Fjmoya-uba/Taller-de-Circuitos-Grupo-4/Checkpoint 3/Informe/Checkpoint3_Grupo5.pdf

Universidad de Buenos Aires

Facultad de Ingeniería
Año 2026 – 1.er Cuatrimestre

## Taller de Diseño de

## Circuitos Electrónicos

## Proyecto Integrador – Checkpoint 3

### Grupo 5

Lautaro García Vitale | 110028 lagarciav@fi.uba.ar
Santiago Manuel Cabrera | 110445 smcabrera@fi.uba.ar
Francisco Javier Moya | 109899 fjmoya@fi.uba.ar

Tutor: Federico Gabriel D’Angiolo.

Docentes: Julio Guillermo Zola, Marcelo Adrián Bruno, Sergio Quinteros y Juan Guido Salaya.

Resumen

El presente informe documenta el tercer checkpoint del proyecto integrador, correspondiente a la implementación física y validación experimental de una fuente lineal LDO de 5 V desarrollada para aplicaciones industriales y automotrices. En esta etapa se aborda la transición desde el diseño teórico y la simulación hacia un prototipo funcional montado sobre PCB.
En primer lugar, se describe el proceso de fabricación, armado y soldado de la placa, detallando la incorporación progresiva de los bloques de regulación de tensión y de corriente, así como las principales contingencias surgidas durante el montaje. Se analizan además diversas limitaciones asociadas al layout, al retrabajo manual y a la selección de componentes, las cuales condicionaron la puesta a punto inicial del circuito.
Posteriormente, se presentan las mediciones realizadas para caracterizar el comportamiento del regulador en condiciones reales de operación. Se estudian la regulación de línea, la regulación de carga en régimen estático y dinámico, la eficiencia, la corriente límite, la protección foldback y la respuesta temporal y espectral del lazo de tensión. Los resultados obtenidos muestran que el prototipo mantiene adecuadamente la tensión de salida, responde de manera estable frente a perturbaciones y reproduce en forma consistente los mecanismos de protección previstos en el diseño. Finalmente, se comparan los resultados experimentales con las predicciones obtenidas en etapas previas, identificando diferencias atribuibles a no idealidades de los componentes, efectos parásitos del montaje y restricciones dinámicas de la implementación física. En conjunto, el trabajo permite validar el desempeño global del regulador y extraer conclusiones útiles para futuras iteraciones de diseño y fabricación.

Proyecto Integrador – Checkpoint 3 | Grupo 5

## Índice

1. Introducción | 3
2. Armado del PCB | 3
3. Rediseño del lazo de corriente | 6
4. Mediciones | 7
5. Resumen de resultados | 15
6. Conclusiones | 15
7. Referencias | 16

## 1. Introducción

El desarrollo de una fuente de alimentación lineal para aplicaciones industriales y automotrices no finaliza con el diseño esquemático ni con la simulación del circuito. Una etapa fundamental del proceso consiste en implementar físicamente el sistema, verificar su correcto armado y caracterizar experimentalmente su comportamiento bajo distintas condiciones de operación.

En los checkpoints anteriores se definió la topología del regulador LDO, compuesta por un lazo de regulación de tensión, una etapa de potencia y un mecanismo de limitación de corriente con protección tipo foldback. Además, se analizaron aspectos asociados a la estabilidad del sistema, la compensación en frecuencia, la disipación térmica y el diseño del circuito impreso. Sobre esa base, en esta etapa se avanzó con el armado y soldado de la placa, obteniendo un prototipo físico apto para su ensayo en laboratorio.

El objetivo principal de este tercer checkpoint es validar experimentalmente el funcionamiento del regulador. Para ello, se realizaron mediciones de regulación de carga, tanto en régimen estático como dinámico, regulación de línea, limitación de corriente y eficiencia, entre otras. Estas pruebas permiten evaluar si la tensión de salida se mantiene dentro de los márgenes esperados frente a variaciones de carga y alimentación, y si el circuito de protección actúa correctamente ante condiciones de sobrecorriente.

La regulación de carga estática permite analizar la variación de la tensión de salida una vez alcanzado el régimen permanente para distintos valores de corriente demandada por la carga. En cambio, la regulación de carga dinámica estudia la respuesta transitoria de la fuente ante cambios bruscos de corriente, lo que resulta especialmente relevante en sistemas reales donde la carga puede variar rápidamente. Esta medición permite observar caídas instantáneas, sobrepicos, tiempos de recuperación y posibles oscilaciones.

A partir de los resultados obtenidos, se busca contrastar el comportamiento real del prototipo con el previsto durante el diseño. Las diferencias observadas pueden atribuirse a tolerancias de componentes, resistencias de pistas y contactos, efectos térmicos, capacidad de los elementos de salida y limitaciones del lazo de control. Por lo tanto, esta etapa no solo cumple una función de verificación, sino también de aprendizaje sobre la relación entre el diseño teórico y su implementación física.

## 2. Armado del PCB

Tras la validación del diseño en el checkpoint anterior, se procedió a la fabricación del PCB y al montaje de los componentes. El proceso se realizó de forma incremental para garantizar la trazabilidad de posibles fallas, aunque fueron surgiendo diversos problemas en el proceso de armado de la placa.

El montaje se estructuró en las siguientes etapas:

Soldado del par diferencial, del TL431 como referencia de tensión y del lazo de control de tensión.

Soldado del lazo de control de corriente.

### 2.1. Lazo de Tensión

Se soldaron inicialmente los componentes asociados al par diferencial, la referencia TL431 y la etapa de potencia. Se soldaron inicialmente los componentes asociados al par diferencial, la referencia TL431 y la etapa de potencia (ver Figura 1). Tras la energización del circuito, se comprobó el correcto funcionamiento del lazo de regulación de tensión, verificándose una regulación estable de la salida alrededor de 5 V. Esto permitió corroborar experimentalmente las predicciones obtenidas durante el diseño y las simulaciones, validando el comportamiento del lazo de control y de la etapa de potencia en la implementación física.


Figura 1: Soldado correspondiente al lazo de tensión durante el proceso de montaje del PCB.

### 2.2. Lazo de Corriente

Una vez verificado el correcto funcionamiento del lazo de regulación de tensión, se integró el amplificador operacional LM358 junto con la red de sensado correspondiente a la protección foldback. Durante esta etapa se realizaron verificaciones funcionales sobre el lazo de corriente y el comportamiento general del sistema ante distintas condiciones de carga. En la Figura 2 se observa el resultado de la placa con todos los componentes soldados.


Figura 2: Soldado correspondiente al lazo de corriente durante el proceso de montaje del PCB.

### 2.3. Contingencias de montaje

Durante la implementación física, se identificaron inconvenientes de montaje y de layout que condicionaron el proceso de armado y la depuración inicial del prototipo:

Subdimensionamiento de pistas: El ancho de varias pistas de señal resultó demasiado pequeño para un prototipo sometido a múltiples instancias de soldado y retrabajo manual. Esto redujo la superficie efectiva de cobre disponible, dificultó las tareas de montaje y aumentó la fragilidad mecánica de distintos nodos del circuito.

Desprendimiento de pads y deterioro del cobre: La manipulación reiterada de la placa durante el proceso de depuración provocó el levantamiento de varias pistas y pads, particularmente en zonas sometidas a retrabajo térmico frecuente. En algunos casos, ciertos terminales quedaron prácticamente sin superficie de cobre utilizable, dificultando significativamente la restauración de conexiones confiables. Para recuperar la continuidad eléctrica, fue necesario implementar puentes mediante conductores externos soldados directamente a los terminales de los componentes.

Falsos contactos durante la depuración: La presencia de pistas debilitadas y conexiones mecánicamente inestables generó comportamientos erráticos durante las primeras pruebas del sistema. Si bien se realizaron verificaciones sistemáticas de continuidad, la reducida dimensión de algunas pistas dificultó la detección inmediata de falsos contactos y conexiones intermitentes.

Estas dificultades evidenciaron que, para futuras iteraciones del PCB, resulta conveniente adoptar criterios de diseño más conservadores, incrementando el ancho de pista y el tamaño de los pads para mejorar la robustez mecánica del montaje y facilitar las tareas de validación experimental y depuración.

## 3. Rediseño del lazo de corriente

Las primeras mediciones experimentales mostraron que el lazo de corriente interfería con el funcionamiento normal del regulador incluso en condiciones donde la protección foldback debía permanecer inactiva. En particular, se observó que la tensión de salida no lograba regular en el valor esperado, aun cuando el lazo de tensión operaba correctamente de manera aislada.

A partir de estas observaciones, se decidió analizar el problema en una sección específica, ya que el comportamiento detectado no se debía únicamente a inconvenientes de montaje, sino también a limitaciones asociadas al diseño implementado para el lazo de corriente y a su interacción con la etapa de potencia.

### 3.1. Problema detectado experimentalmente

Durante los primeros ensayos se observó que el lazo de corriente interfería con el funcionamiento normal del regulador, aun en condiciones donde la protección foldback debía permanecer inactiva. En particular, la tensión de salida quedaba limitada a aproximadamente 2.4 V. Luego de varios experimentos, se detectó que la salida del amplificador operacional que activa el lazo de corriente era de 650 mV a pesar de que no hubiera carga, con lo cual el transistor de drenaje retiraba corriente de la base del quasidarlington.

Repasando la hoja de datos del integrado se econtró la siguiente tabla.

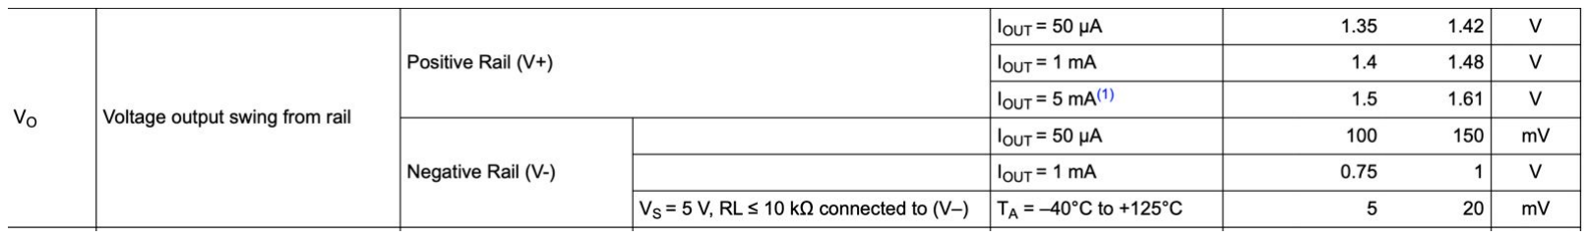
[picture p55: figure]

Figura 3: Especificaciones de la salida del operacional

En la misma, puede leerse que para una corriente de salida de 1 mA la mínima tensión de salida posible es entre 0.75 V y 1 V mayor a la tensión del riel negativo. En este circuito, el riel negativo es 0 V, por lo que este dato explica por qué el operacional polarizaba al transistor de drenaje de forma incorrecta. De esta forma, el error en el diseño original fue no incluir resistores entre la salida del amplificador y la base del TBJ que limitaran la corriente de salida del primero.

Por último, se simuló la etapa del operacional aislada del resto del circuito, y se encontró que la salida del mismo rondaba los 4 V. De esta forma, es el TBJ el que fuerza a que la salida sea de 0.65 V, lo que supone una demanda demasiado grande para el operacional.

### 3.2. Modificación implementada

Con el objetivo de estabilizar el estado de corte del transistor y reducir la carga impuesta sobre la salida del LM358, se incorporó una resistencia de 1 kΩ entre la base del transistor de foldback y masa. Este resistor actúa como un resistor de pull-down, disminuyendo la tensión del nodo y dándole a la corriente un camino adicional para llegar a masa.

Cabe mencionar que en el futuro se incluirá también un resistor de 3.9 kΩ para formar un divisor resistivo con el resistor ya mencionado y permitir así que la tensión de salida del operacional no sea forzada a 0.65 V. Sin embargo, en las mediciones hechas en este informe no se la pudo incluir por falta de tiempo.

### 3.3. Validación posterior al cambio

Una vez incorporada la modificación, se repitieron las mediciones relevantes para verificar el comportamiento del lazo de corriente bajo distintas condiciones de carga. A diferencia de las primeras pruebas, el circuito pasó a exhibir una respuesta consistente con la prevista durante el diseño, observándose un funcionamiento estable tanto del lazo de tensión como de la protección foldback.

La incorporación de la resistencia de pull-down permitió evitar activaciones espurias del transistor asociado al lazo de corriente y redujo la carga impuesta sobre la salida del LM358. De esta manera, la validación experimental posterior confirmó que el comportamiento anómalo observado inicialmente estaba asociado principalmente al criterio de conexión adoptado en el diseño original y no únicamente a problemas de montaje.

## 4. Mediciones

En esta sección se detallan las mediciones efectuadas. En las Figuras 4 y 5 se muestran los bancos de trabajo utilizados para realizar los ensayos experimentales.

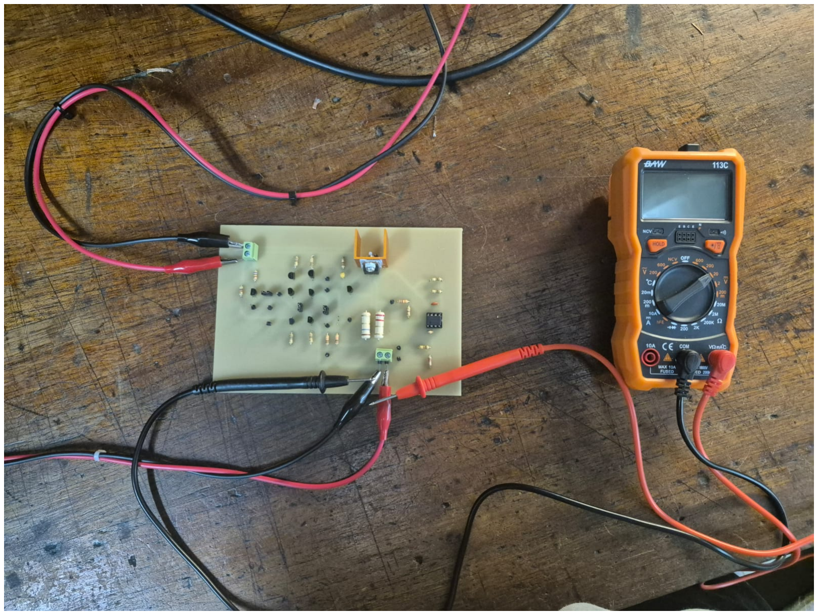
[picture p56: figure]

Figura 4: Primer banco de medición utilizado durante la validación experimental del regulador.


Figura 5: Segundo banco de medición utilizado durante la validación experimental del regulador con carga electrónica.

### 4.1. Eficiencia

Para una tensión de entrada de 9,5 V, una corriente de entrada de 182 mA, una tensión de salida de 5,01 V y una corriente de salida de 167 mA, dada por una carga estática de 30 Ω, se registró una eficiencia del 48,39 %. Este cálculo se hizo teniendo en cuenta las potencias de entrada y salida, como se muestra a continuación.

η =

Po
Pi

=

VoIo
ViIi

= 48, 39 %

De este modo, se puede observar que la eficiencia conseguida depende de la corriente de salida (a tensión de salida constante) y de la tensión de entrada. En las Figuras 6 y 7 se muestra la eficiencia en función de la tensión de entrada a una corriente de salida constante de 1 A y en función de la corriente de salida a una tensión de entrada constante de 9,5 V, respectivamente.


Figura 6: Eficiencia del circuito en función de la tensión de entrada para una corriente de salida de 1 A.


Figura 7: Eficiencia del circuito en función de la corriente de salida para una tensión de entrada de 9,5 V.

### 4.2. Regulación de línea

La regulación de línea se obtuvo midiendo con una carga estática de 50 Ω que fija una corriente de salida de 100 mA y variando la tensión regulada que ingresa al LDO. El resultado fue 11,86 mV/V: un 41,02 % mayor que el valor teórico —probablemente atribuido a la escasez de mediciones—. La curva resultante de la medición se muestra en la Figura 8.


Figura 8: Regulación de línea medida y simulada.

Nótese que V

min
REG
Vo=5 V

= 6 V, por lo que se obtiene una tensión de dropout de

Vdrop = V

min
REG
Vo=5 V

− Vo = 1 V,

valor que coincide exactamente con el teórico.

### 4.3. Regulación de carga

En esta sección se detallan las mediciones correspondientes a la regulación de carga.

### 4.3.1. Estática

En la Figura 9 se muestra la tensión de salida en función de la resistencia de carga. Allí se observa que el rango de operación del lazo de tensión efectivamente es para cargas mayores a 3,33 Ω.

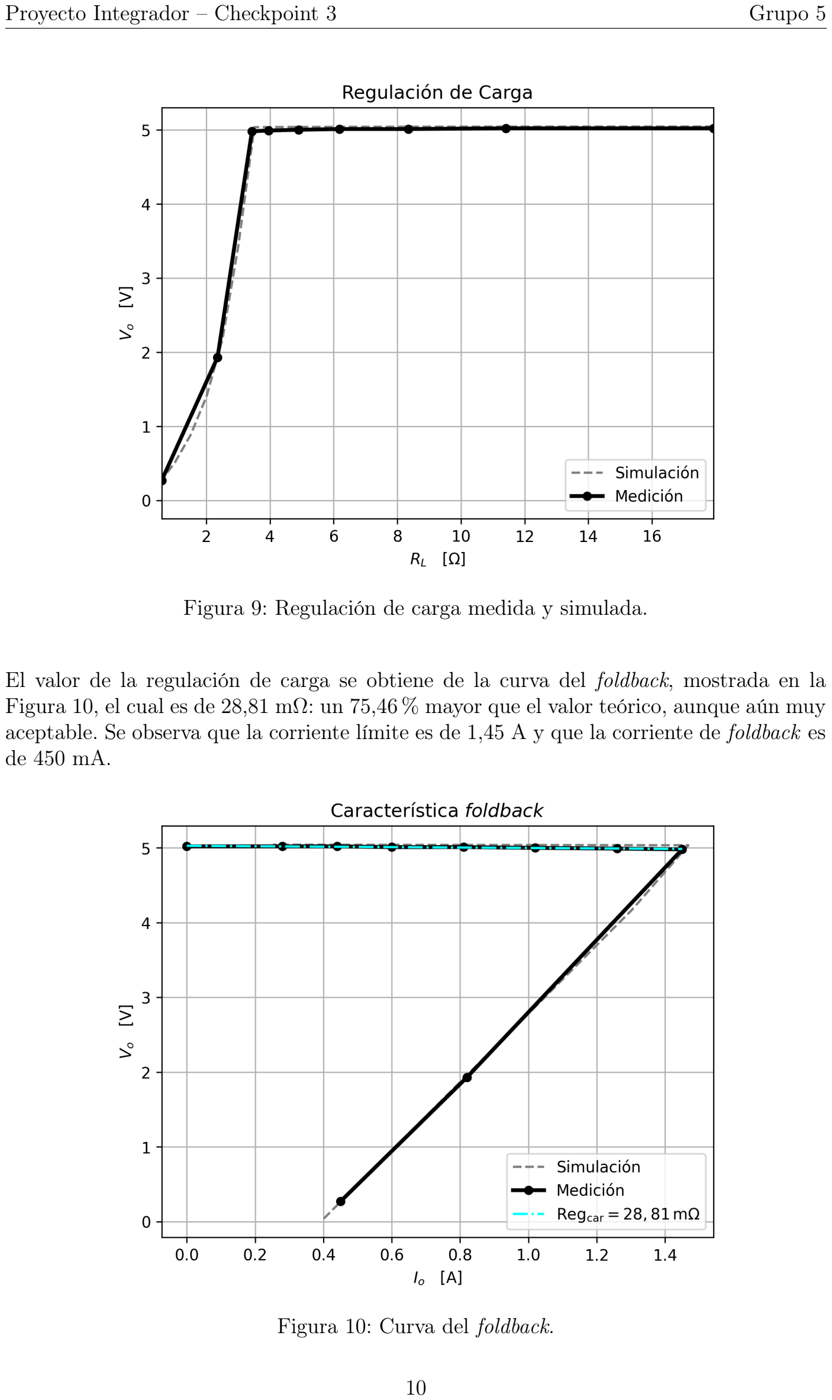
[picture p57: page 10]

Figura 9: Regulación de carga medida y simulada.

El valor de la regulación de carga se obtiene de la curva del foldback, mostrada en la Figura 10, el cual es de 28,81 mΩ: un 75,46 % mayor que el valor teórico, aunque aún muy aceptable. Se observa que la corriente límite es de 1,45 A y que la corriente de foldback es de 450 mA.

Figura 10: Curva del foldback.

### 4.3.2. Dinámica

La regulación de carga dinámica evalúa la capacidad del regulador para mantener estable la tensión de salida frente a variaciones rápidas de corriente demandada por la carga. Esta medición permite analizar la respuesta transitoria del sistema y verificar experimentalmente el comportamiento dinámico del lazo de control.

Para realizar el ensayo, se implementó una carga dinámica con un transistor MOSFET, modelo IRFZ46N. Sobre su compuerta se aplicó una señal cuadrada proveniente de un generador de funciones. Además, se conectó una resistencia de 33 Ω al terminal source, mientras que el terminal drain se vinculó a la salida del regulador. De esta manera, la señal aplicada al MOSFET permitía conectar y desconectar periódicamente la carga, generando escalones de corriente sobre la salida del regulador. La respuesta temporal de la tensión de salida se observó mediante osciloscopio, analizando el comportamiento transitorio del sistema frente a dichas perturbaciones dinámicas. Con el banco de medición de la Figura 11 se obtuvo la respuesta mostrada en la Figura 12.


Figura 11: Banco de medición para la regulación de carga dinámica


Figura 12: Regulación de carga dinámica

### 4.4. Respuestas a señales cuadradas

### 4.4.1. Lazo de tensión

Con el objetivo de validar experimentalmente la compensación implementada durante la etapa de diseño, se evaluó la respuesta temporal del lazo de tensión frente a una perturbación aplicada sobre la referencia del regulador.

Para ello, se superpuso una señal de aproximadamente 50 mVpp sobre la tensión de referencia, observándose la evolución temporal de la tensión de salida mediante osciloscopio. Con el objetivo de visualizar únicamente la respuesta dinámica del regulador frente a la perturbación introducida, las mediciones se realizaron utilizando acoplamiento AC en el osciloscopio, desacoplando así la componente continua de la salida.

Esta medición permitió analizar la capacidad del lazo para regular frente a pequeñas perturbaciones y verificar experimentalmente la estabilidad prevista durante las simulaciones.

Como se puede observar en la Figura 13, las mediciones obtenidas mostraron una respuesta estable, sin evidencia de oscilaciones sostenidas ni comportamientos inestables, validando así la estrategia de compensación adoptada para el lazo de tensión.


Figura 13: Respuesta del lazo de tensión a un escalón de 50 mVpp con la continua desacoplada.

### 4.4.2. Validación experimental de la respuesta en frecuencia

A partir de la compensación realizada durante el checkpoint 2, se obtuvo para el lazo de tensión una frecuencia de corte aproximada de 100 Hz. Con el objetivo de validar experimentalmente este comportamiento dinámico, se realizaron ensayos temporales y espectrales sobre la respuesta del regulador.

Para ello, se inyectó mediante un generador de funciones una señal cuadrada sobre la entrada no inversora correspondiente a la referencia del regulador. La señal aplicada tuvo una amplitud comprendida entre 0 y 2.5 V y una frecuencia de 10 Hz.

La elección de esta frecuencia se realizó considerando que una señal cuadrada puede representarse como una suma de armónicos impares. Dado que el ancho de banda estimado del lazo era cercano a 100 Hz, se esperaba que los primeros armónicos de la señal aplicada atravesaran el sistema con escasa atenuación, reproduciendo adecuadamente la forma temporal de la onda a la salida.

Las Figuras 14 y 15 muestran respectivamente la señal aplicada y la respuesta observada a la salida del regulador. Experimentalmente se verificó que la forma de onda de salida reproduce correctamente la excitación aplicada.

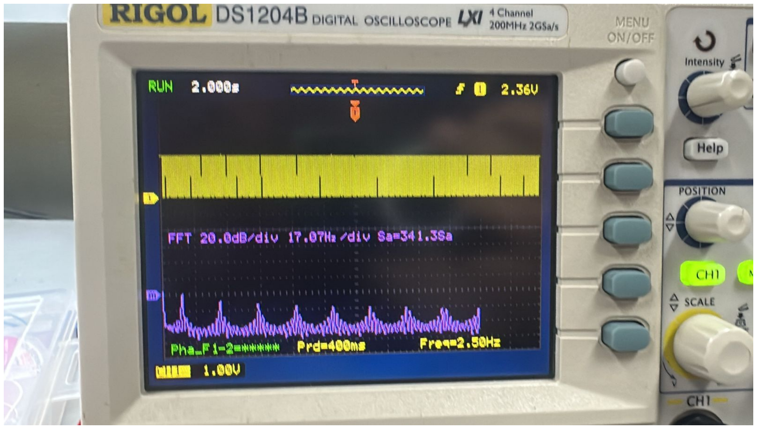
[picture p58: figure]

Figura 14: Respuesta en tiempo y en frecuencia de una señal de entrada cuadrada de 10 Hz en lugar de Vref.


Figura 15: Respuesta en tiempo y en frecuencia de la señal de salida con una cuadrada de 10 Hz aplicada en la entrada en lugar de Vref.

Mediante la herramienta FFT del osciloscopio se observó que tanto en la entrada como en la salida se conservaban aproximadamente los primeros nueve armónicos de la señal, en concordancia con el comportamiento esperado para un sistema cuyo ancho de banda supera ampliamente la frecuencia fundamental utilizada en el ensayo.

Posteriormente, se repitió el ensayo utilizando una señal cuadrada de 100 Hz, frecuencia cercana al ancho de banda simulado para el lazo de tensión compensado durante el diseño.

A diferencia del caso anterior, la señal observada a la salida presentó una deformación apreciable respecto de la excitación original (esto se observa en las figuras 16 y 17). El análisis espectral mediante FFT mostró además la aparición de armónicos pares, inexistentes en la señal cuadrada ideal aplicada a la entrada.

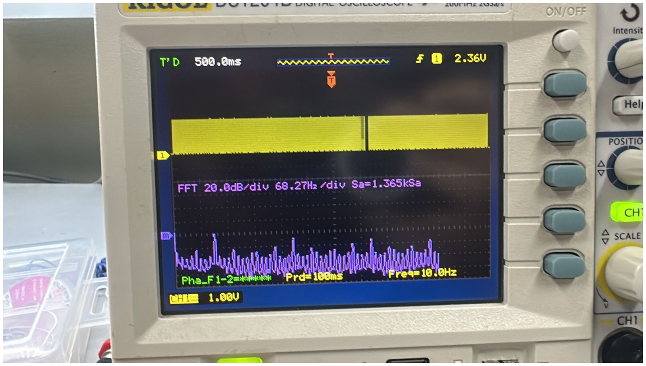
[picture p59: figure]

Figura 16: Respuesta temporal y espectral de la señal cuadrada aplicada sobre la referencia del regulador para una frecuencia de 100 Hz.


Figura 17: Respuesta temporal y espectral de la salida del regulador ante una excitación cuadrada de 100 Hz aplicada sobre la referencia.

La presencia de estos componentes indica que el sistema comenzó a apartarse del comportamiento lineal ideal previsto para pequeñas señales. Este efecto puede atribuirse a limitaciones dinámicas del circuito al operar cerca de su frecuencia de corte, donde fenómenos asociados al ancho de banda finito del lazo, capacitancias internas, velocidad de respuesta del amplificador y no idealidades de la etapa de potencia comienzan a tener una influencia significativa sobre la forma de onda.

Como consecuencia, la reproducción de los armónicos deja de ser ideal y la señal de salida adquiere una forma más redondeada y distorsionada respecto de la cuadrada original.

## 5. Resumen de resultados

En la Tabla 1 se muestra un resumen de las mediciones efectuadas con sus resultados.

Característica | Símbolo | Condiciones de prueba | Mín. | Típ. | Máx. Unidad
Tensión de salida | Vo | 0, 1 A ≤ Io ≤ 1, 5 A; VREG = 9, 5 V | 4,99 | 5,00 | 5,01 | V
Eficiencia | η | Io = 167 mA; VREG = 9, 5 V | - | 48,39 | - | %
Regulación de línea | Reglín | 0, 25 V ≤ VREG ≤ 9, 7 V; Io = 0, 1 A | - | 11,86 | - | mV/V
Regulación de carga | Regcar | 0 A ≤ Io ≤ 1, 45 A | - | 28,81 | - | mΩ
Corriente límite | ILÍM | - | - | 1,45 | - | A
Corriente de foldback | IFBK | Vo = 0 V | - | 450 | - | mA

Tabla 1: Resumen de resultados.

## 6. Conclusiones

A partir de las mediciones realizadas se concluye que el regulador implementado cumple satisfactoriamente con los objetivos principales de diseño, ya que mantiene una tensión de salida cercana al valor nominal, presenta una regulación de línea y de carga consistente con lo esperado y activa correctamente los mecanismos de limitación de corriente y protección foldback. Al mismo tiempo, los ensayos dinámicos y de respuesta en frecuencia permitieron verificar que el lazo de tensión posee un comportamiento estable, aunque también pusieron en evidencia las limitaciones reales del prototipo al operar cerca del ancho de banda previsto. En conjunto, estos resultados validan la arquitectura adoptada y muestran que las diferencias observadas respecto de la simulación responden a no idealidades propias de los componentes y de la implementación física.

En cuanto a la impresión y el armado del PCB se concluye que es conveniente hacer pistas y pads más anchos. Esto no solo simplifica la soldadura, sino que también hace más robusto al circuito y evita problemas como los cortocircuitos y los falsos contactos.

Como resultado importante de este checkpoint se concluye que para futuros diseños deben tenerse en cuenta las específicaciones de los componentes usados, especialmente en lo relativo a sus tensiones y corrientes de salida. También se tendrá en cuenta que los modelos Spice de los mismos muchas veces son simplificados o incompletos.

## 7. Referencias

[1] P. R. Gray, P. J. Hurst, S. H. Lewis y R. G. Meyer, Analysis and Design of Analog Integrated Circuits. Hoboken, NJ: Wiley, 5ta ed., 2009.
[2] STMicroelectronics, “TIP32C: Power transistor.”, 2006.
[3] Texas Instruments, “TL431, TL432: Precision Programmable Reference.”, 2025.
[4] ON Semiconductor, “BC556B, BC557A, B, C, BC558B: Amplifier transistors (PNP Silicon).”, 2007.
[5] Fairchild Semiconductor, “BC547, BC547A, BC547B, BC547C: NPN General Purpose Amplifier.”, 1997.
[6] Semiconductores y Componentes, “Disipadores.”, s.f.
[7] Texas Instruments, “How to Properly Configure Unused Operational Amplifiers.”, SBOA204A, rev. Sept. 2018.
[8] Texas Instruments, “LM158, LM258, LM2904, LM358: Industry-Standard Dual Operational Amplifiers.”, SLOS068AB, rev. Oct. 2024.
