Fjmoya-uba/Taller-de-Circuitos-Grupo-4/Teóricas/Fuentes de alimentación lineales -1ra parte 2025_Version 1_compressed.pdf

# Fuentes de alimentación lineales Primera Parte

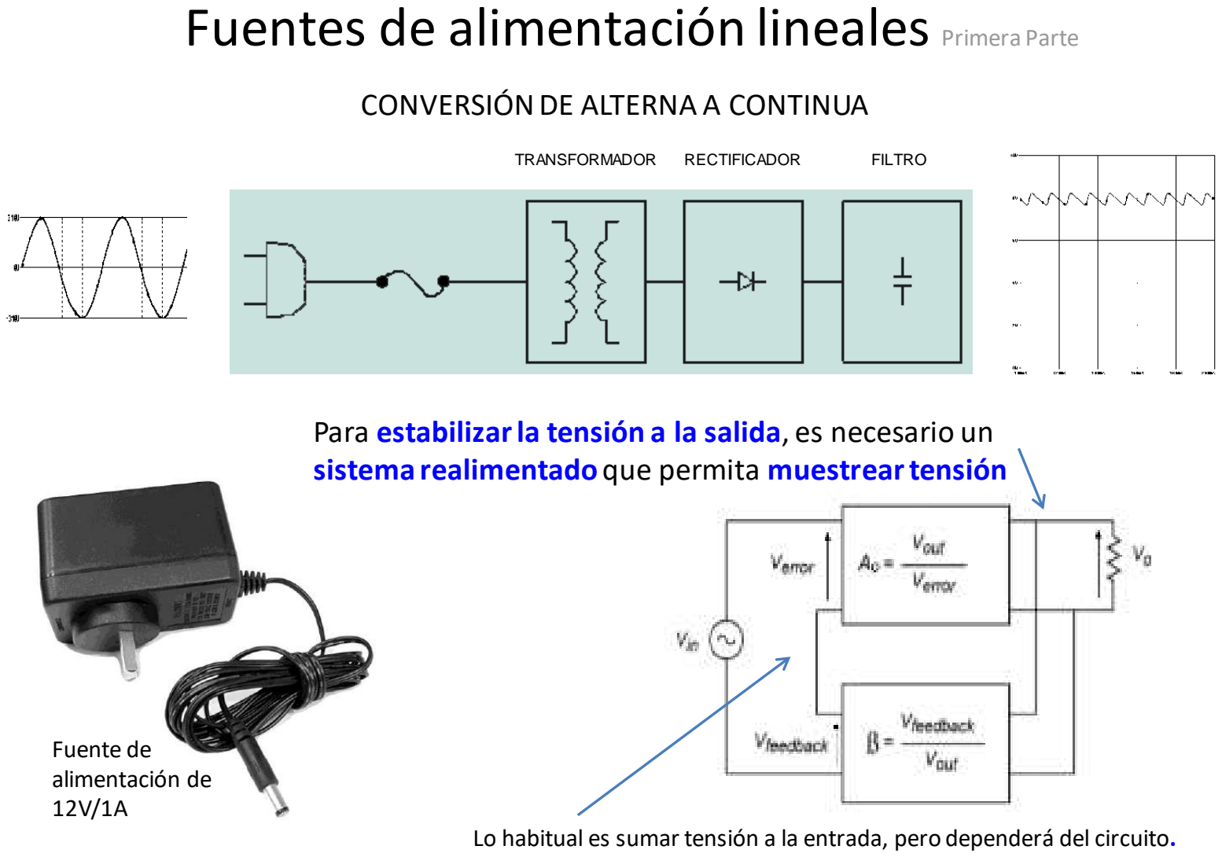
[picture p85: page 1]

TRANSFORMADOR | RECTIFICADOR | FILTRO

CONVERSIÓN DE ALTERNA A CONTINUA

Fuente de
alimentación de
12V/1A

Para estabilizar la tensión a la salida, es necesario un sistema realimentado que permita muestrear tensión

Lo habitual es sumar tensión a la entrada, pero dependerá del circuito.

REGULADOR

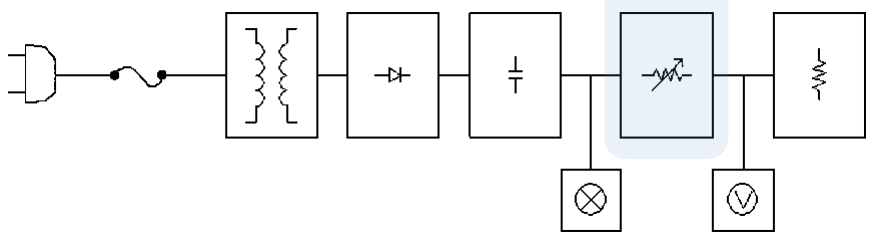
[picture p86: figure]

INDICADOR
DE NIVEL DE
TENSION DE
SALIDA

INDICADOR
DE
ENCENDIDO

## ESTABILIZACIÓN DE LA TENSIÓN

## Regulador de tensión básico

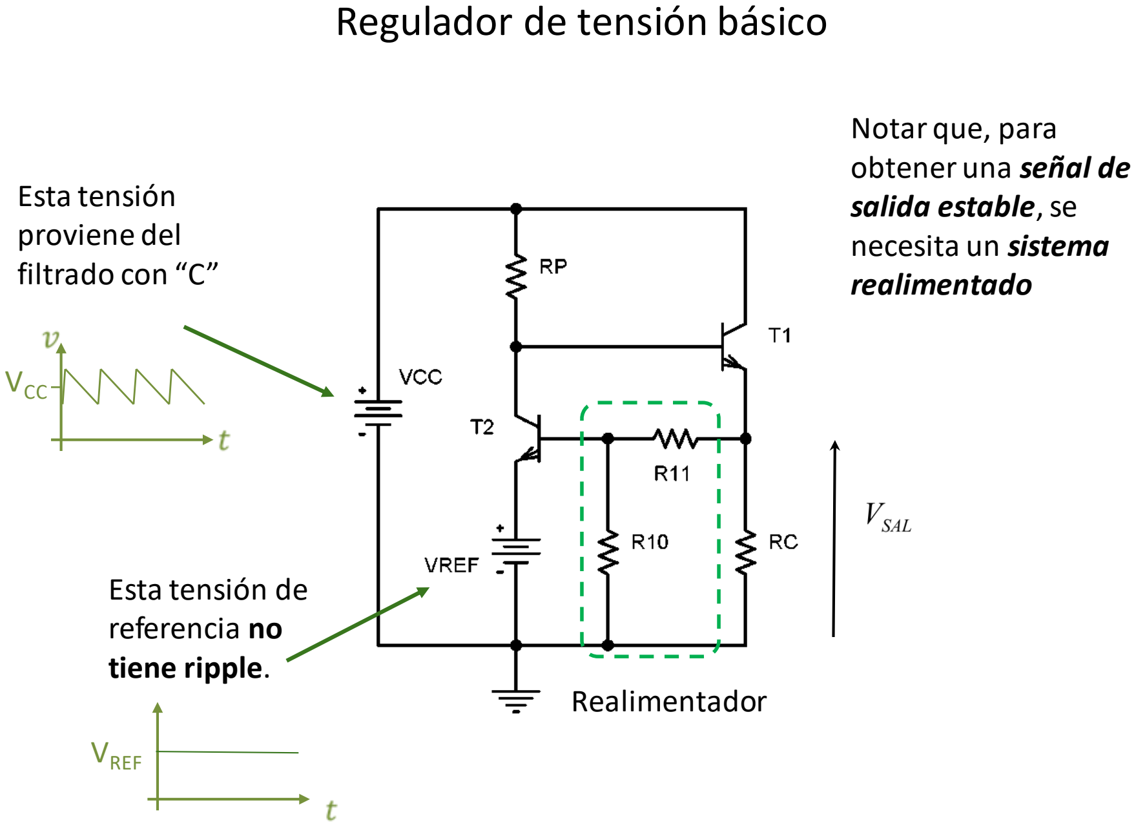
[picture p87: page 3]

Esta tensión
proviene del
filtrado con “C”

VCC

Esta tensión de
referencia no
tiene ripple.
Realimentador

Notar que, para
obtener una señal de
salida estable, se
necesita un sistema
realimentado

VREF

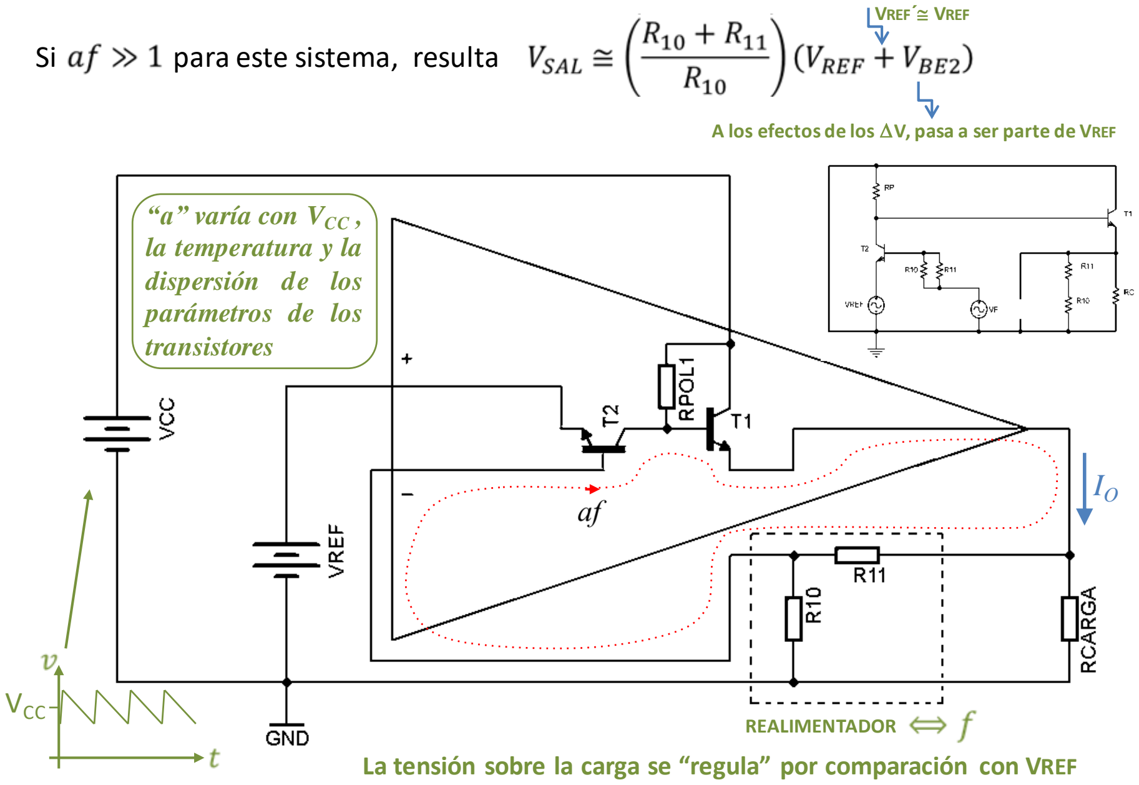
[picture p88: page 4]

La tensión sobre la carga se “regula” por comparación con VREF

Si | para este sistema, resulta

VCC
REALIMENTADOR

IO

A los efectos de los ΔV, pasa a ser parte de VREF

VREF´≅ VREF

“a” varía con VCC ,
la temperatura y la
dispersión de los
parámetros de los
transistores

Para evaluar el grado de estabilización de la tensión de salida debemos evaluar la Ganancia de Lazo “ T = af ”

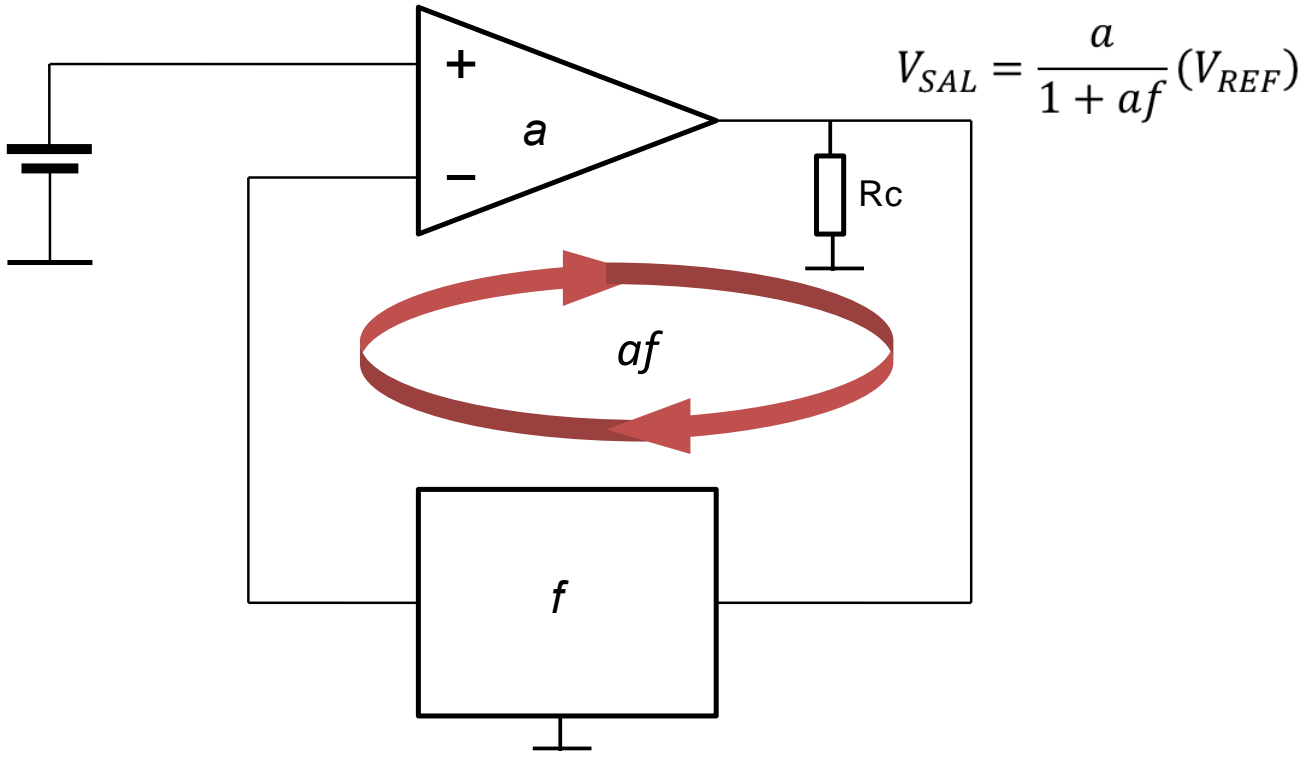
[picture p89: figure]

Se puede calcular o medir con el siguiente esquema:

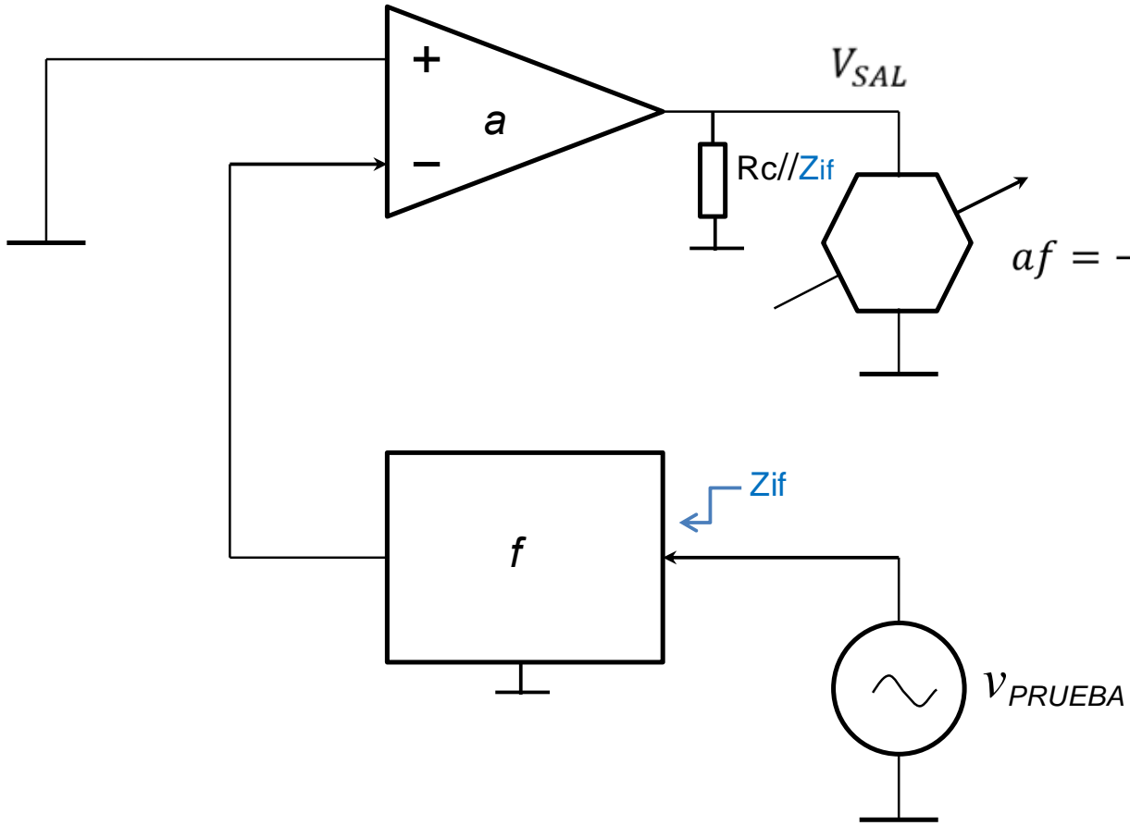
[picture p90: figure]
vPRUEBA; Rc//Zif; Zif

Considerando valores numéricos:

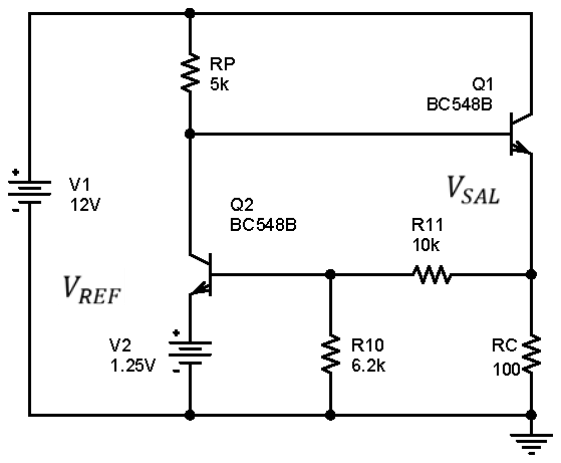
[picture p91: figure]

de hoja de datos,
para ICQ2 = 1mA

Hasta aquí se estudió cómo estabilizar la tensión de salida mediante un regulador de tensión utilizando la teoría de Realimentación.

En base a esto, a continuación se verá cómo realizar mediciones sobre los reguladores para obtenersus características.

Los parámetros a tener en cuenta:

1) Regulación de línea.
1) Regulación de carga.

## Parámetros de los reguladores

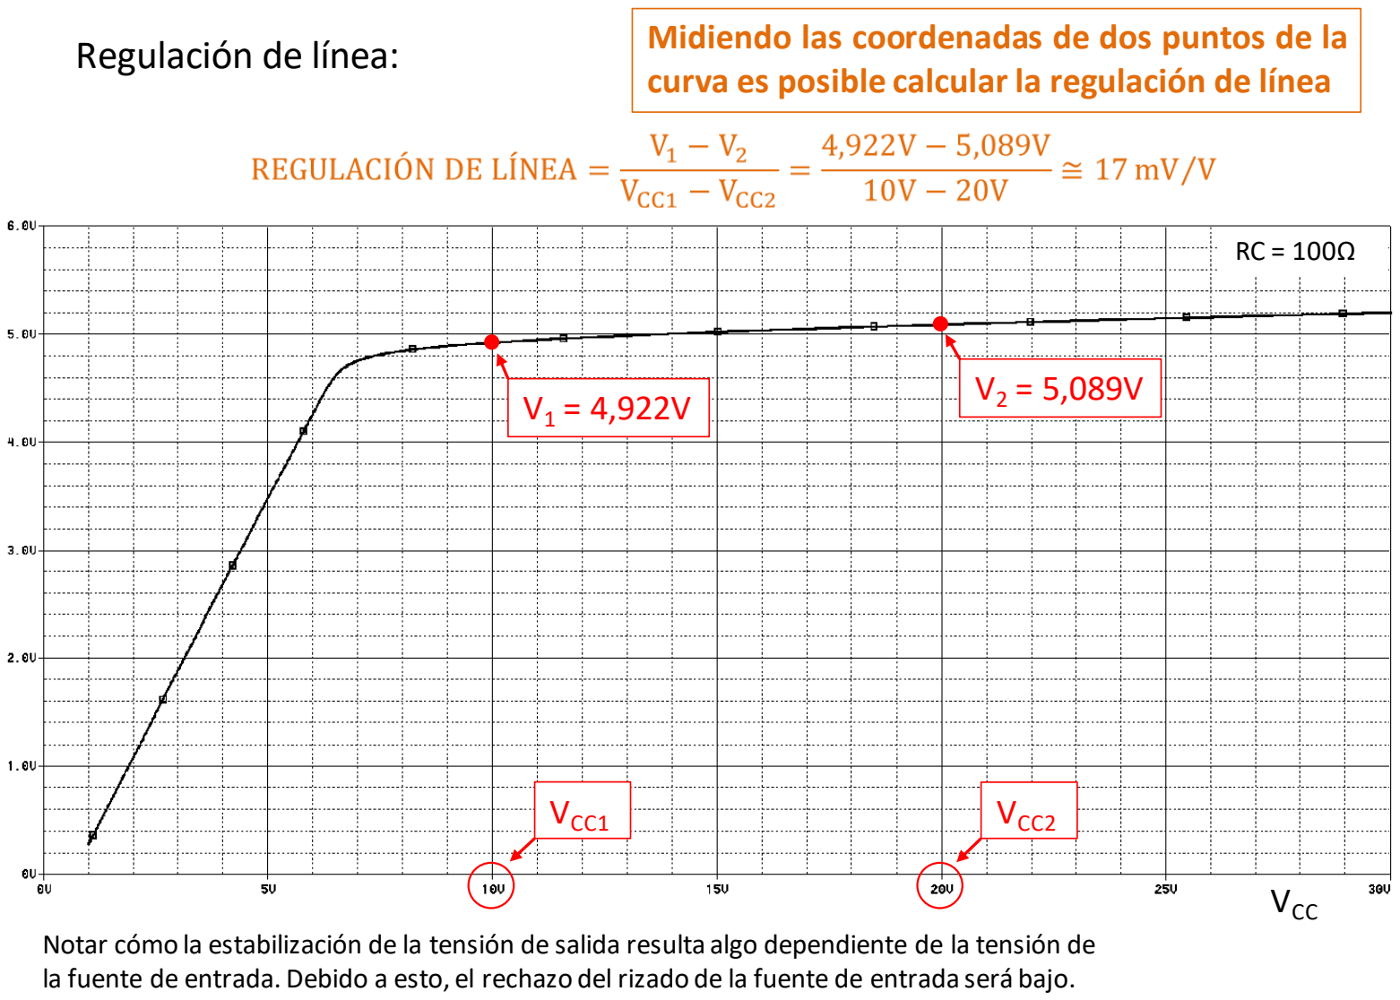
[picture p92: page 9]

Regulación de línea:

RC = 100Ω

Midiendo las coordenadas de dos puntos de la curva es posible calcular la regulación de línea

V1 = 4,922V

VCC1

V2 = 5,089V

VCC2

VCC
Notar cómo la estabilización de la tensión de salida resulta algo dependiente de la tensión de la fuente de entrada. Debido a esto, el rechazo del rizado de la fuente de entrada será bajo.

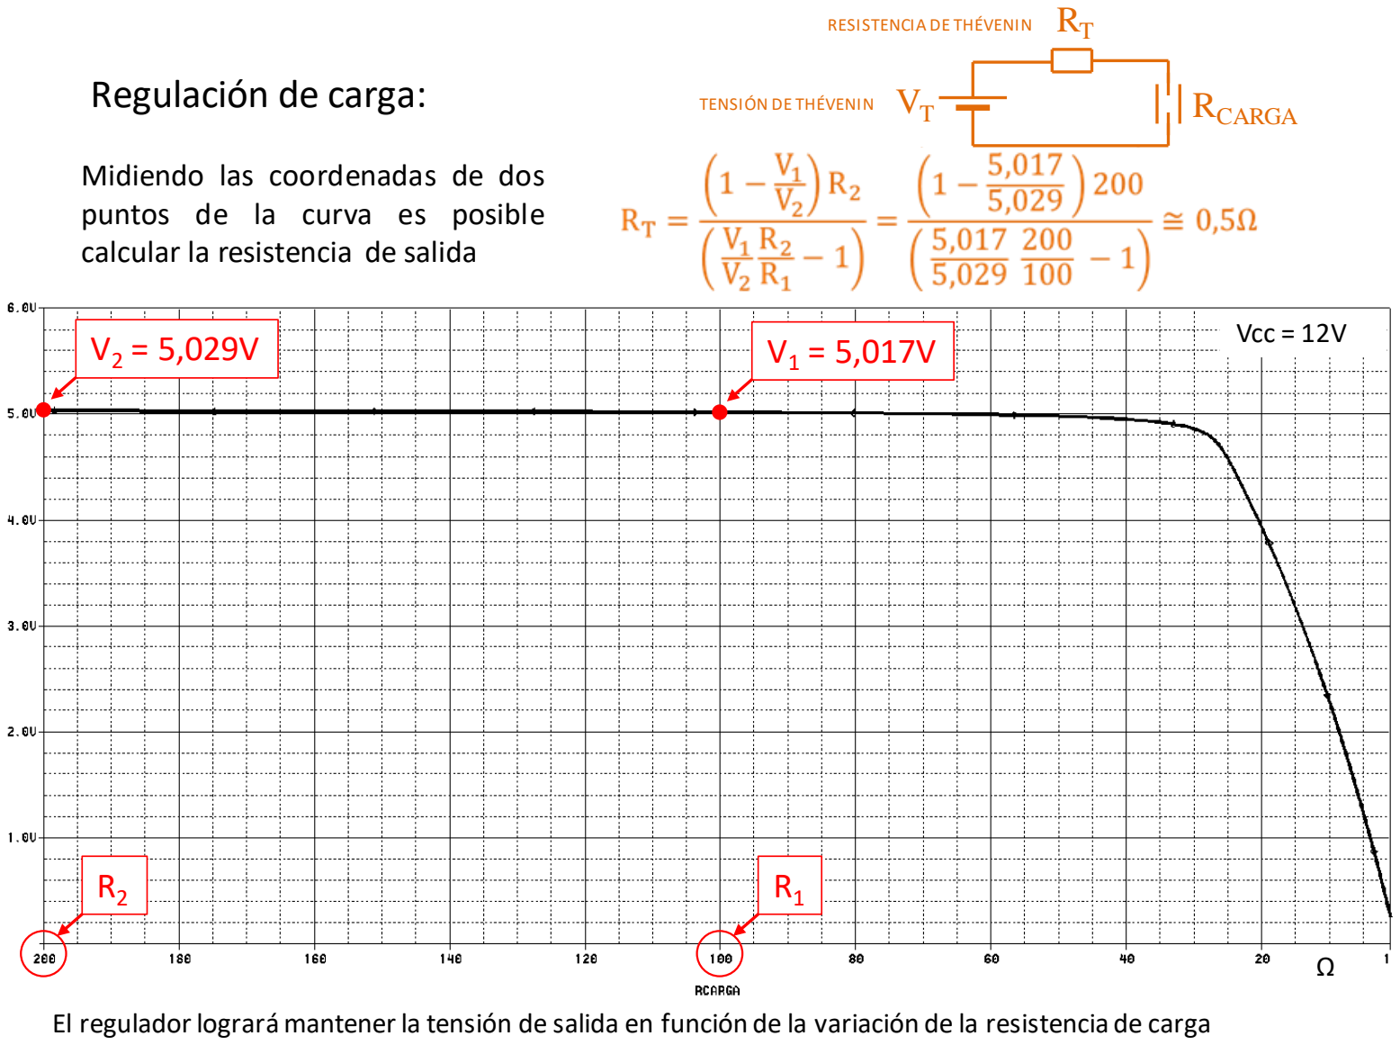
[picture p93: page 10]

Regulación de carga:

Midiendo las coordenadas de dos puntos de la curva es posible
calcular la resistencia de salida

Vcc = 12V
V2 = 5,029V | V1 = 5,017V
R2 | R1

RT

VT
TENSIÓN DE THÉVENIN

RESISTENCIA DE THÉVENIN

RCARGA

Ω

El regulador logrará mantener la tensión de salida en función de la variación de la resistencia de carga

Regulación de carga (cálculo dinámico)

El regulador logrará mantener la tensión de salida con una variación acotada en función de la variación de la corriente en la carga.

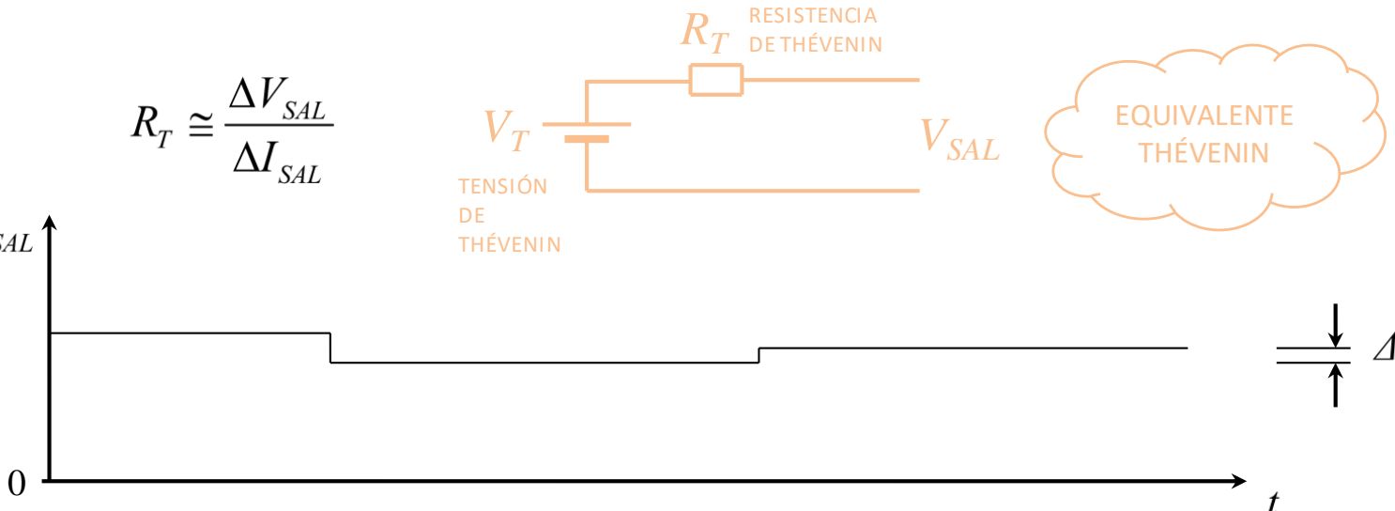
[picture p94: figure]
EQUIVALENTE VSAL; THÉVENIN; TENSIÓN DE THÉVENIN; RESISTENCIA DE THÉVENIN

0

## Regulador de tensión básico modificado

Modificando el circuito de entrada y de salida se obtiene mejor rechazo de modo común del amplificador y mayor ganancia de lazo del sistema

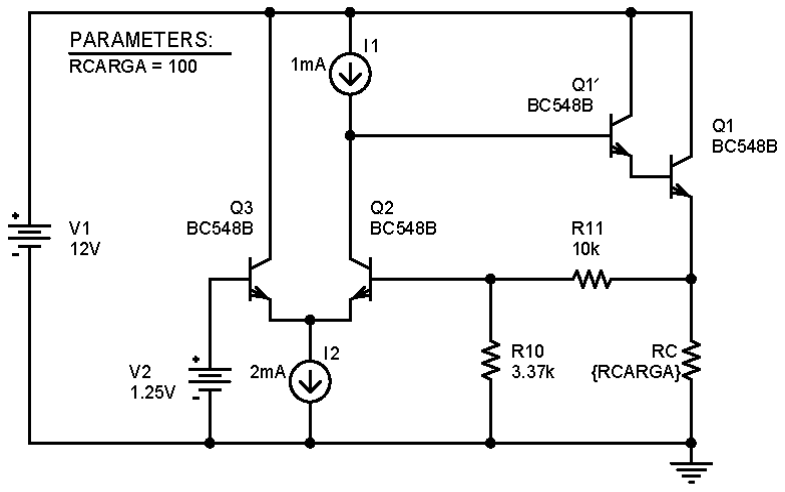
[picture p95: figure]

## Regulador de tensión básico modificado

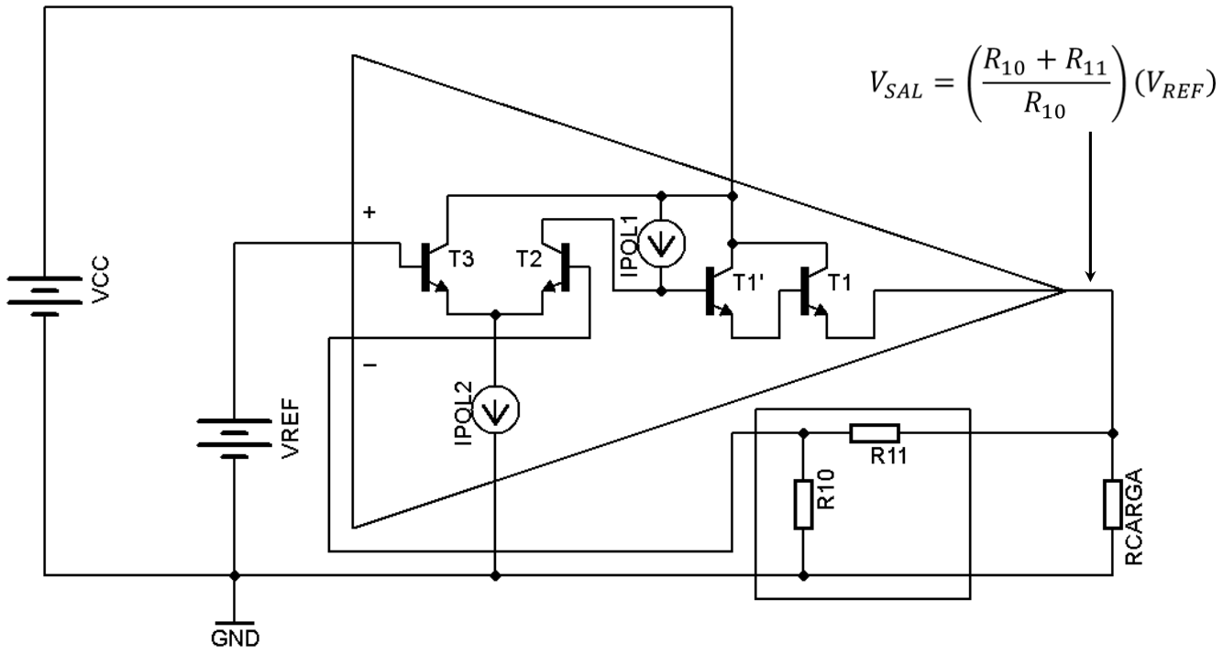
[picture p96: figure]
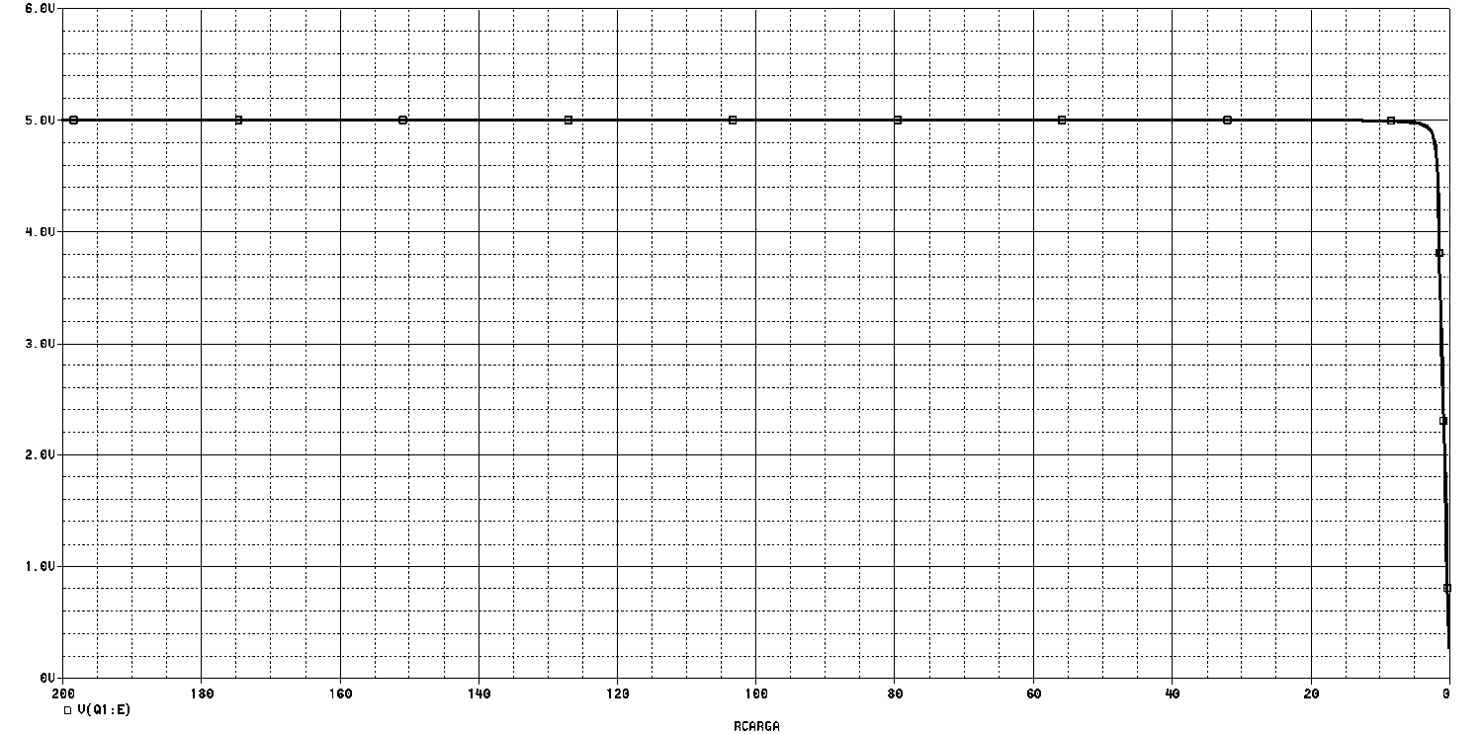
[picture p97: page 14]

Regulación de carga:

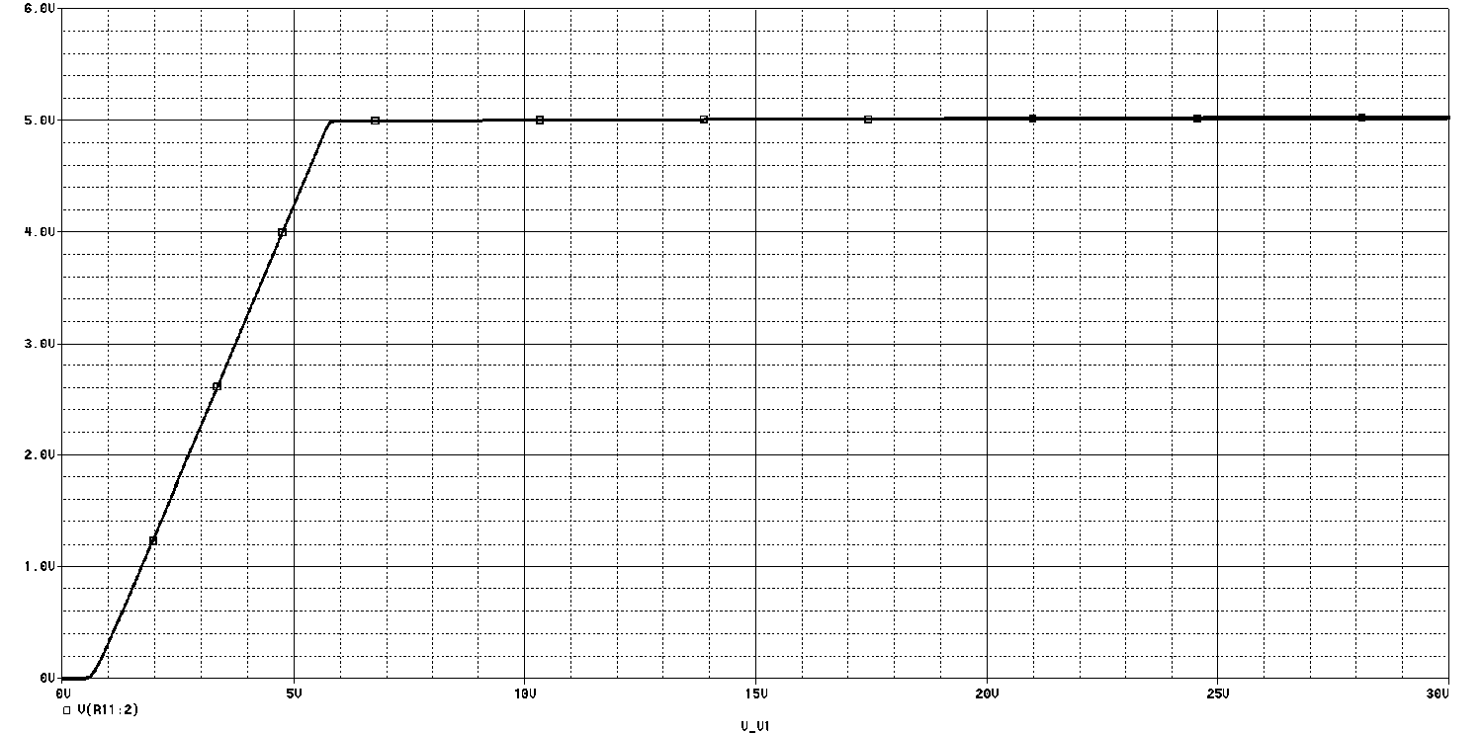
[picture p98: page 15]

Regulación de línea:

Tensión de referencia variable

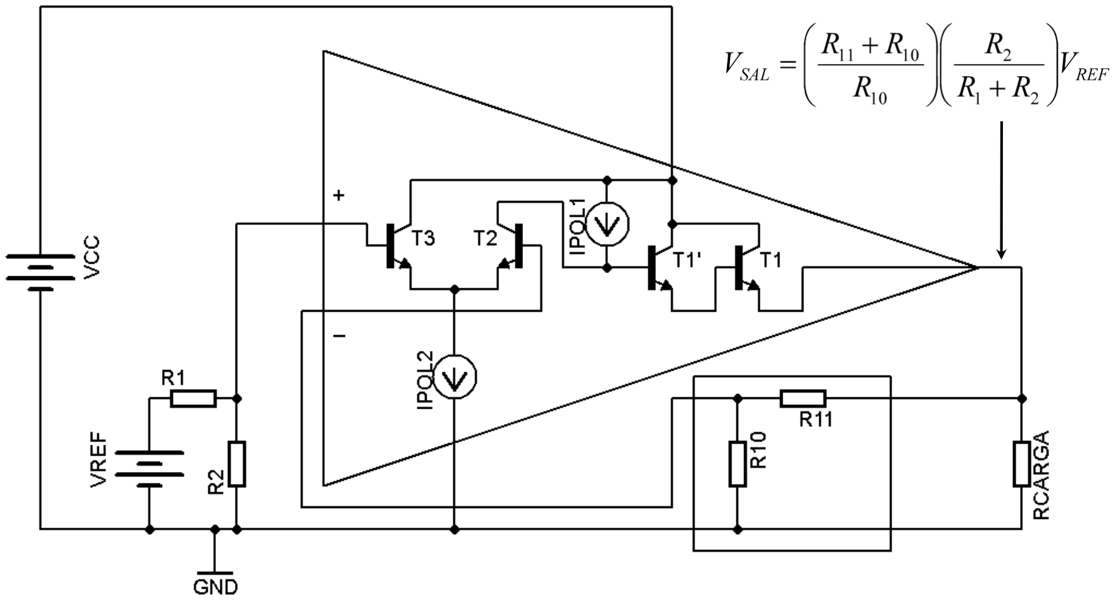
[picture p99: figure]

Circuitos limitadores

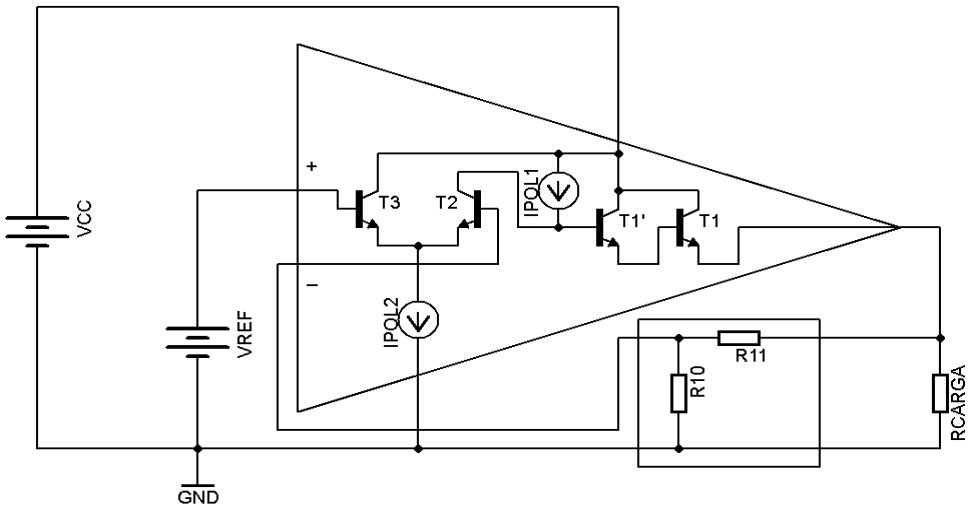
[picture p100: figure]

En el circuito anterior, se puede estabilizar la tensión de salida teniendo en cuenta la tensión de referencia y la realimentación.

Sin embargo, ¿qué sucede con la corriente si disminuye el valor de la resistencia de carga?

Limitación de corriente

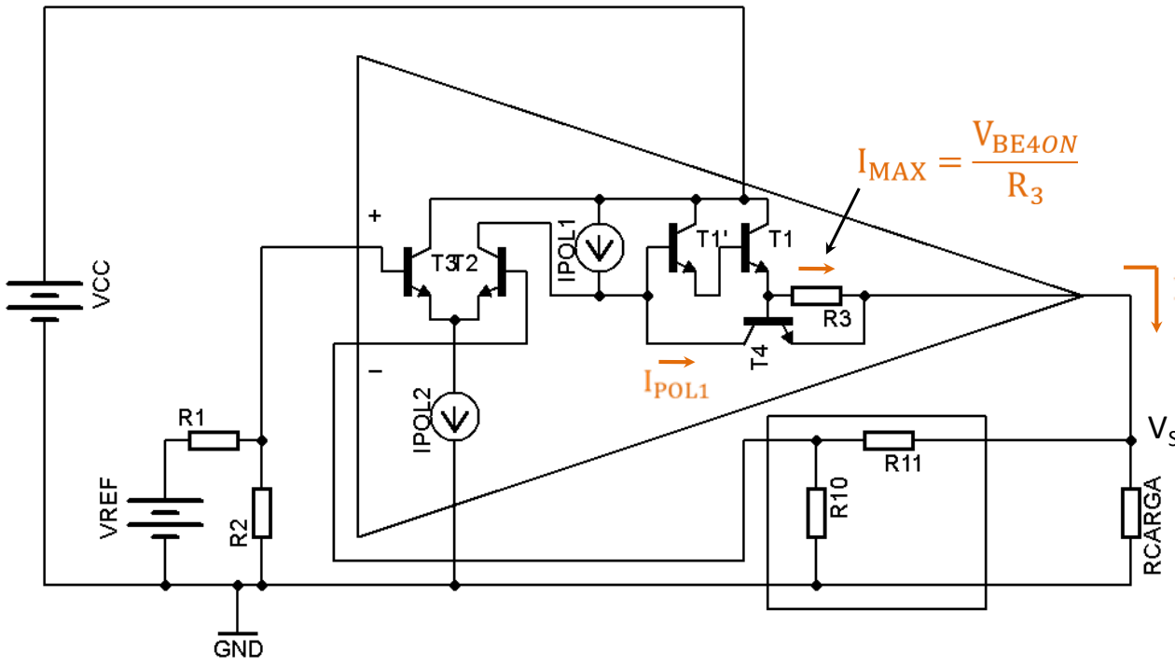
[picture p101: figure]

VSAL

Se agregan R3 y T4

¿Qué función cumple T4?

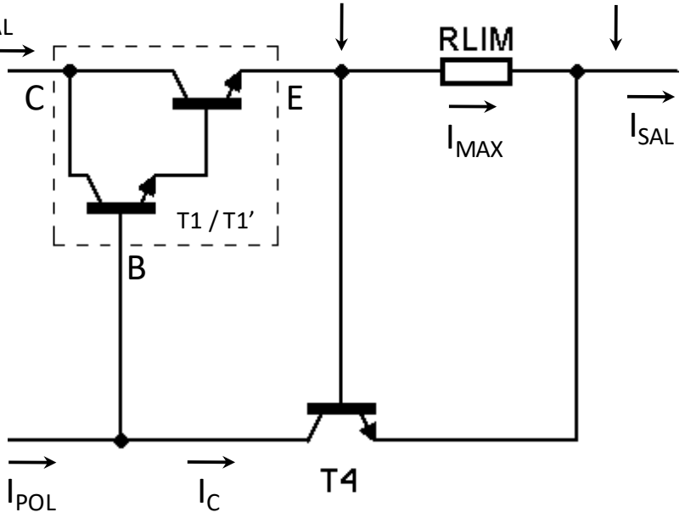
[picture p102: figure]
IPOL; IMAX; ISAL

VSAL

ISAL

IMAX

VSAL+ RLIM ISAL

VSAL

VSAL MAX

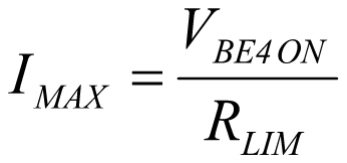
[picture p103: figure]

(En esta condición T2 queda al corte)

ISAL

Limitación de corriente

EJEMPLO NUMÉRICO

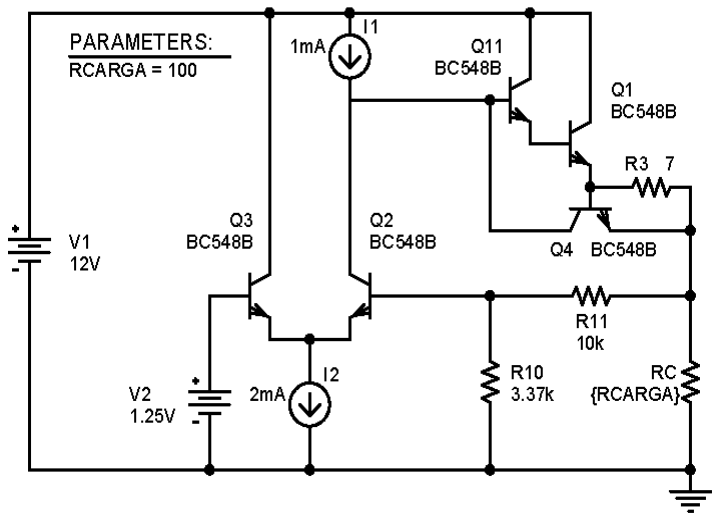
[picture p104: figure]
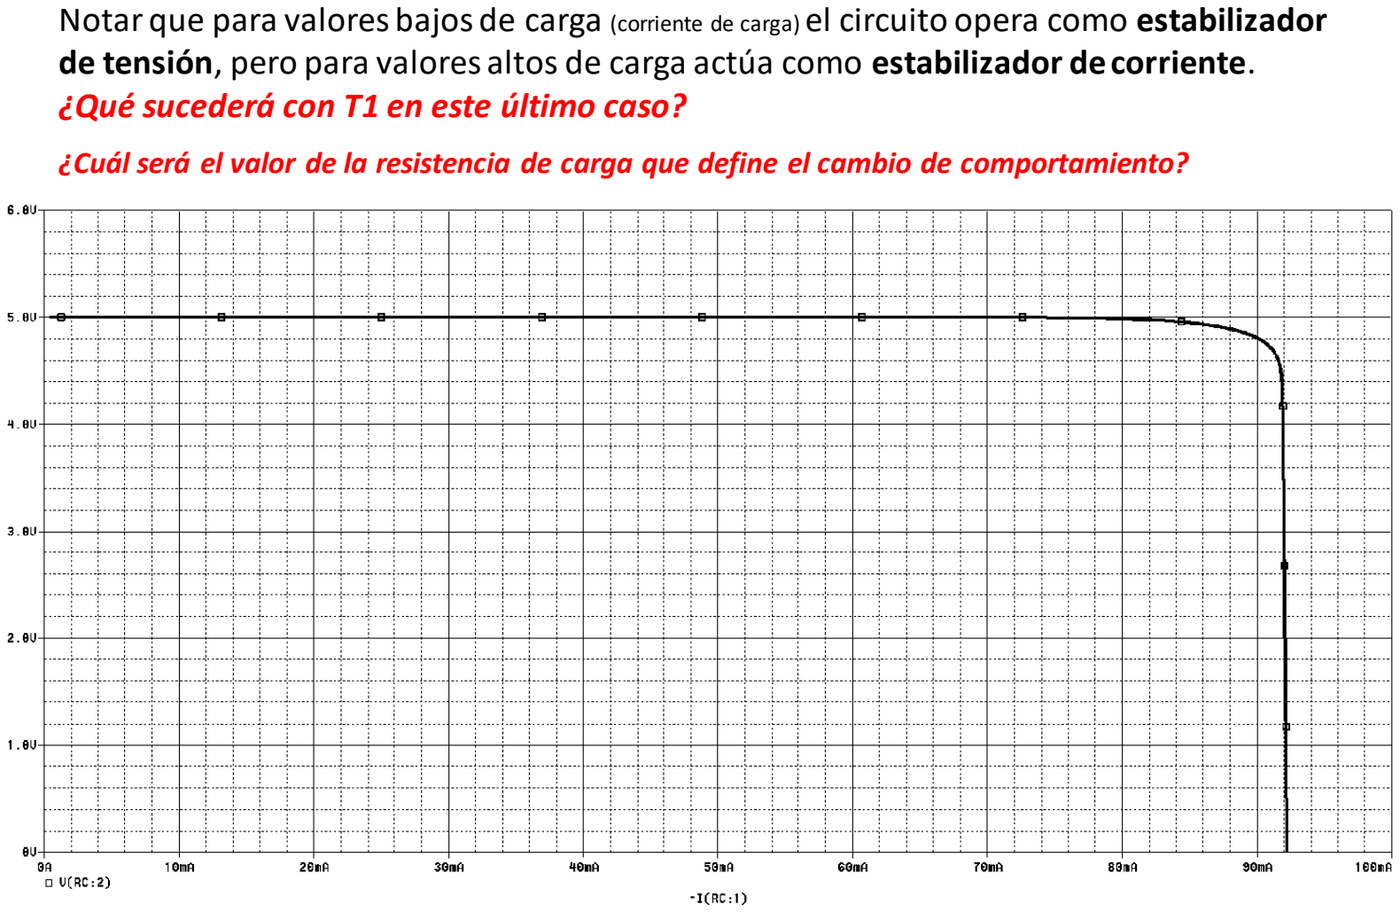
[picture p105: page 21]

Notar que para valores bajos de carga (corriente de carga) el circuito opera como estabilizador de tensión, pero para valores altos de carga actúa como estabilizador de corriente. ¿Qué sucederá con T1 en este último caso?

¿Cuál será el valor de la resistencia de carga que define el cambio de comportamiento?

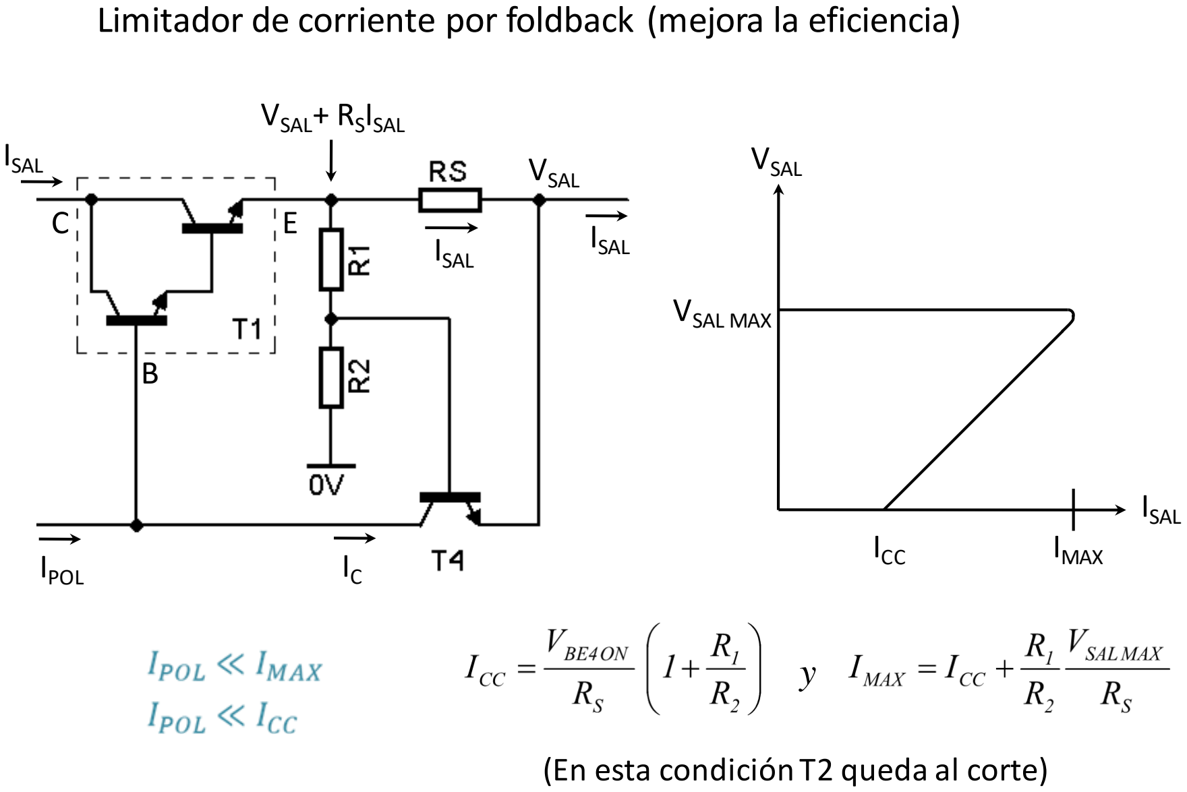
[picture p106: page 22]

Limitador de corriente por foldback (mejora la eficiencia)

VSAL

ISAL

IMAX ICC

VSAL+ RS

ISAL

ISAL | VSAL

(En esta condición T2 queda al corte)

IPOL

C

B

E

VSAL MAX

ISAL

y

ISAL

IC

EJEMPLO NUMÉRICO

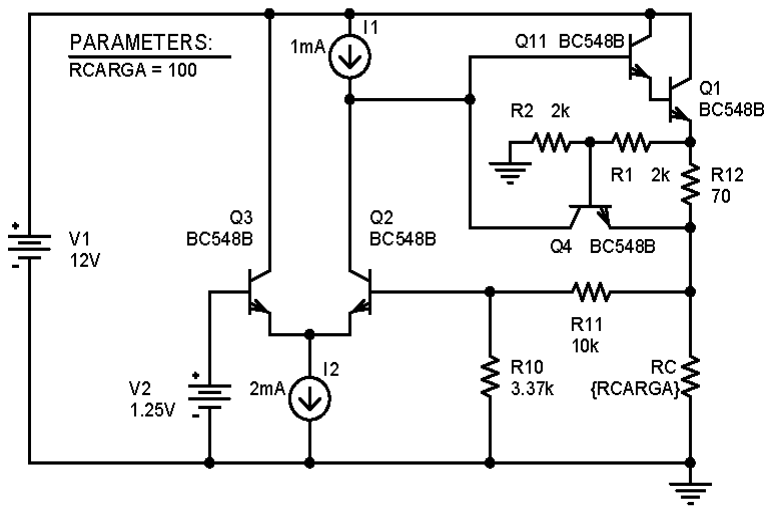
[picture p107: figure]
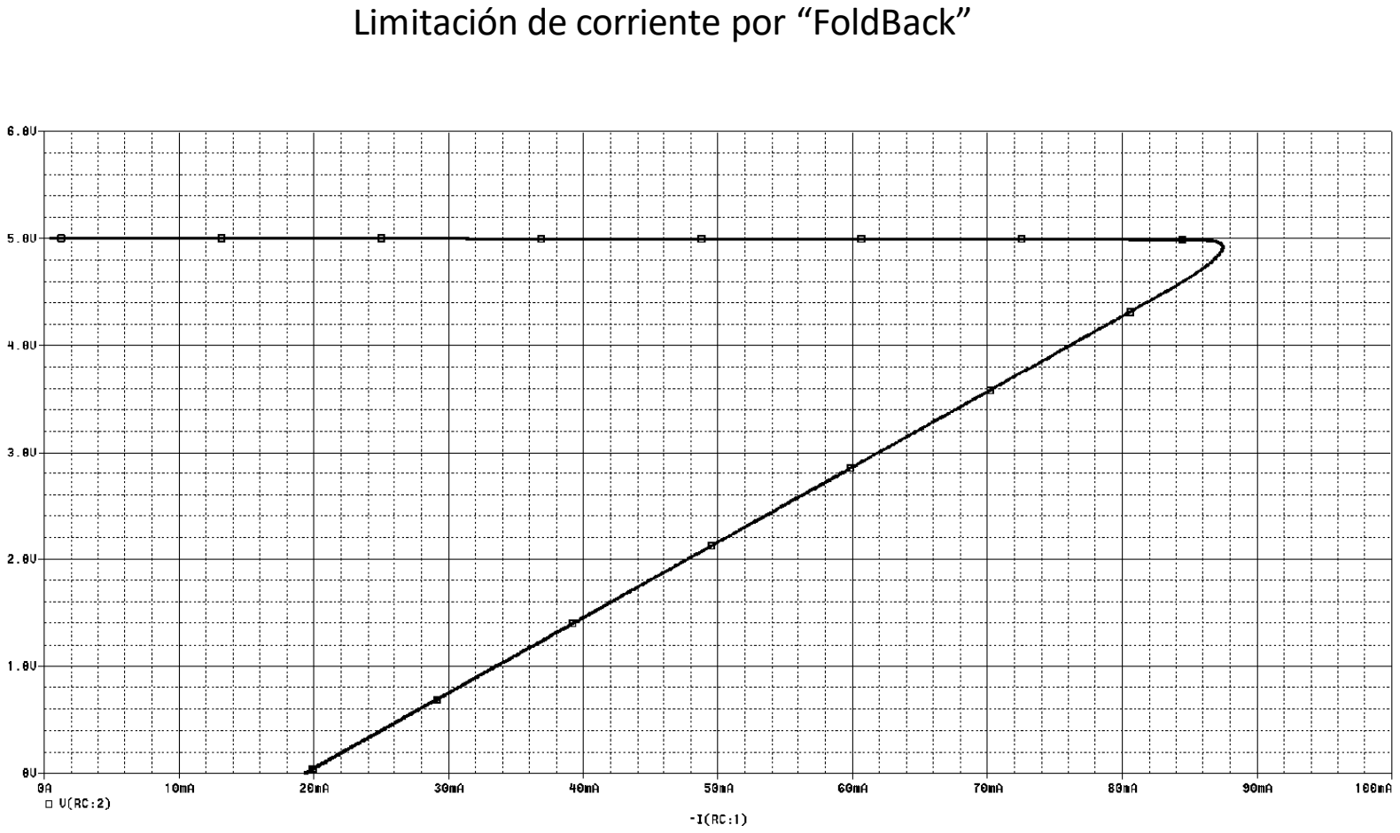
[picture p108: page 24]

Limitación de corriente por “FoldBack”

- Deducción de corrientes de limitación para Foldback.

## Anexo

(notar que VR1 varía con VSAL)

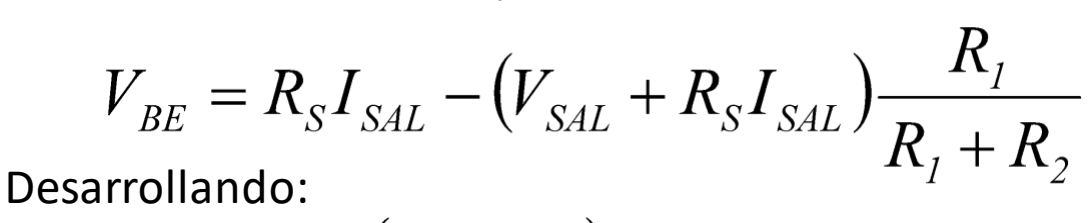
[picture p109: figure]
Desarrollando:

Resolviendo la malla de polarización de T4 se tiene:

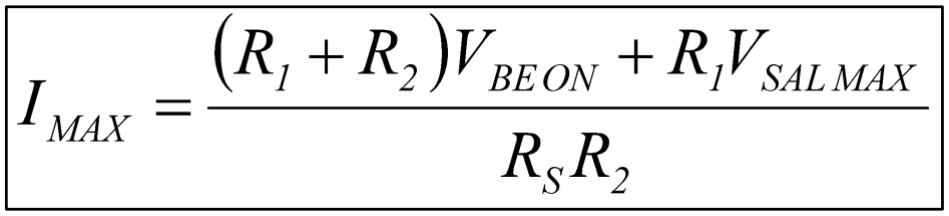
[picture p110: figure]

En caso de cortocircuito VSAL = 0 ; ISAL = ICC y VBE = VBE ON :

(al liberar el cortocircuito se normaliza)

## Corriente de limitación para Foldback:

Cuando se llega a VBE = VBE ON con VSAL = VSAL MAX resulta ISAL = IMAX :

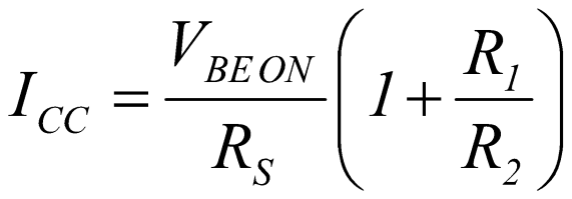
[picture p111: figure]

NOTA: VBE ON = 0,7V típico o tomar de gráfica IC ─ VBE para IC=IPOL

Bibliografía recomendada:

- “Análisis y diseño de Circuitos Integrados, autores Gray-Meyer-Hurst-Lewis: Capítulos:
3. Amplificadores con un solo transistor y con múltiples transistores
4. Espejos de corriente, cargas activas y referencias
8. Realimentación
- Circuitos Microelectrónicos, autores Sedra y Smith
Capítulo 8 “Retroalimentación”
- Circuitos Microelectrónicos - Análisis y Diseño, autor Rashid Capítulo 10 “Amplificadores Retroalimentados”
