Fjmoya-uba/Taller-de-Circuitos-Grupo-4/Teóricas/Fuentes de alimentación lineales -2da parte 2025-1_Version 2_compressed.pdf

Hasta el momento se conoce cómo funciona un regulador de tensión con sus limitaciones de corriente.

Para concluir el análisis de estos circuitos, a continuación se trata:

1) Ejemplo de diseño.
2) Regulador de tensión integrado.
3) Reguladores Dropout.
4) Regulador Paralelo.
5) Regulador serie de tensión con limitación de corriente ajustable.

## Aplicaciones

# Fuentes de alimentación lineales Segunda Parte

Las etapas de un regulador serie son similares a las de un amplificador:

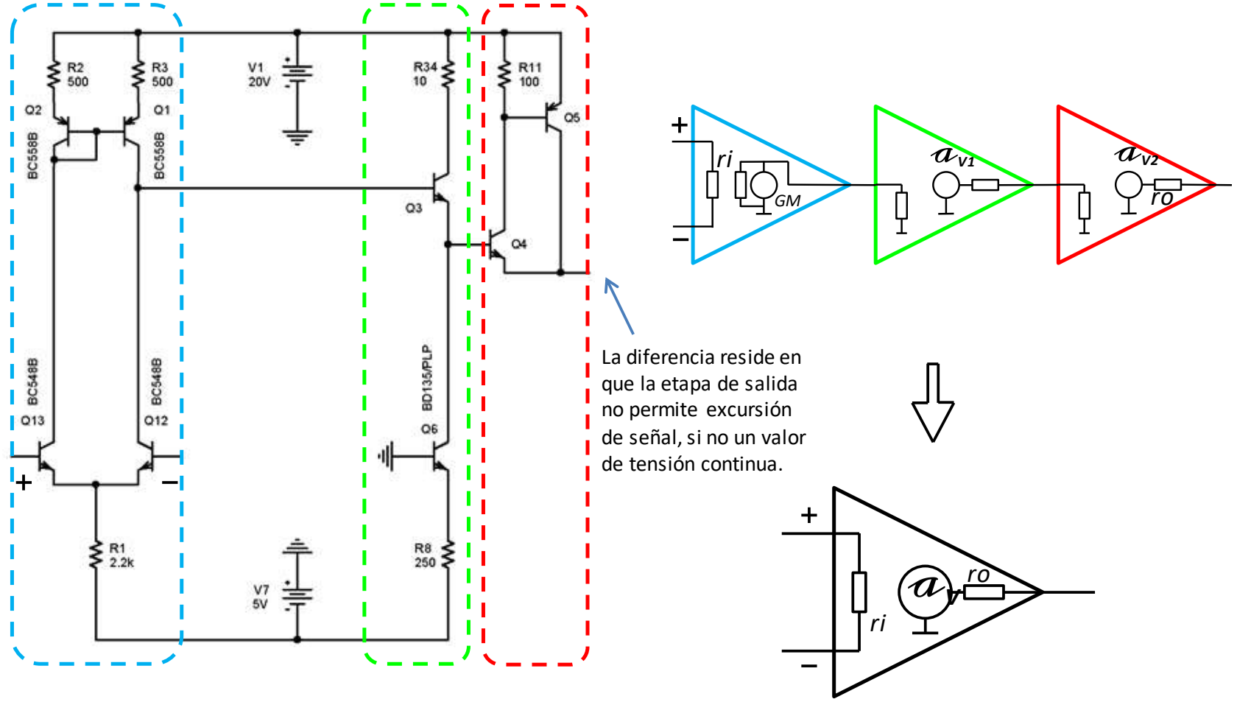
[picture p112: figure]
La diferencia reside en que la etapa de salida no permite excursión de señal, si no un valor de tensión continua.

Ejemplo: Diseñar un circuito que entregue 1A constante sobre una carga de 10 Ohm.

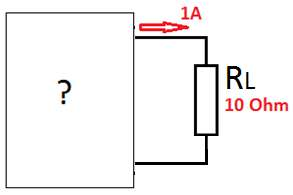
[picture p113: figure]

1) Muestreo de la corriente (Ao >> 1).

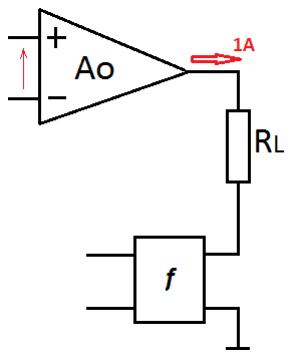
[picture p114: figure]

2) Se elige sumar tensión.

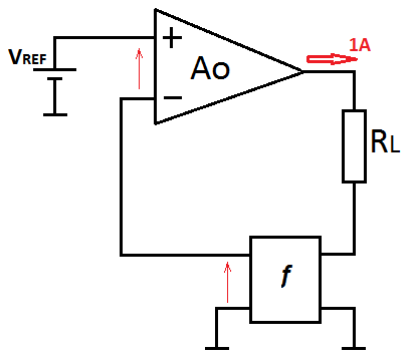
[picture p115: figure]

3) Muestreo sobre una RF: 1A / VREF = 1/RF

(observar que si RF = 1 Ohm, se pierde un 10% de la tensión en f)

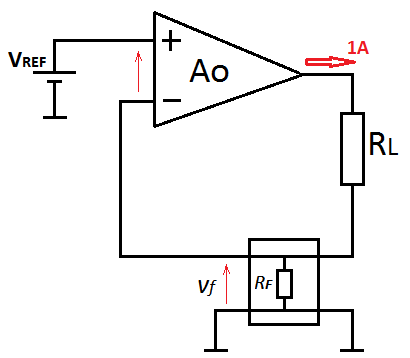
[picture p116: figure]

4) Pero la carga en general estará conectada a común.

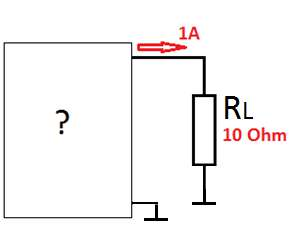
[picture p117: figure]

5) Se modifica la ubicación del realimentador.

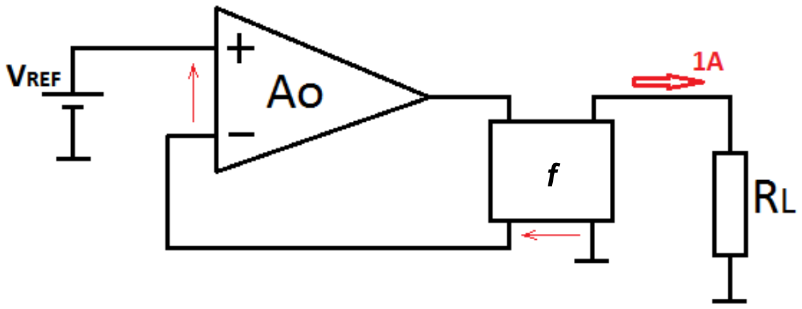
[picture p118: figure]

6) ¿Cómo se lleva la información a la entrada?

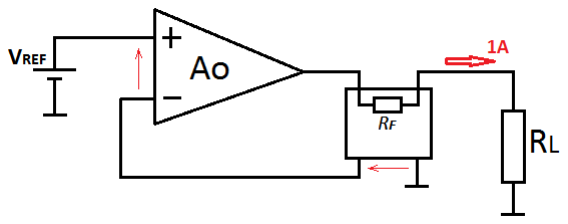
[picture p119: figure]

7) af amplifica la señal diferencial sobre RF.

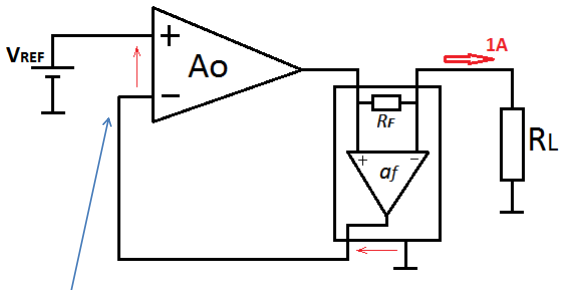
[picture p120: figure]

VREF = IL. RF. af

8) Utilizando componentes reales: ¿Cómo se implementa af ?

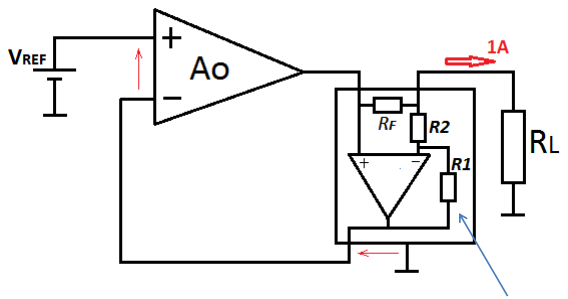
[picture p121: figure]

¿Qué problema tiene esta implementación?

9) La solución es armar un AD.

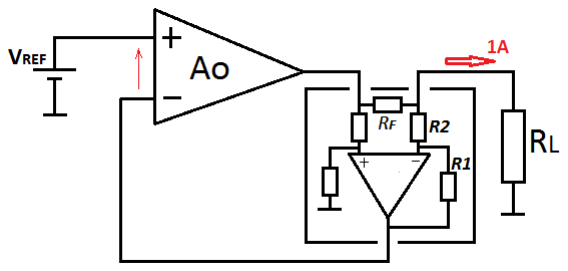
[picture p122: figure]

10) Por ahora, para polarizar los amplificadores, se tiene Vcc.

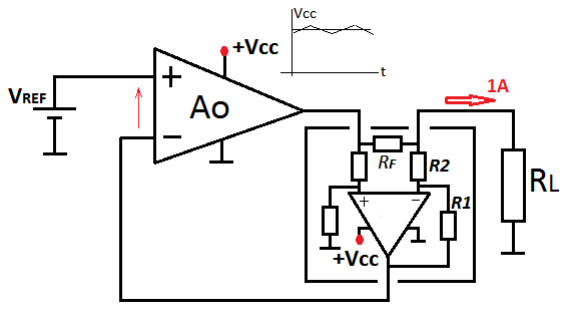
[picture p123: figure]

11) Un Ao real no puede entregar 1A. ¿Cómo se soluciona?

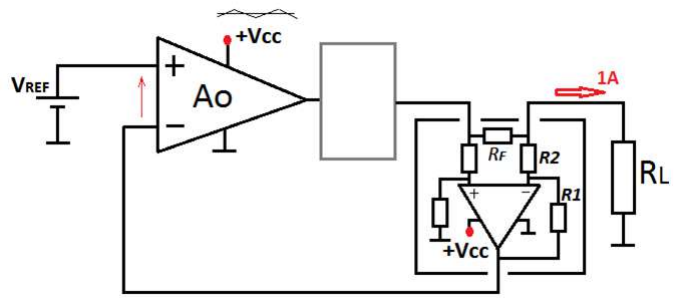
[picture p124: figure]

12) Existen varias formas de implementar un buffer (un darlington también es otra posibilidad)

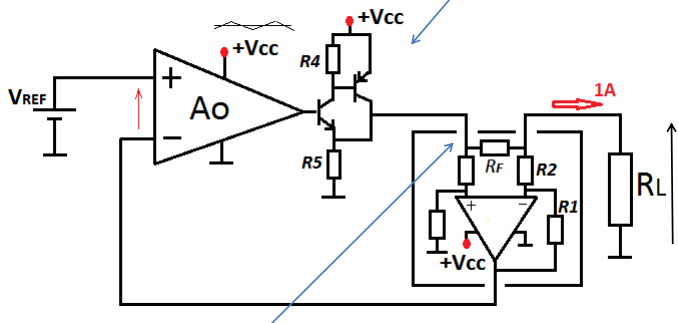
[picture p125: figure]

Si bien RRMC es elevado Vic ≅ Vo. ¿Cómo se soluciona?

Vo

13) Se utiliza un divisor en cada entrada del OPAMP.

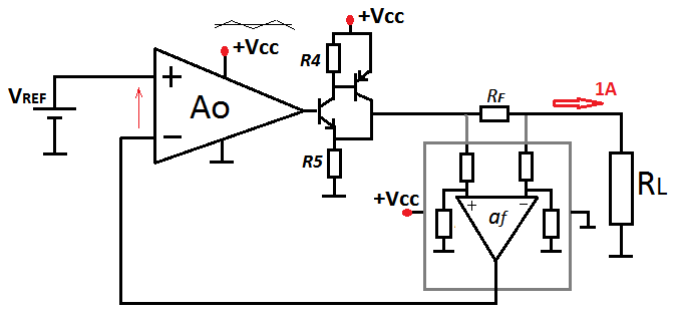
[picture p126: figure]

14) Se reacomoda el circuito teniendo en cuenta los equivalentes Thévenin del AD.

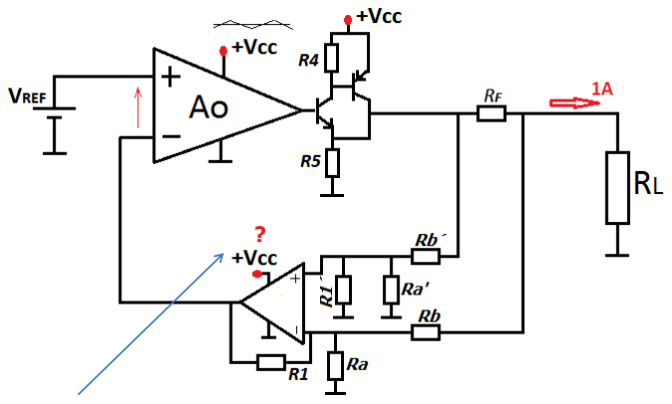
[picture p127: figure]

No resulta conveniente una fuente no regulada en el lazo. ¿De donde conviene alimentar?

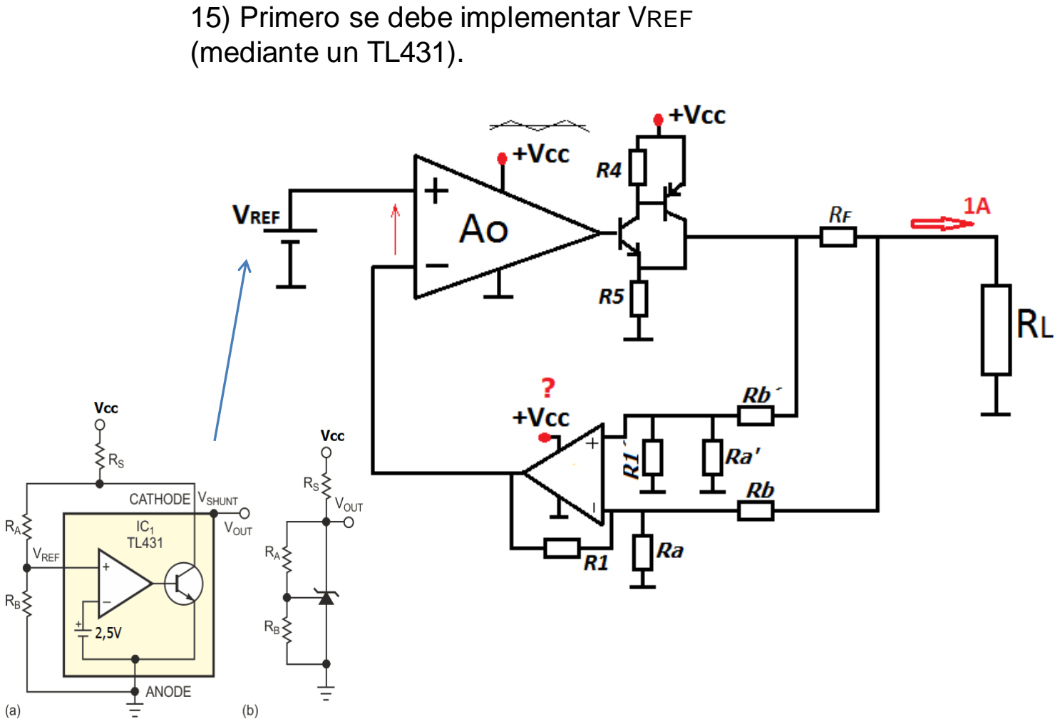
[picture p128: page 18]

15) Primero se debe implementar VREF (mediante un TL431).

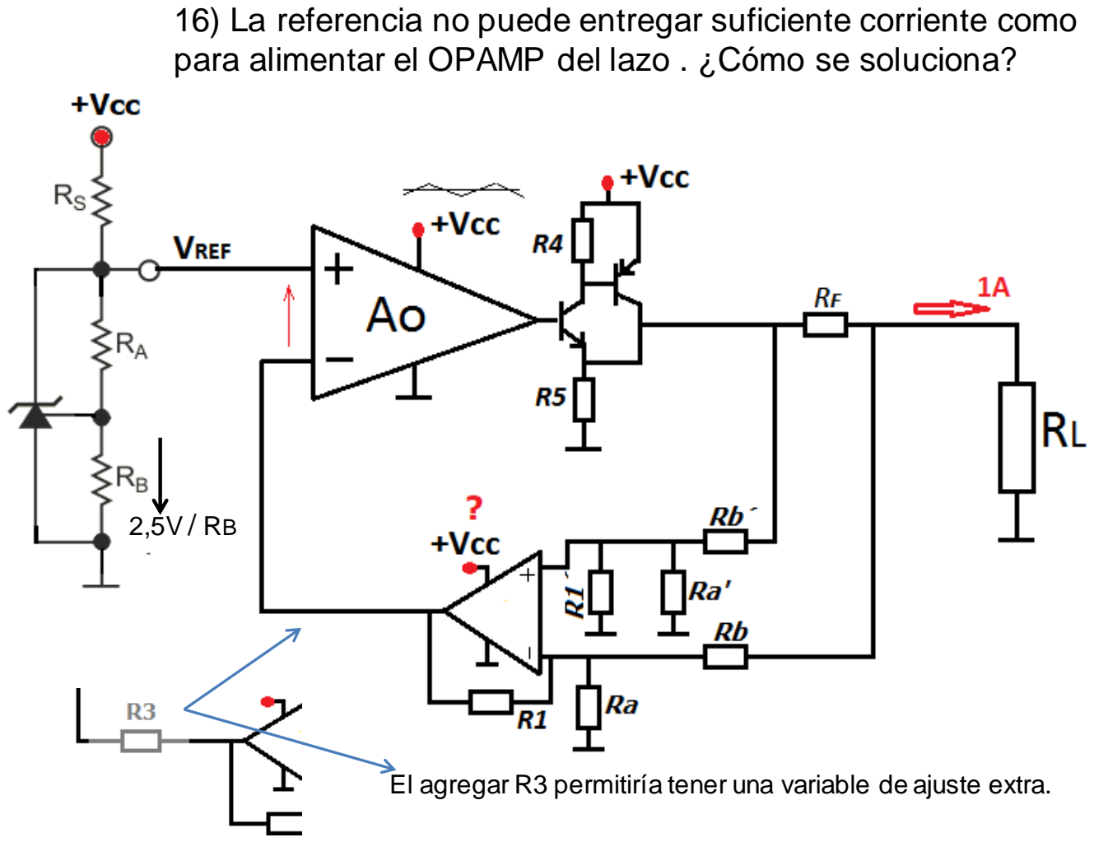
[picture p129: page 19]

16) La referencia no puede entregar suficiente corriente como para alimentar el OPAMP del lazo . ¿Cómo se soluciona?

2,5V / RB

El agregar R3 permitiría tener una variable de ajuste extra.

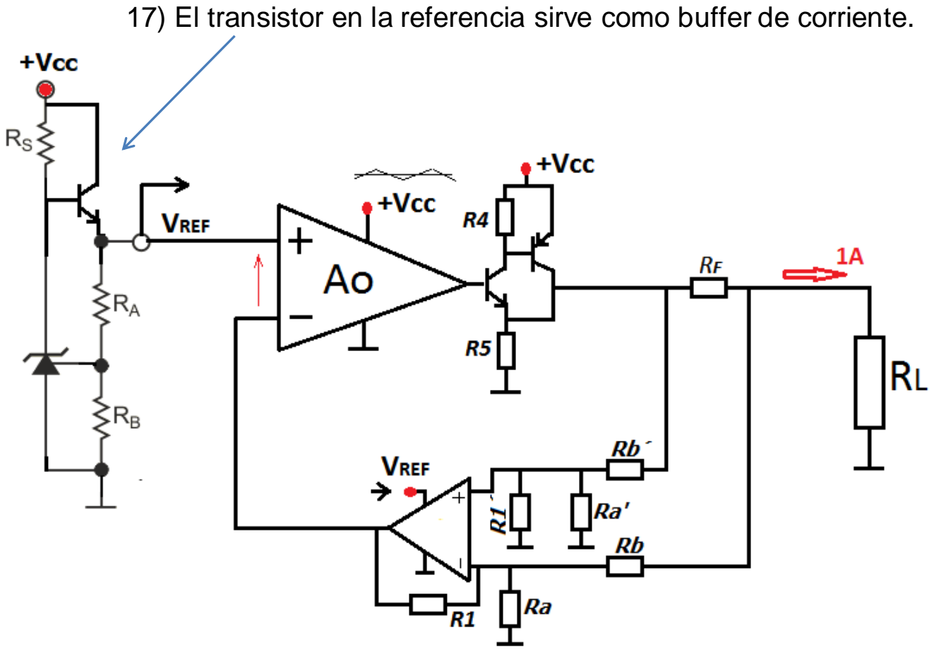
[picture p130: page 20]

17) El transistor en la referencia sirve como buffer de corriente.

18) ¿Y si se requiere un ajuste de corriente de salida?

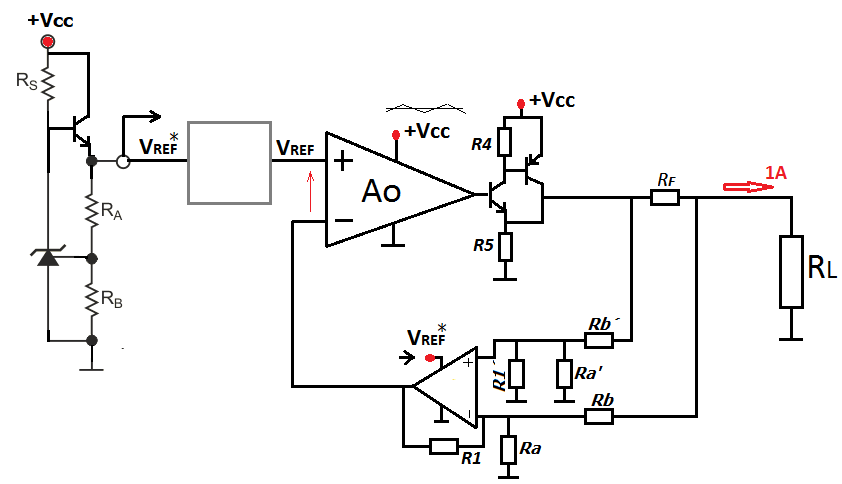
[picture p131: figure]
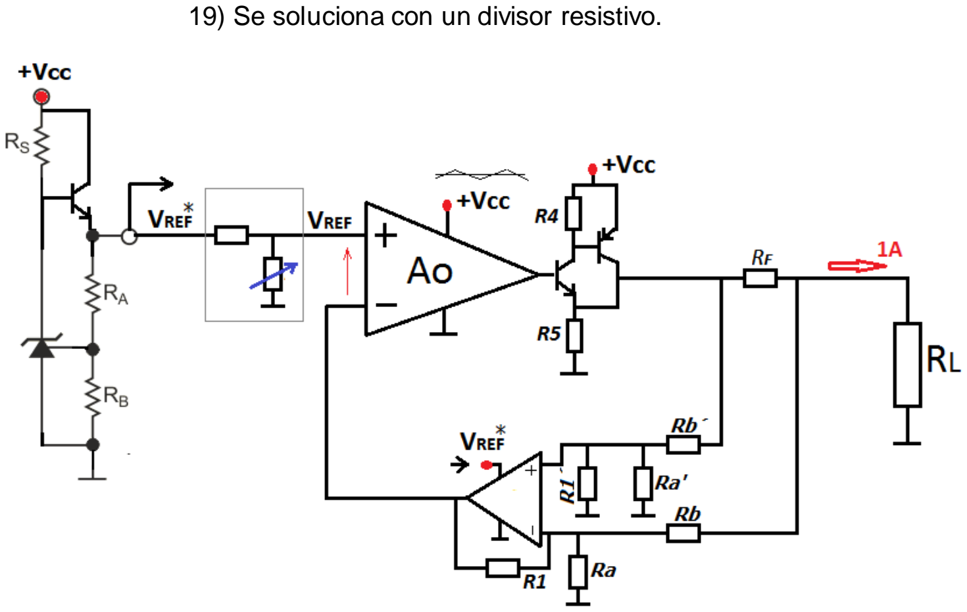
[picture p132: page 22]

19) Se soluciona con un divisor resistivo.

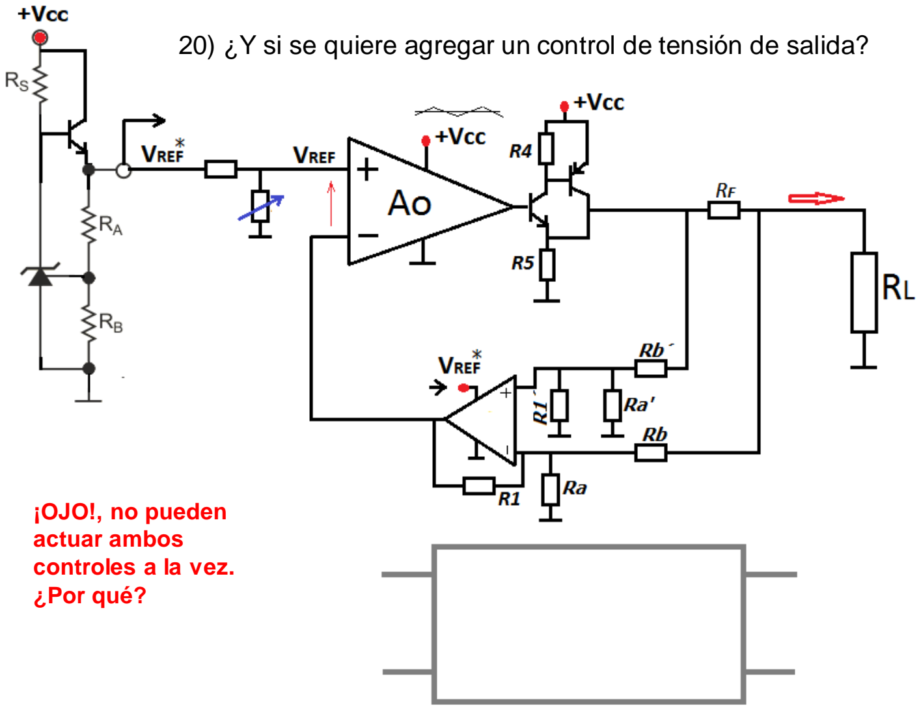
[picture p133: page 23]

20) ¿Y si se quiere agregar un control de tensión de salida?

¡OJO!, no pueden
actuar ambos
controles a la vez.
¿Por qué?

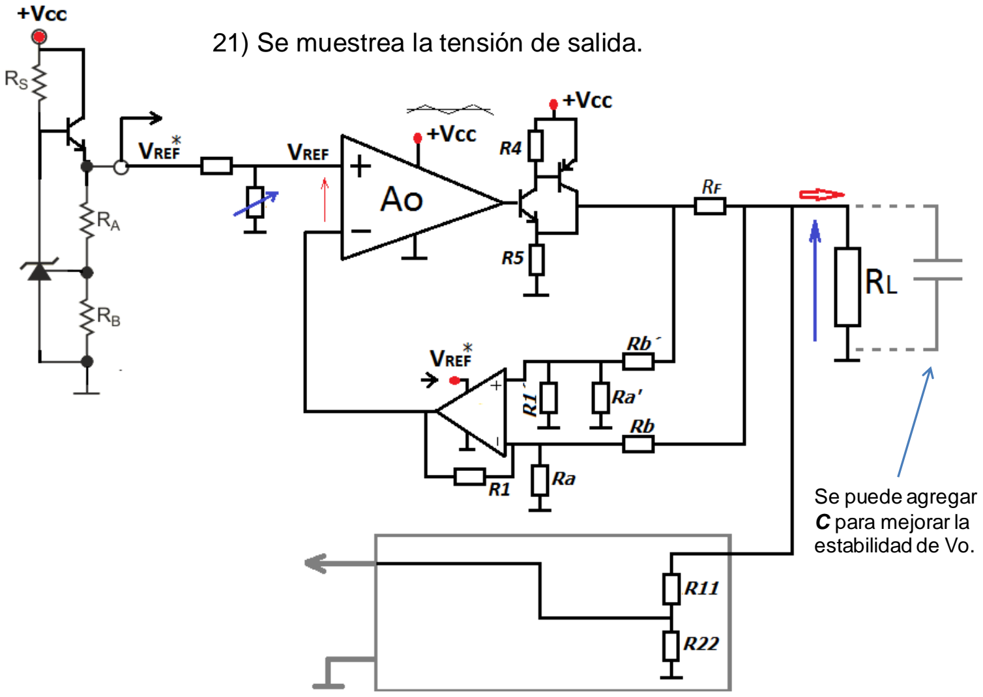
[picture p134: page 24]

21) Se muestrea la tensión de salida.

Se puede agregar
C para mejorar la
estabilidad de Vo.

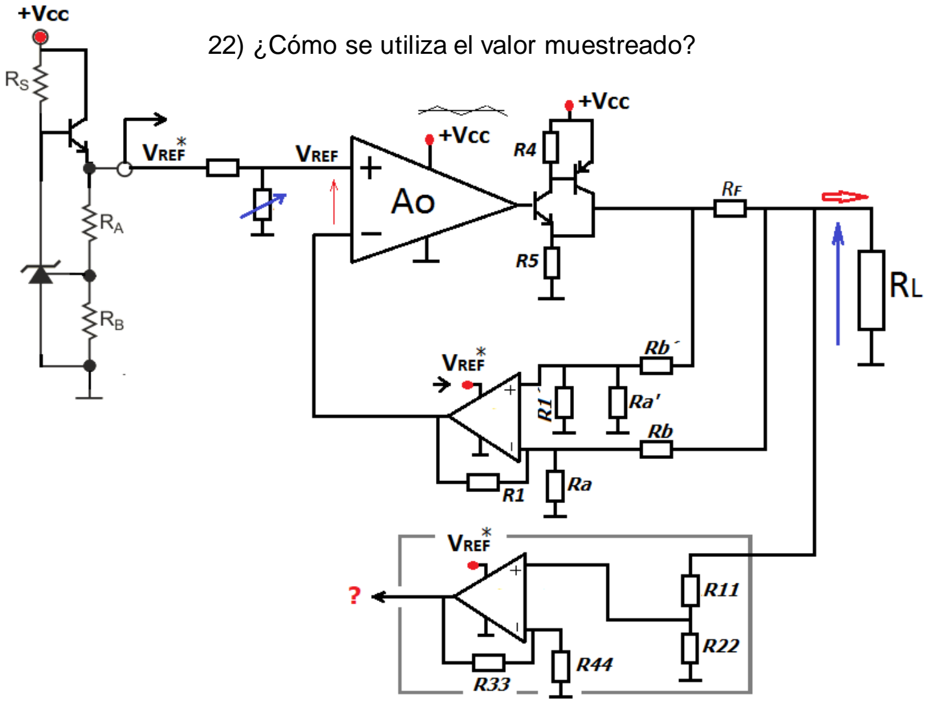
[picture p135: page 25]

22) ¿Cómo se utiliza el valor muestreado?

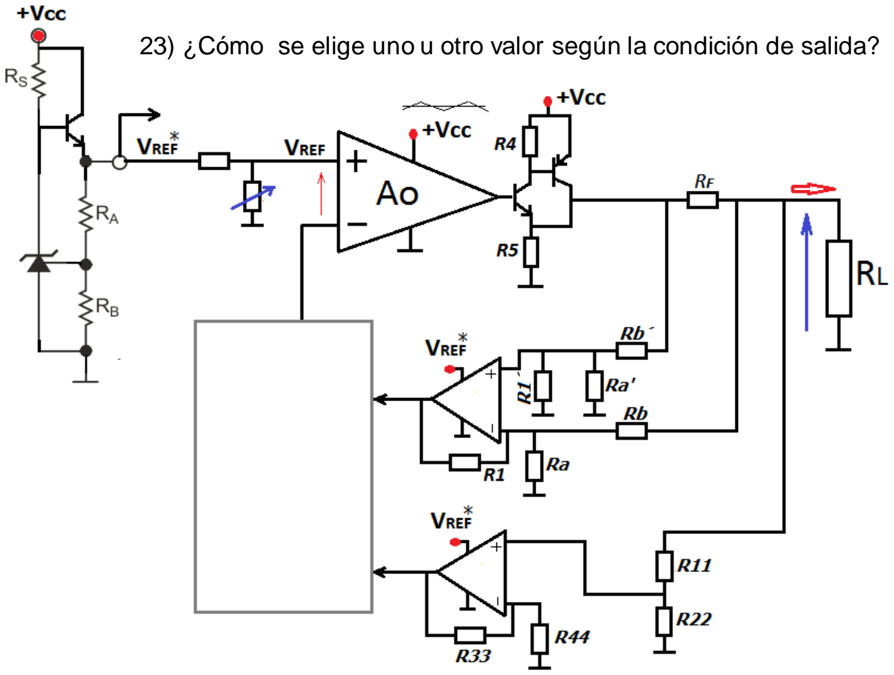
[picture p136: page 26]

23) ¿Cómo se elige uno u otro valor según la condición de salida?

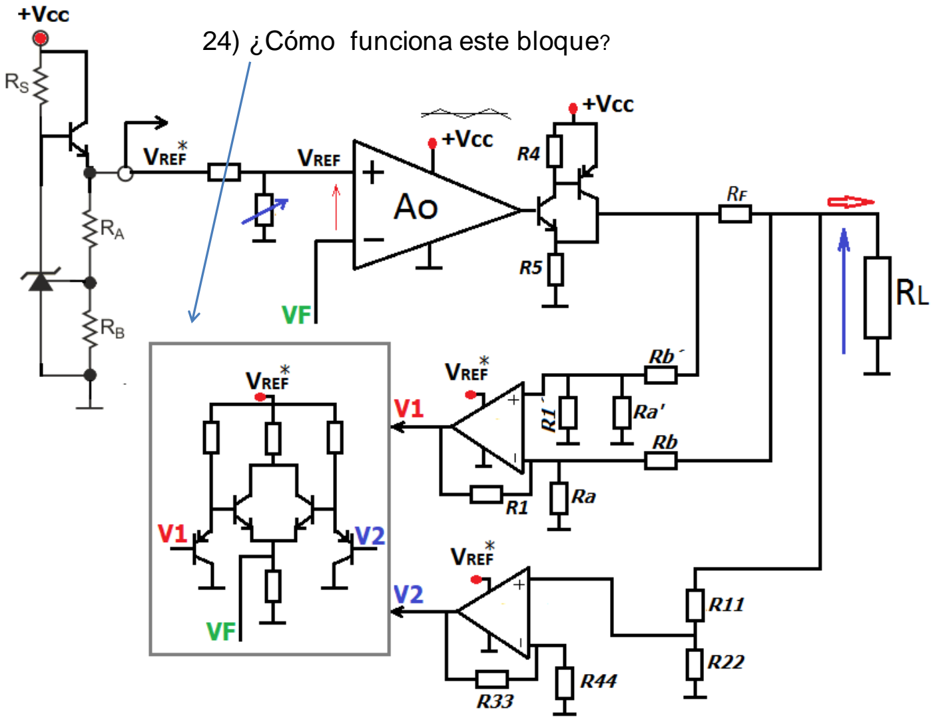
[picture p137: page 27]

24) ¿Cómo funciona este bloque?

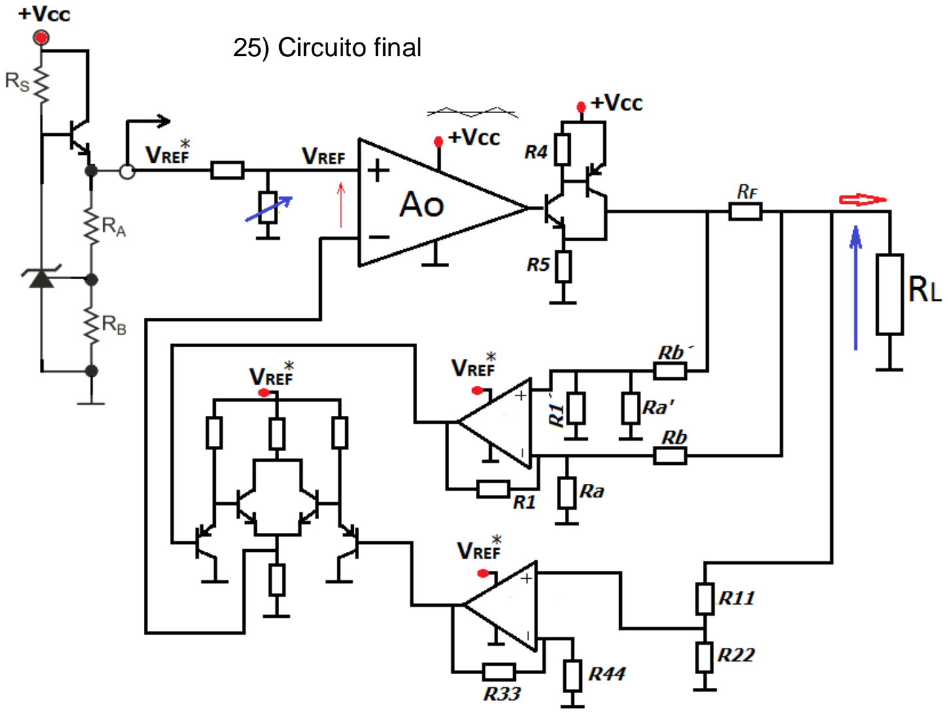
[picture p138: page 28]

25) Circuito final

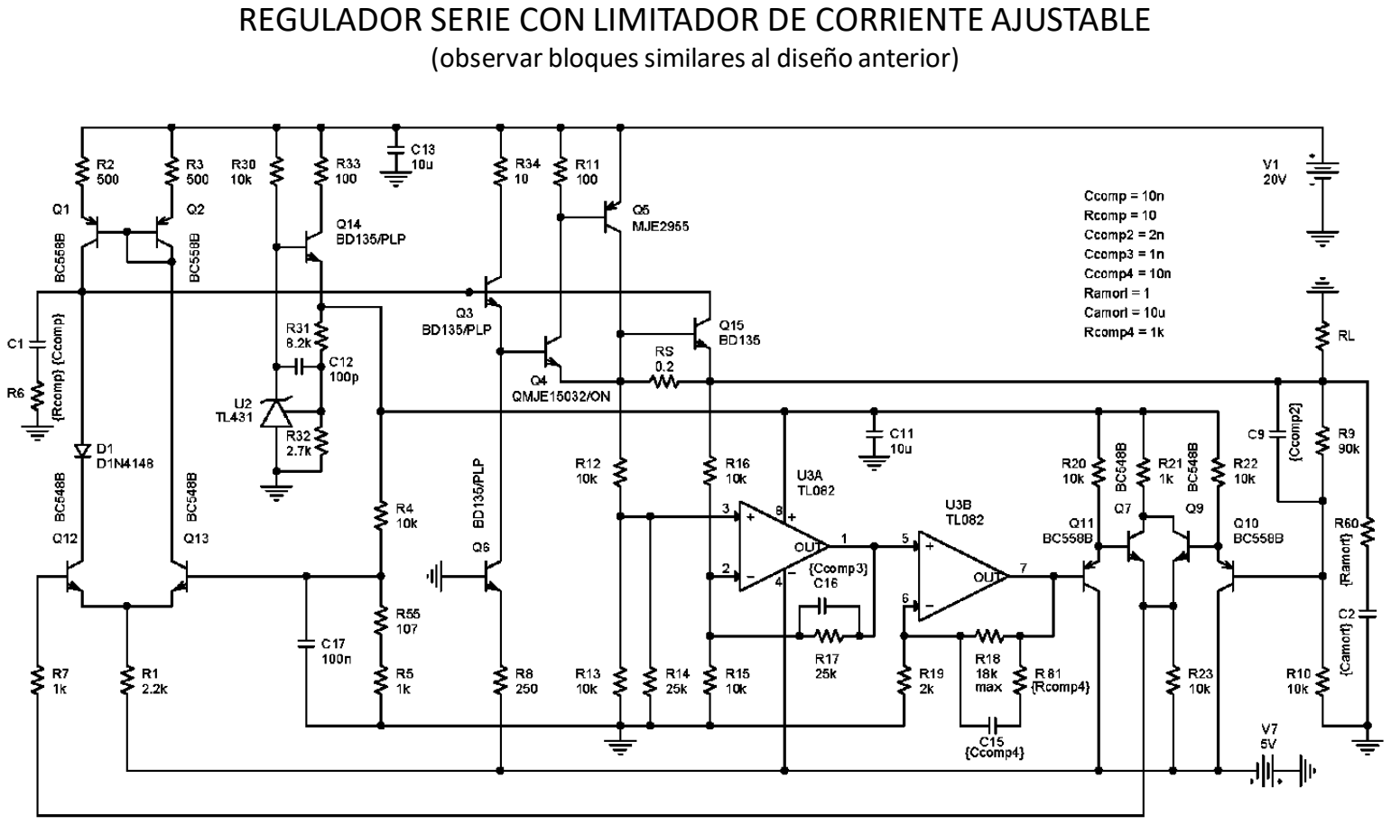
[picture p139: page 29]

REGULADOR SERIE CON LIMITADOR DE CORRIENTE AJUSTABLE
(observar bloques similares al diseño anterior)

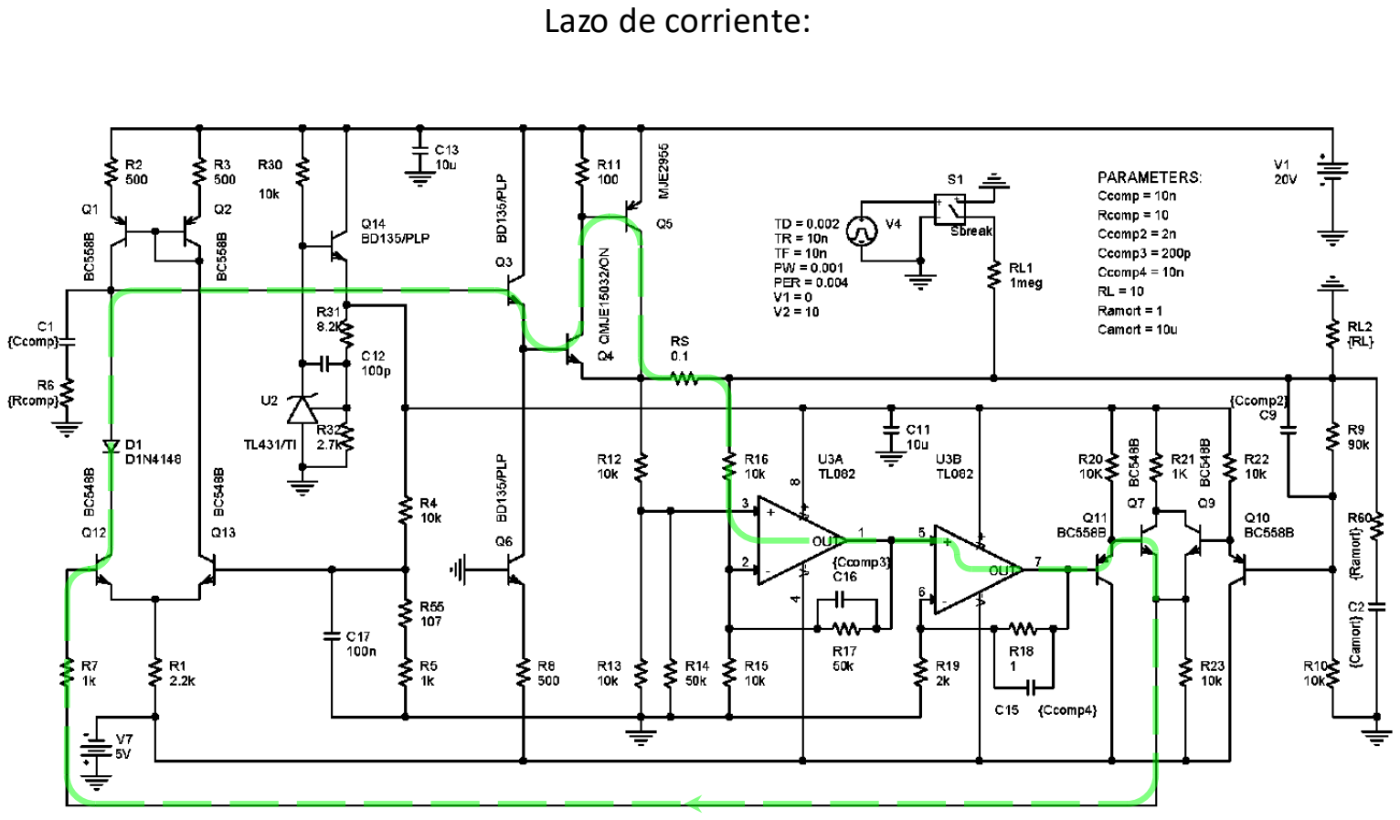
[picture p140: page 30]

Lazo de corriente:

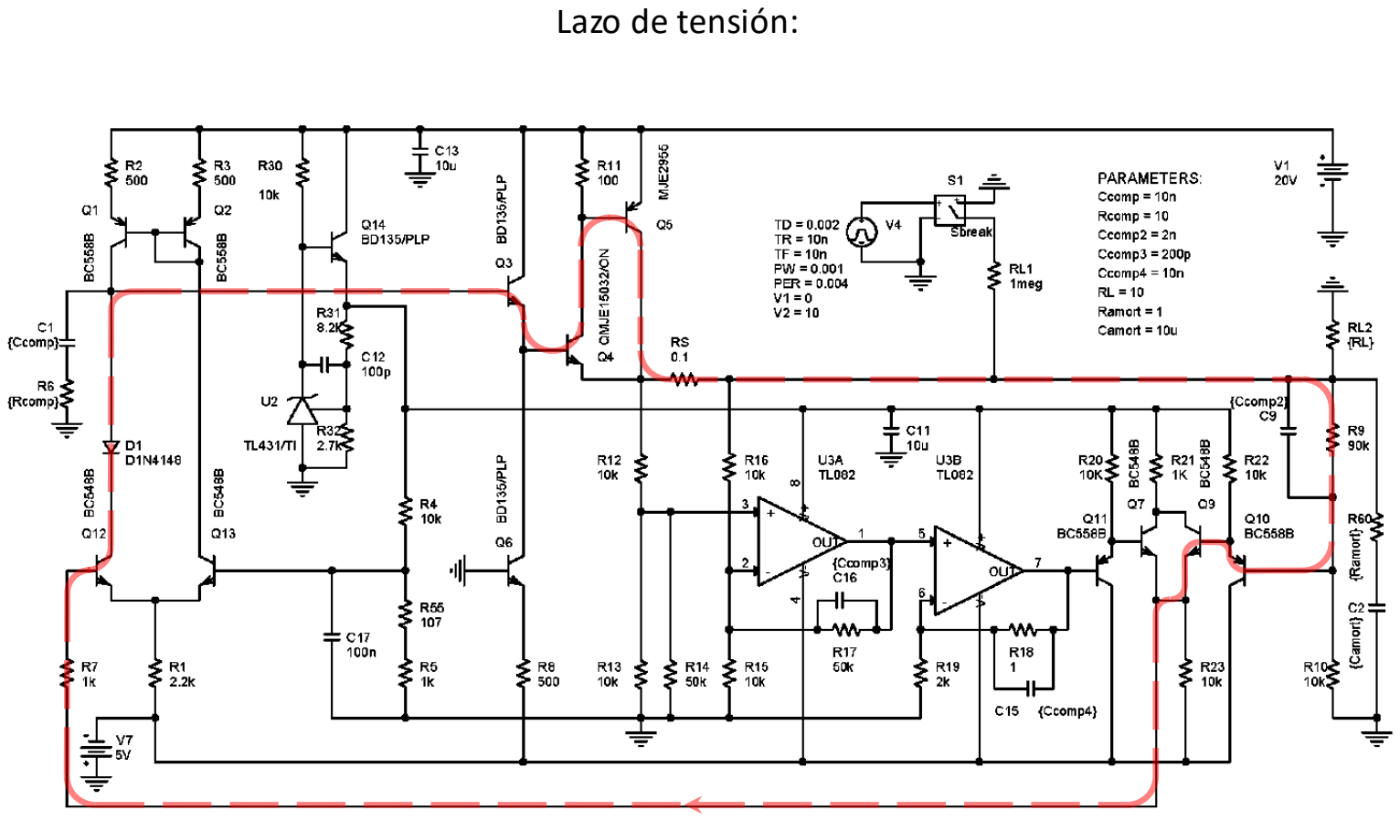
[picture p141: page 31]

Lazo de tensión:

### Diseño de un regulador

Diseñar un regulador de tensión que cumpla con las siguientes especificaciones:

Tensión de entrada: 12V (Vi)
Tensión de salida: 5V (Vo)
Limitación de corriente: 1A.

Tener en cuenta los componentes a utilizar como así también las topologías utilizadas.

## Cálculo del disipador:

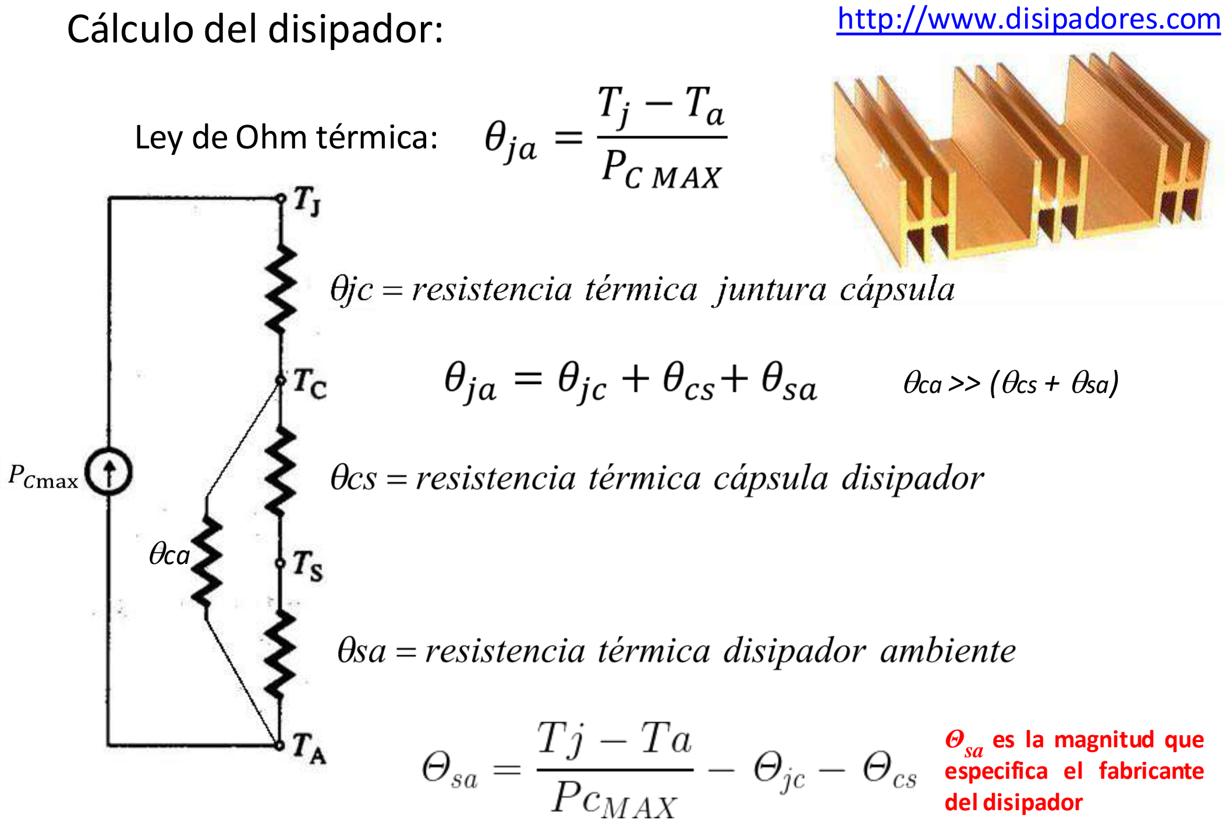
[picture p142: page 33]

### Ley de Ohm térmica:

http://www.disipadores.com

Θsa es la magnitud que
especifica el fabricante
del disipador

θca

θca >> (θcs + θsa)

## Elección del transistor:

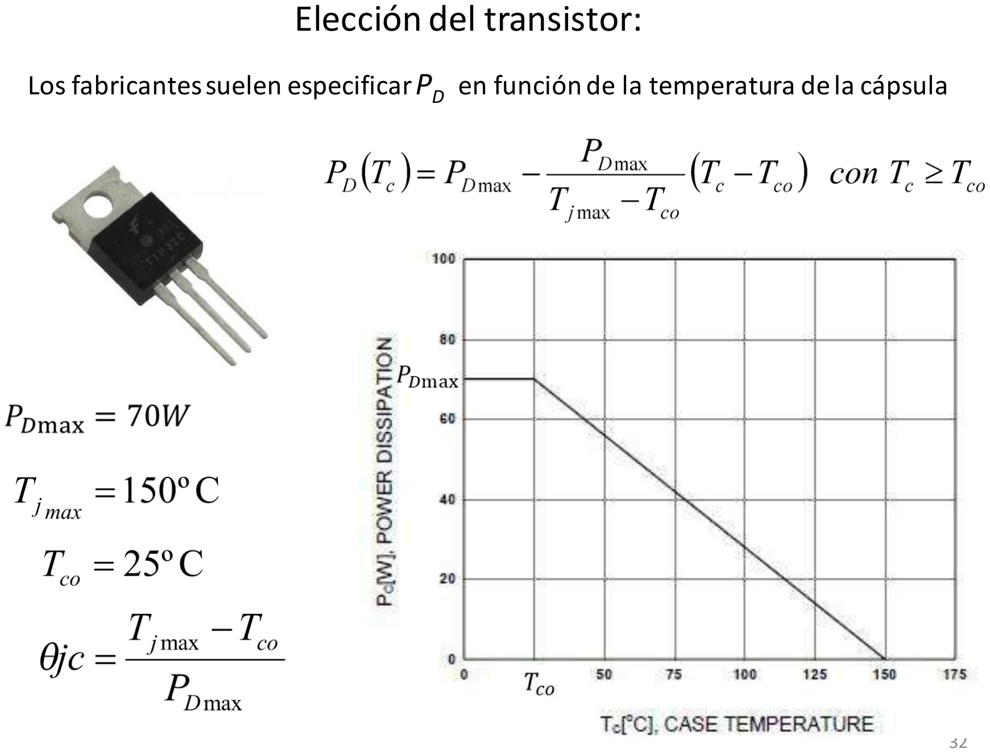
[picture p143: page 34]

32

Los fabricantessuelen especificarPD en función de la temperatura de la cápsula

## Ejemplo de cálculo de disipador

Se necesita calcular el disipador para un transistor de potencia de un regulador serie, cuyos datosson los siguientes:

Tj = 150 ºC, Ta = 50 ºC, Pc = 5W, Rjc = 1,67 ºC/W

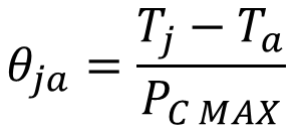
[picture p144: figure]

Luego se obtiene la resistencia térmica del disipador:

## Regulador integrado 78xx

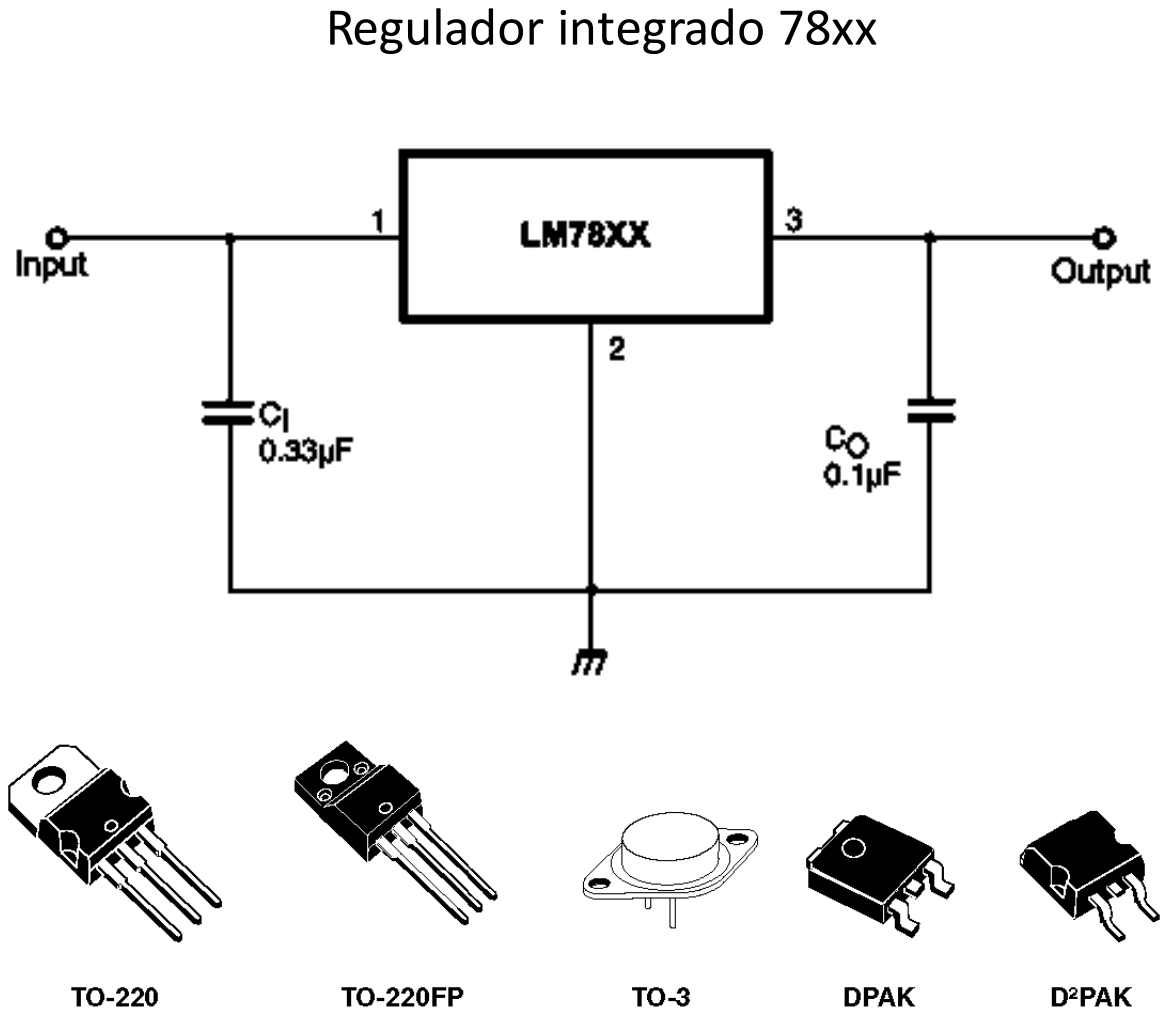
[picture p145: page 36]
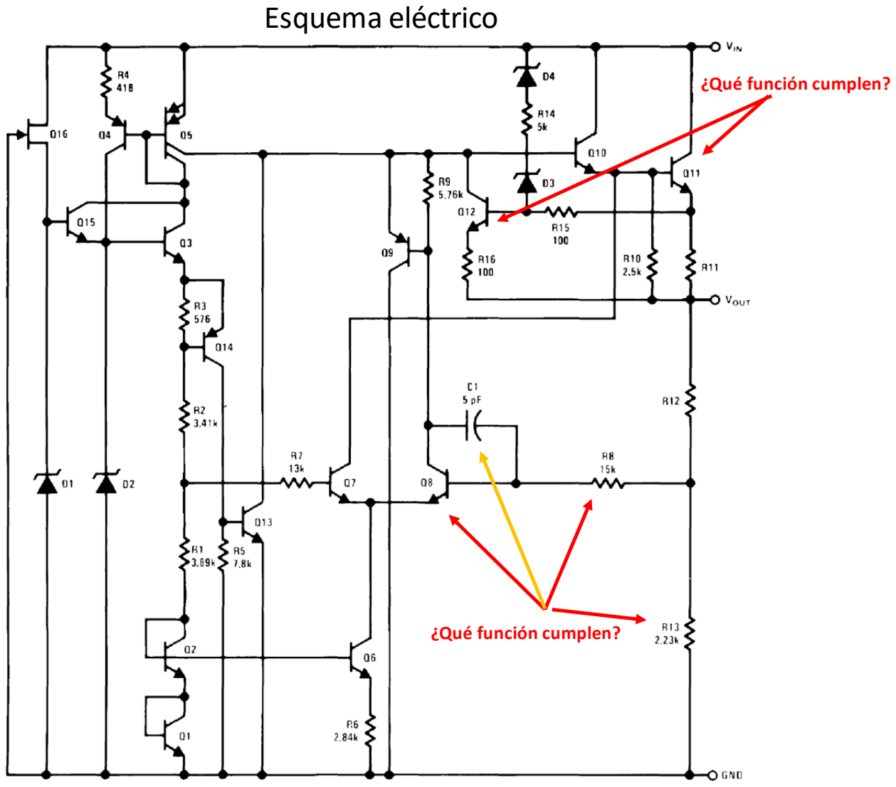
[picture p146: page 37]

### Esquema eléctrico

¿Qué función cumplen?

¿Qué función cumplen?

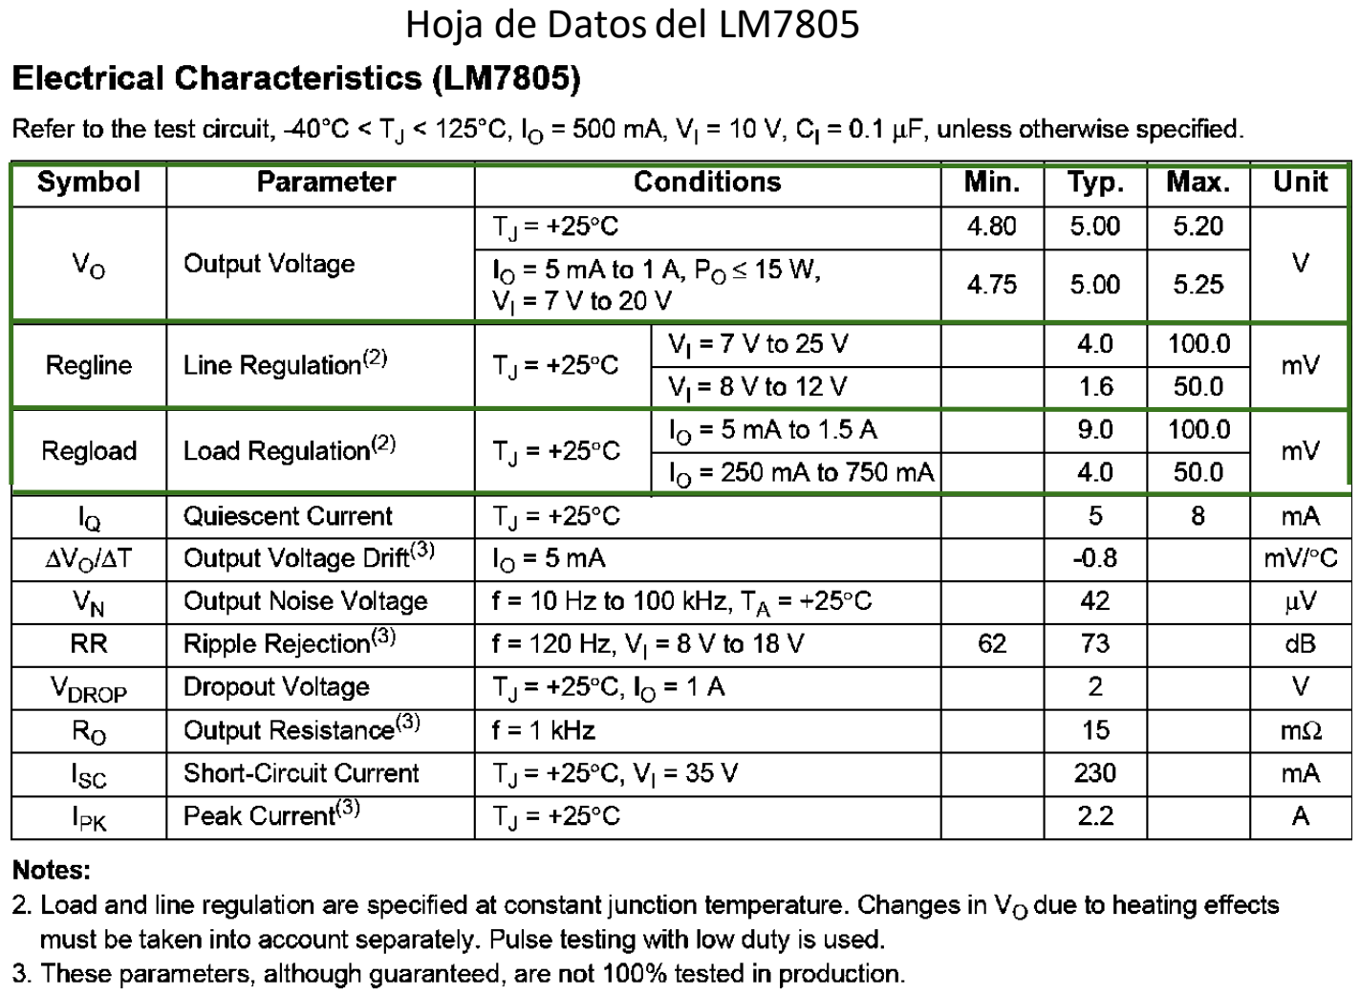
[picture p147: page 38]

### Hoja de Datos del LM7805

### Medición de características del 78xx:

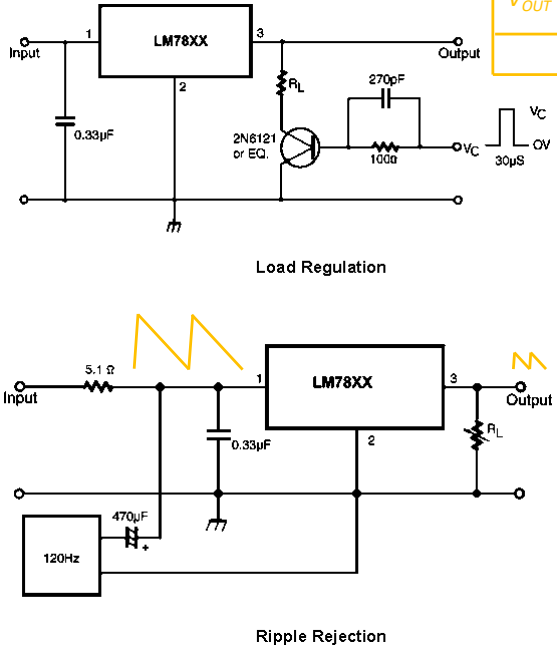
[picture p148: figure]

t

VOUT

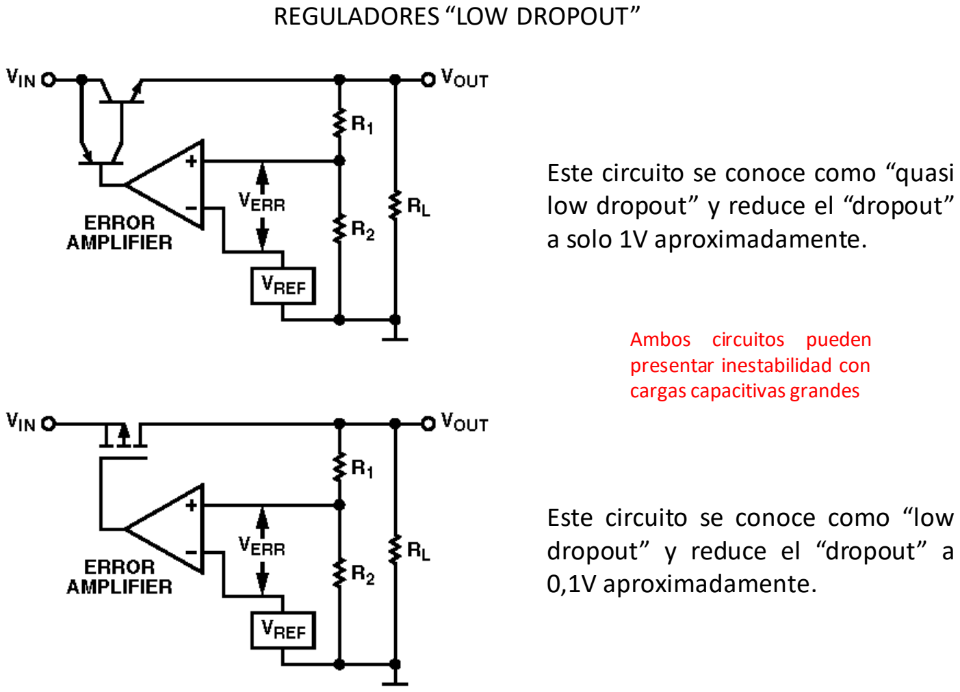
[picture p149: page 40]

REGULADORES “LOW DROPOUT”

Este circuito se conoce como “quasi low dropout” y reduce el “dropout” a solo 1V aproximadamente.

Este circuito se conoce como “low dropout” y reduce el “dropout” a 0,1V aproximadamente.

Ambos circuitos pueden
presentar inestabilidad con cargas capacitivas grandes

## Regulador paralelo

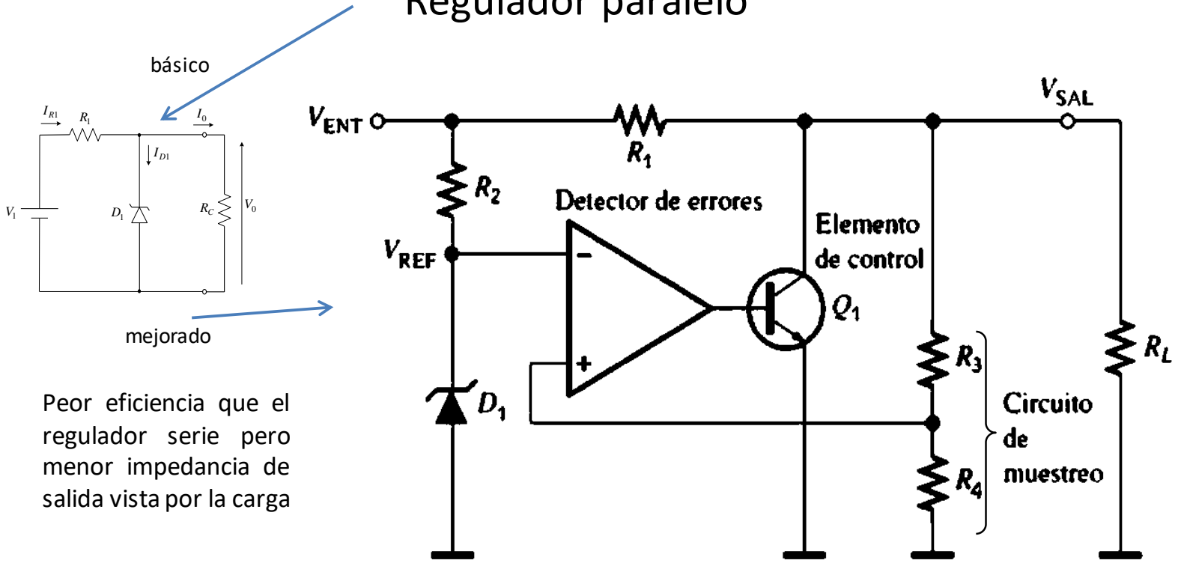
[picture p150: figure]
Peor eficiencia que el regulador serie pero menor impedancia de salida vista por la carga; básico; mejorado

a) ¿Cuál es la variable que se muestrea y cuál es la que se suma a la entrada?. Identificar la carga y la tensión de entrada.
b) Obtener la tensión de salida (VSAL) en función de VREF. ¿Qué efecto tiene R1?
