Fjmoya-uba/Taller-de-Circuitos-Grupo-4/Checkpoint 1/imagenes.pptx

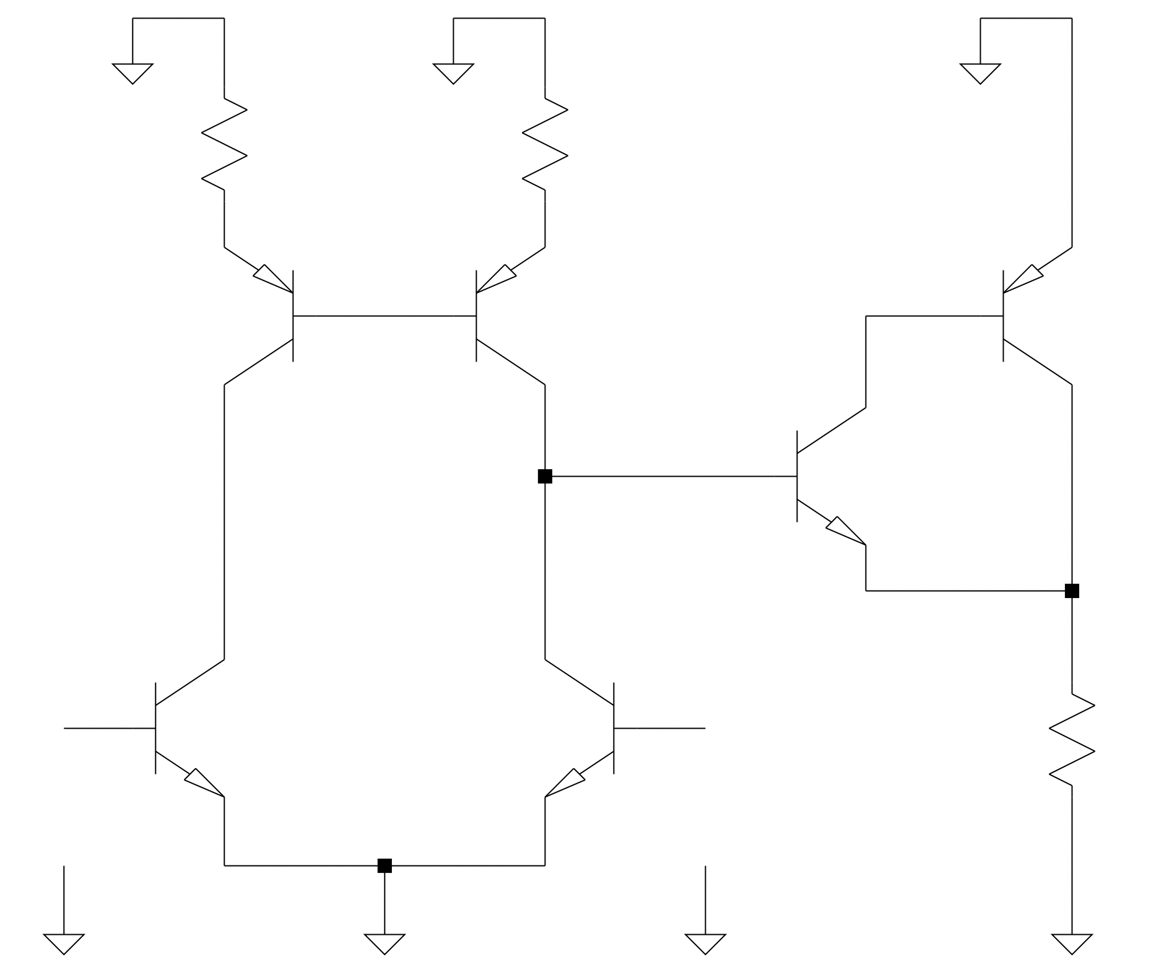
[picture p151: figure]

R_(E_3)

R_(E_4)

T_3

T_4

T_6

i_(c_4)

i_(c_5)

T_5

i_(c_6)

i_(c_1)

i_(c_2)

i_(b_5)

i_(e_5)

i_o

(v_(id))/2

T_1

T_2

−(v_(id))/2

R_L

v_o

v_(be_1)

v_(be_2)

## Slide 2

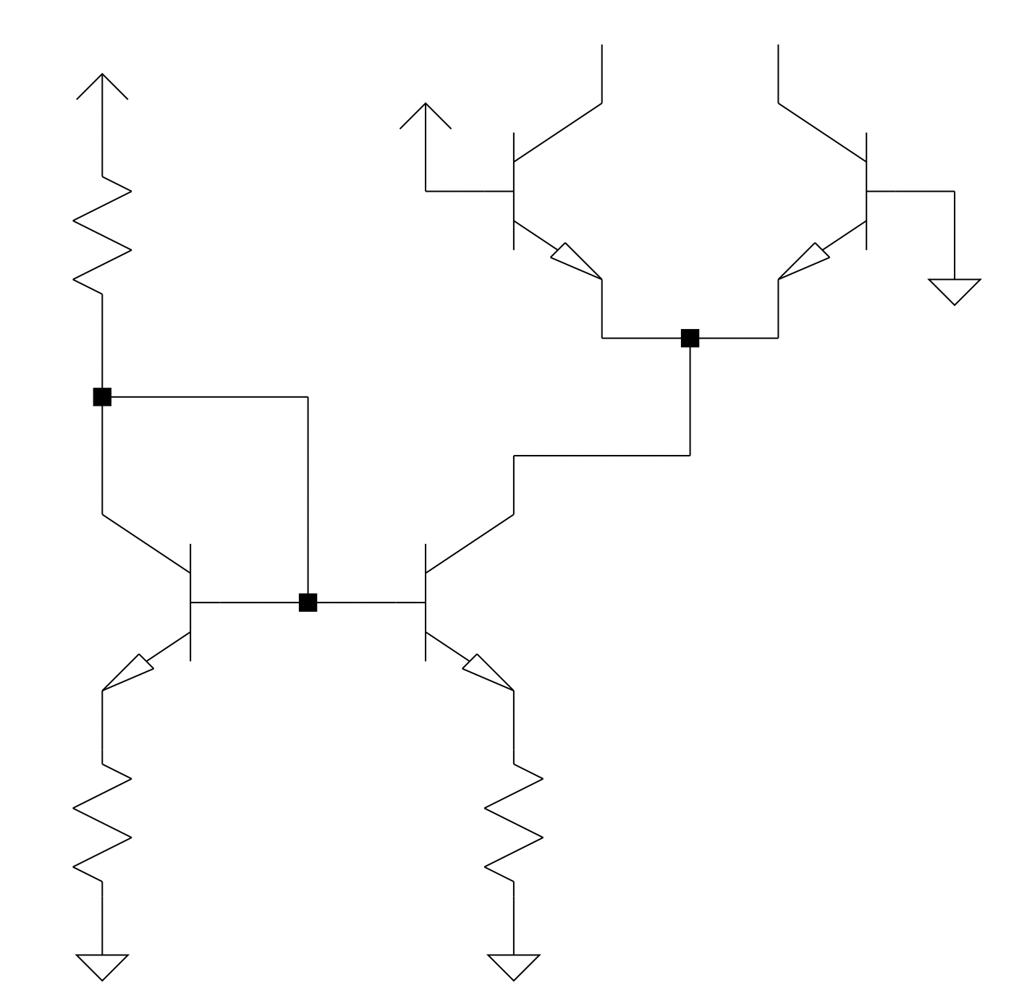
[picture p152: figure]

V_(REG)

V_(ref)

…

…

I_(C_1)

V_R

R

I_R

T_1

T_2

T_7

T_8

V_(BE_8)

I_(C_8)

R_(E_7)

V_(R_(E_8))

R_(E_8)

## Slide 3

R

R_L

−R_(E_8)

## Slide 4

V_(REG)

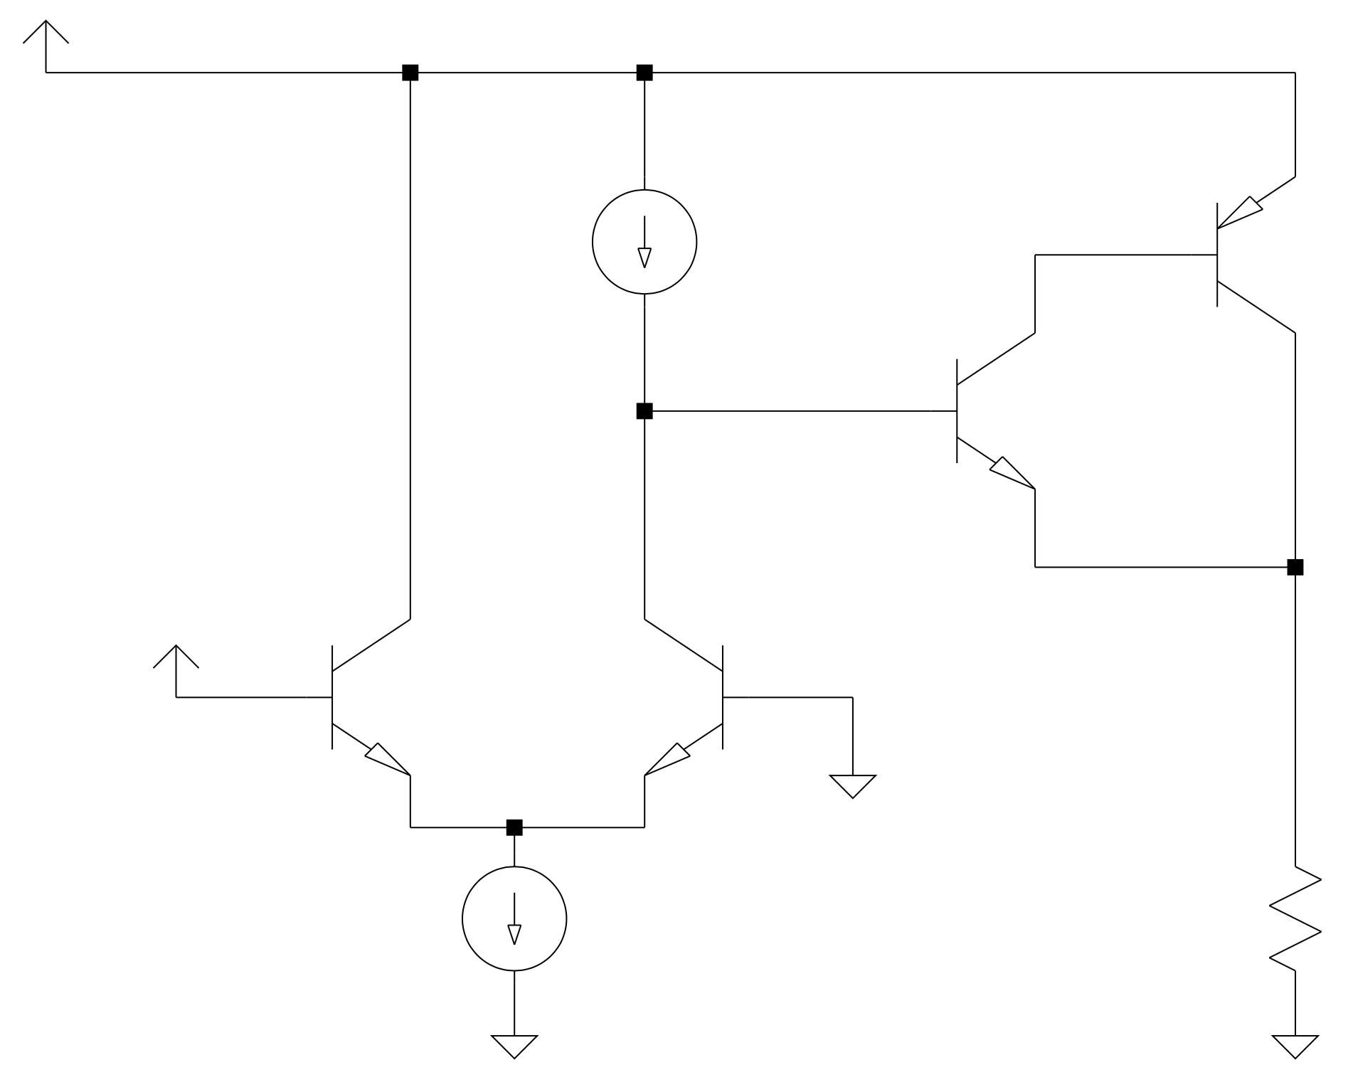
[picture p153: figure]

I_1

T_6

T_5

V_(ref)

T_1

T_2

I_2

R_L

V_O

## Slide 5

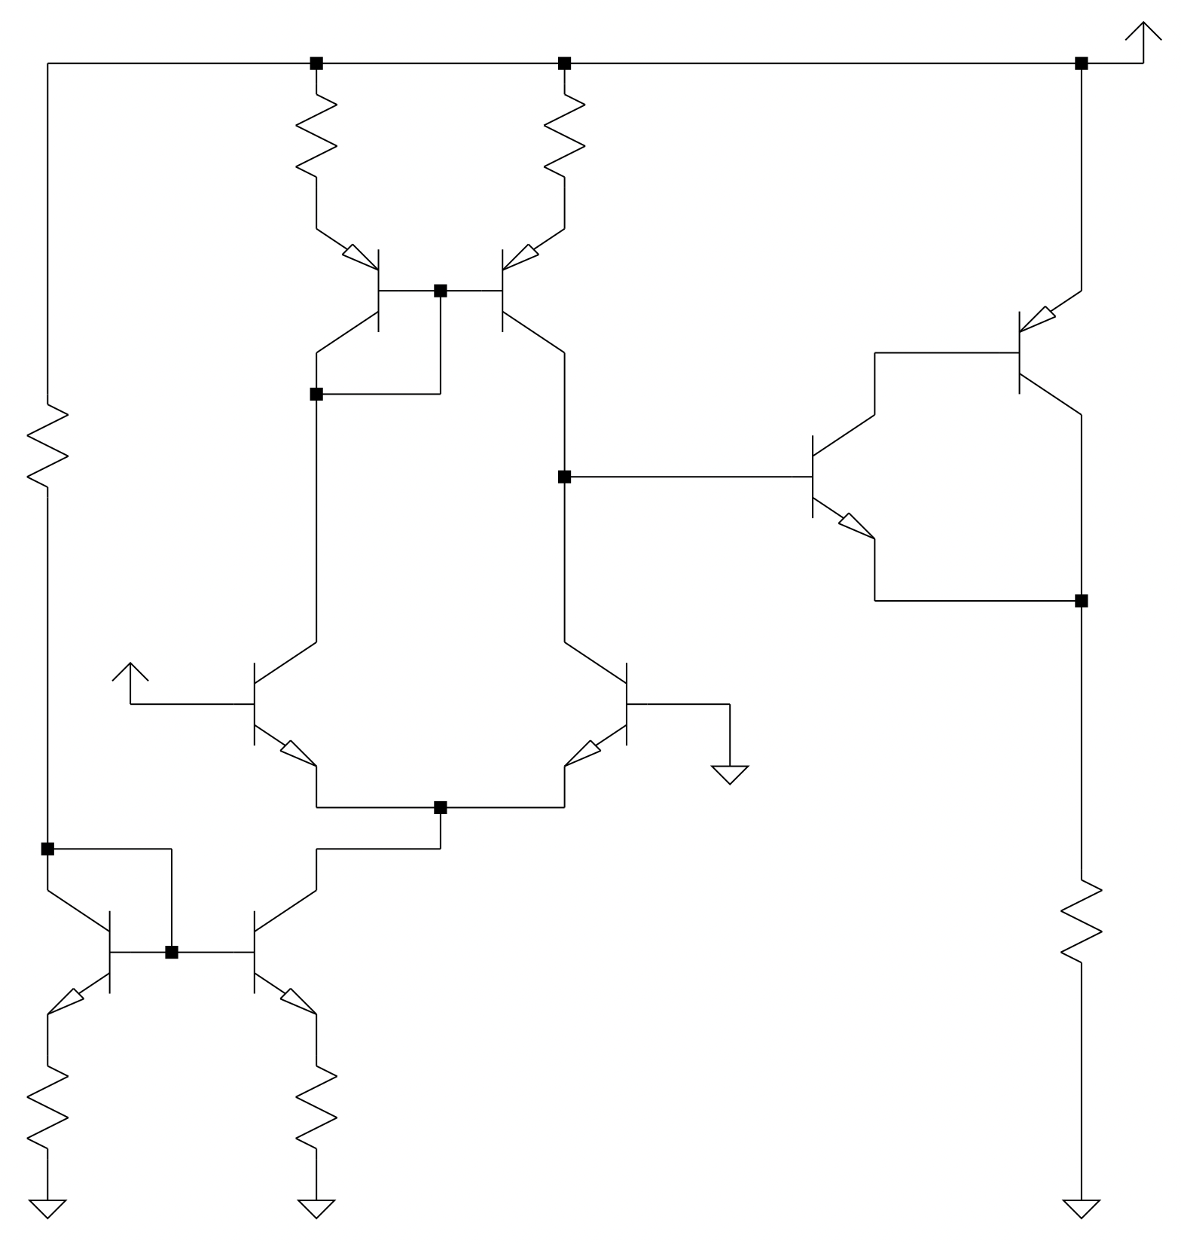
[picture p154: figure]

R_(E_3)

R_(E_4)

V_(REG)

T_3

T_4

T_6

R

T_5

V_(ref)

T_1

T_2

T_7

T_8

R_L

V_O

R_(E_7)

R_(E_8)

## Slide 6

V_(REG)

a

V_(ref)

R_L

V_O

f

## Slide 7

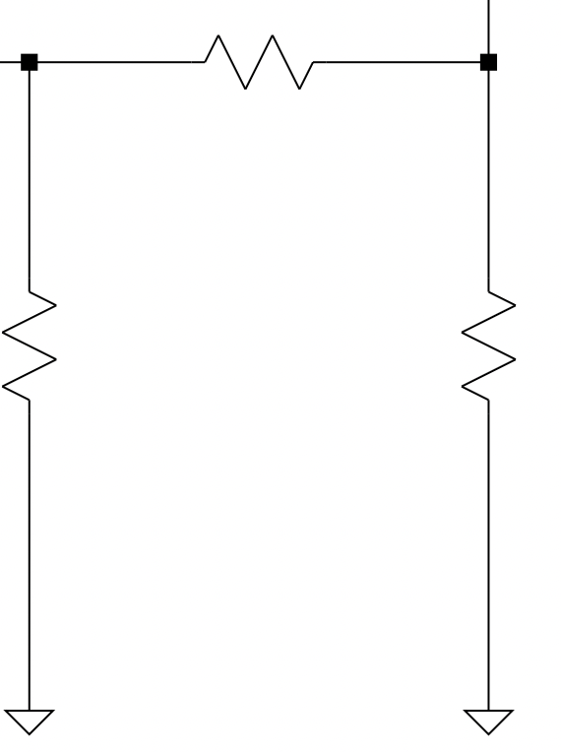
[picture p155: figure]

R_1

R_2

R_L

## Slide 8

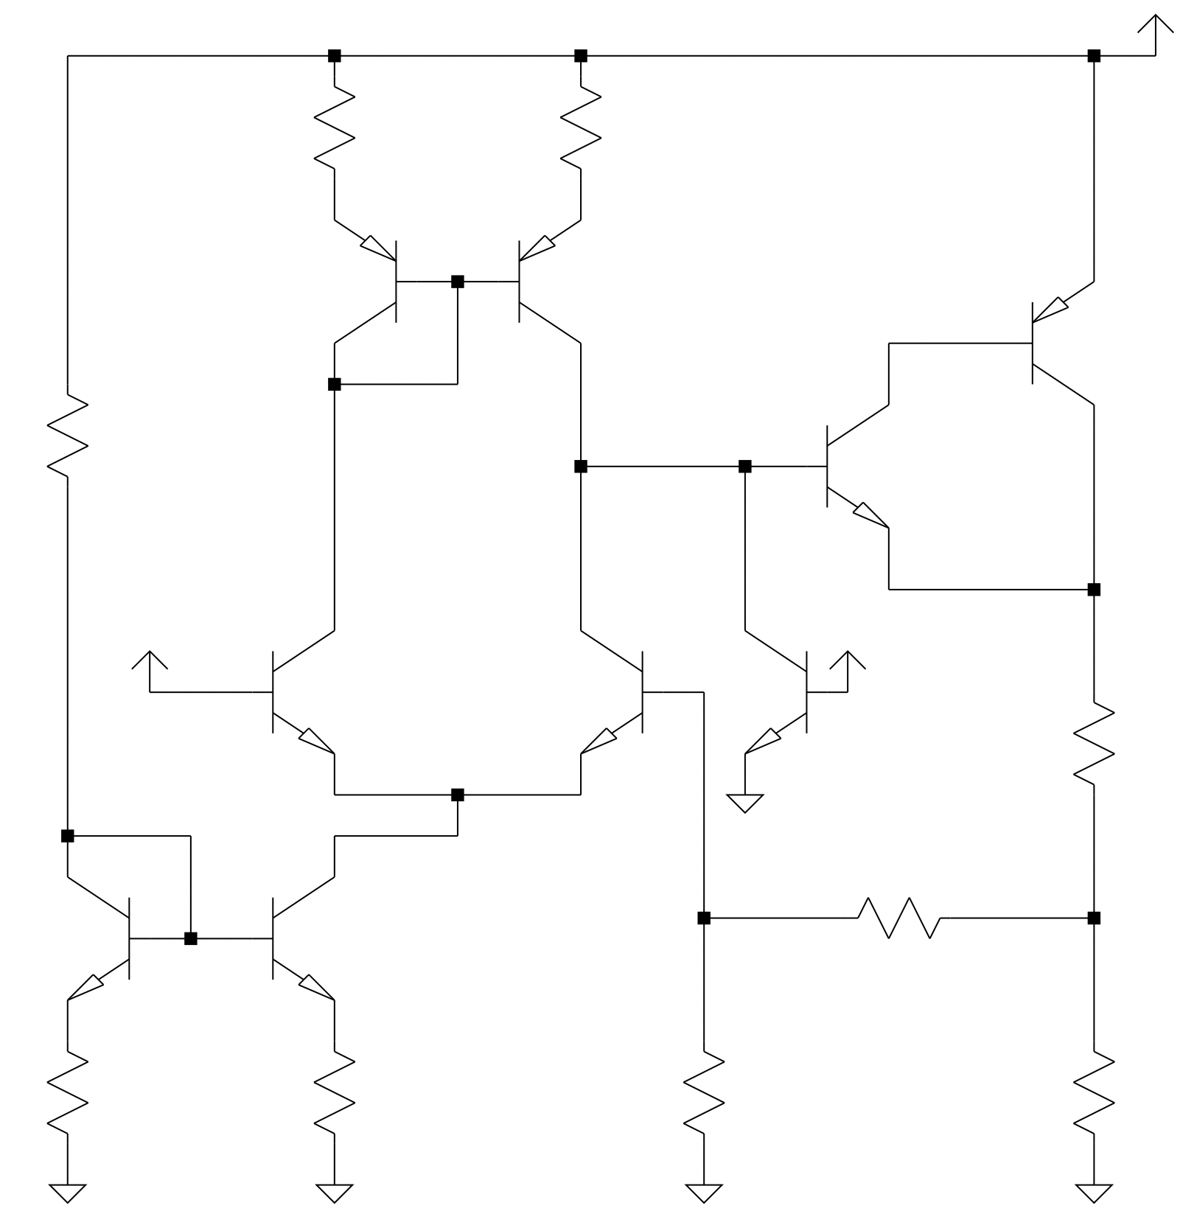
[picture p156: figure]

R_(E_3)

R_(E_4)

V_(REG)

T_3

T_4

T_6

R

T_5

V_(ref)

V_f

T_1

T_2

T_(LC)

R_S

T_7

T_8

V_x

R_1

R_(E_7)

R_(E_8)

R_2

R_L

V_O

## Slide 9

V_(ref)

R_(ref)

R_f

V_(REG)

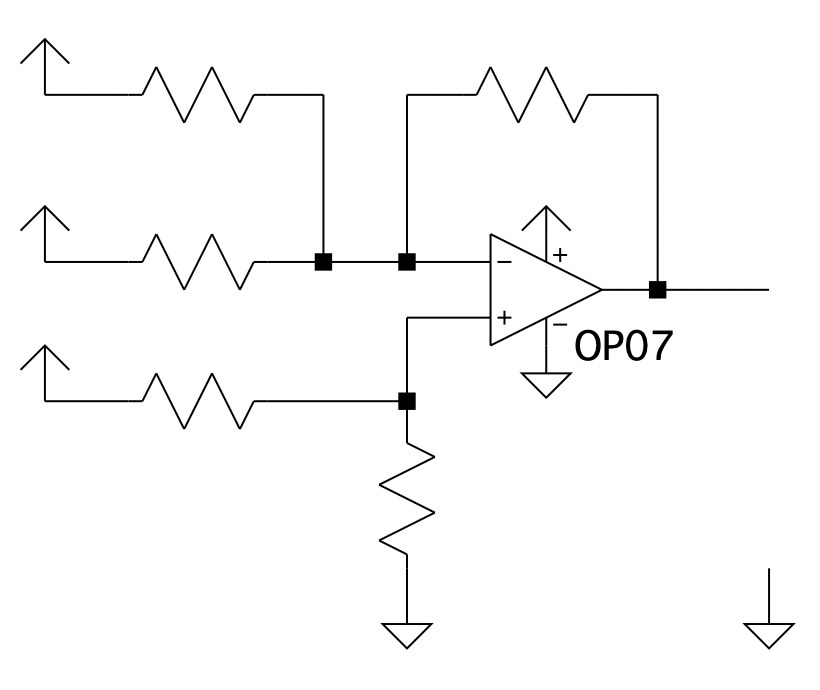
[picture p157: figure]

V_O

R_O

V_x

kR_x

V_f

R_x
