Fjmoya-uba/Taller-de-Circuitos-Grupo-4/Teóricas/-Realimentacion no ideal 2025 - versión 2_compressed.pdf

s
g

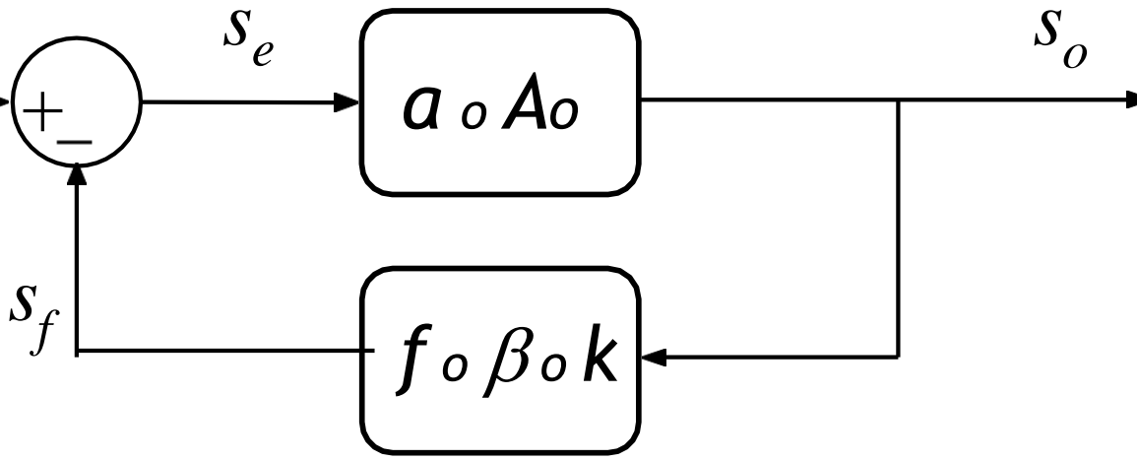
[picture p158: figure]

### Ganancia delsistema

# Si af >>1

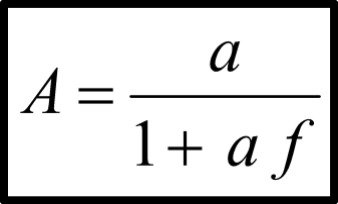
[picture p159: figure]

# ¿Cómo afecta la realimentación negativa?

## En reposo: contribuye a la estabilidad de Q

## En señal: tiende a un amplificador ideal según la transferencia sobre la que actúe

Av | Ai | Gm (Ym) | Rm (Zm)

## Siempre la respuesta del circuito es menos alineal

### T(ganancia de lazo)

# Realimentación negativa no ideal

La nomenclatura
depende la la
bibliografía

# Las cuatro formas de conexión:

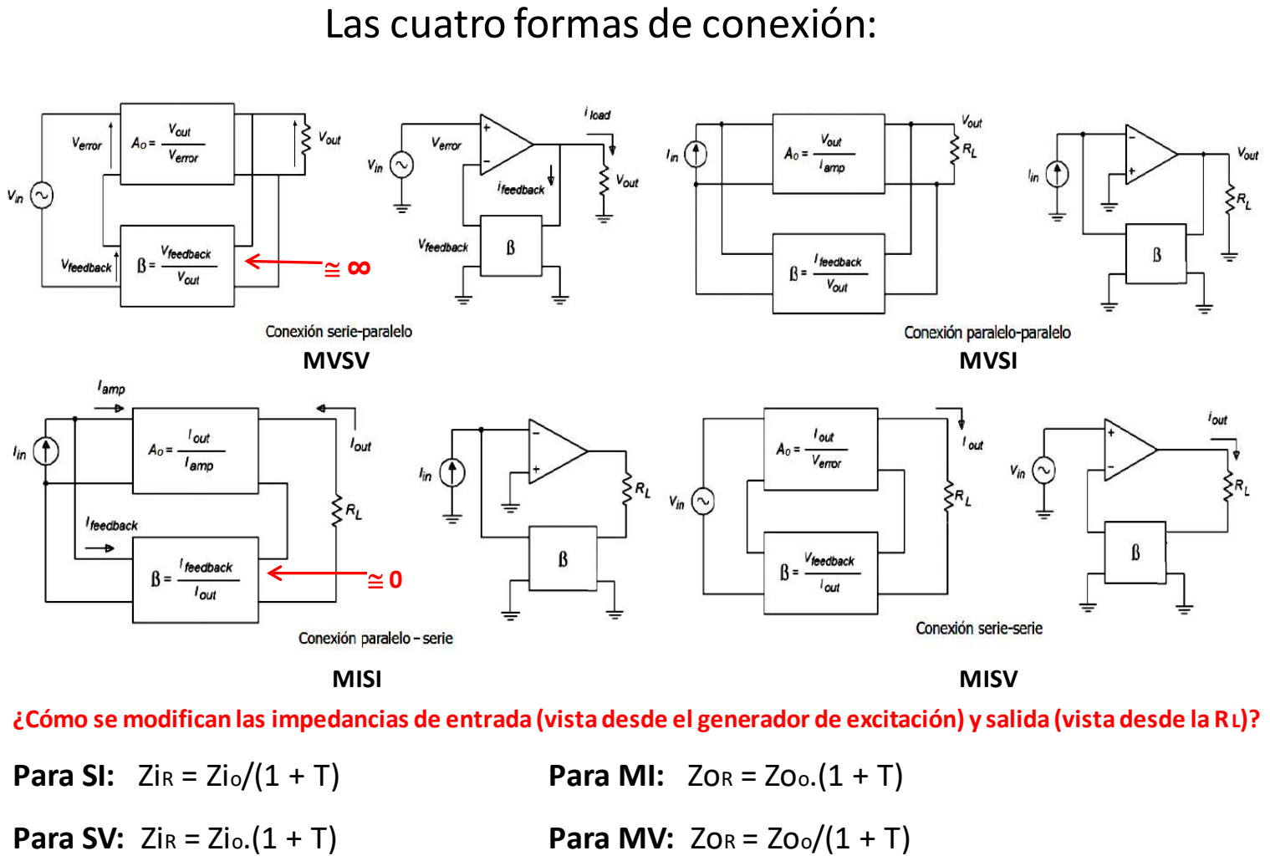
[picture p160: page 2]

MVSV | MVSI

≅ 0

MISI | MISV
¿Cómo se modifican las impedancias de entrada (vista desde el generador de excitación) y salida (vista desde la RL)?
Para SI: ZiR = Zio/(1 + T) | Para MI: ZoR = Zoo.(1 + T)
Para SV: ZiR = Zio.(1 + T) | Para MV: ZoR = Zoo/(1 + T)

≅ ∞

# Procedimiento conceptual para analizar una realimentación real:

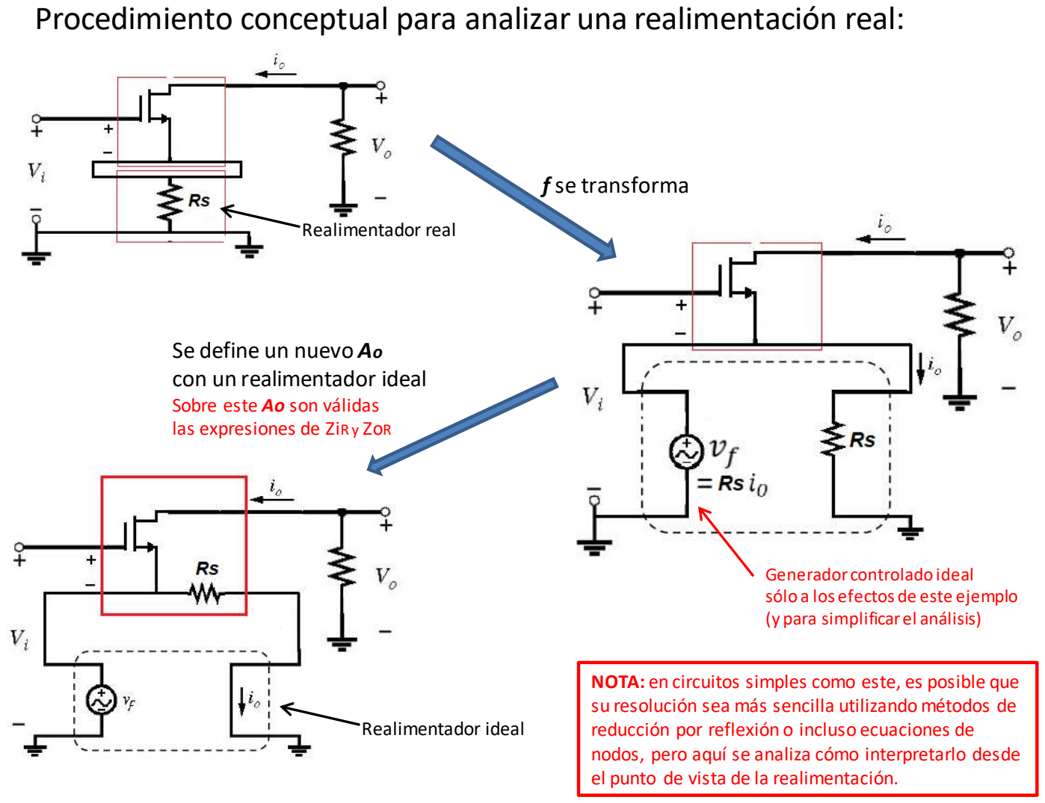
[picture p161: page 3]

Realimentador real

### f se transforma

### Se define un nuevo Ao con un realimentador ideal

Sobre este Ao son válidas
las expresiones de ZiR y ZoR

Realimentador ideal

Generador controlado ideal sólo a los efectos de este ejemplo (y para simplificar el análisis)

NOTA: en circuitos simples como este, es posible que su resolución sea más sencilla utilizando métodos de reducción por reflexión o incluso ecuaciones de nodos, pero aquí se analiza cómo interpretarlo desde el punto de vista de la realimentación.

# Otro ejemplo:

4

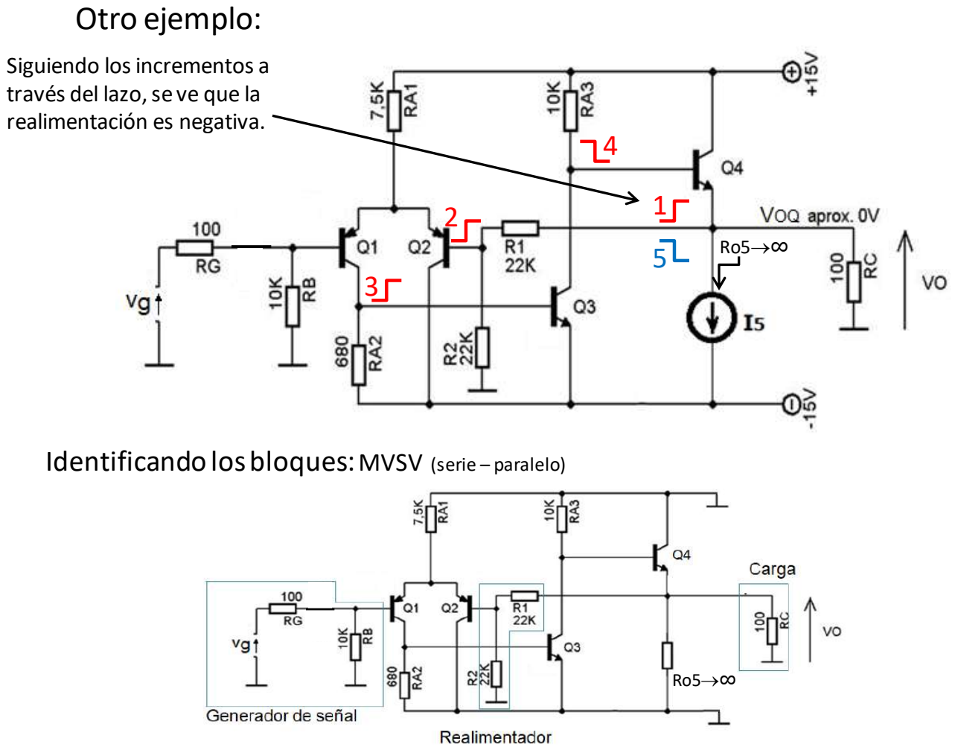
[picture p162: page 4]

Ro5→∞

1

5

2

3

### Siguiendo los incrementos a través del lazo, se ve que la

realimentación es negativa.

## Identificando los bloques: MVSV (serie – paralelo)

Ro5→∞

## Amplificador

# Y reemplazando el amplificador por su circuito simplificado:

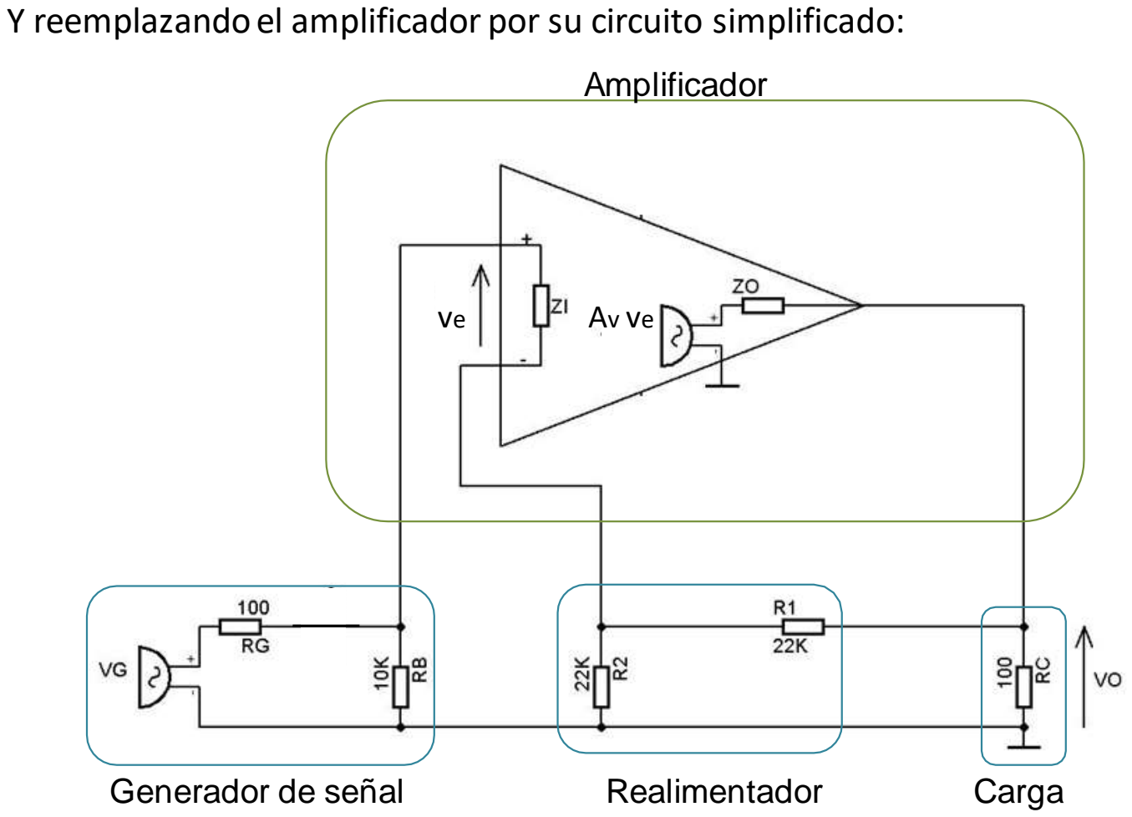
[picture p163: page 5]

Generador de señal | Realimentador | Carga
ve | Av ve

# Másreemplazos:

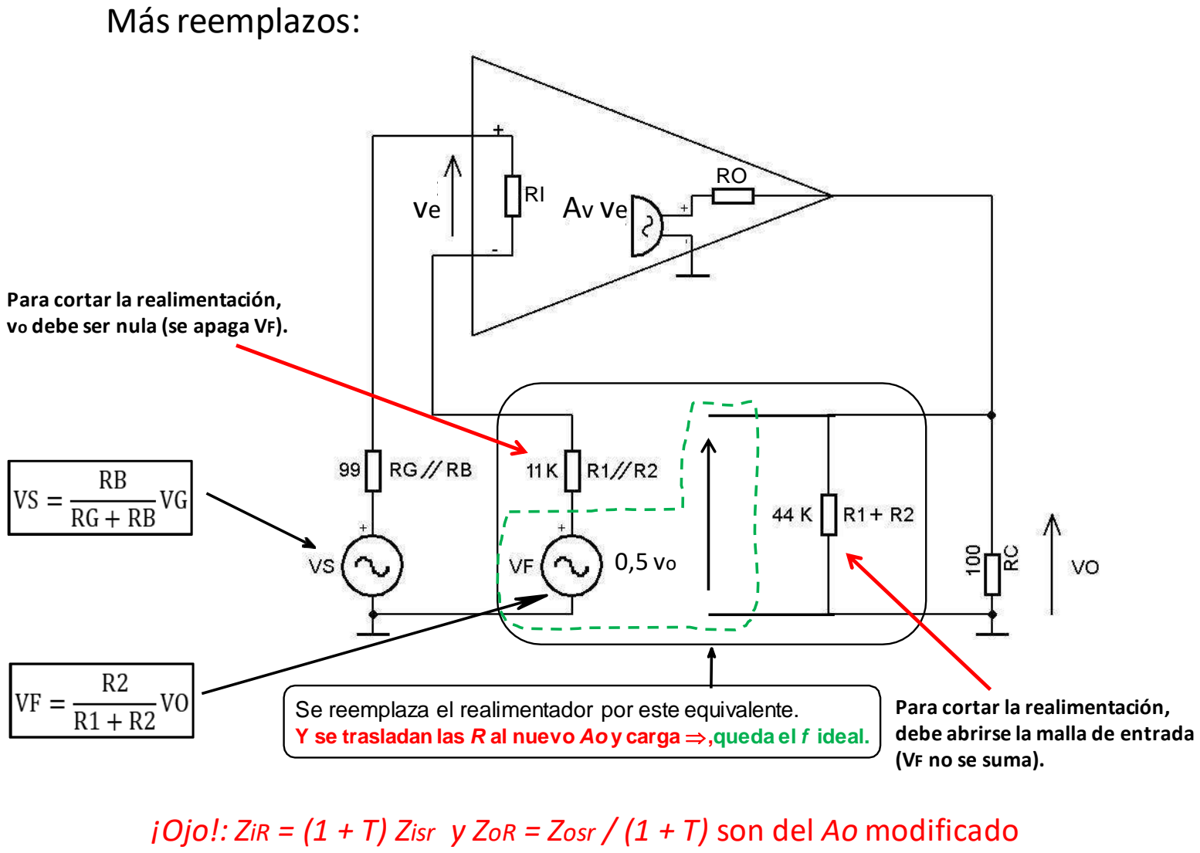
[picture p164: page 6]

Se reemplaza el realimentador por este equivalente.
Y se trasladan las R al nuevo Ao y carga Þ,queda el f ideal.

RO
RI
ve | Av ve

0,5 vo

Para cortar la realimentación, vo debe ser nula (se apaga VF).

Para cortar la realimentación, debe abrirse la malla de entrada (VF no se suma).

## ¡Ojo!: ZiR = (1 + T) Zisr y ZoR = Zosr / (1 + T) son del Ao modificado

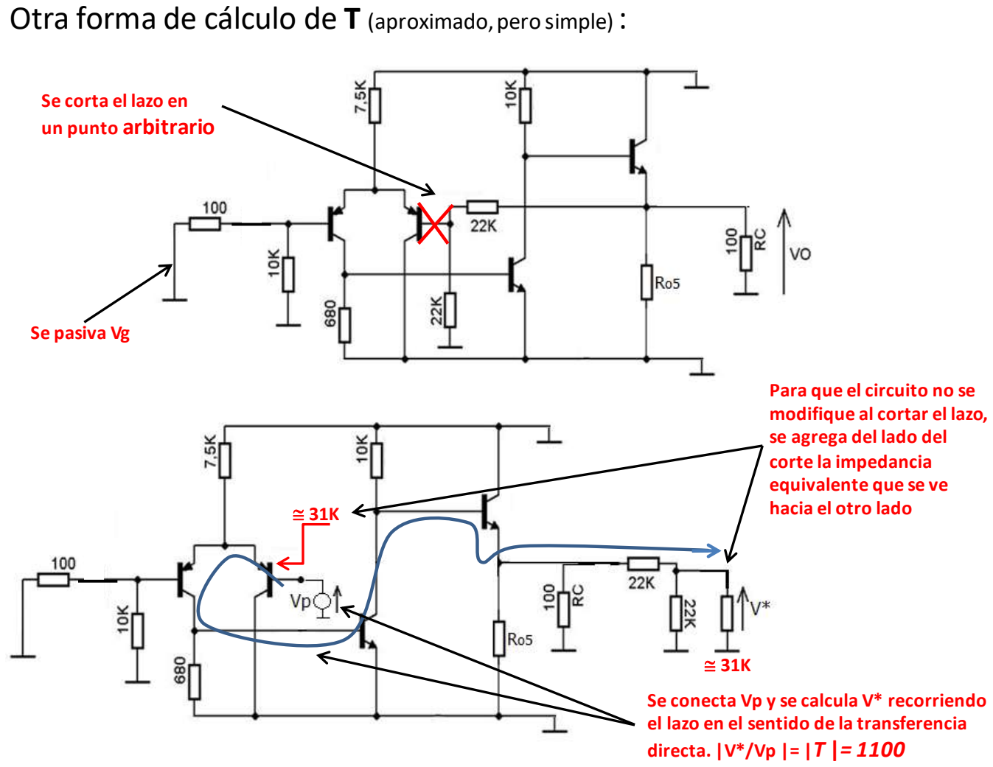
[picture p165: page 7]

Otra forma de cálculo de T (aproximado, pero simple) :

Se corta el lazo en

### un punto arbitrario

≅ 31K

≅ 31K

Para que el circuito no se modifique al cortar el lazo, se agrega del lado del
corte la impedancia
equivalente que se ve
hacia el otro lado

Se conecta Vp y se calcula V* recorriendo el lazo en el sentido de la transferencia directa. |V*/Vp |= |T |= 1100

Se pasiva Vg

# Otro ejemplo:

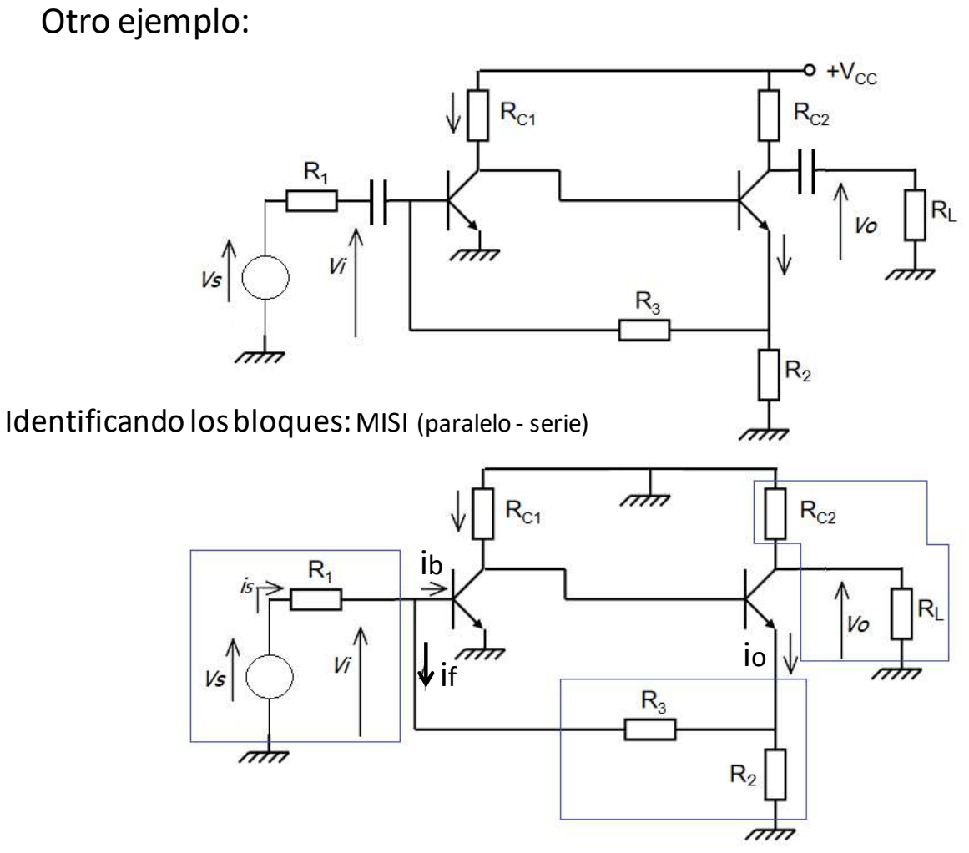
[picture p166: page 8]

## Identificando los bloques: MISI (paralelo - serie)

io

ib

if

## Reordenando las impedancias del circuito a partir del equivalente del realimentador:

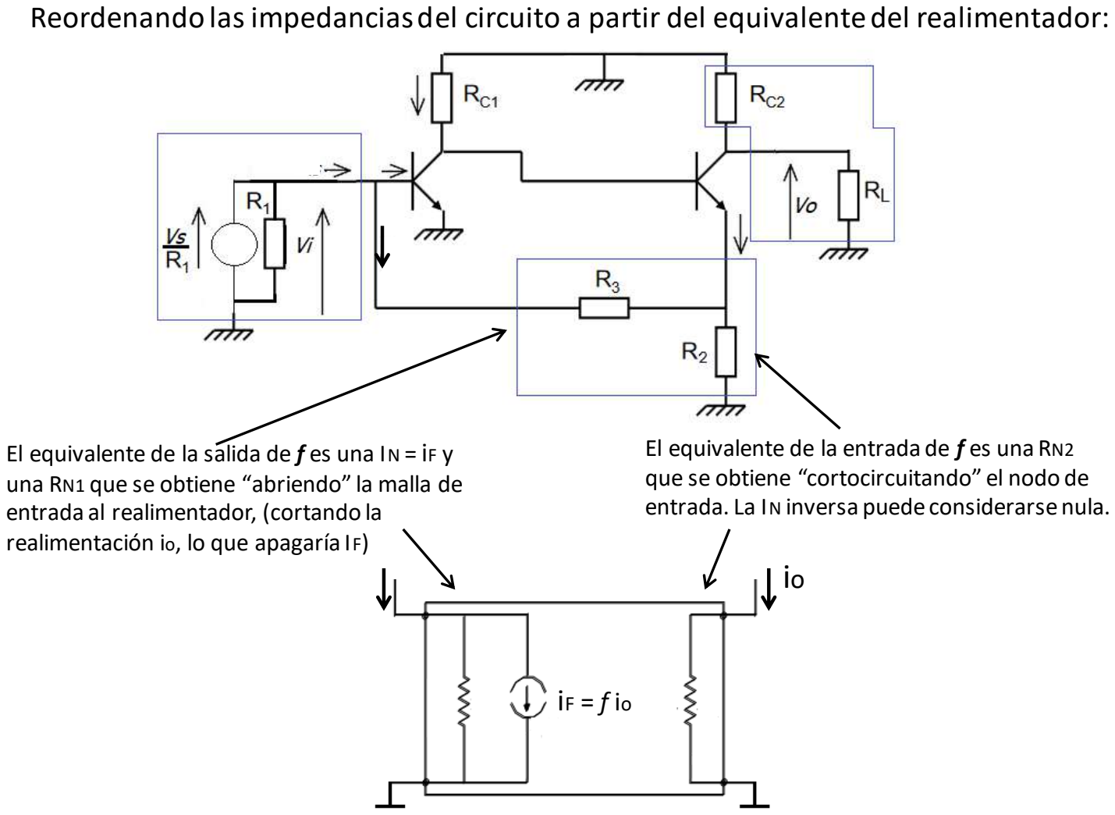
[picture p167: page 9]

### El equivalente de la salida de f es una IN = iF y una RN1 que se obtiene “abriendo” la malla de

entrada al realimentador, (cortando la realimentación io, lo que apagaría IF)

### El equivalente de la entrada de f es una RN2 que se obtiene “cortocircuitando” el nodo de

entrada. La IN inversa puede considerarse nula.

## iF = f io

io

# ¿Cómo se puede estimar el valor de T por simulación?

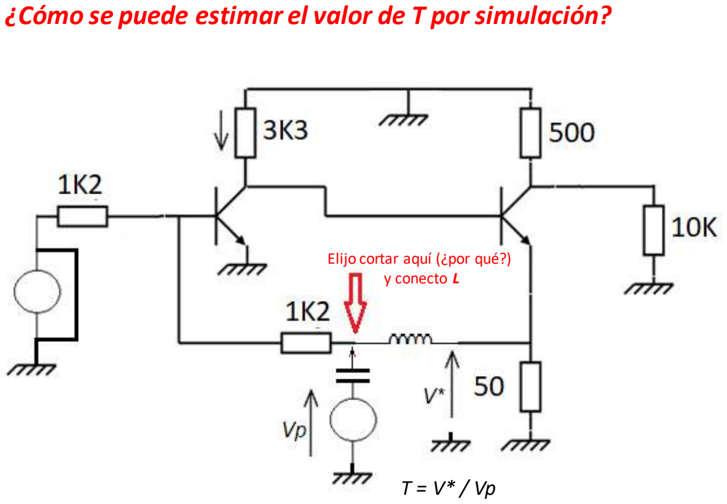
[picture p168: page 10]

Elijo cortar aquí (¿por qué?) y conecto L

## T = V* / Vp

# Otro ejemplo:

### Datos:

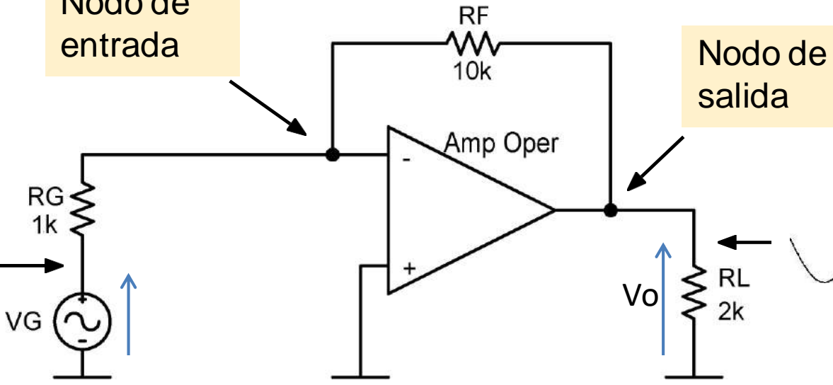
[picture p169: figure]
entrada; Nodo de; salida

### Ganancia del opamp. = 100000

Impedancia de entrada del opamp.= 1MΩ Impedancia de salida del opamp.= 100Ω

## Muestreo ¿? Suma ¿? (definir los bloques)

¿T?

## ¿circuito “a”?

¿f?
¿vo

/vG

?

## ¿impedancias de entrada y de salida?

## Nodo de

# Otro ejemplo:

+

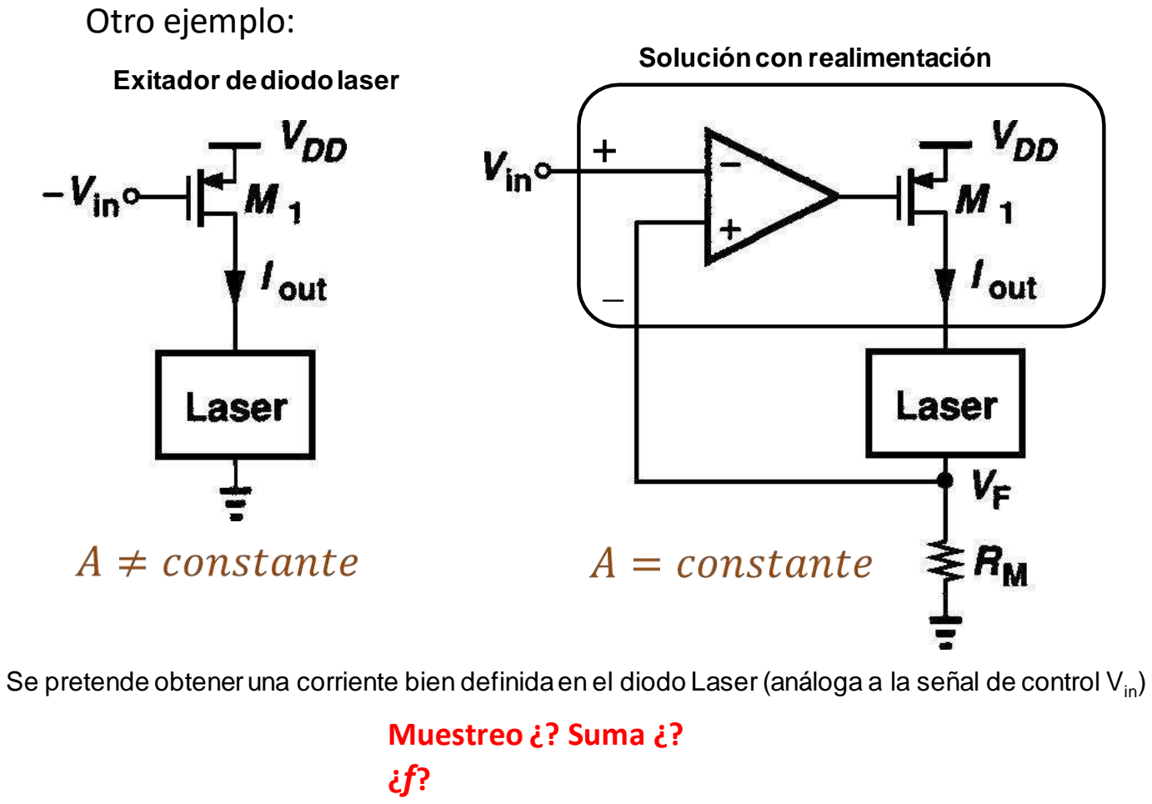
[picture p170: page 12]

_

Exitador dediodolaser

Se pretende obtener una corriente bien definida en el diodo Laser (análoga a la señal de control Vin)

Solucióncon realimentación

## Muestreo ¿? Suma ¿?

¿f?

# Otro ejemplo (difícil de ver):

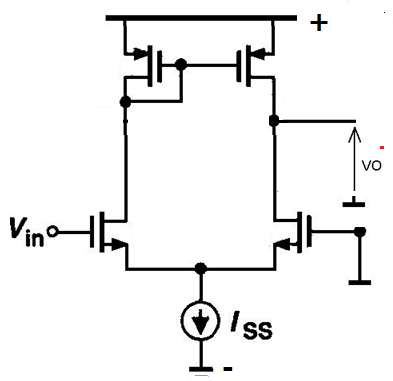
[picture p171: figure]

## A los efectos de balancear ambas ramas del par diferencial:

## Muestreo ¿? Suma ¿?

## ¿bloque f?

# Y un ejemplo más:

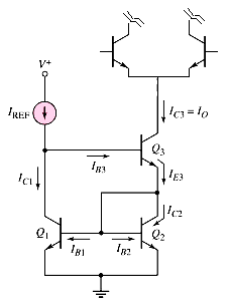
[picture p172: figure]

## A los efectos de mantener estable la corriente Io de la fuente Wilson:

## Muestreo ¿? Suma ¿?

## ¿bloque f? ¿bloque Ao? ¿carga?

## Bibliografía recomendada:

- Capítulo 8 “Realimentación” del libro Análisis y diseño de Circuitos Integrados,

### autores Gray-Meyer-Hurst-Lewis:

### - Capítulo 8 “Retroalimentación” del libro Circuitos Microelectrónicos, autores Sedra y Smith

### - Capítulo 10 “Amplificadores Retroalimentados” del libro Circuitos Microelectrónicos / Análisis y Diseño, autor Rashid
