Fjmoya-uba/Taller-de-Circuitos-Grupo-4/Checkpoint 3/KiCad/Imagen_cabrita.png

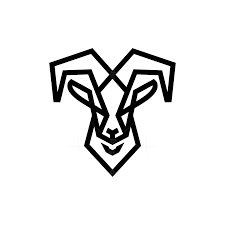
Checkpoint 3/KiCad/Imagen_cabrita.png
