Fjmoya-uba/Taller-de-Circuitos-Grupo-4/Datasheets/Checkpoint3/LM358_3.png

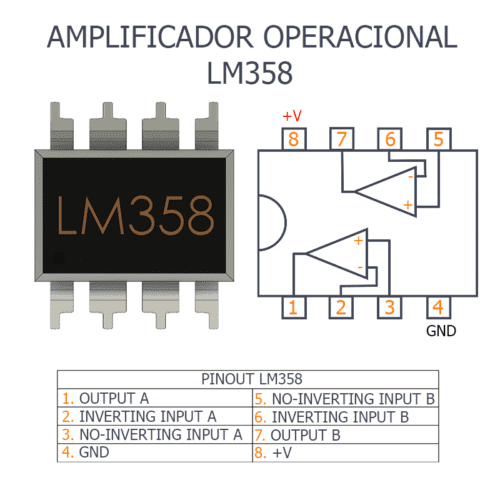
Datasheets/Checkpoint3/LM358_3.png
