Fjmoya-uba/Taller-de-Circuitos-Grupo-4/Checkpoint 3/KiCad/Diseño_v4/SHOPPING_LIST.md

# 📋 Lista de Compra - Taller de Circuitos Grupo 5

## Capacitores / Condensadores
| Valor | Cantidad | Notas |
|---|---|---|
| 330nF | 1 | Disco D5.0mm |
| 100nF (0.1µF) | 1 | Disco D5.0mm |

**Total Capacitores: 2 unidades**

---

## Resistencias / Resistores
| Valor | Cantidad | Empaque | Notas |
|---|---|---|---|
| 22 Ω | 1 | Axial DIN0207 | |
| 100 Ω | 4 | Axial DIN0207 | RE1, RE2, RE3, RE4 |
| 150 Ω | 1 | Axial DIN0207 | Ro1 |
| 680 Ω | 1 | Axial DIN0207 | R1 |
| 1.2 kΩ | 1 | Axial DIN0207 | Rref1 |
| 1.8 Ω | 1 | Axial DIN0414 | RS1 (resistencia de potencia) |
| 2.2 Ω | 1 | Axial DIN0414 | RS2 (resistencia de potencia) |
| 3.9 kΩ | 1 | Axial DIN0207 | Rx2 |
| 4.7 kΩ | 1 | Axial DIN0207 | R2 |
| 10 kΩ | 3 | Axial DIN0207 | R3, R4, Rx1 |
| 10 kΩ | 1 | Axial DIN0207 | Rf1 (vertical) |
| 1 MΩ | 2 | Axial DIN0207 | R5, R6 |

**Total Resistencias: 17 unidades**

---

## Transistores / Semiconductores Discretos
| Componente | Tipo | Cantidad | Empaque |
|---|---|---|---|
| BC547 | BJT NPN | 6 | TO-92 |
| BC557 | BJT PNP | 2 | TO-92 |
| TIP32A | BJT PNP Potencia | 1 | TO-220 |
| TL431LP | Regulador Shunt | 1 | TO-92 |

**Total Transistores: 10 unidades**

---

## Circuitos Integrados
| Componente | Tipo | Cantidad | Empaque |
|---|---|---|---|
| LM358 | Amplificador Operacional | 1 | DIP-8 |

**Total ICs: 1 unidad**

---

## Conectores y Headers
| Descripción | Cantidad | Tipo | Aplicación |
|---|---|---|---|
| Header 1x1 vertical | 13 | PinHeader 2.54mm | Puntos de prueba/entrada (Gen_In, TP_GND, etc.) |
| Terminal Block 2P | 2 | MaiXu MX126-5.0 | Conectores J1, J2 (entrada) |
| Test Point 2 pads | 3 | Pitch 2.54mm | J_FC1, J_LT1, J_Vref1 |

**Total Conectores: 18 unidades**

---

## 📊 Resumen General

| Categoría | Cantidad |
|---|---|
| **Capacitores** | 2 |
| **Resistencias** | 17 |
| **Transistores** | 10 |
| **Circuitos Integrados** | 1 |
| **Conectores/Headers** | 18 |
| **TOTAL COMPONENTES** | **48** |

---

## ✅ Notas de Compra

- Las **resistencias de potencia** (1.8Ω y 2.2Ω) son de mayor tamaño (DIN0414) y potencia
- El **TIP32A** es un transistor de potencia en empaque TO-220 (requiere disipador potencial)
- Hay **13 headers de 1 pin** para puntos de prueba (considera comprar por cantidad o en cinta)
- El **LM358** es un op-amp dual muy común y económico
- Los transistores están divididos: 6x BC547 (NPN), 2x BC557 (PNP), 1x TIP32A (PNP potencia)
