Fjmoya-uba/Taller-de-Circuitos-Grupo-4/Checkpoint 4/cuentas.pdf

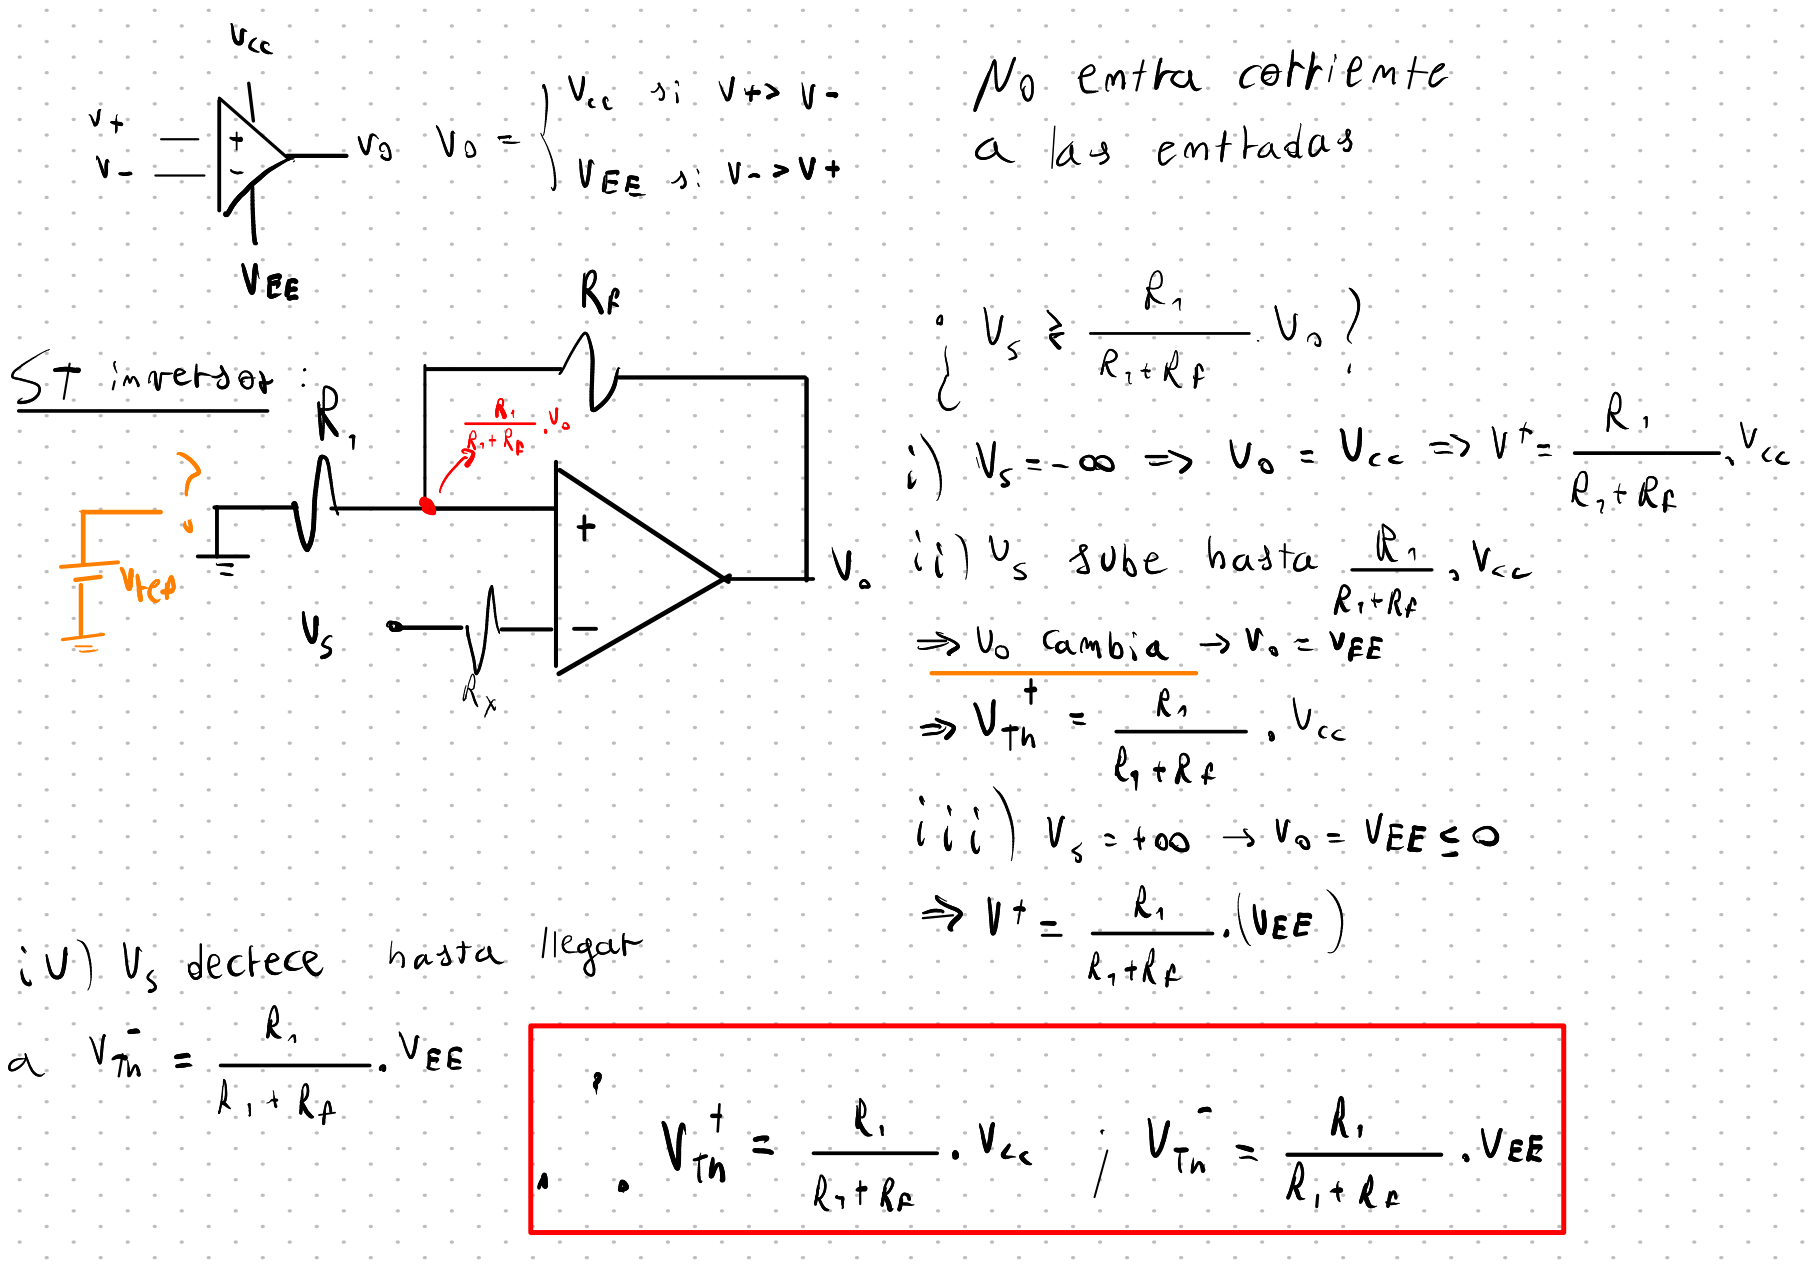
[picture p175: page 1]

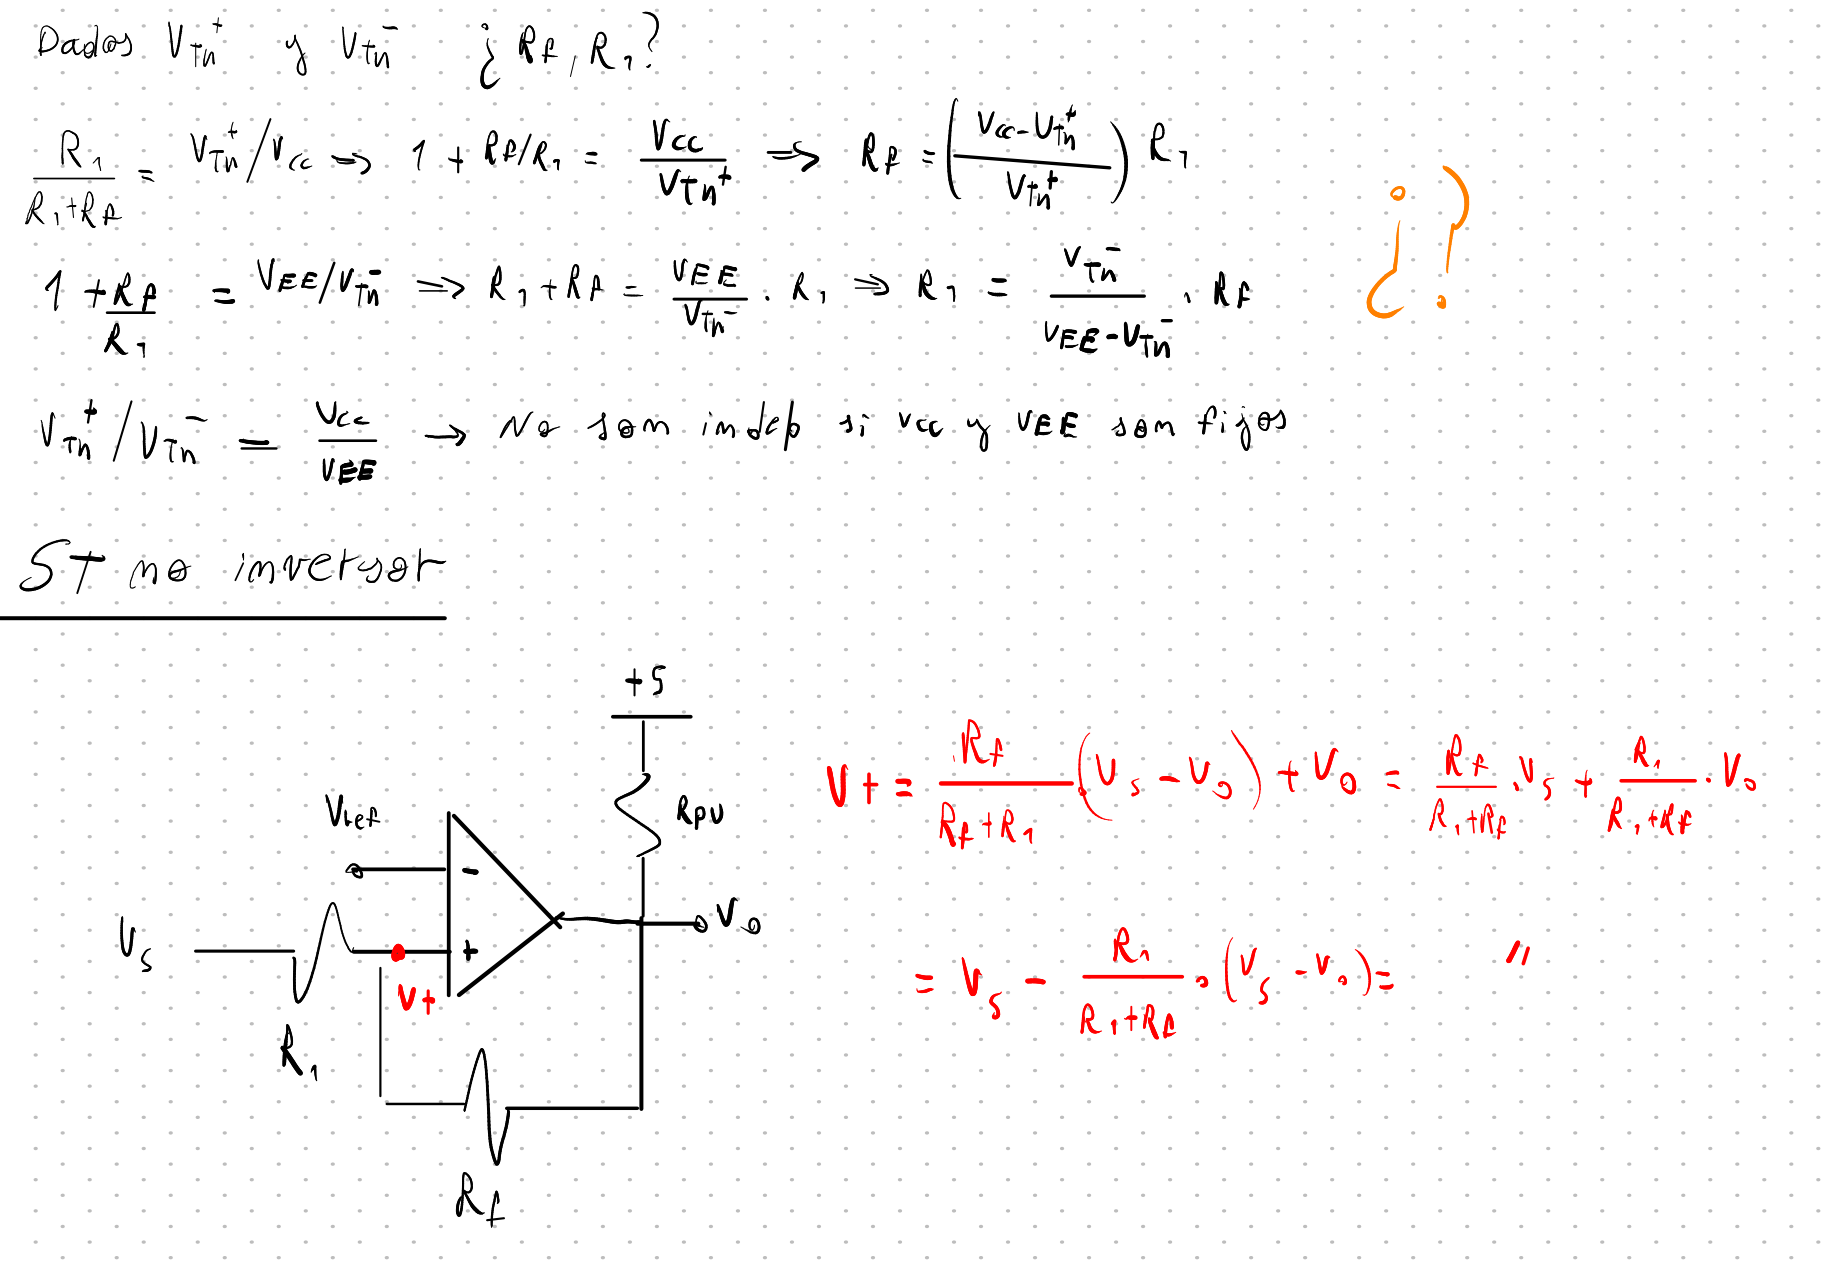
[picture p176: page 2]

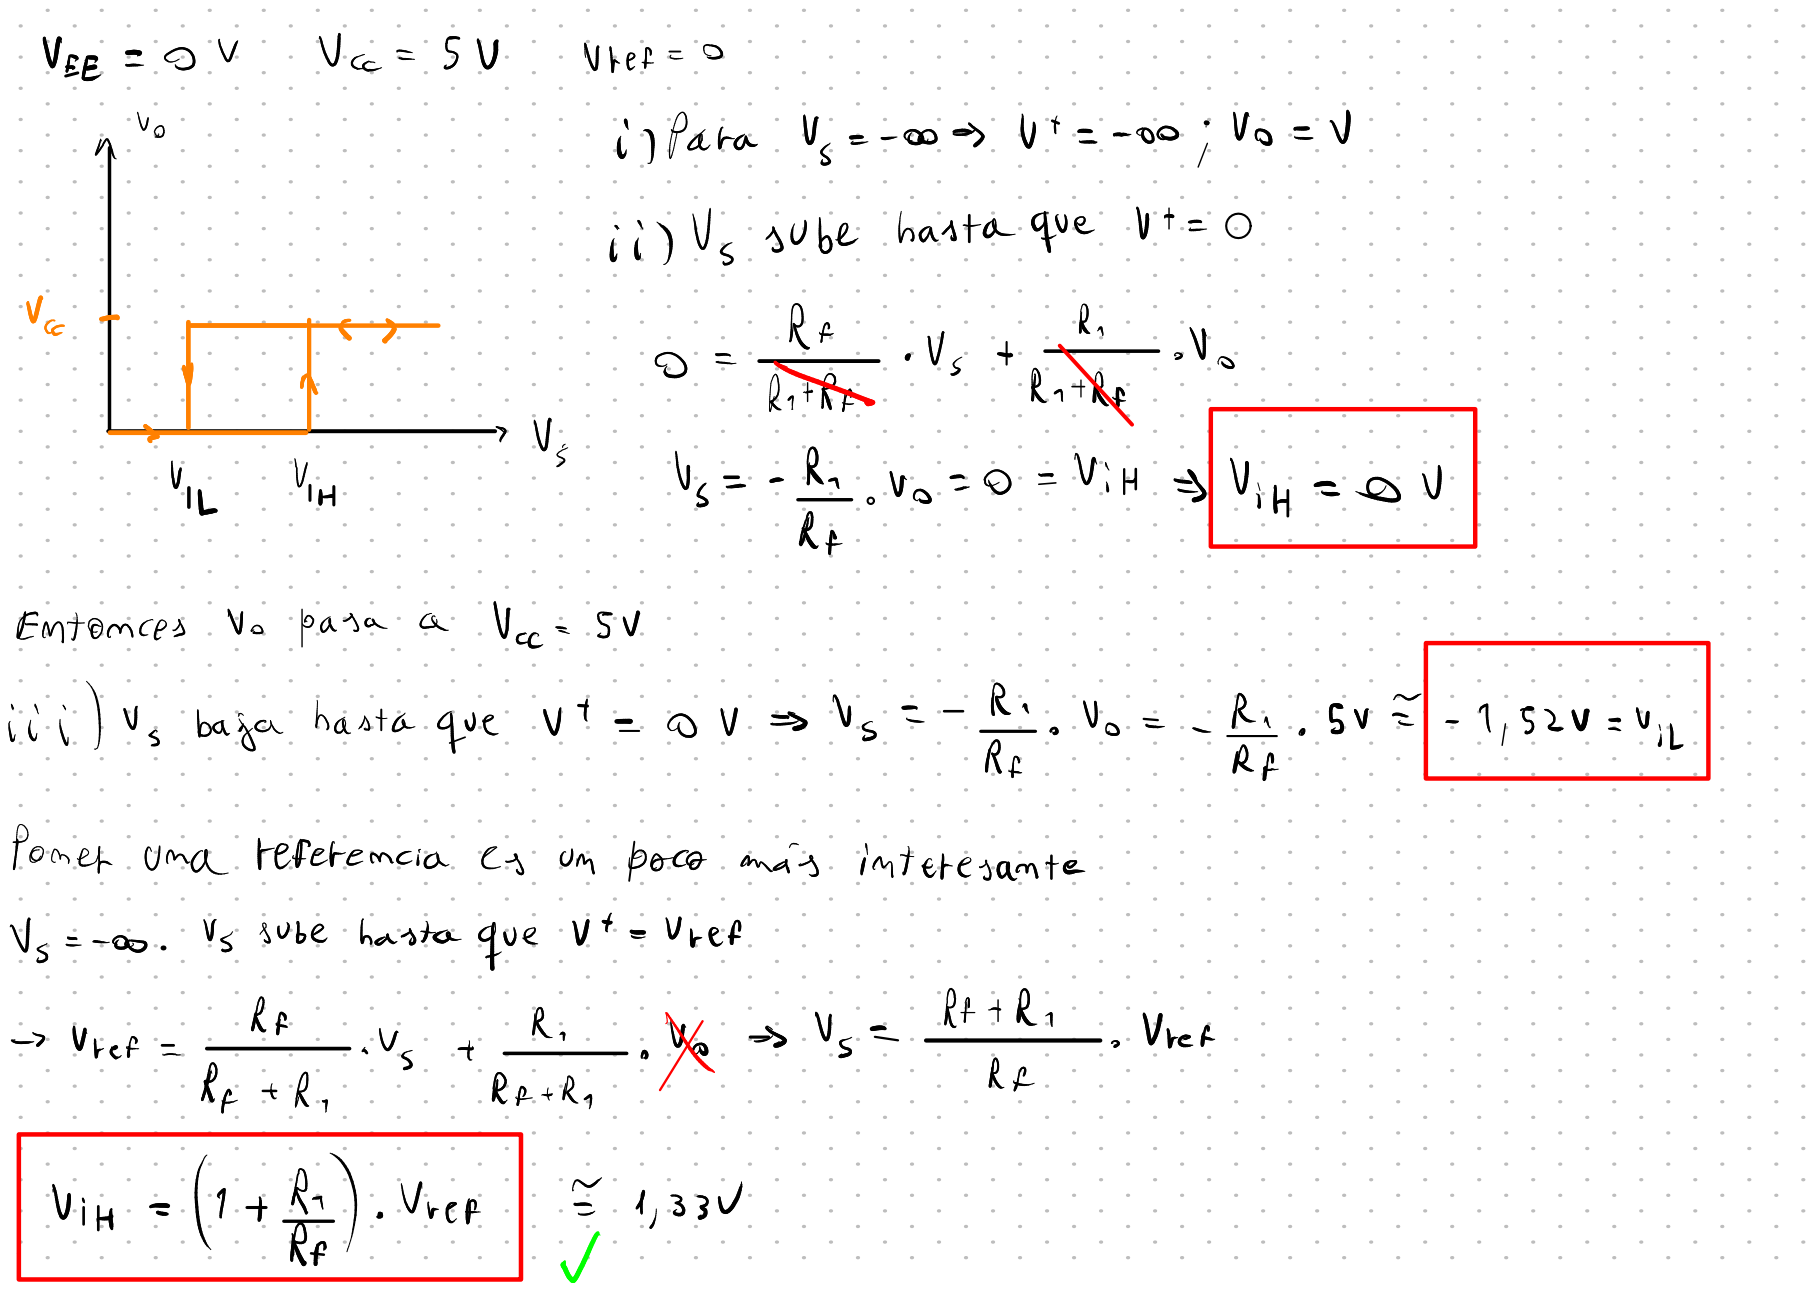
[picture p177: page 3]

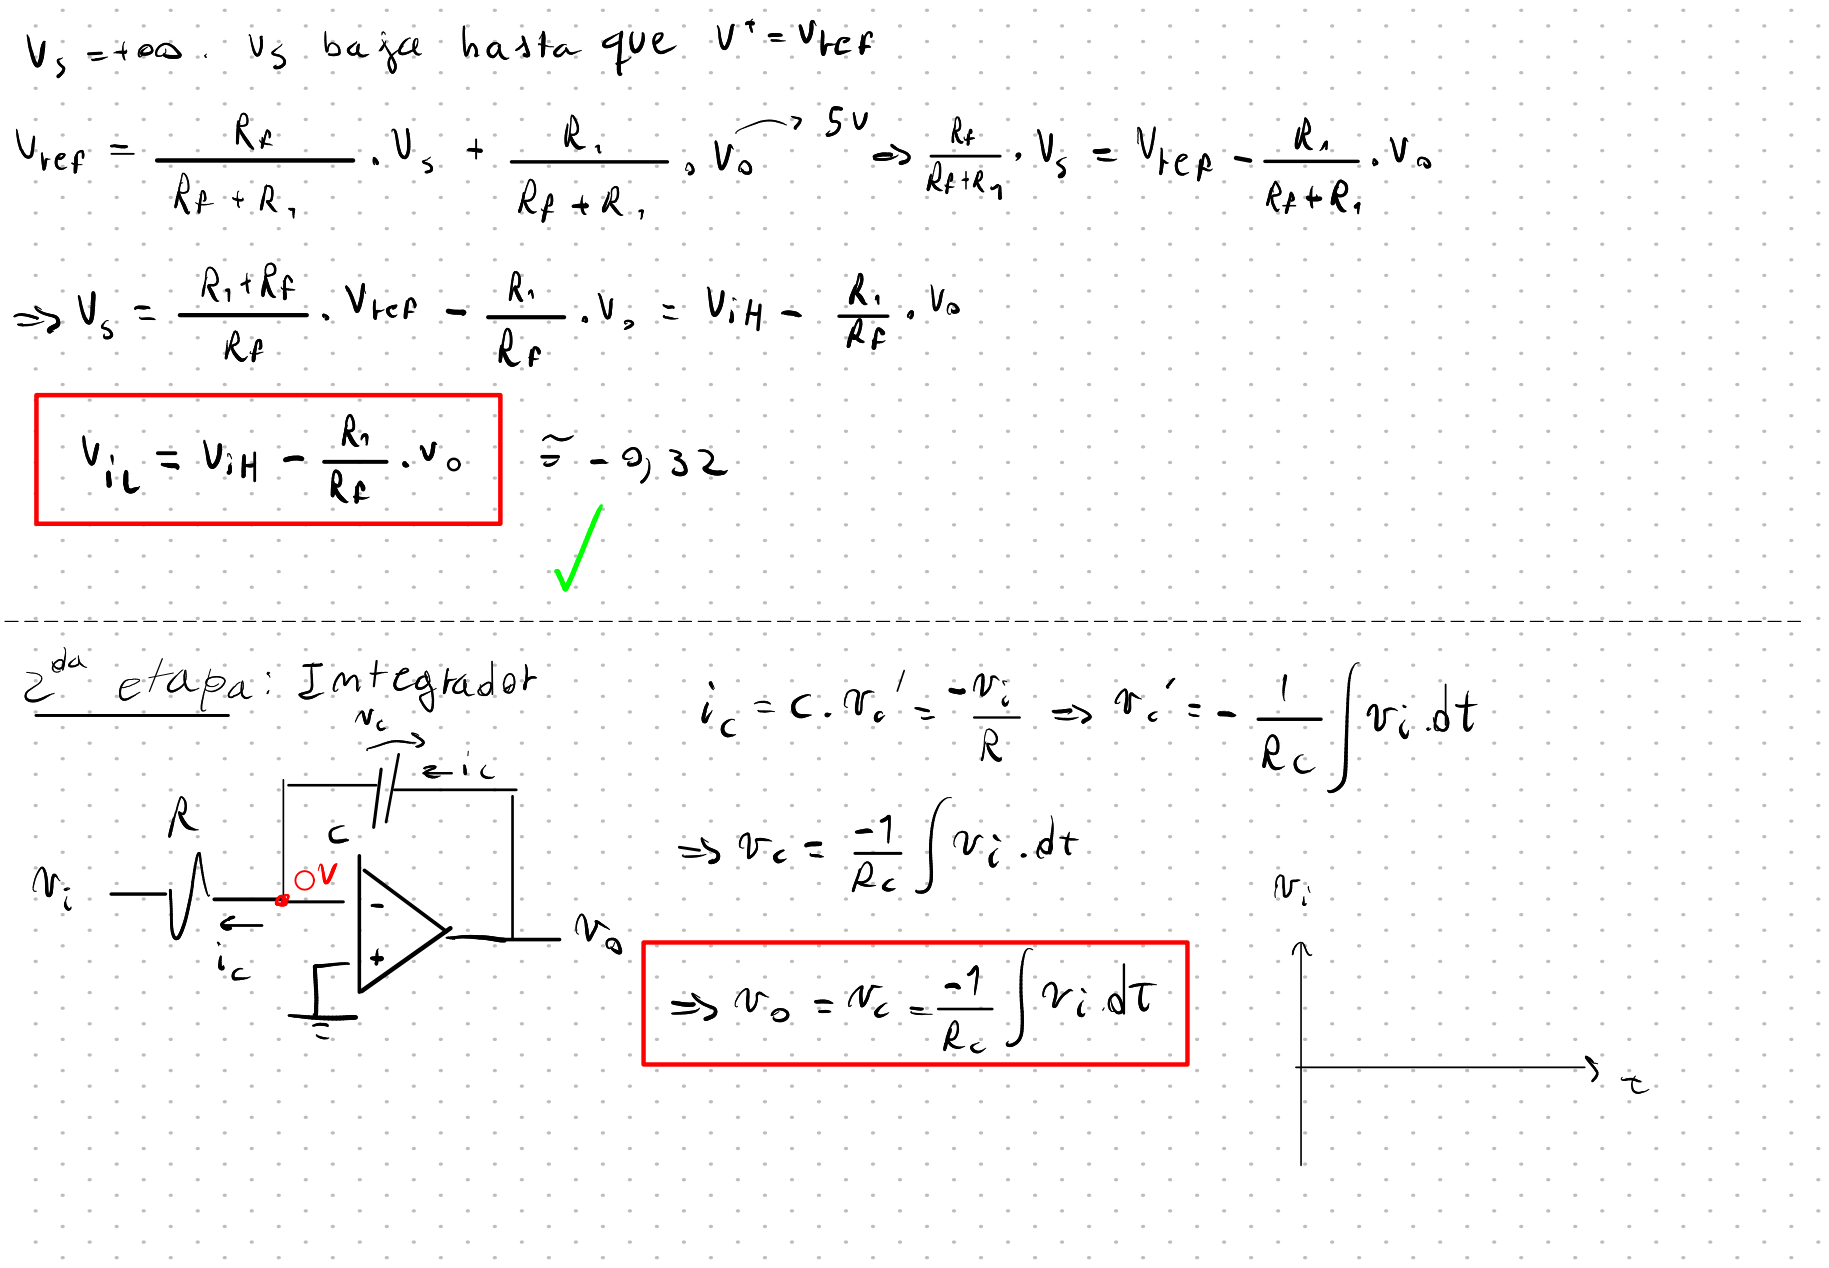
[picture p178: page 4]

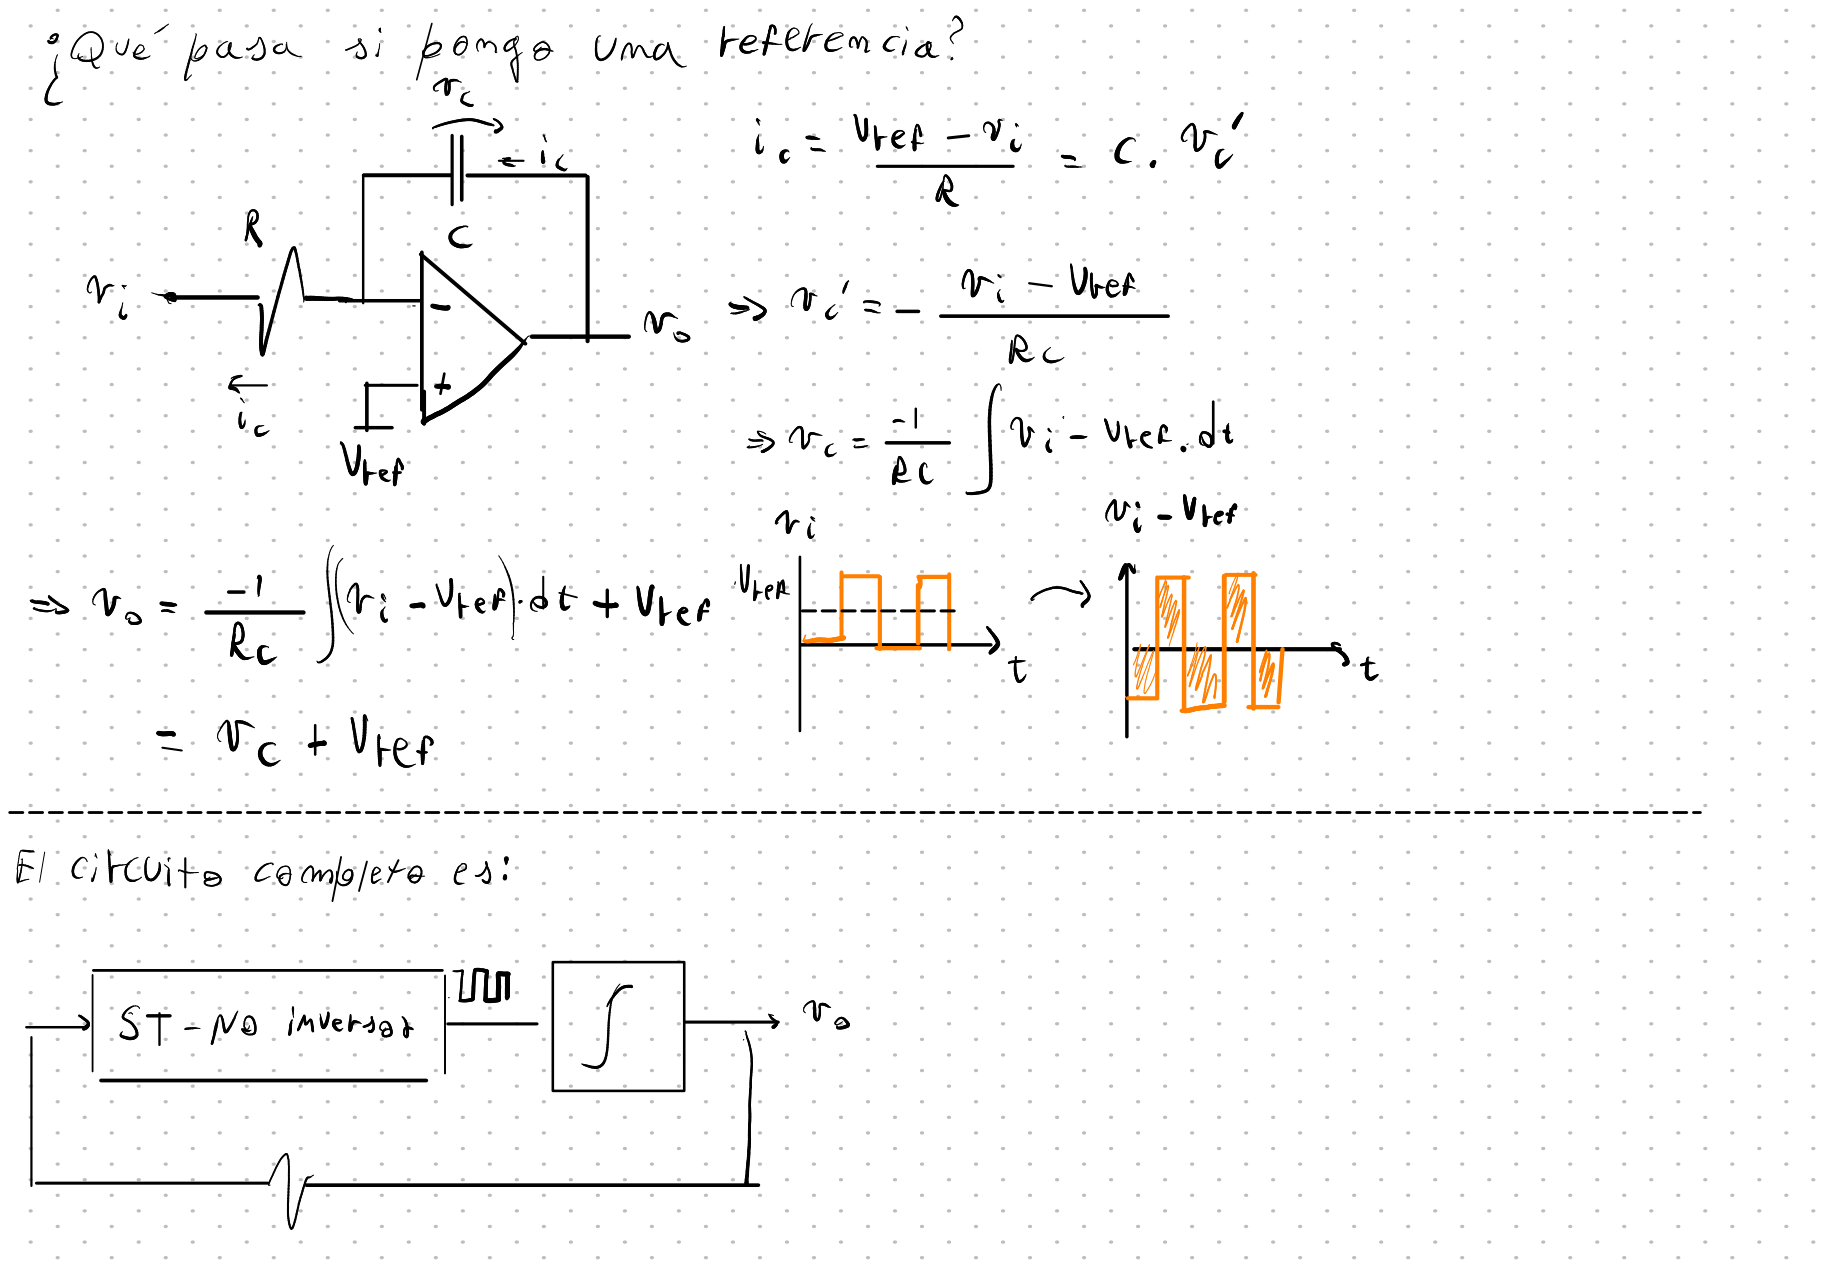
[picture p179: page 5]

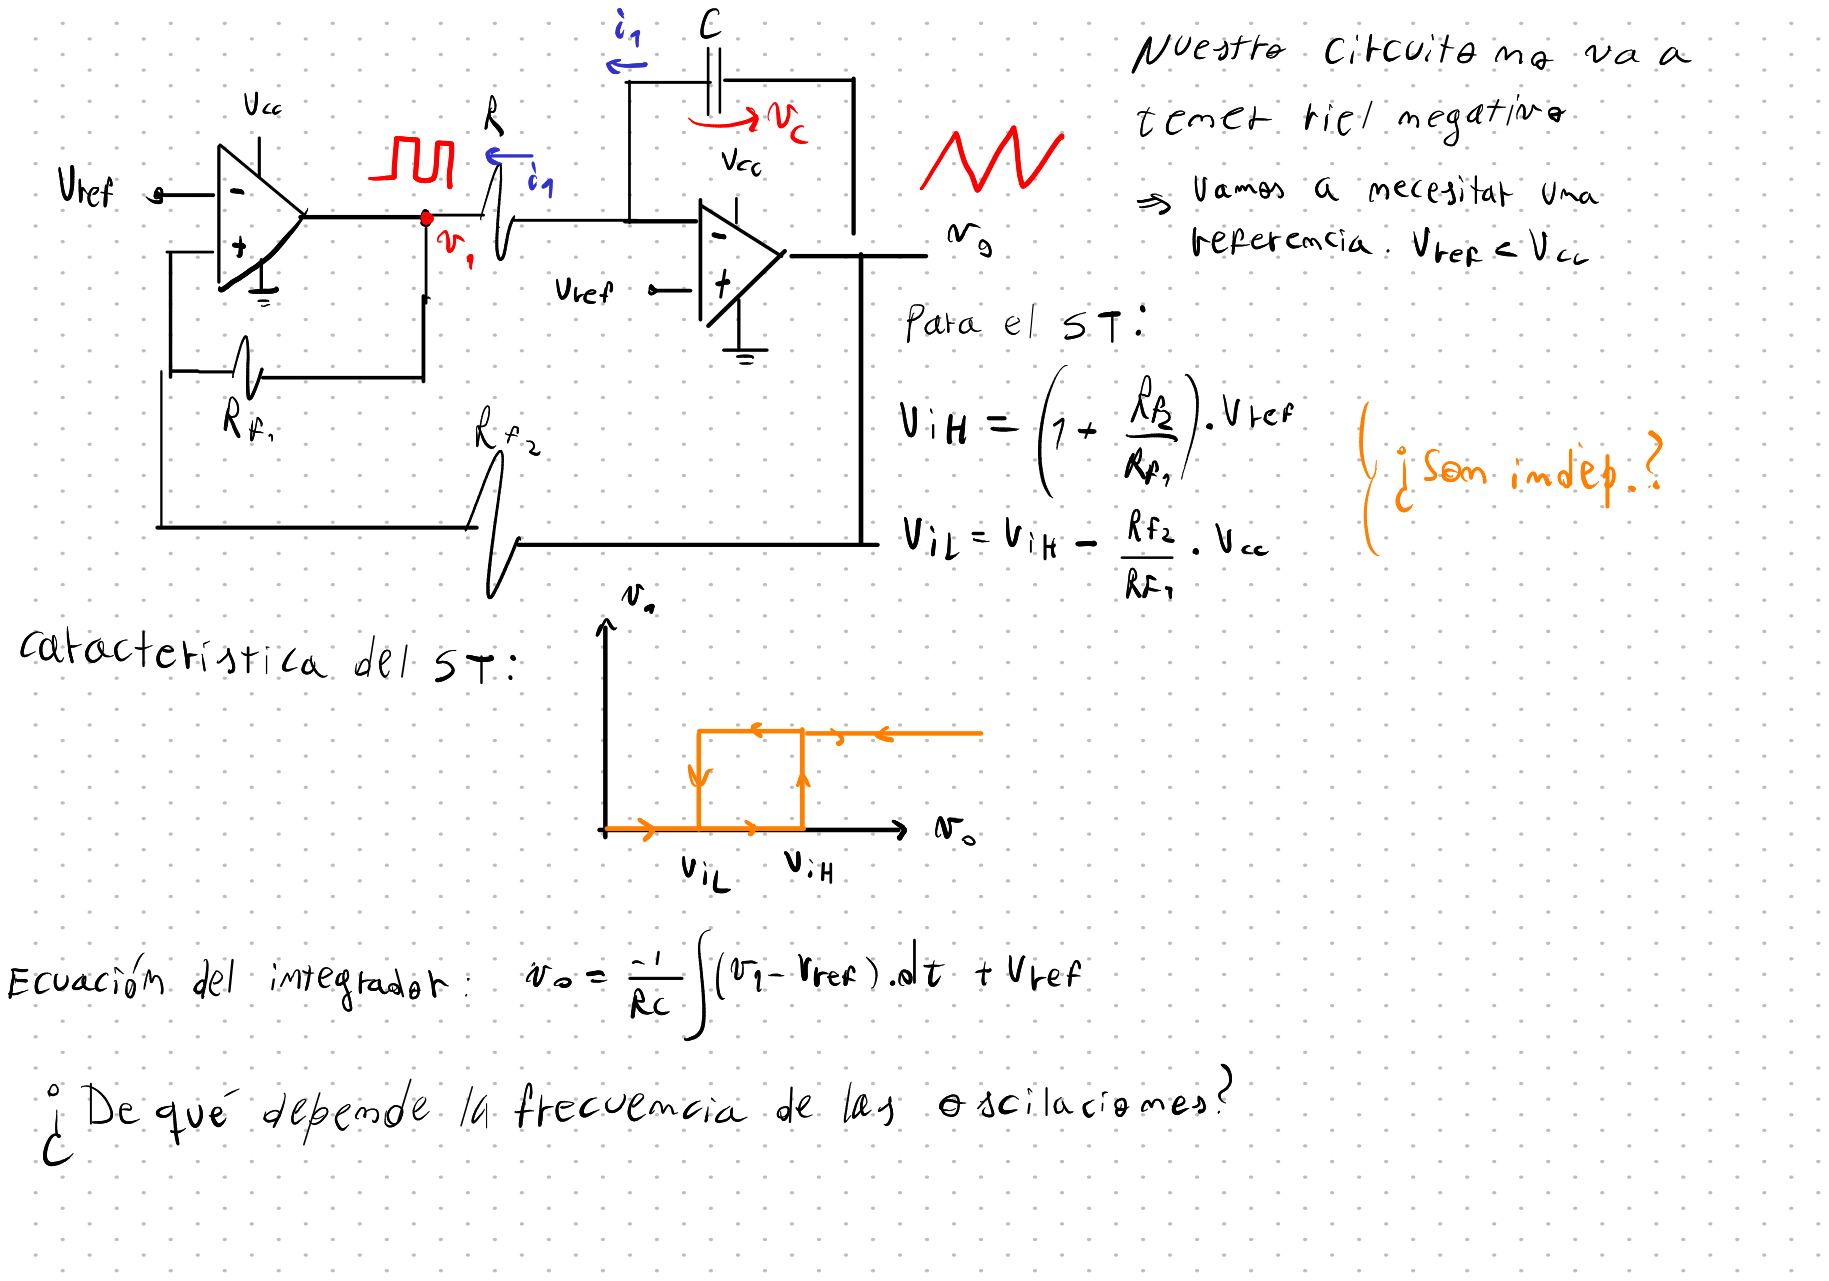
[picture p180: page 6]

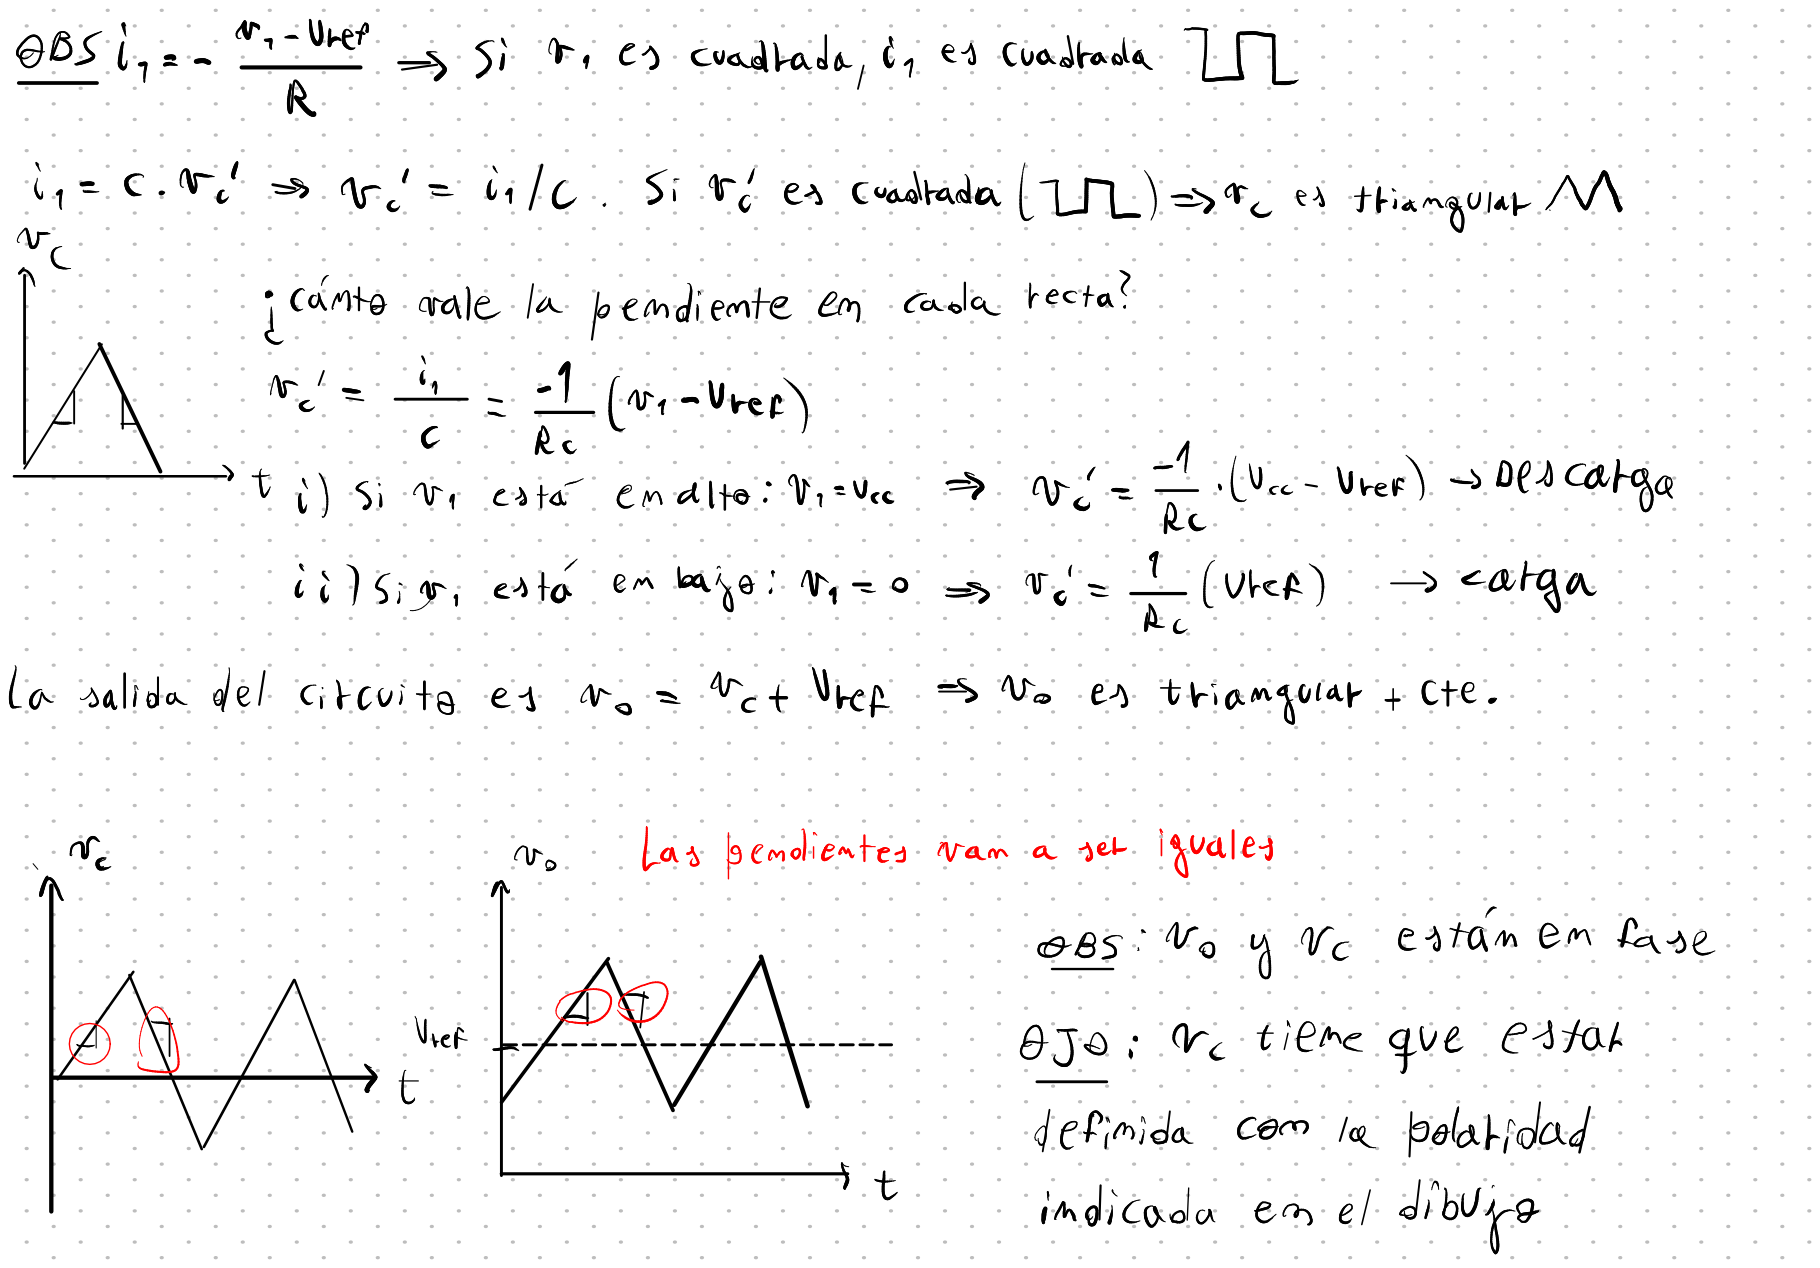
[picture p181: page 7]

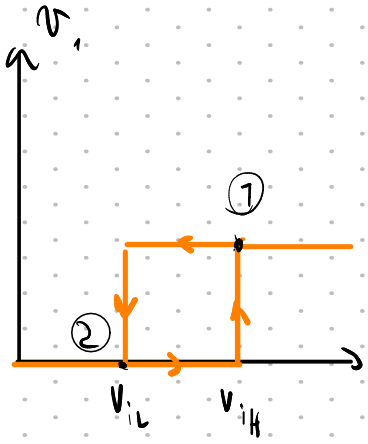
[picture p182: figure]

Arrancamos en 1). La salida del ST está en alto. El capacitor se está descargando. vo está cayendo

2)vo cae hasta VIL, momento en el cual la salida del ST pasa a bajo

3) La salida del ST está en bajo, el capacitor se está cargando, vo está subiendo
4) vo sube hasta llegar a VIH, momento en el cual la salida del ST pasa a alto.

Se repite el ciclo

¿Cuánto tarda este ciclo?

vo tiene que bajar de VIH a VIL y luego subir de VIL a VIH.

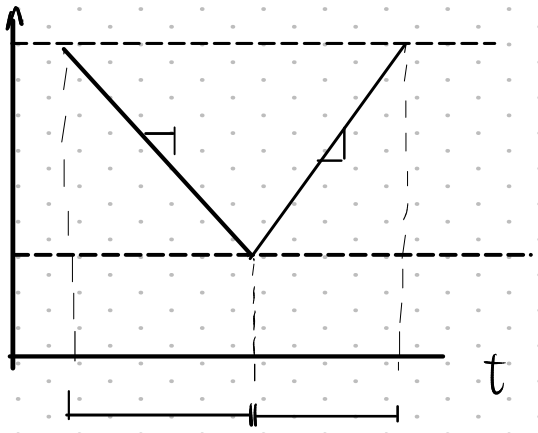
[picture p183: figure]
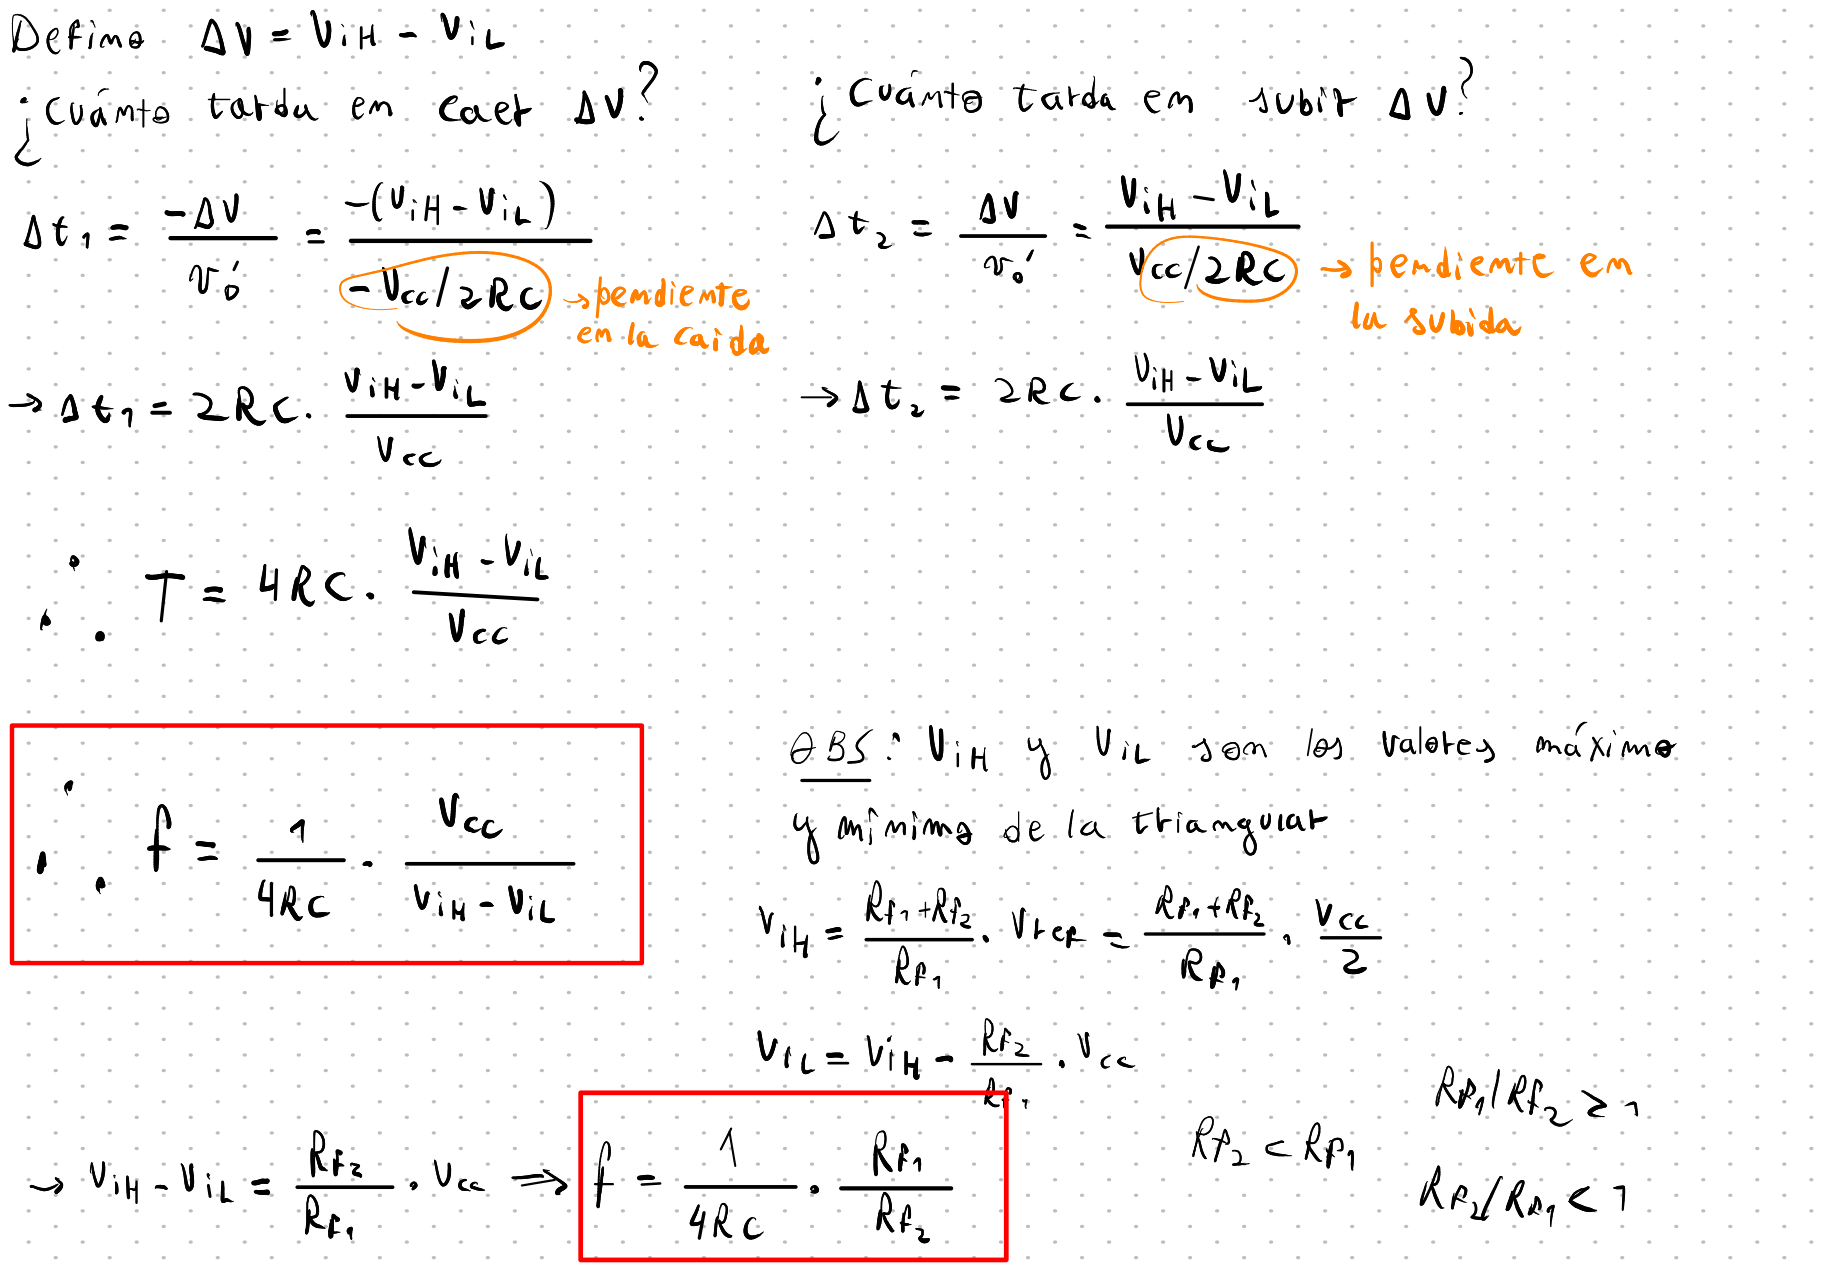
[picture p184: page 9]

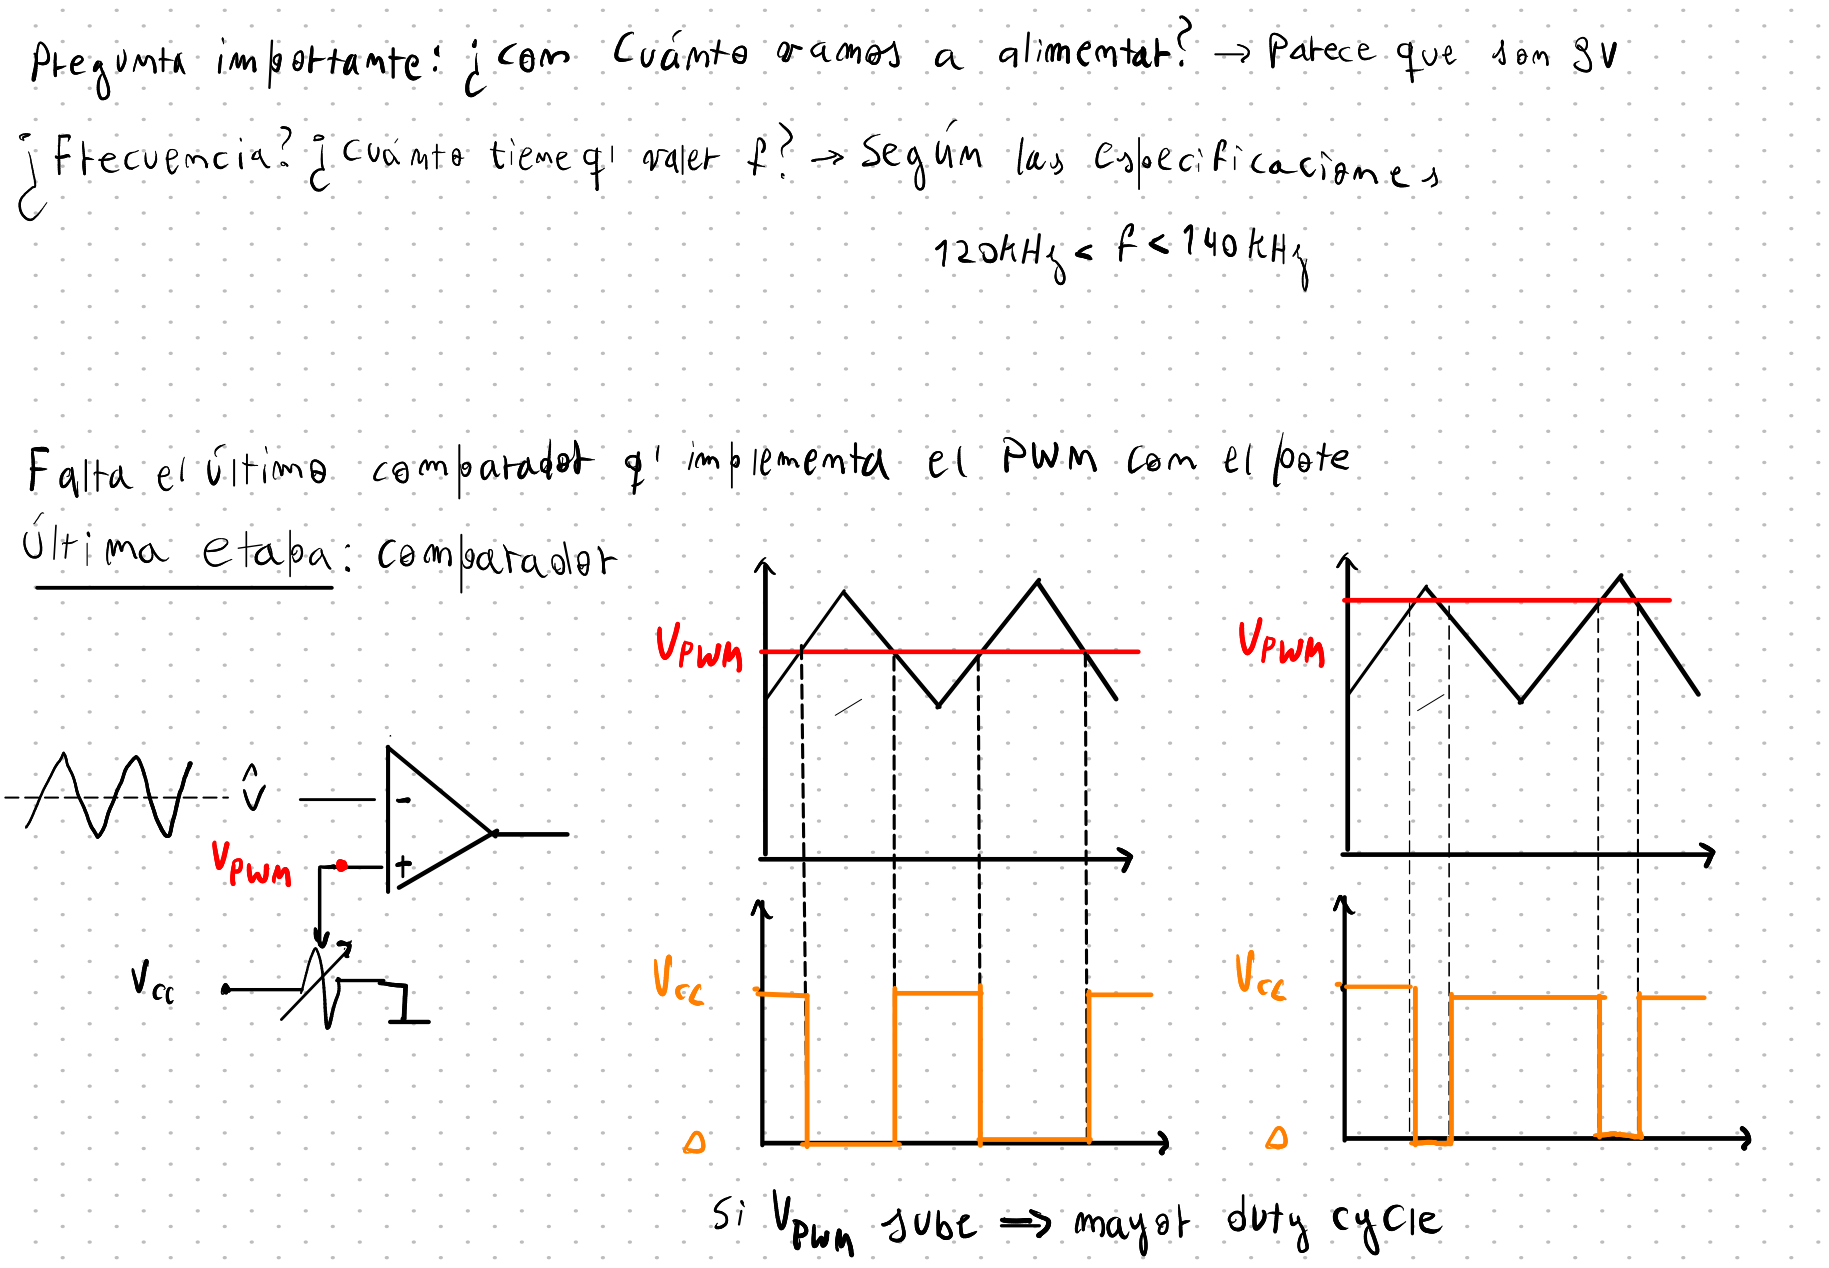
[picture p185: page 10]

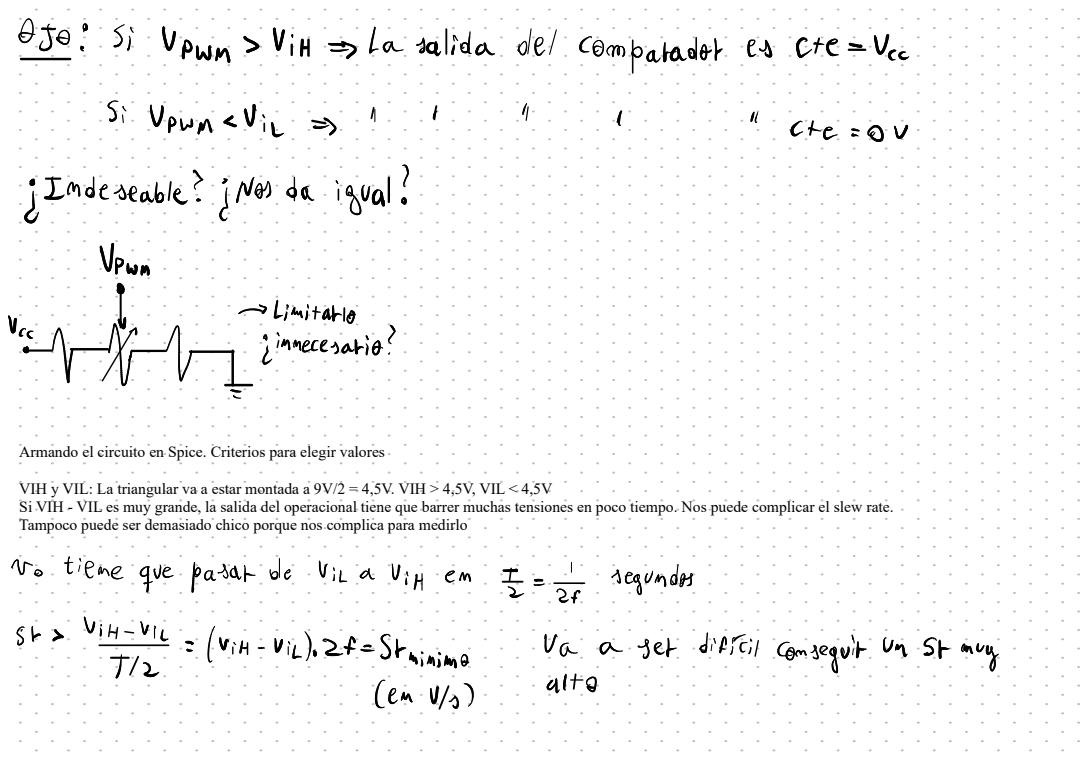
[picture p186: page 11]

Armando el circuito en Spice. Criterios para elegir valores

VIH y VIL: La triangular va a estar montada a 9V/2 = 4,5V. VIH > 4,5V, VIL < 4,5V
Si VIH - VIL es muy grande, la salida del operacional tiene que barrer muchas tensiones en poco tiempo. Nos puede complicar el slew rate.
Tampoco puede ser demasiado chico porque nos complica para medirlo

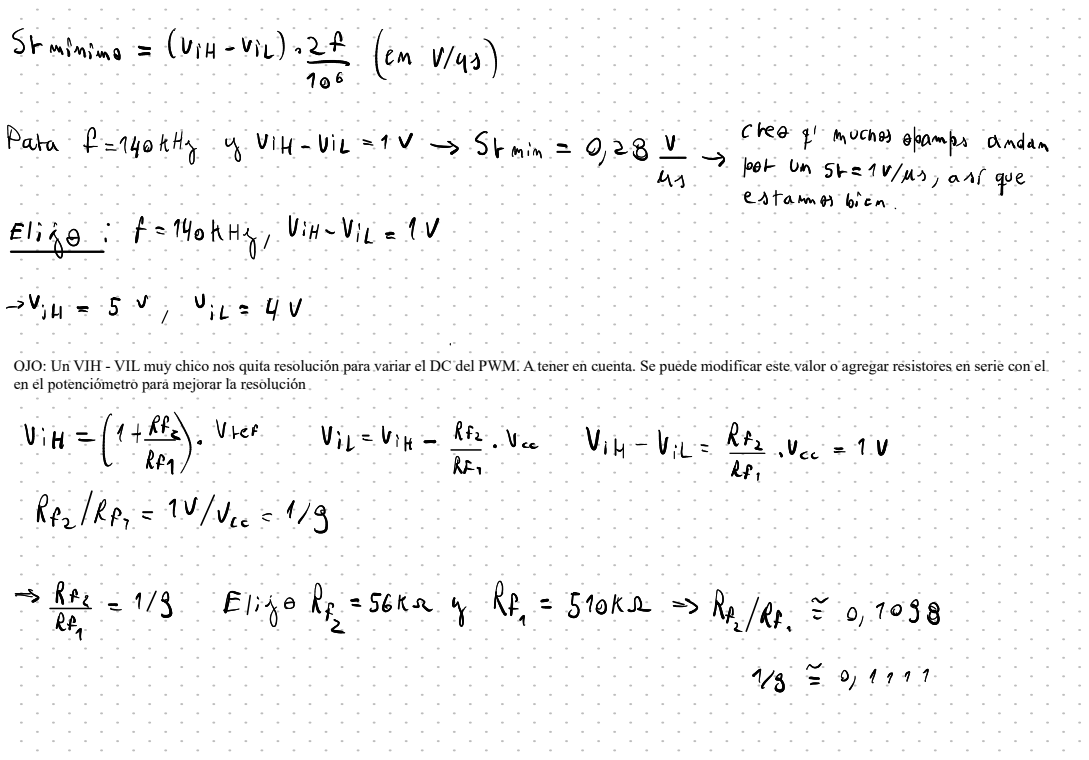
[picture p187: page 12]

OJO: Un VIH - VIL muy chico nos quita resolución para variar el DC del PWM. A tener en cuenta. Se puede modificar este valor o agregar resistores en serie con el
en el potenciómetro para mejorar la resolución

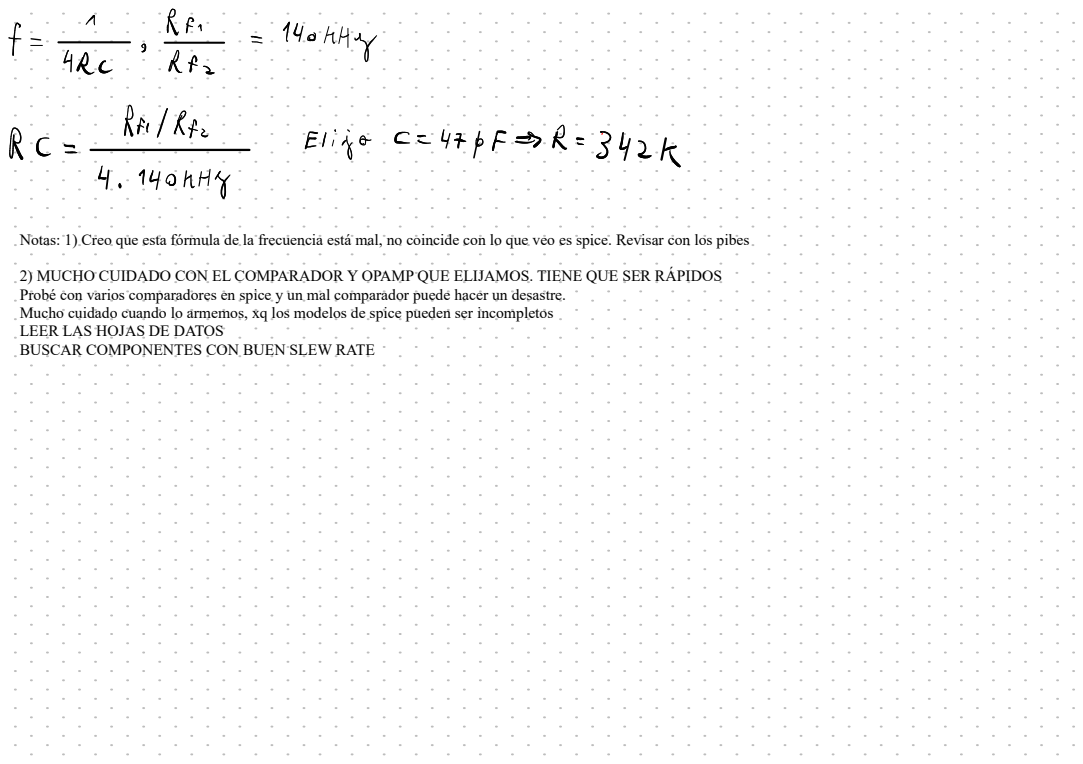
[picture p188: page 13]

Notas: 1) Creo que esta fórmula de la frecuencia está mal, no coincide con lo que veo es spice. Revisar con los pibes

2) MUCHO CUIDADO CON EL COMPARADOR Y OPAMP QUE ELIJAMOS. TIENE QUE SER RÁPIDOS
Probé con varios comparadores en spice y un mal comparador puede hacer un desastre.
Mucho cuidado cuando lo armemos, xq los modelos de spice pueden ser incompletos
LEER LAS HOJAS DE DATOS
BUSCAR COMPONENTES CON BUEN SLEW RATE
