Fjmoya-uba/Taller-de-Circuitos-Grupo-4/Checkpoint 1/Foldback.pdf

# Regulador lineal

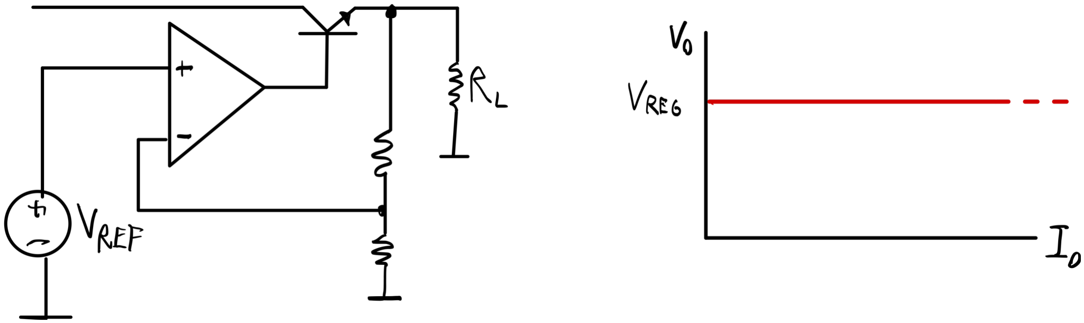
[picture p189: figure]

# Limitador de corriente

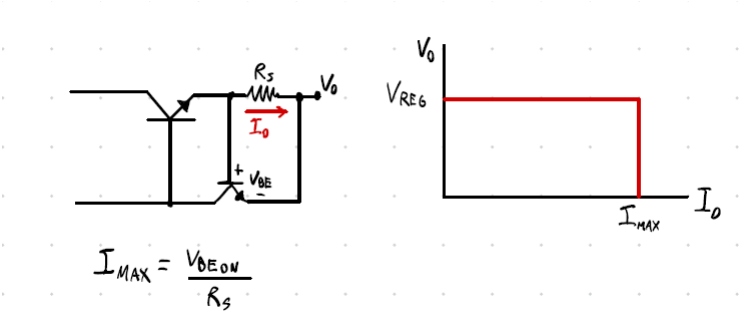
[picture p190: figure]

# Foldback

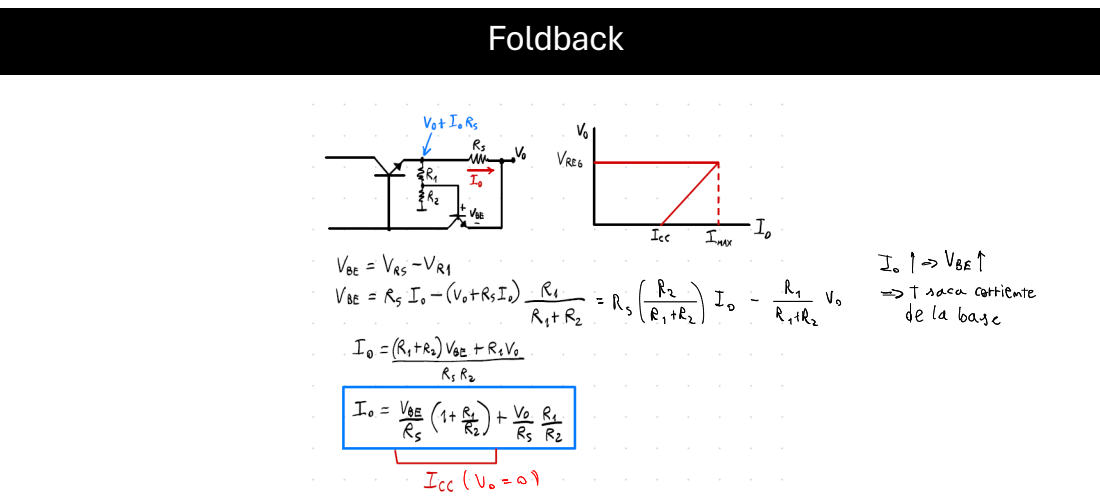
[picture p191: page 3]

# Calculos

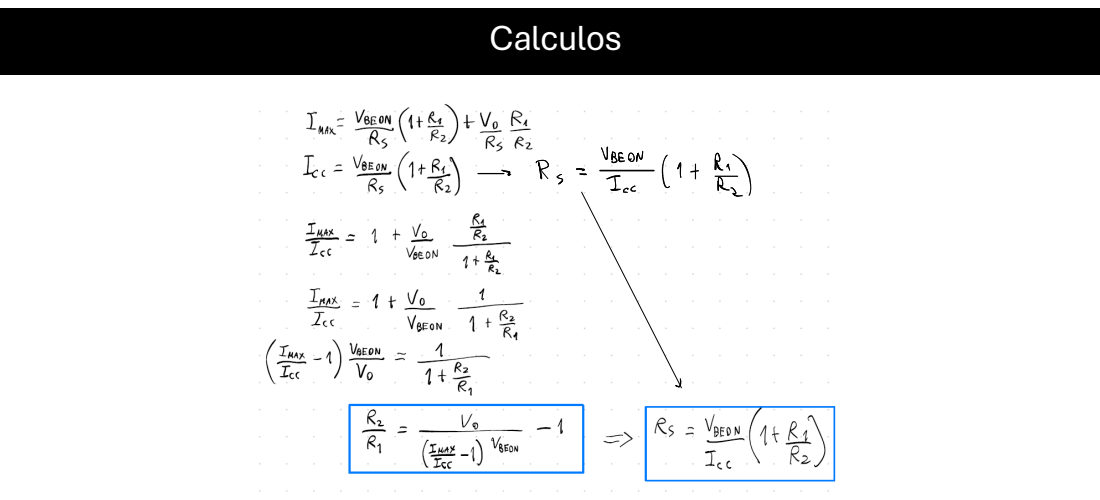
[picture p192: page 4]

# Sensor de corriente

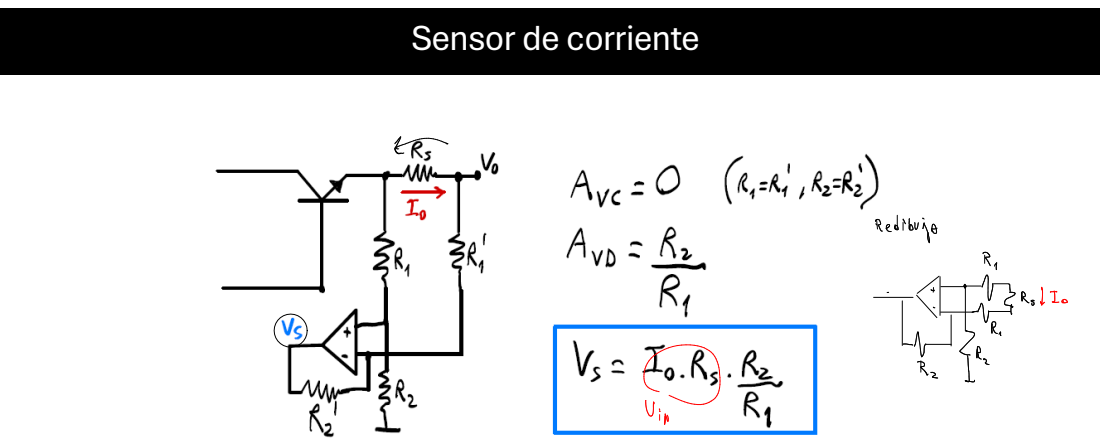
[picture p193: page 5]

# Limitador de corriente

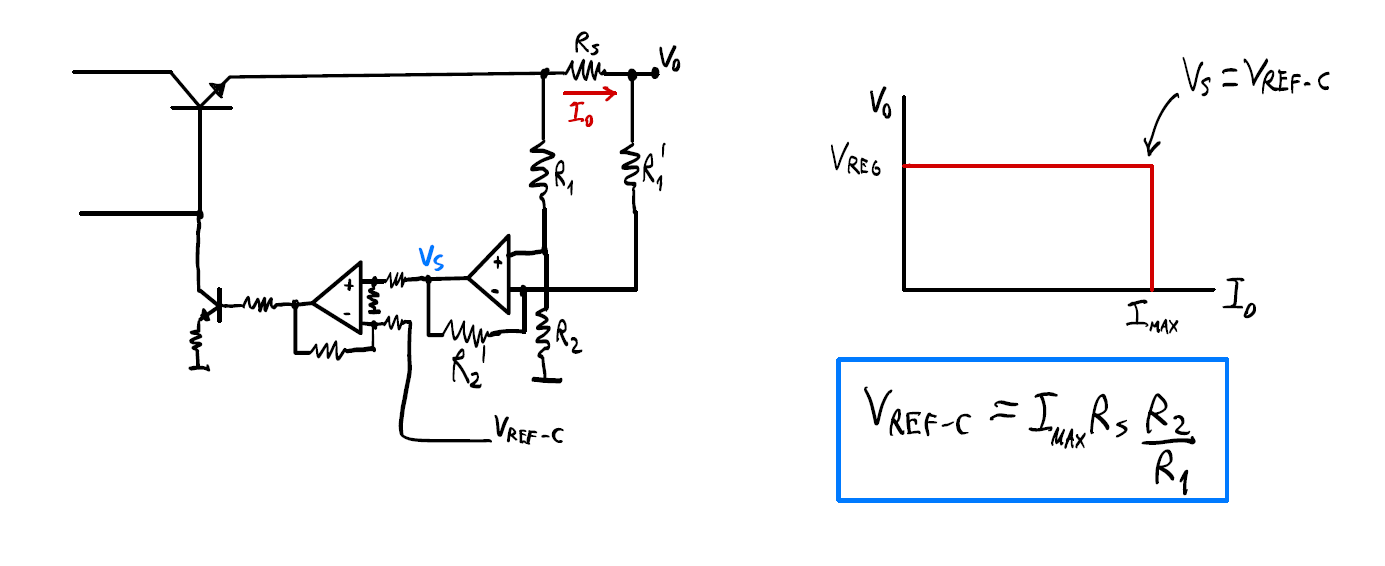
[picture p194: figure]

# Foldback

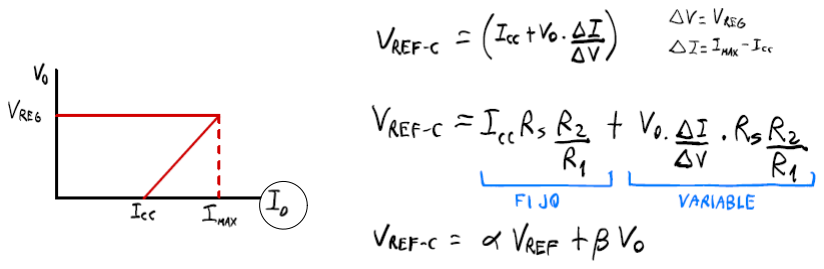
[picture p195: figure]

# Ejemplo

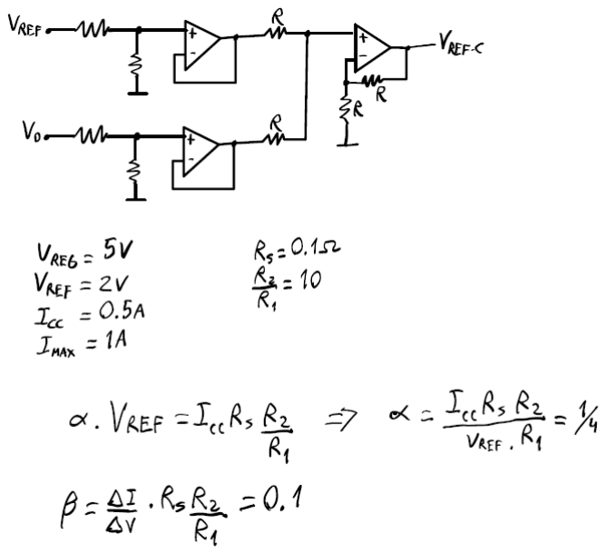
[picture p196: figure]

# Implementacion

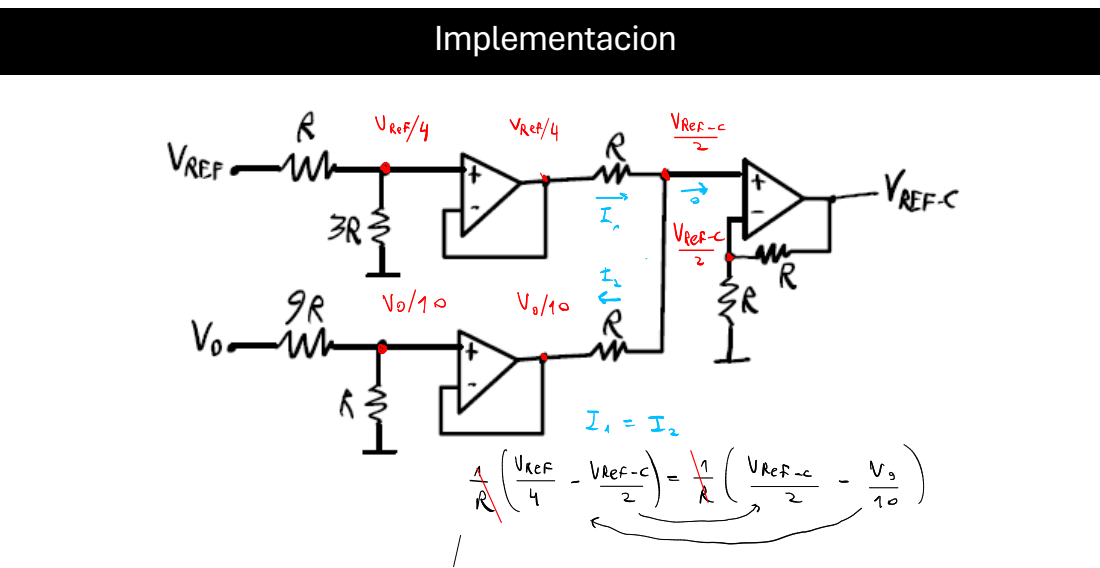
[picture p197: page 9]

# Consideraciones

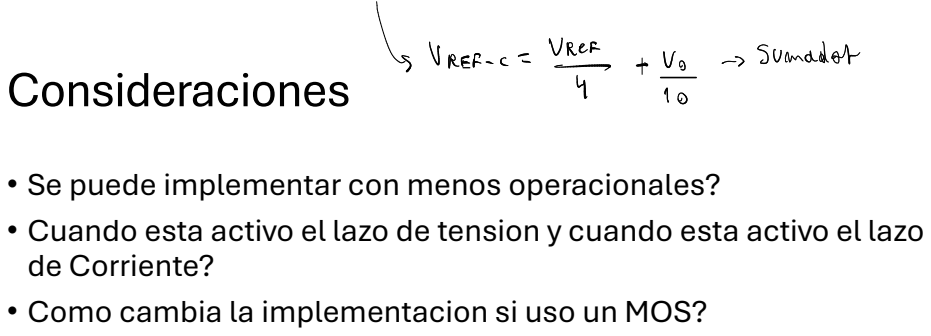
[picture p198: page 10]

• Se puede implementar con menos operacionales?
• Cuando esta activo el lazo de tension y cuando esta activo el lazo
de Corriente?
• Como cambia la implementacion si uso un MOS?

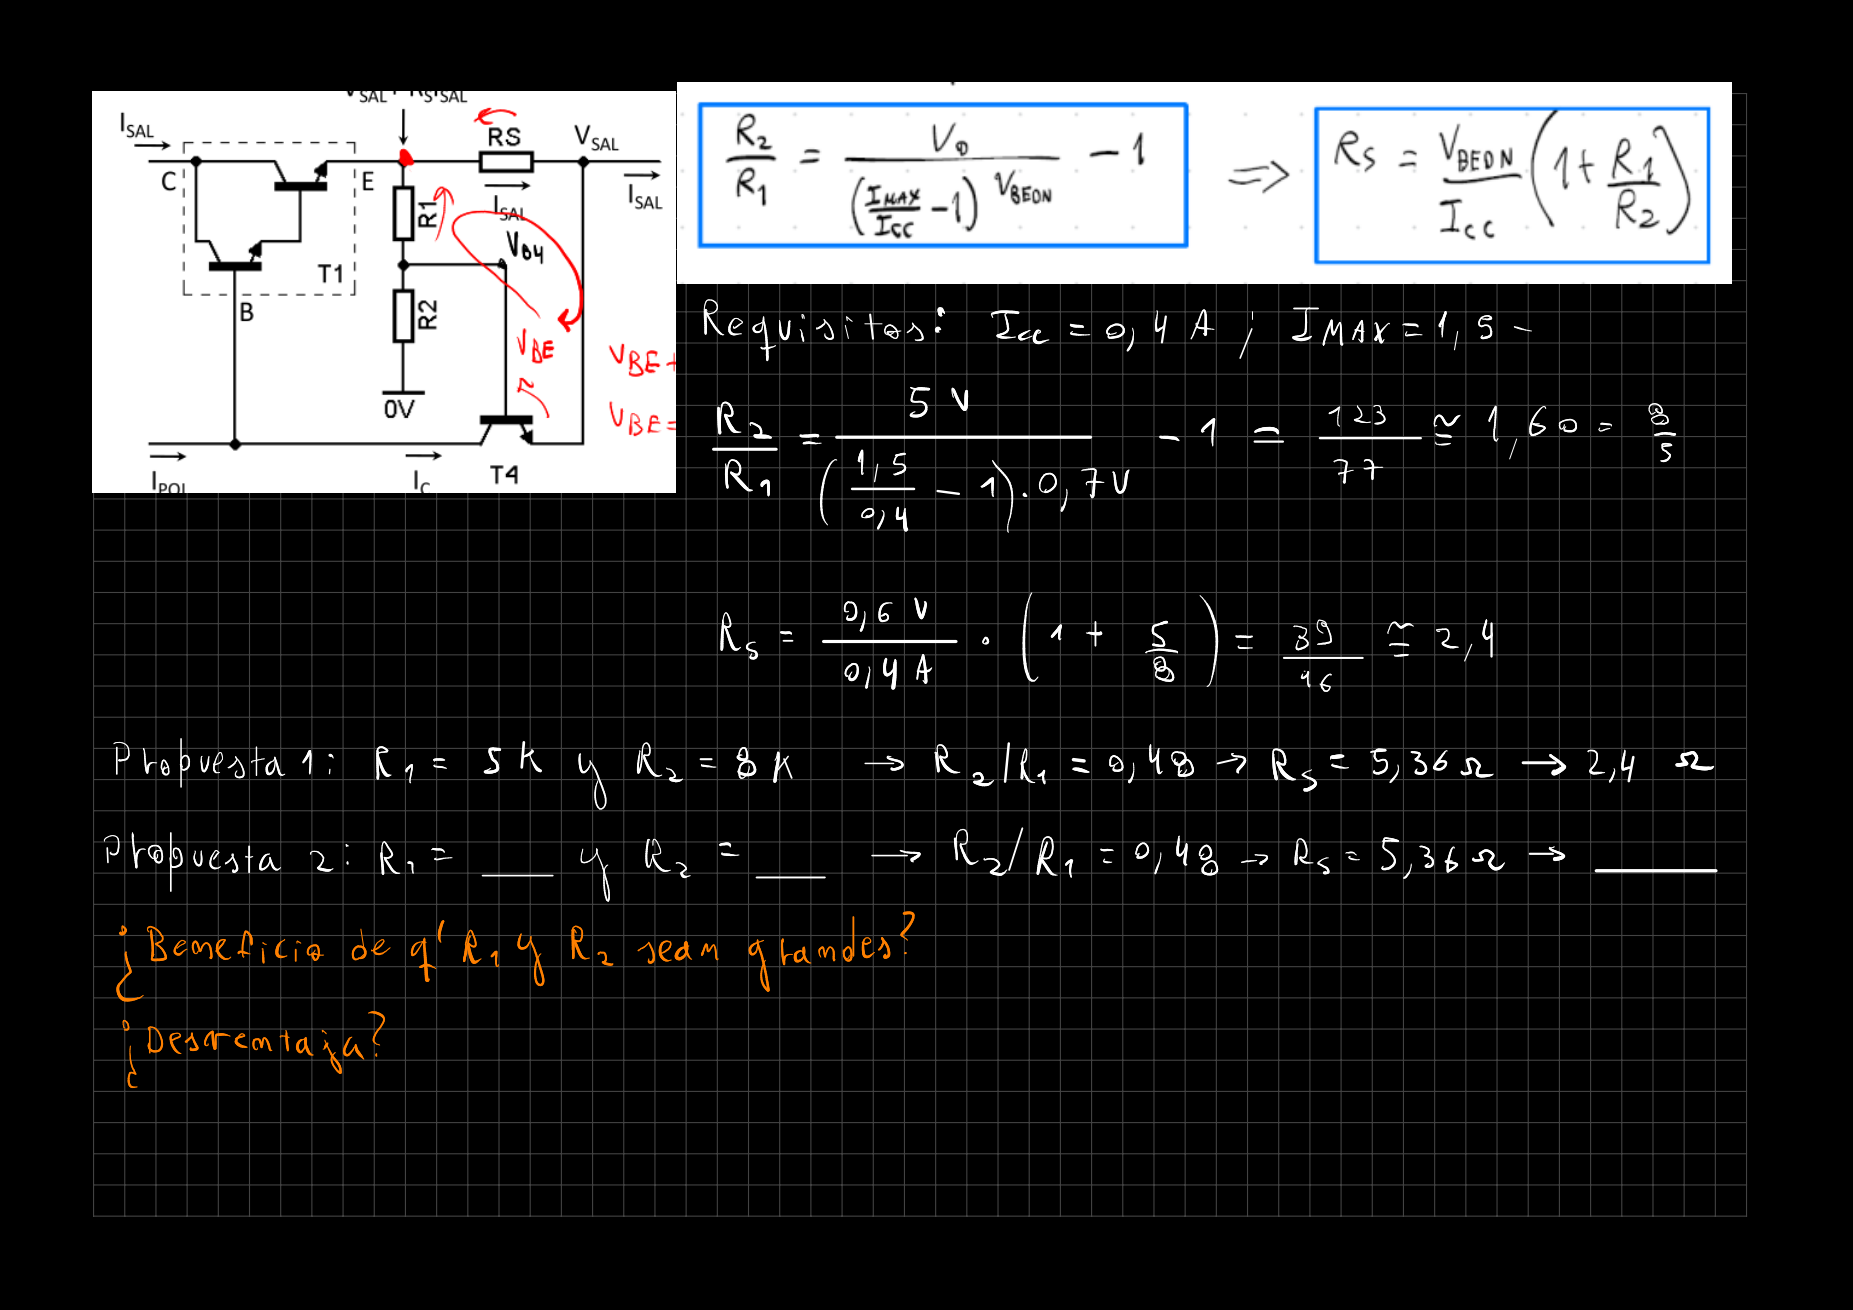
[picture p199: page 11]

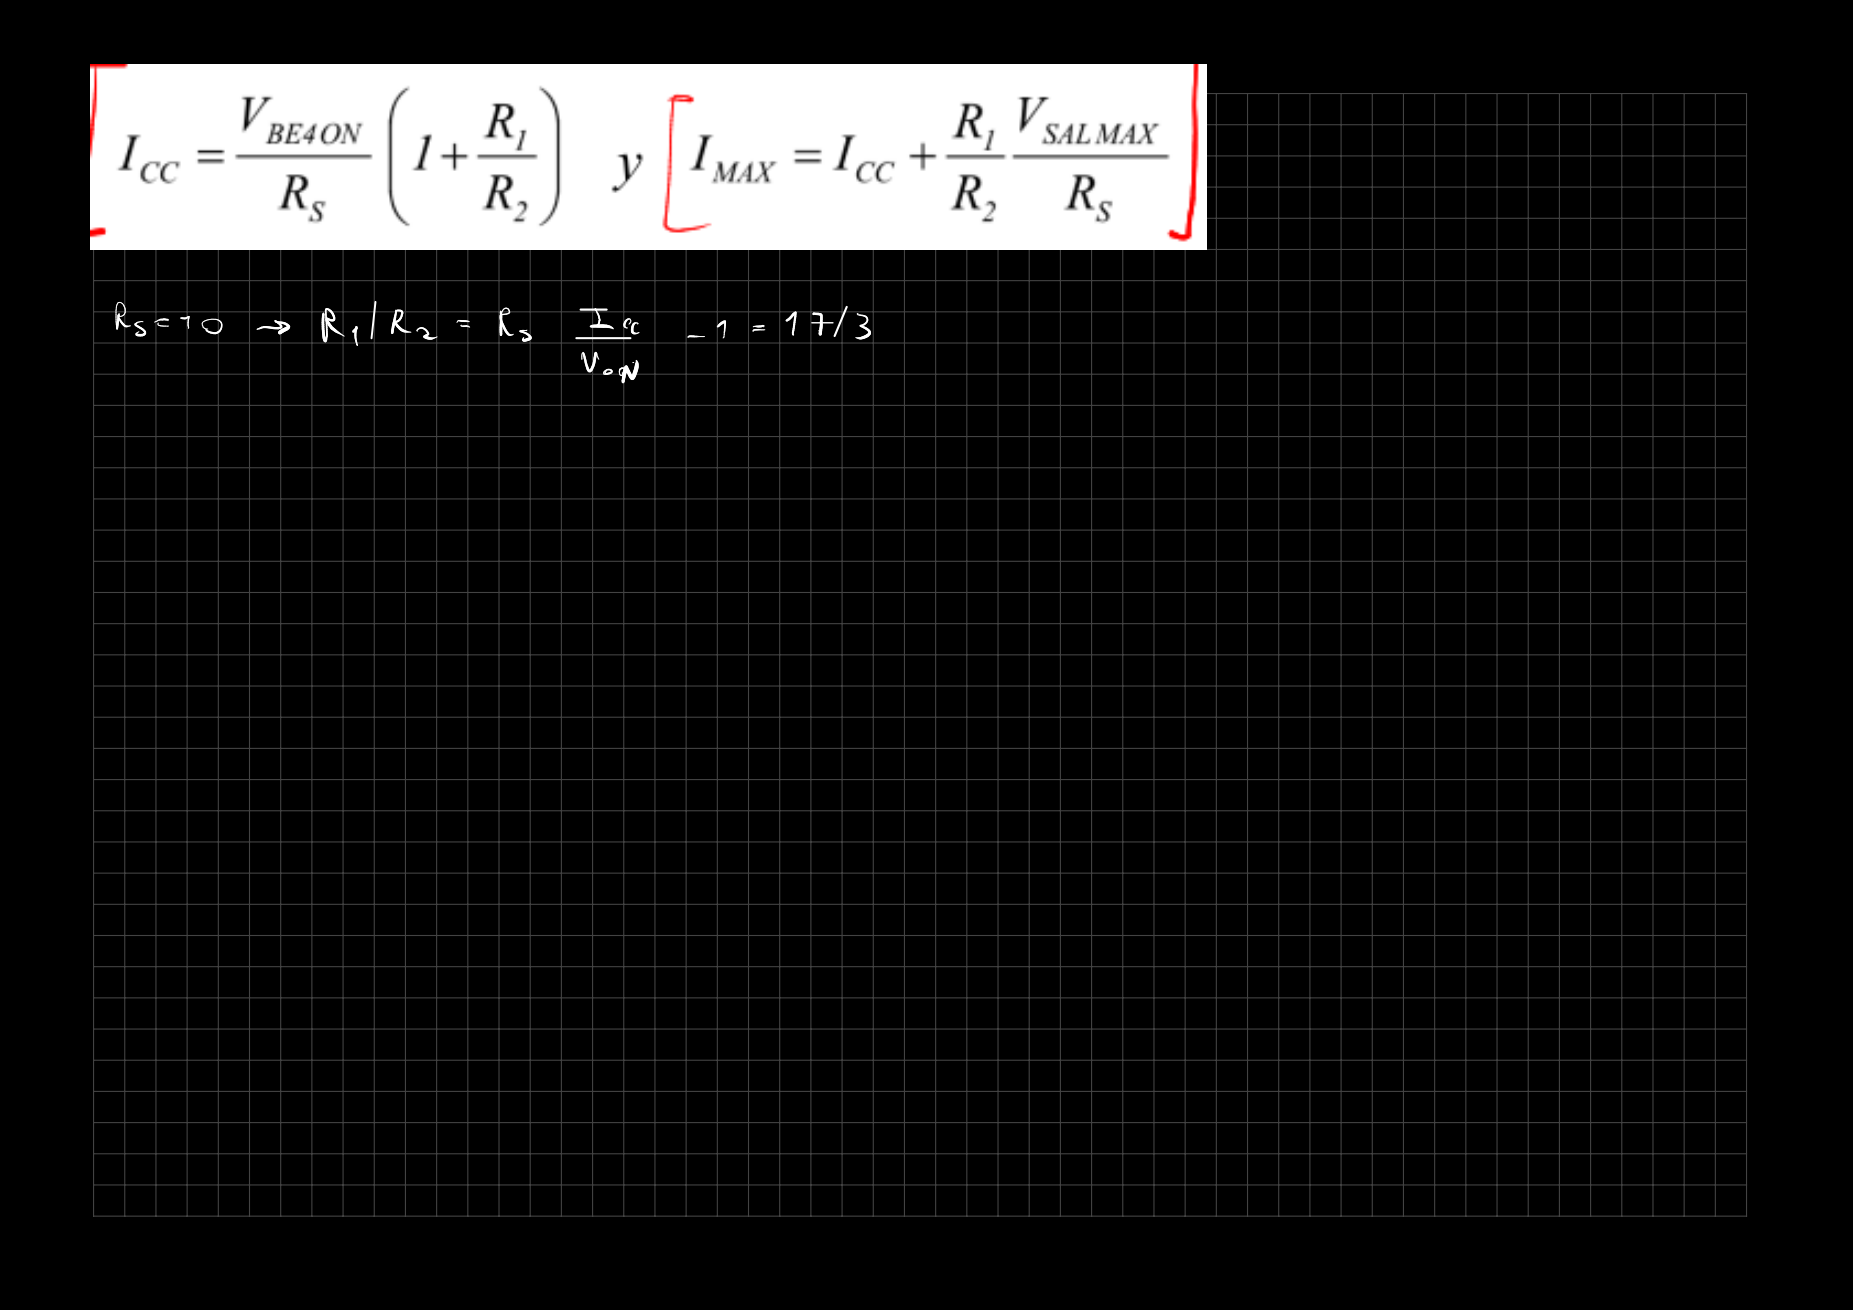
[picture p200: page 12]

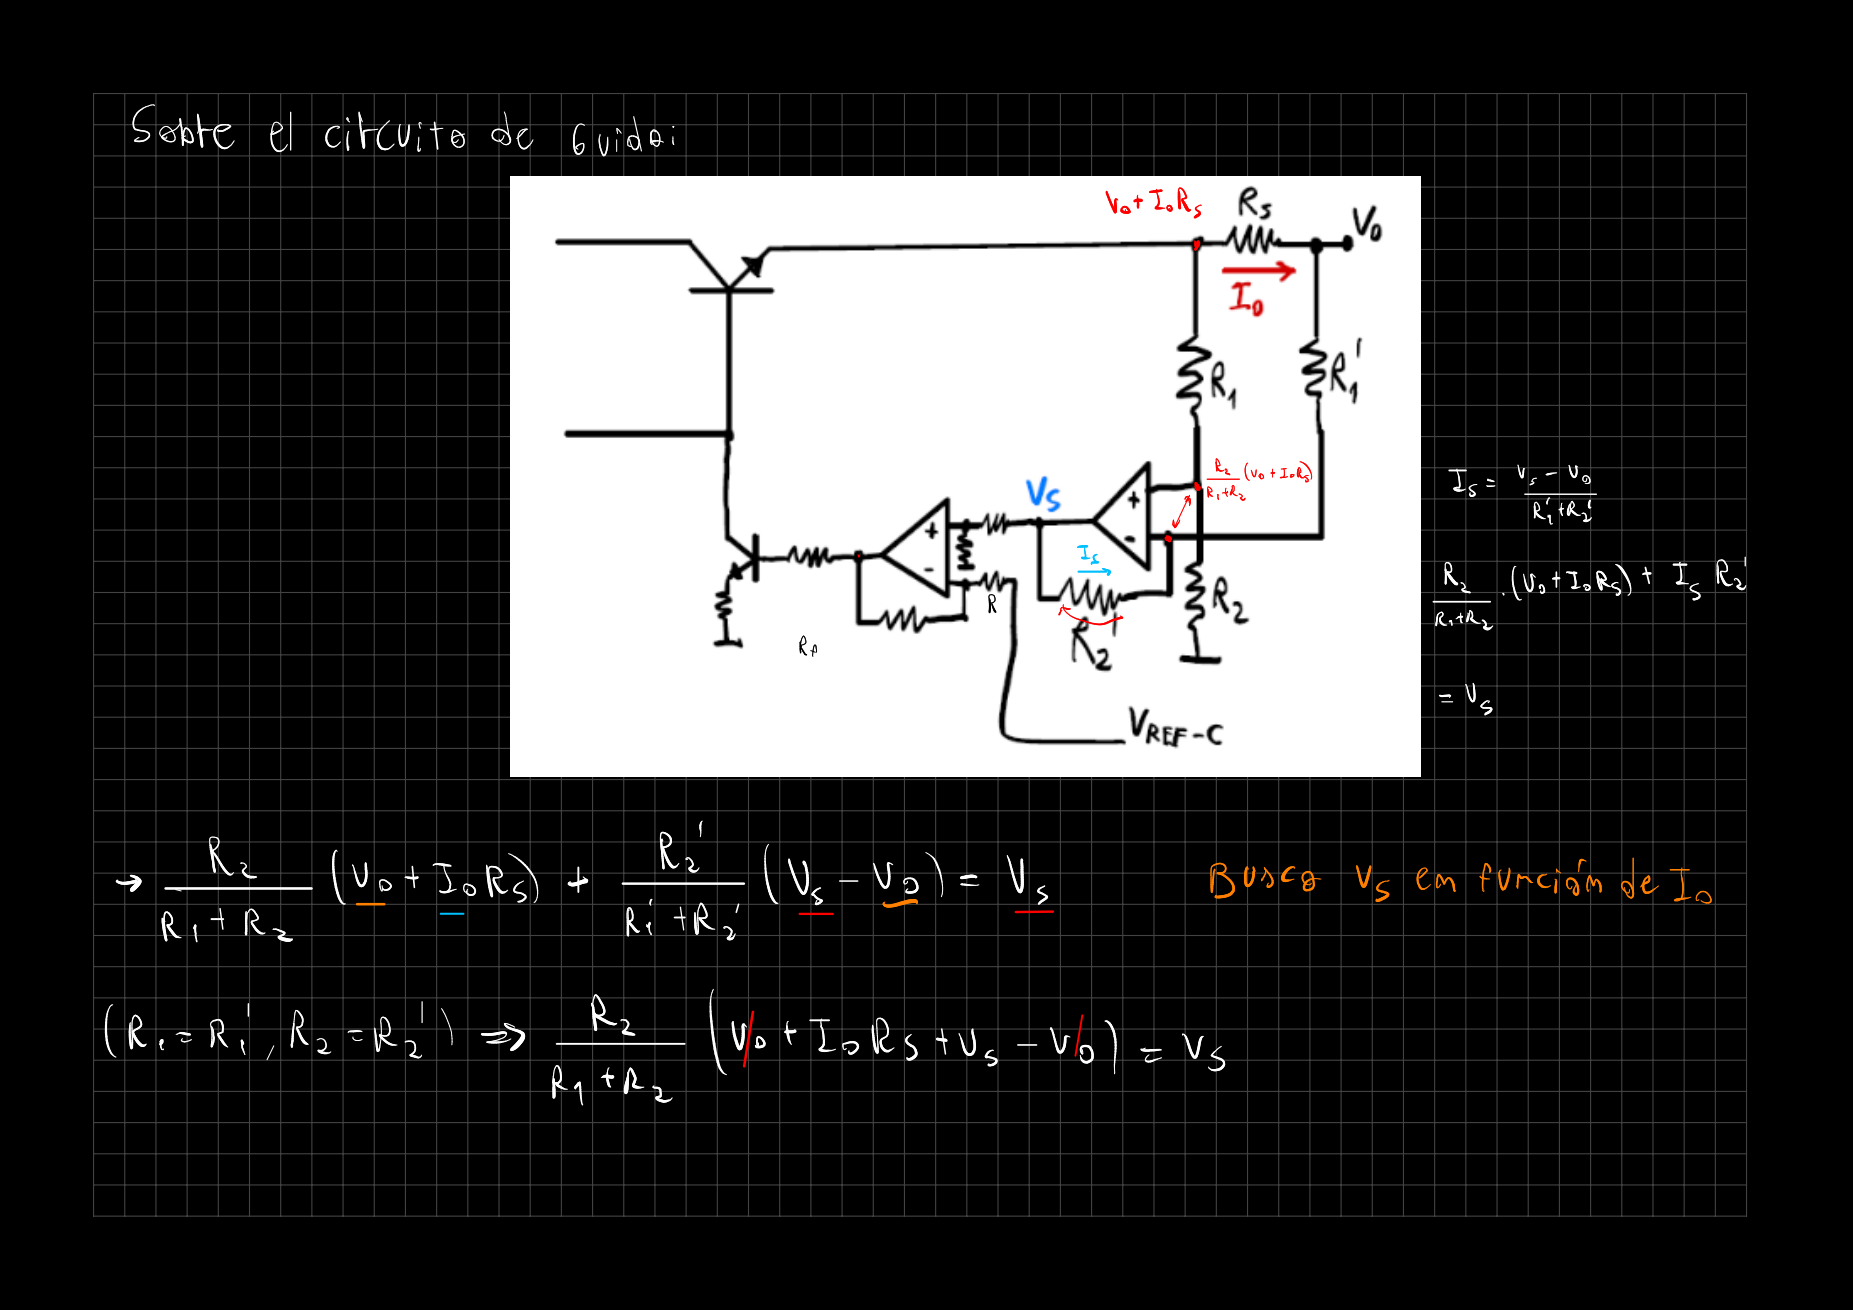
[picture p201: page 13]

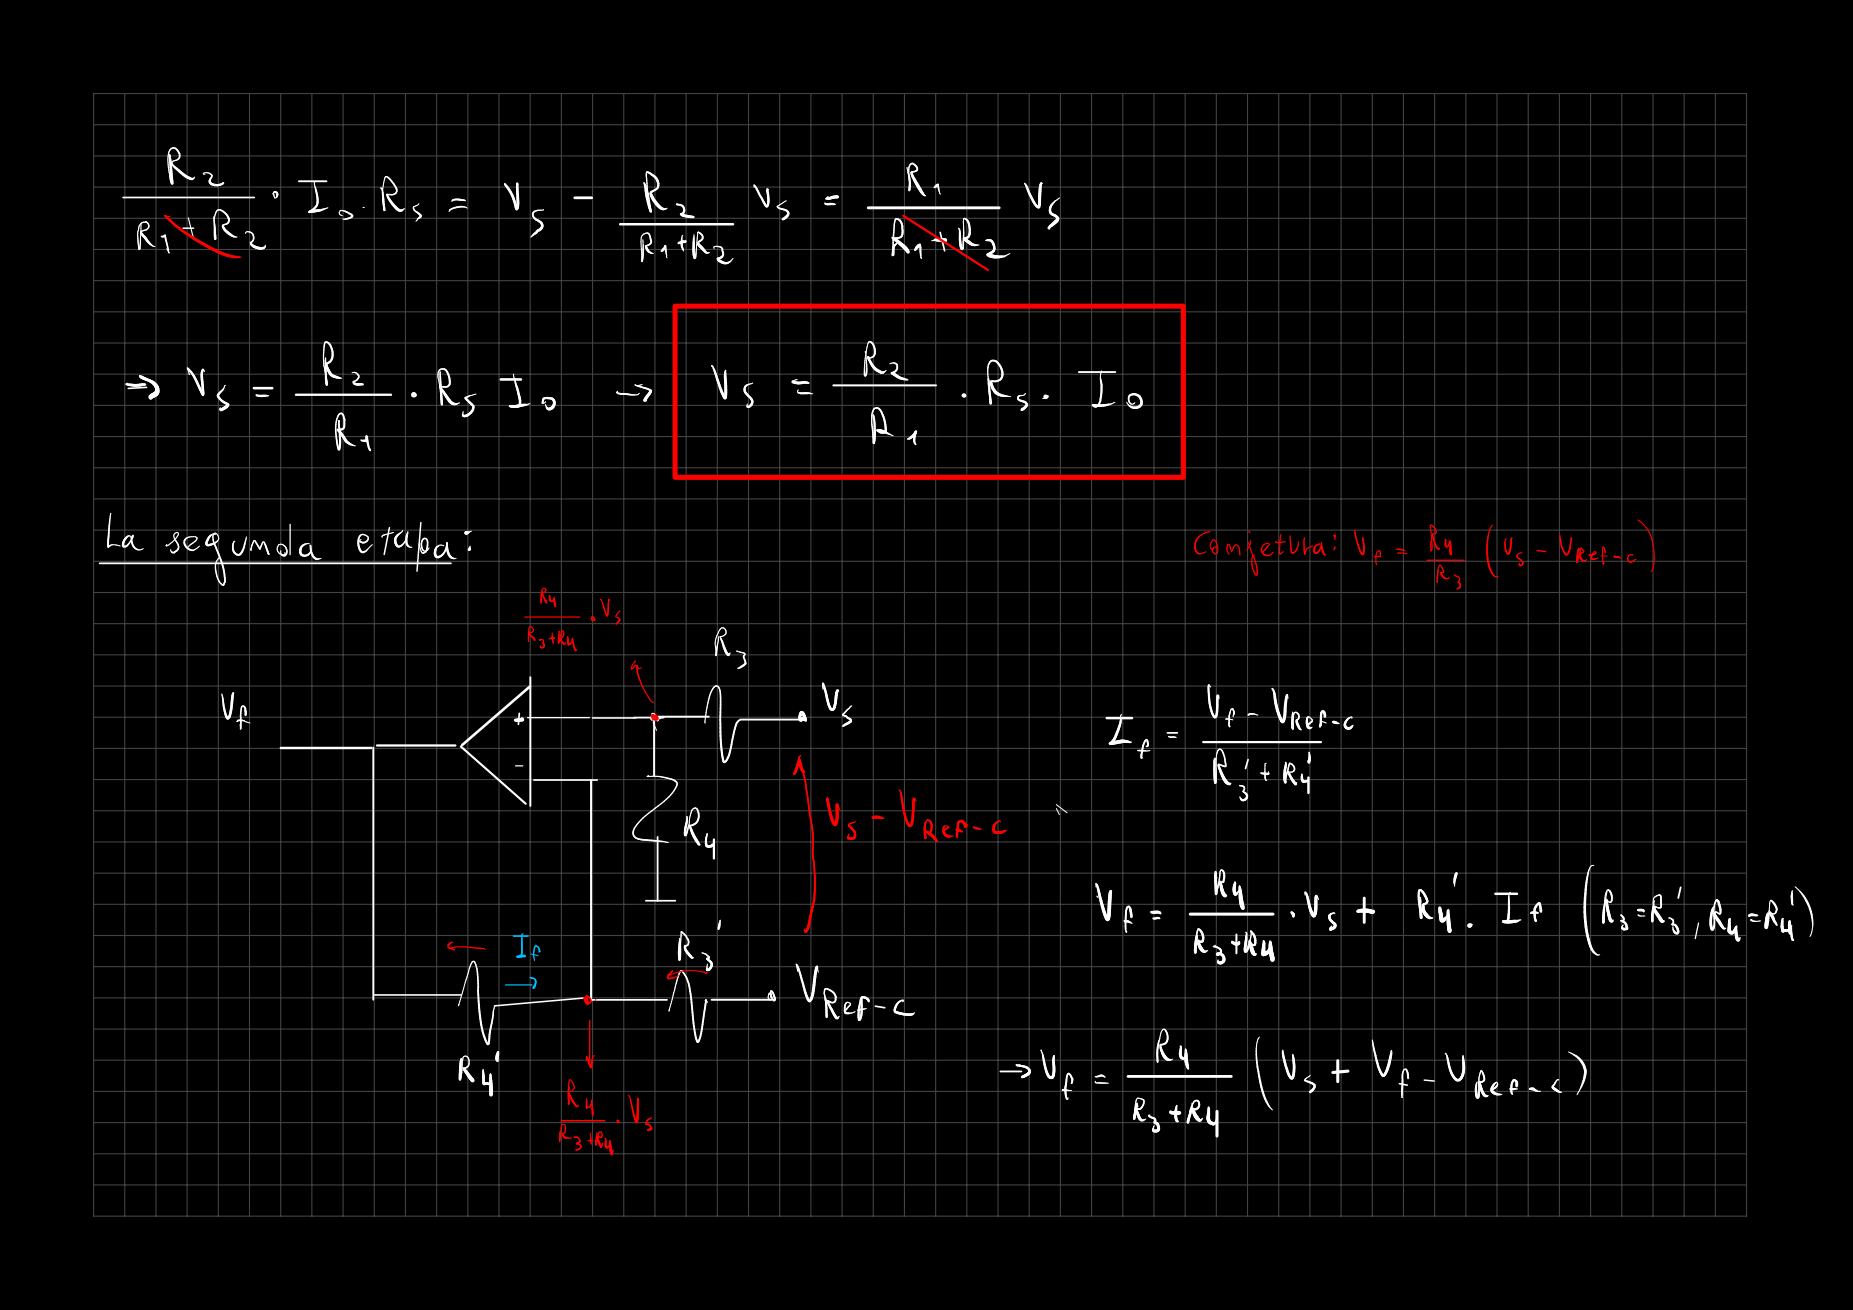
[picture p202: page 14]

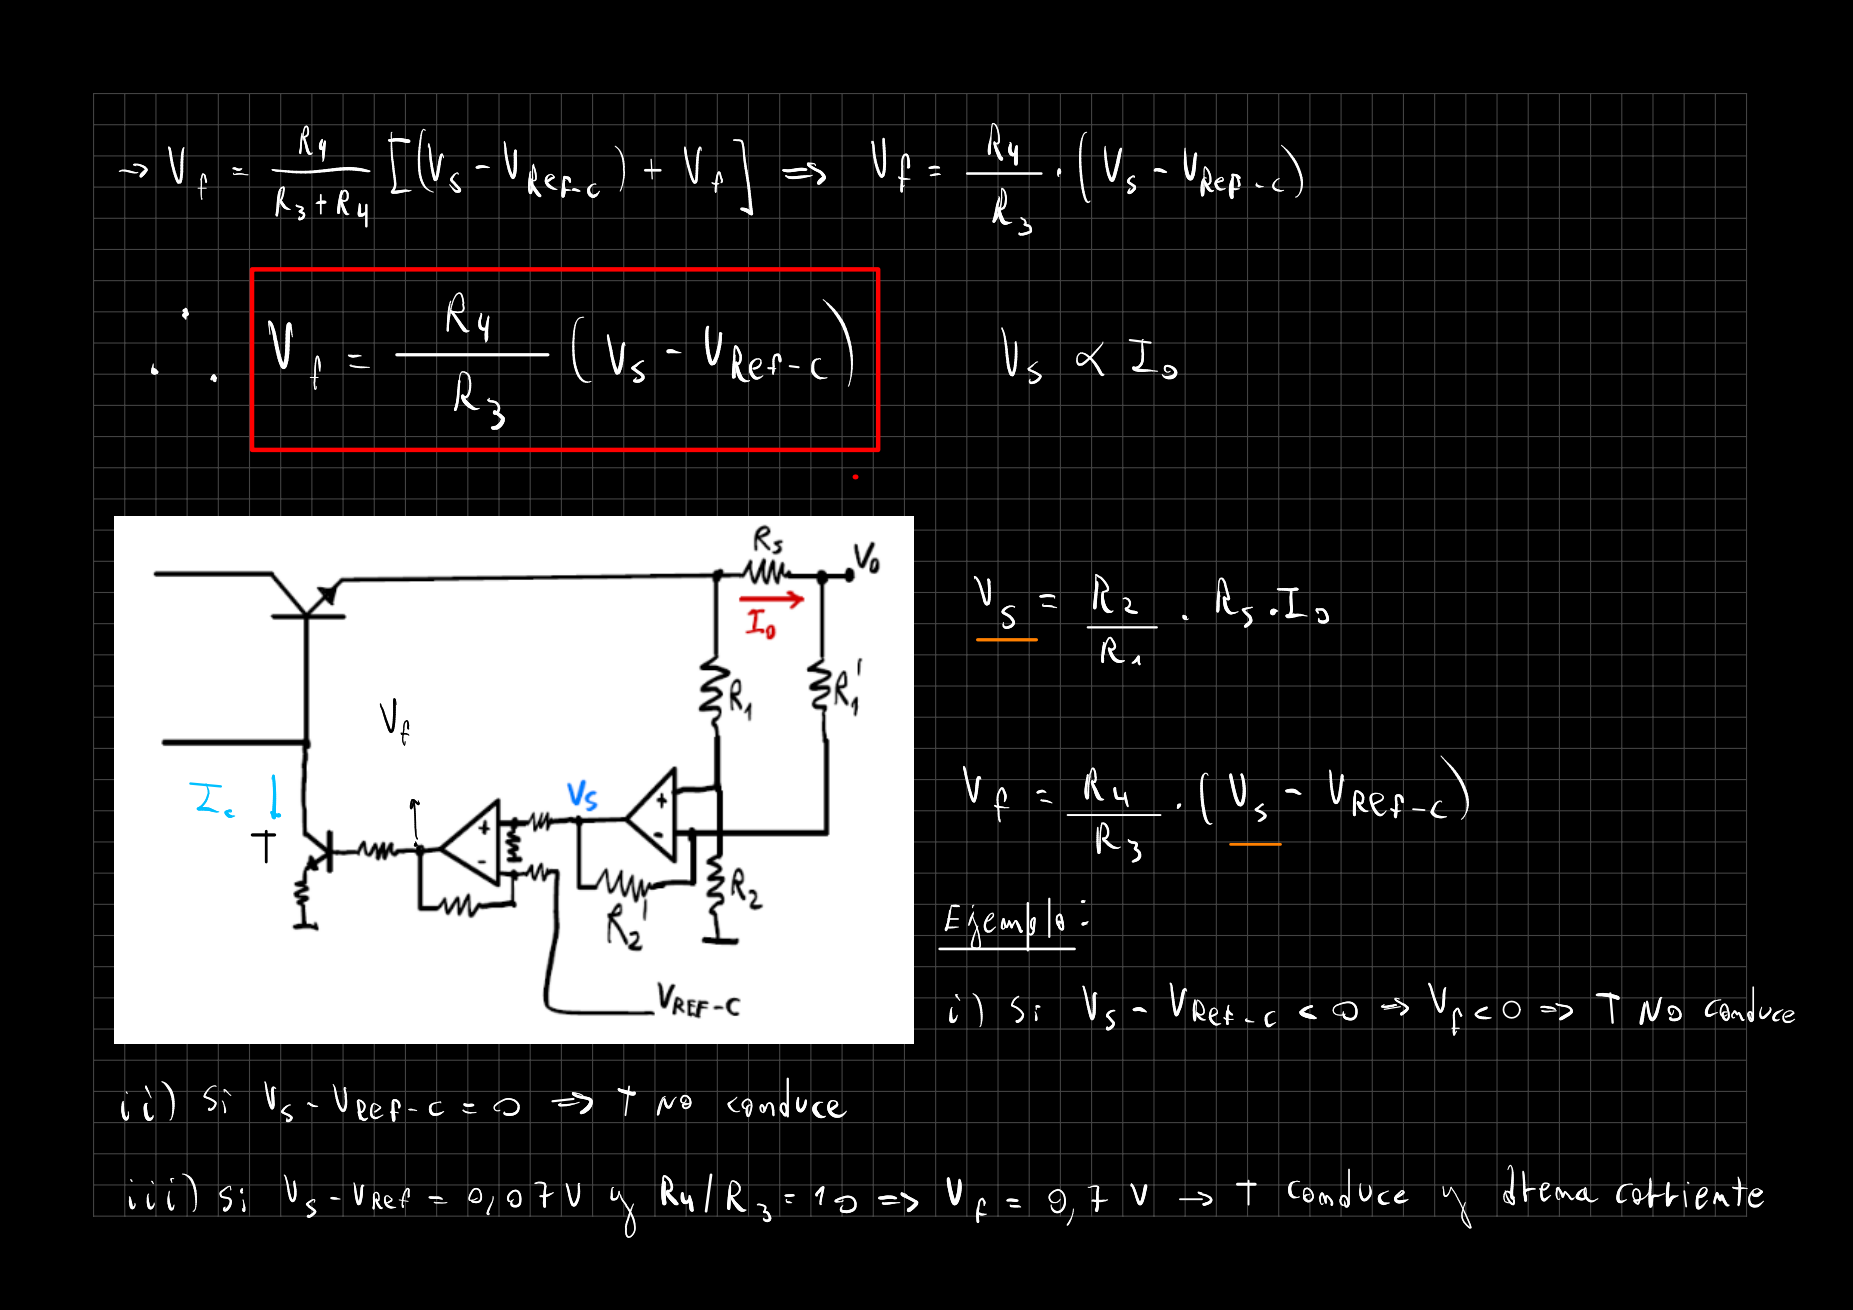
[picture p203: page 15]

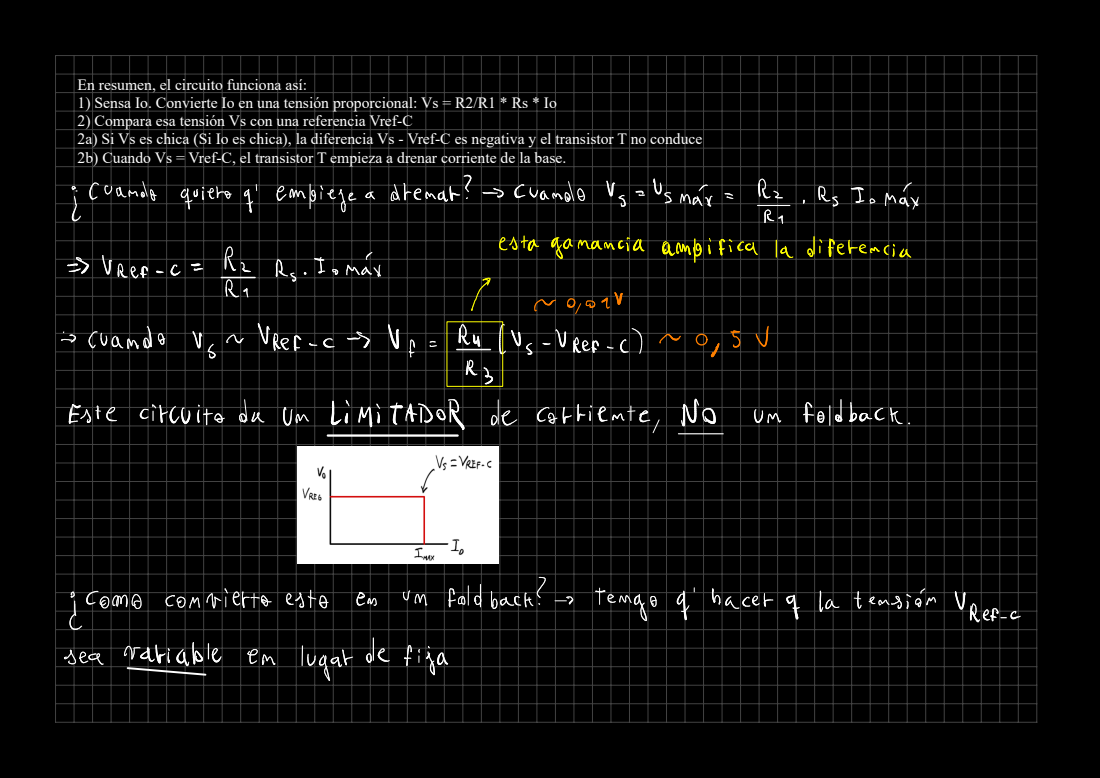
[picture p204: page 16]

En resumen, el circuito funciona así:
1) Sensa Io. Convierte Io en una tensión proporcional: Vs = R2/R1 * Rs * Io
2) Compara esa tensión Vs con una referencia Vref-C
2a) Si Vs es chica (Si Io es chica), la diferencia Vs - Vref-C es negativa y el transistor T no conduce
2b) Cuando Vs = Vref-C, el transistor T empieza a drenar corriente de la base.

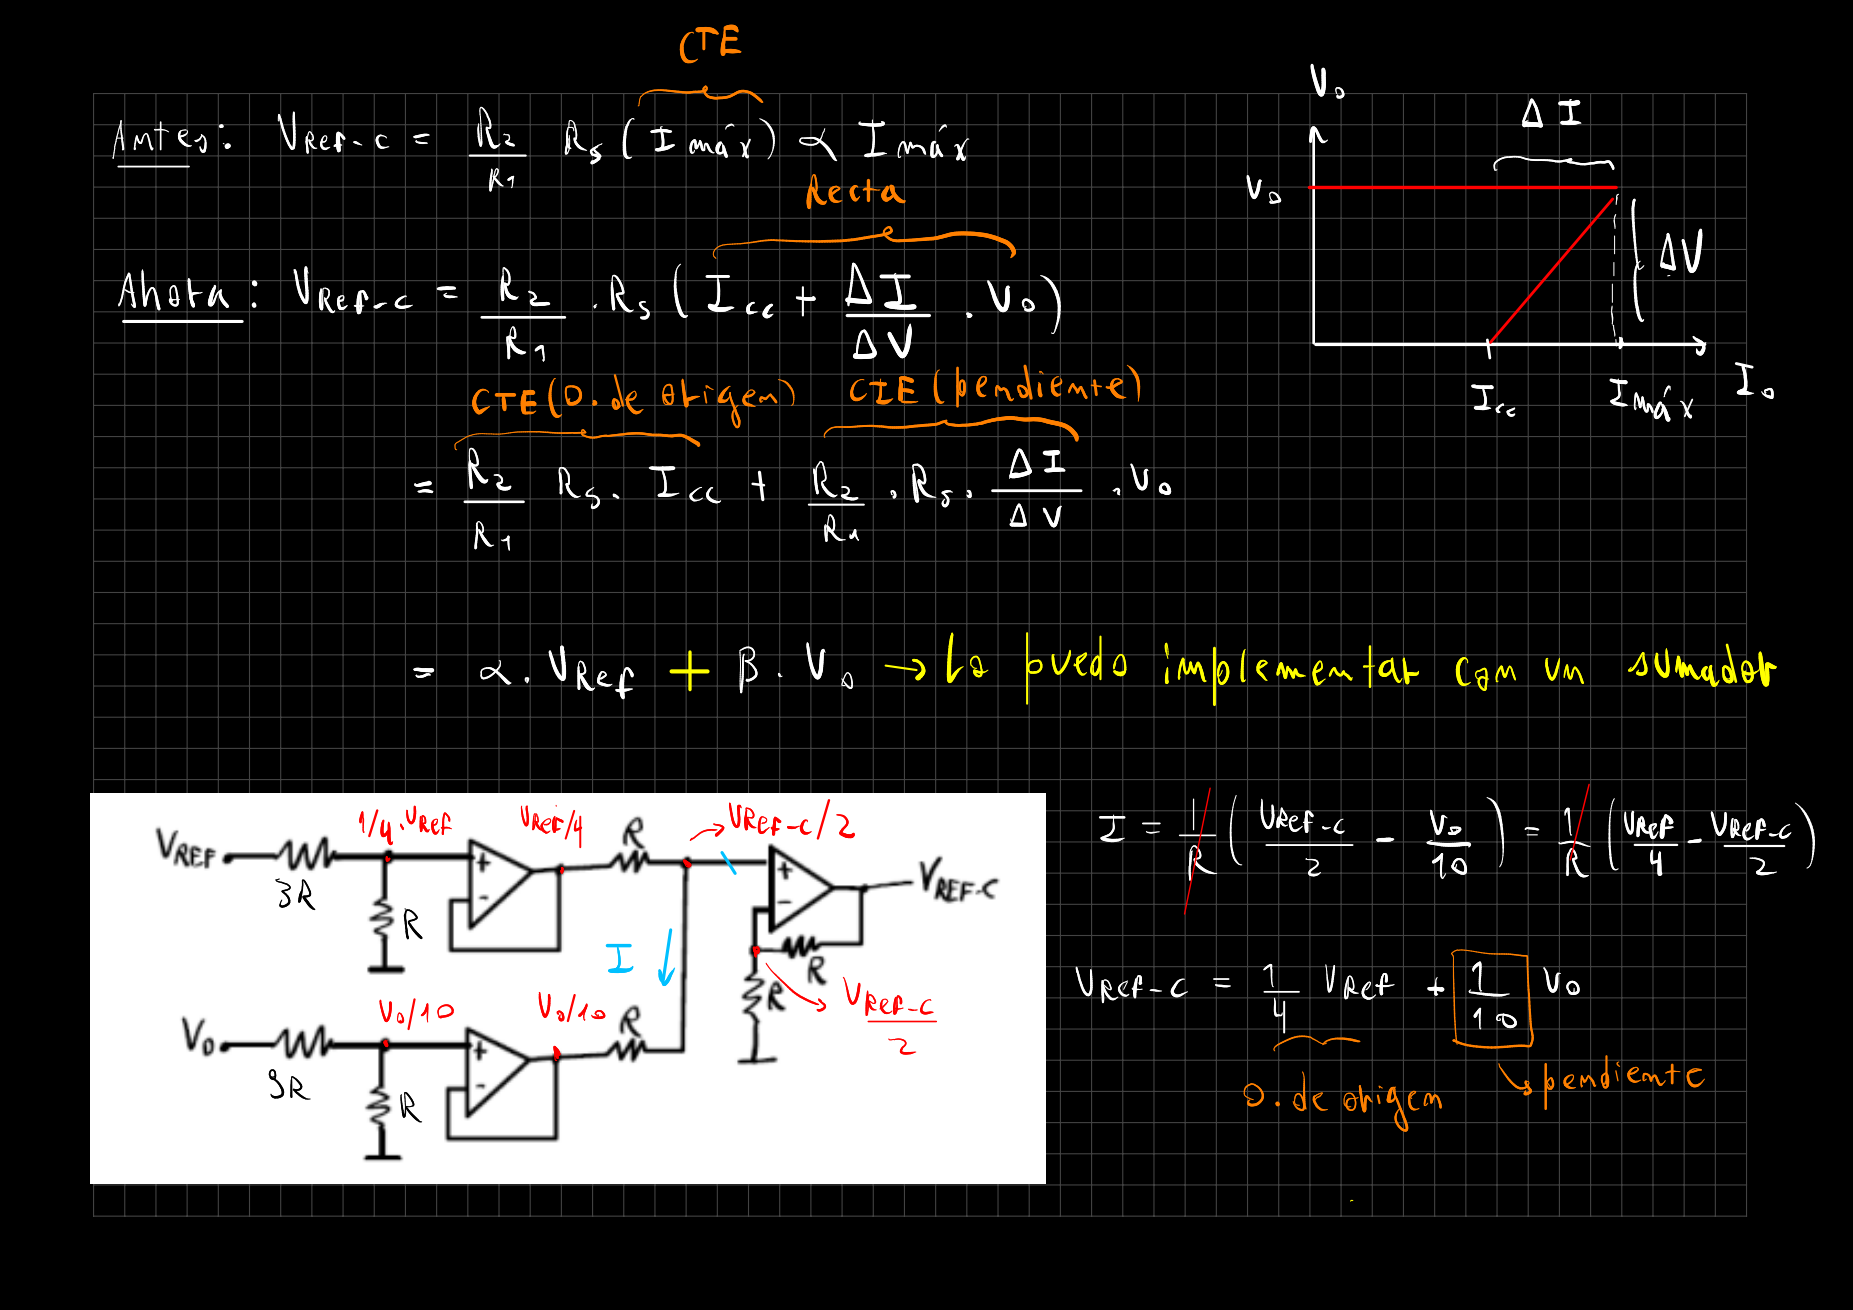
[picture p205: page 17]

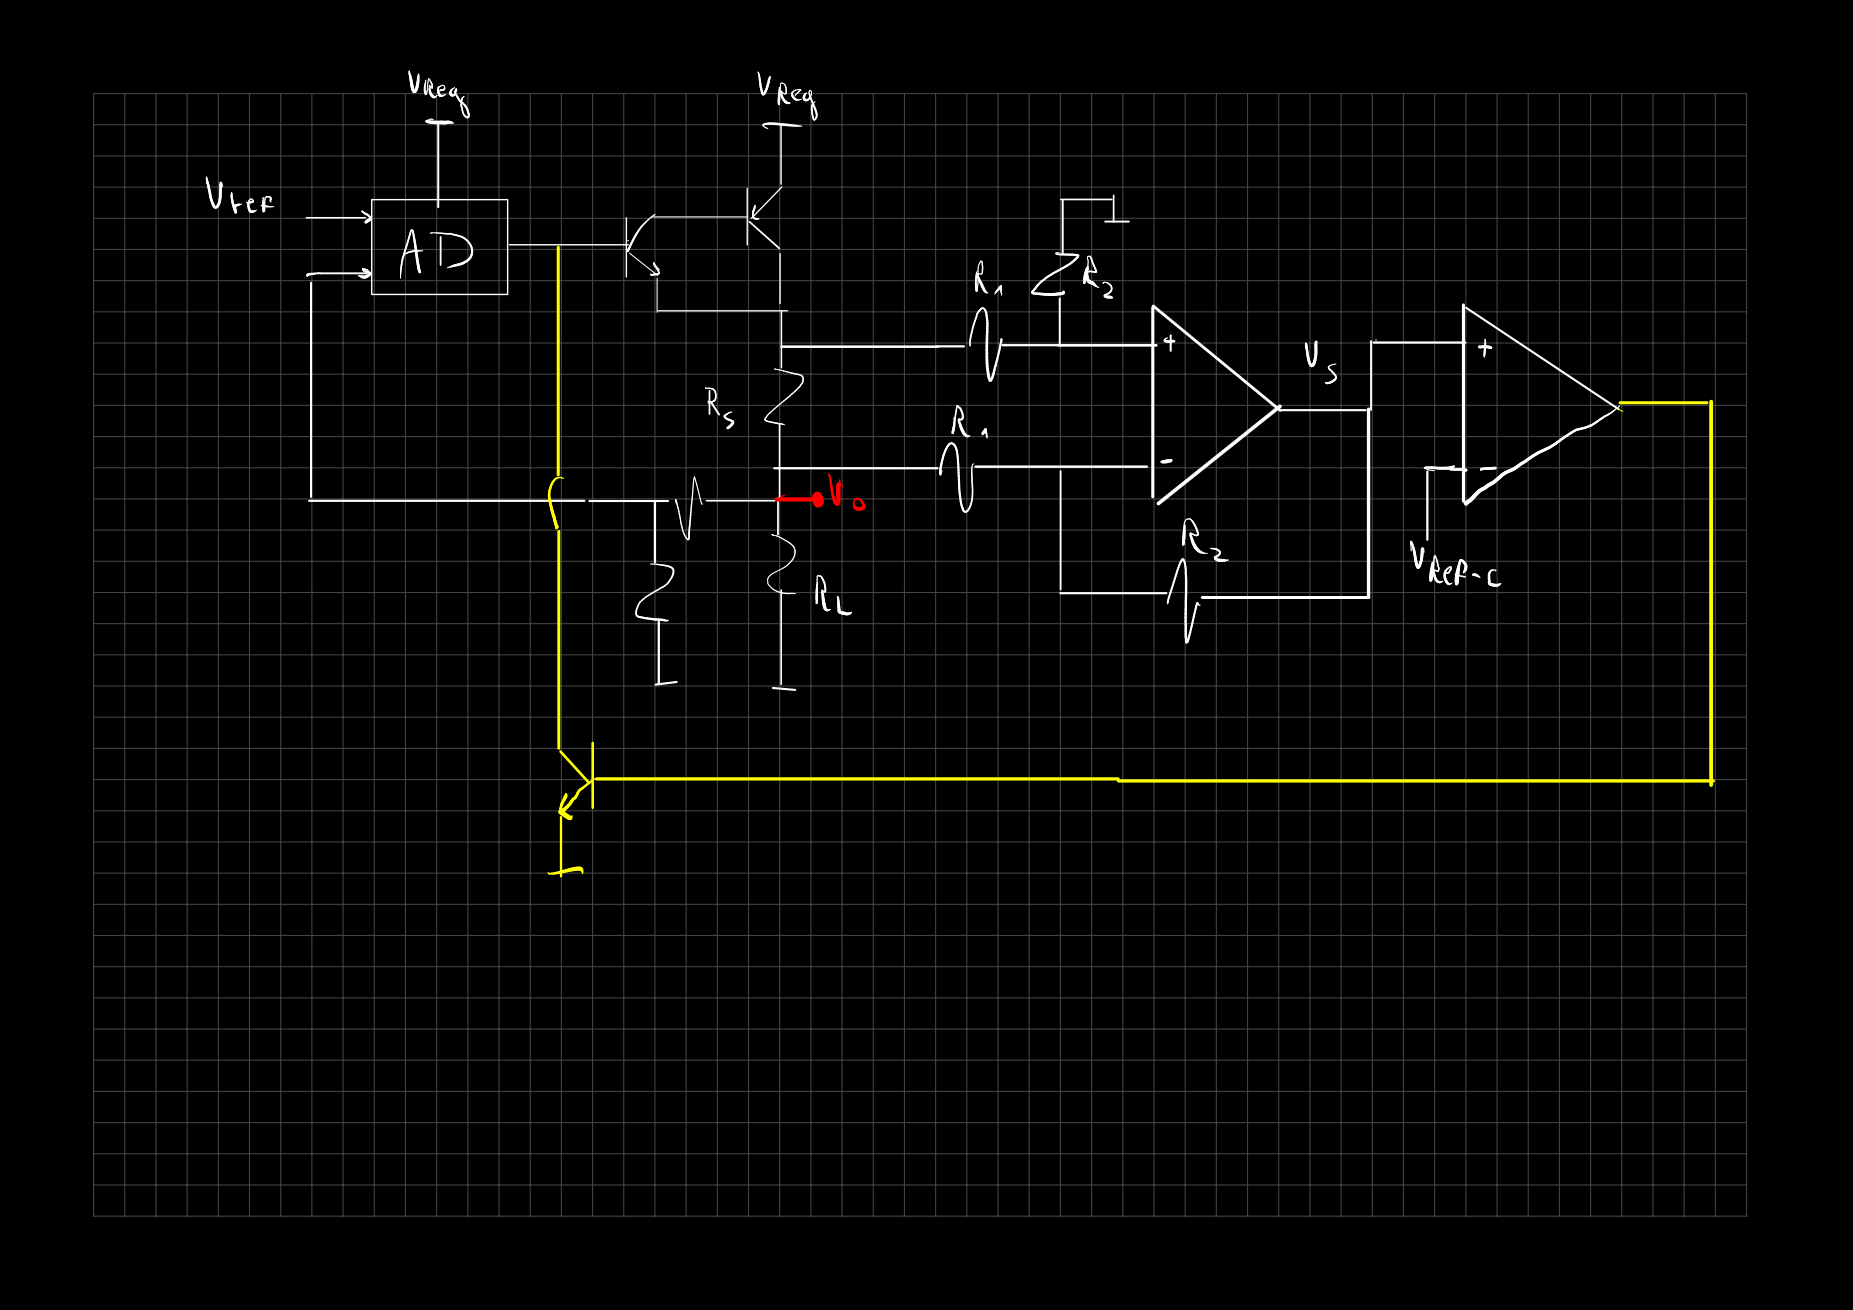
[picture p206: page 18]

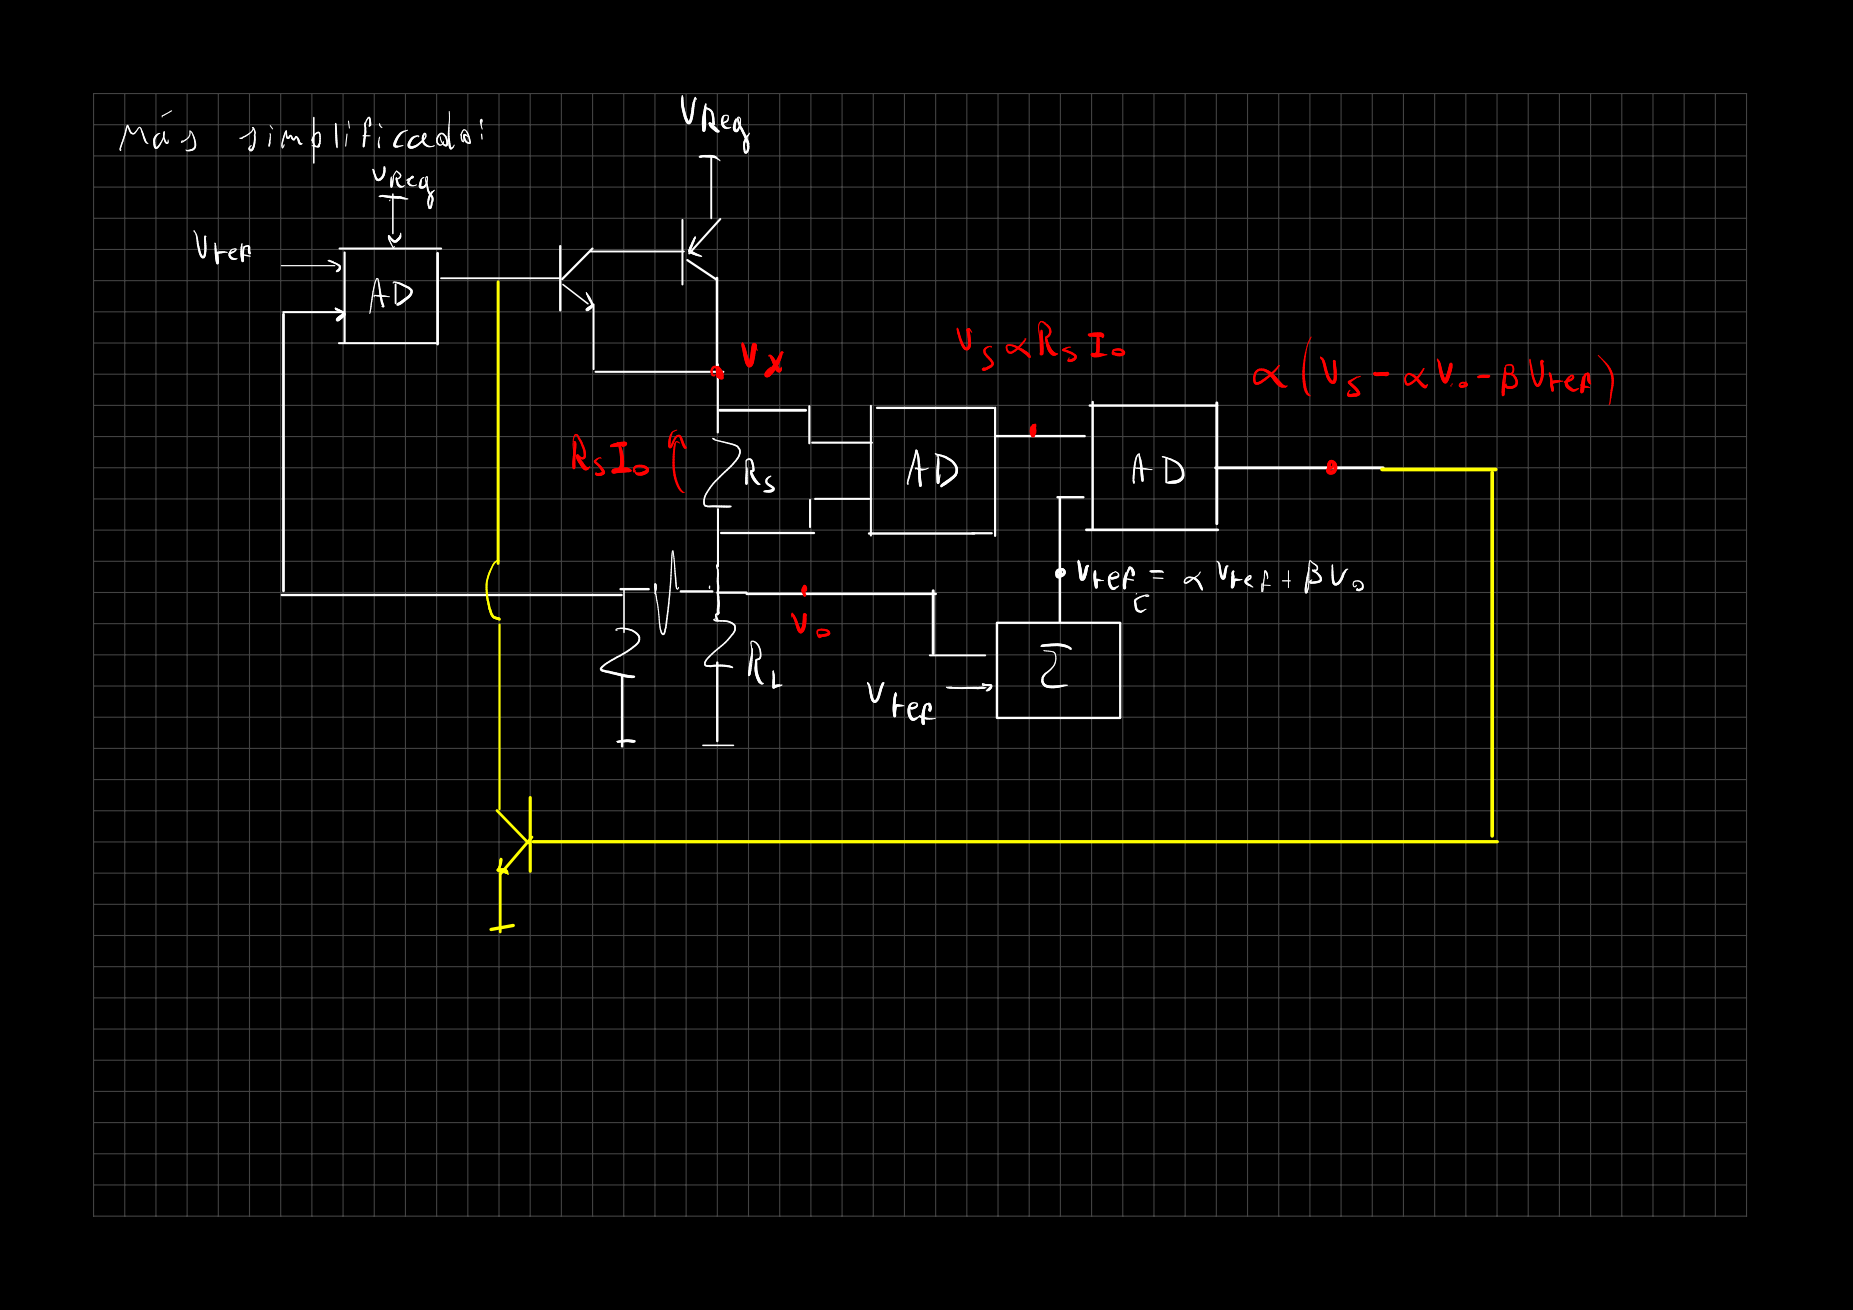
[picture p207: page 19]

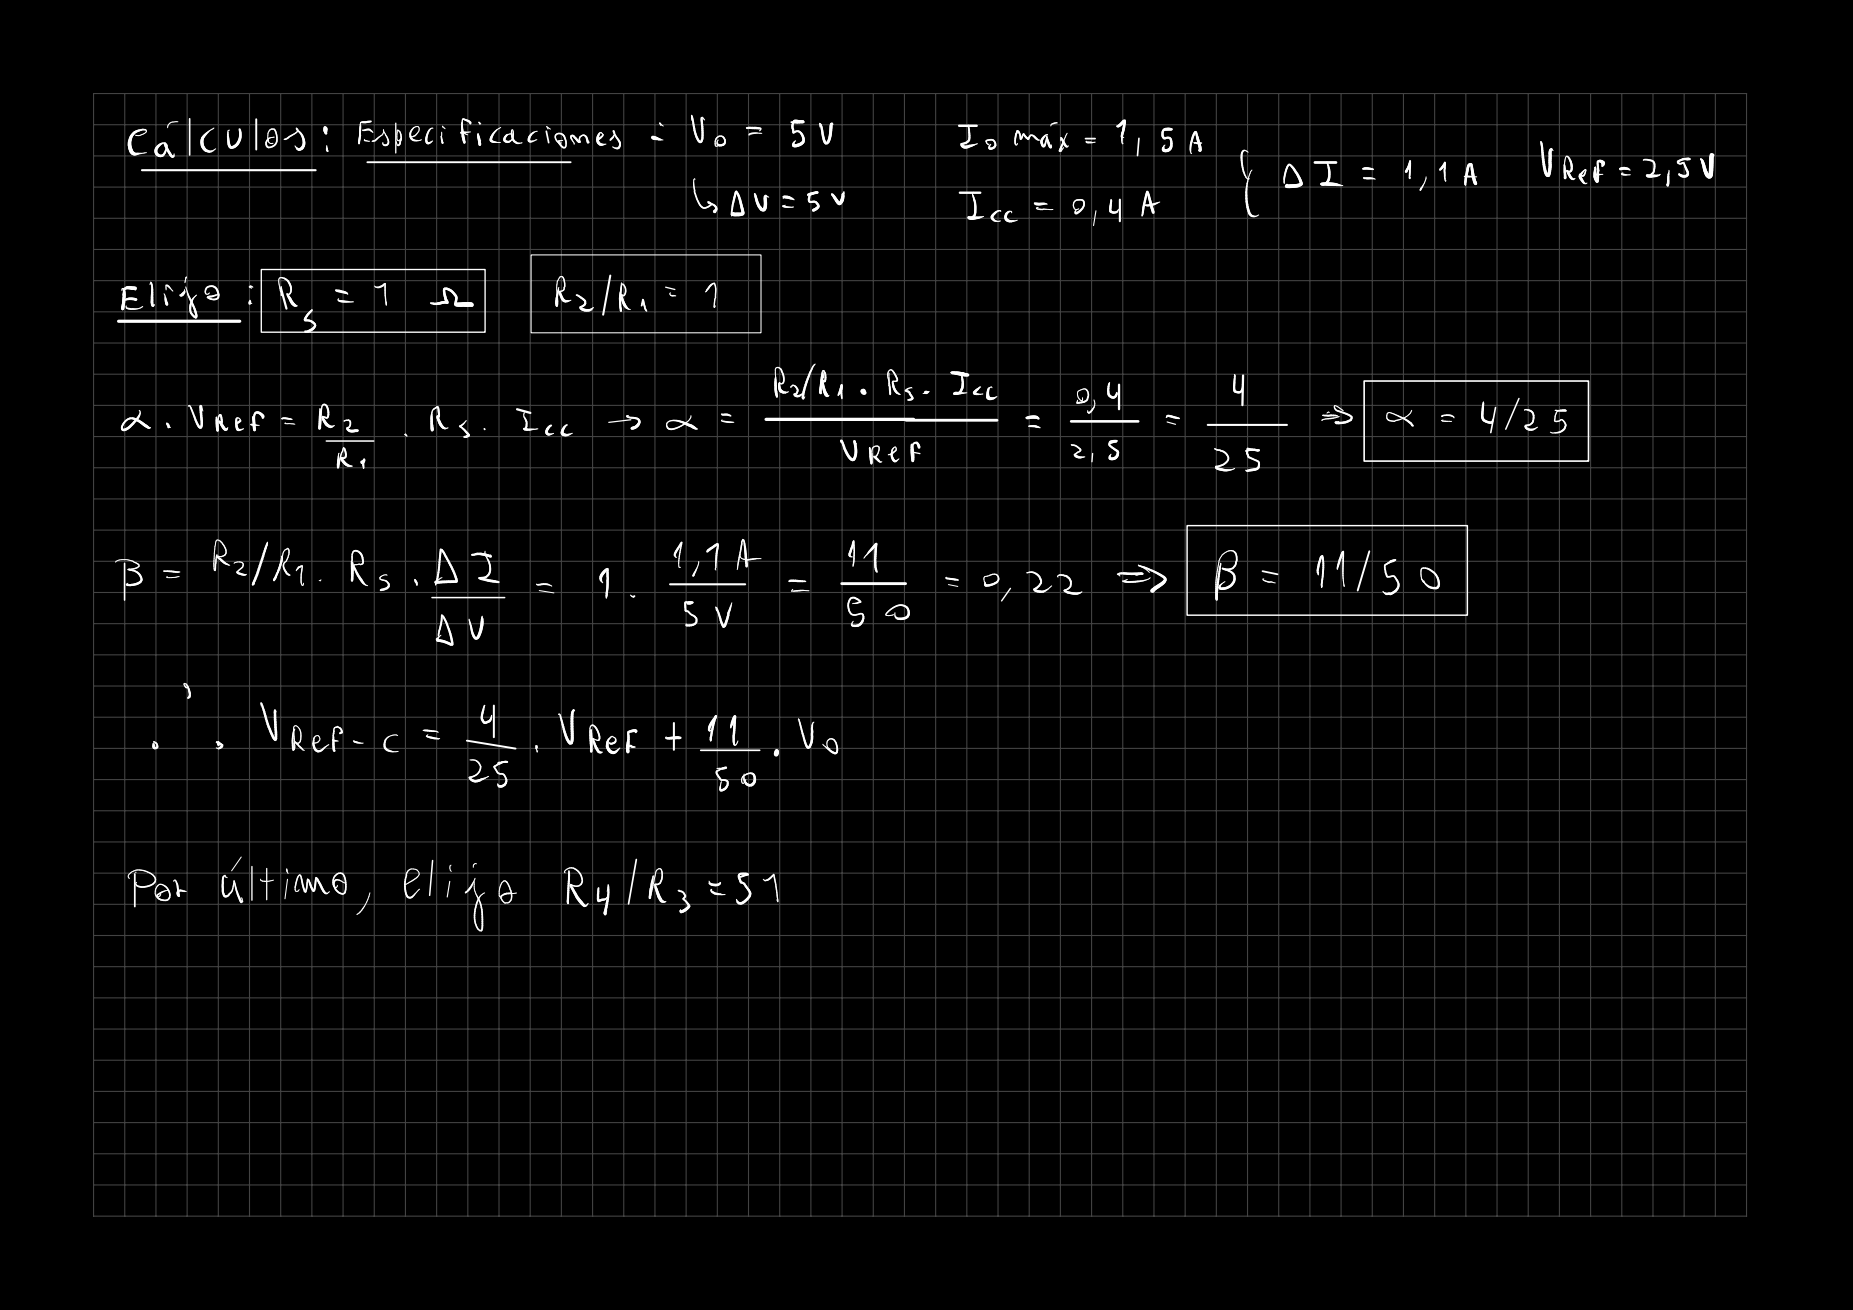
[picture p208: page 20]

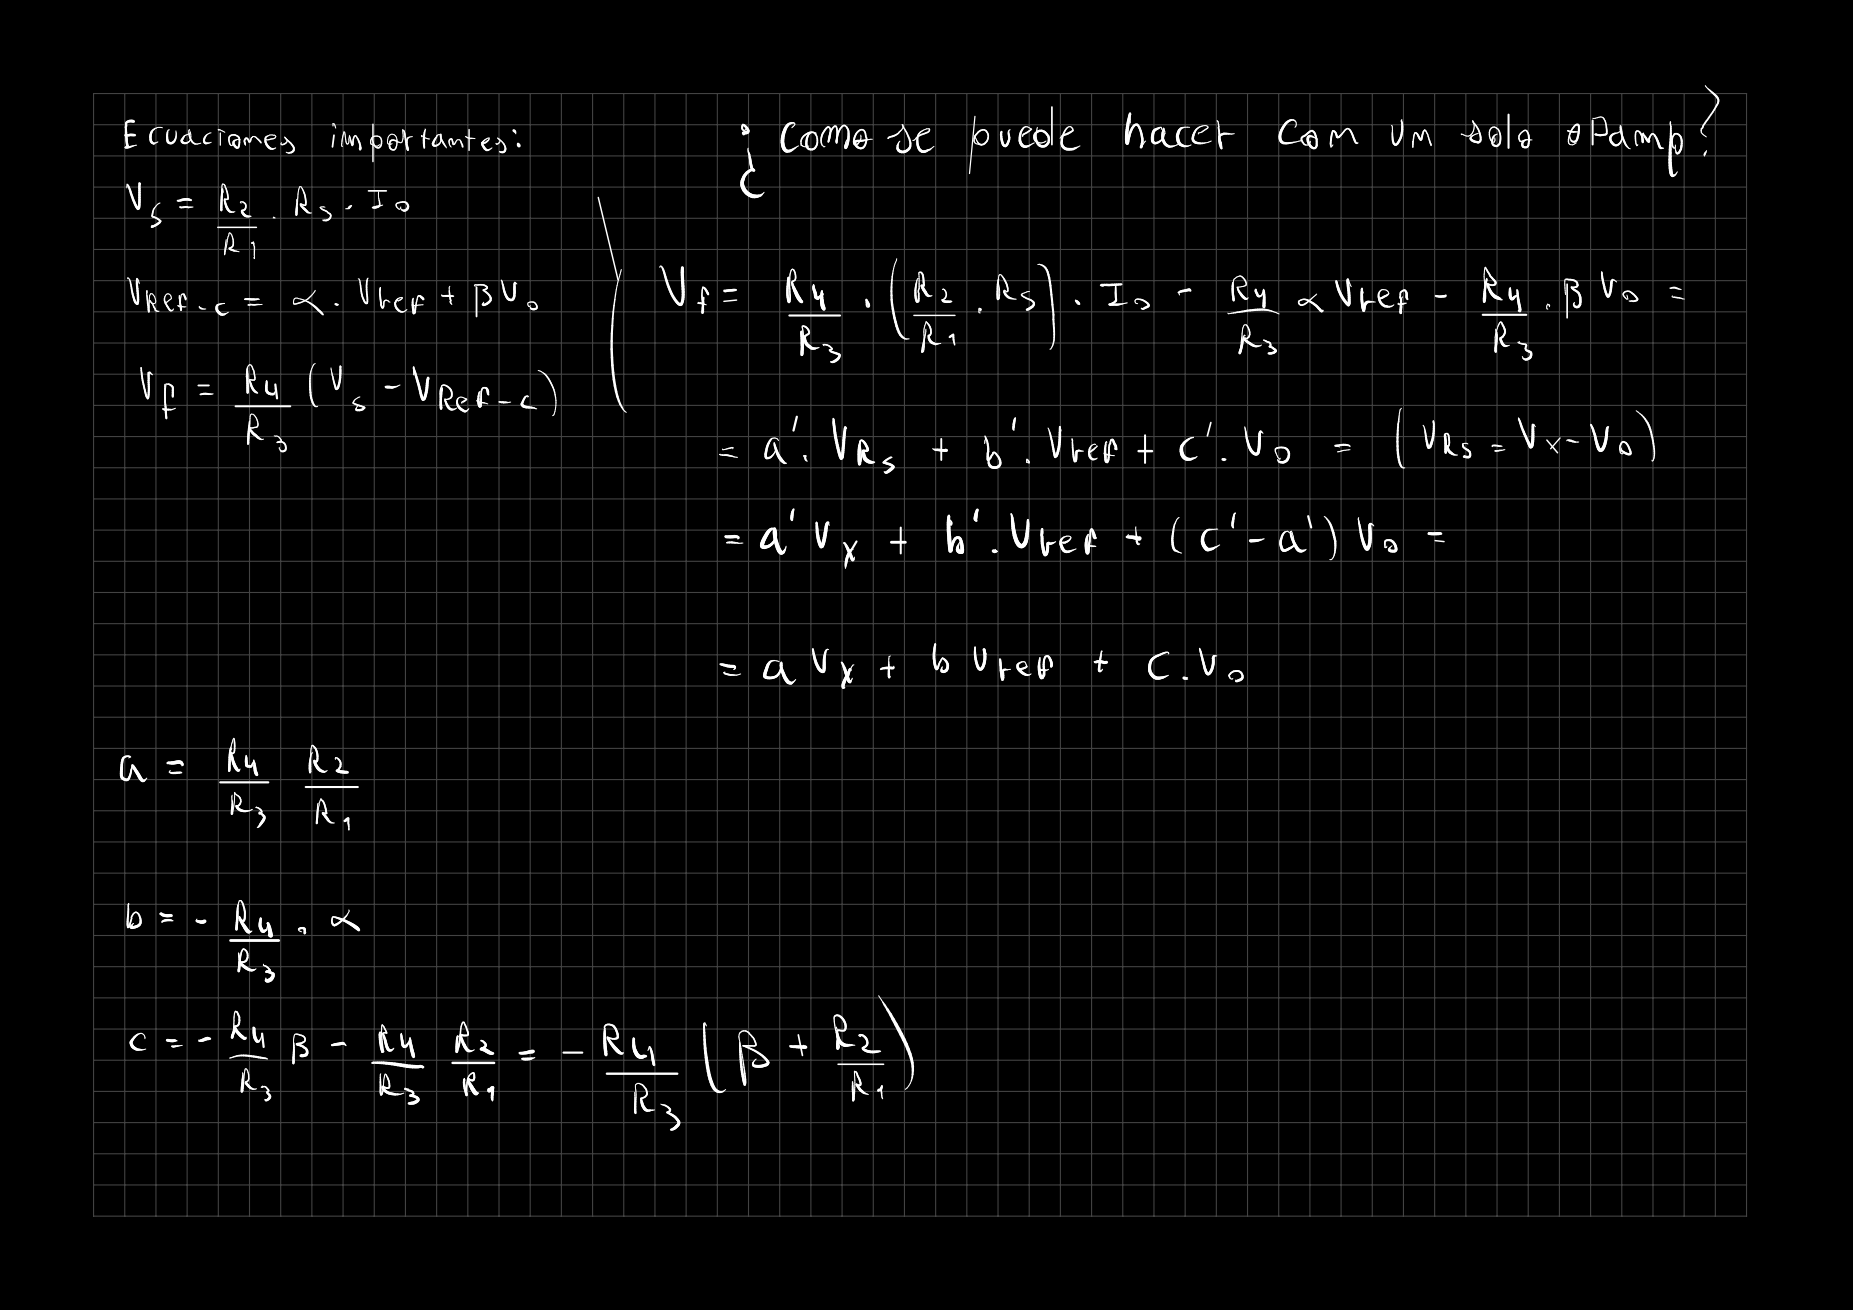
[picture p209: page 21]

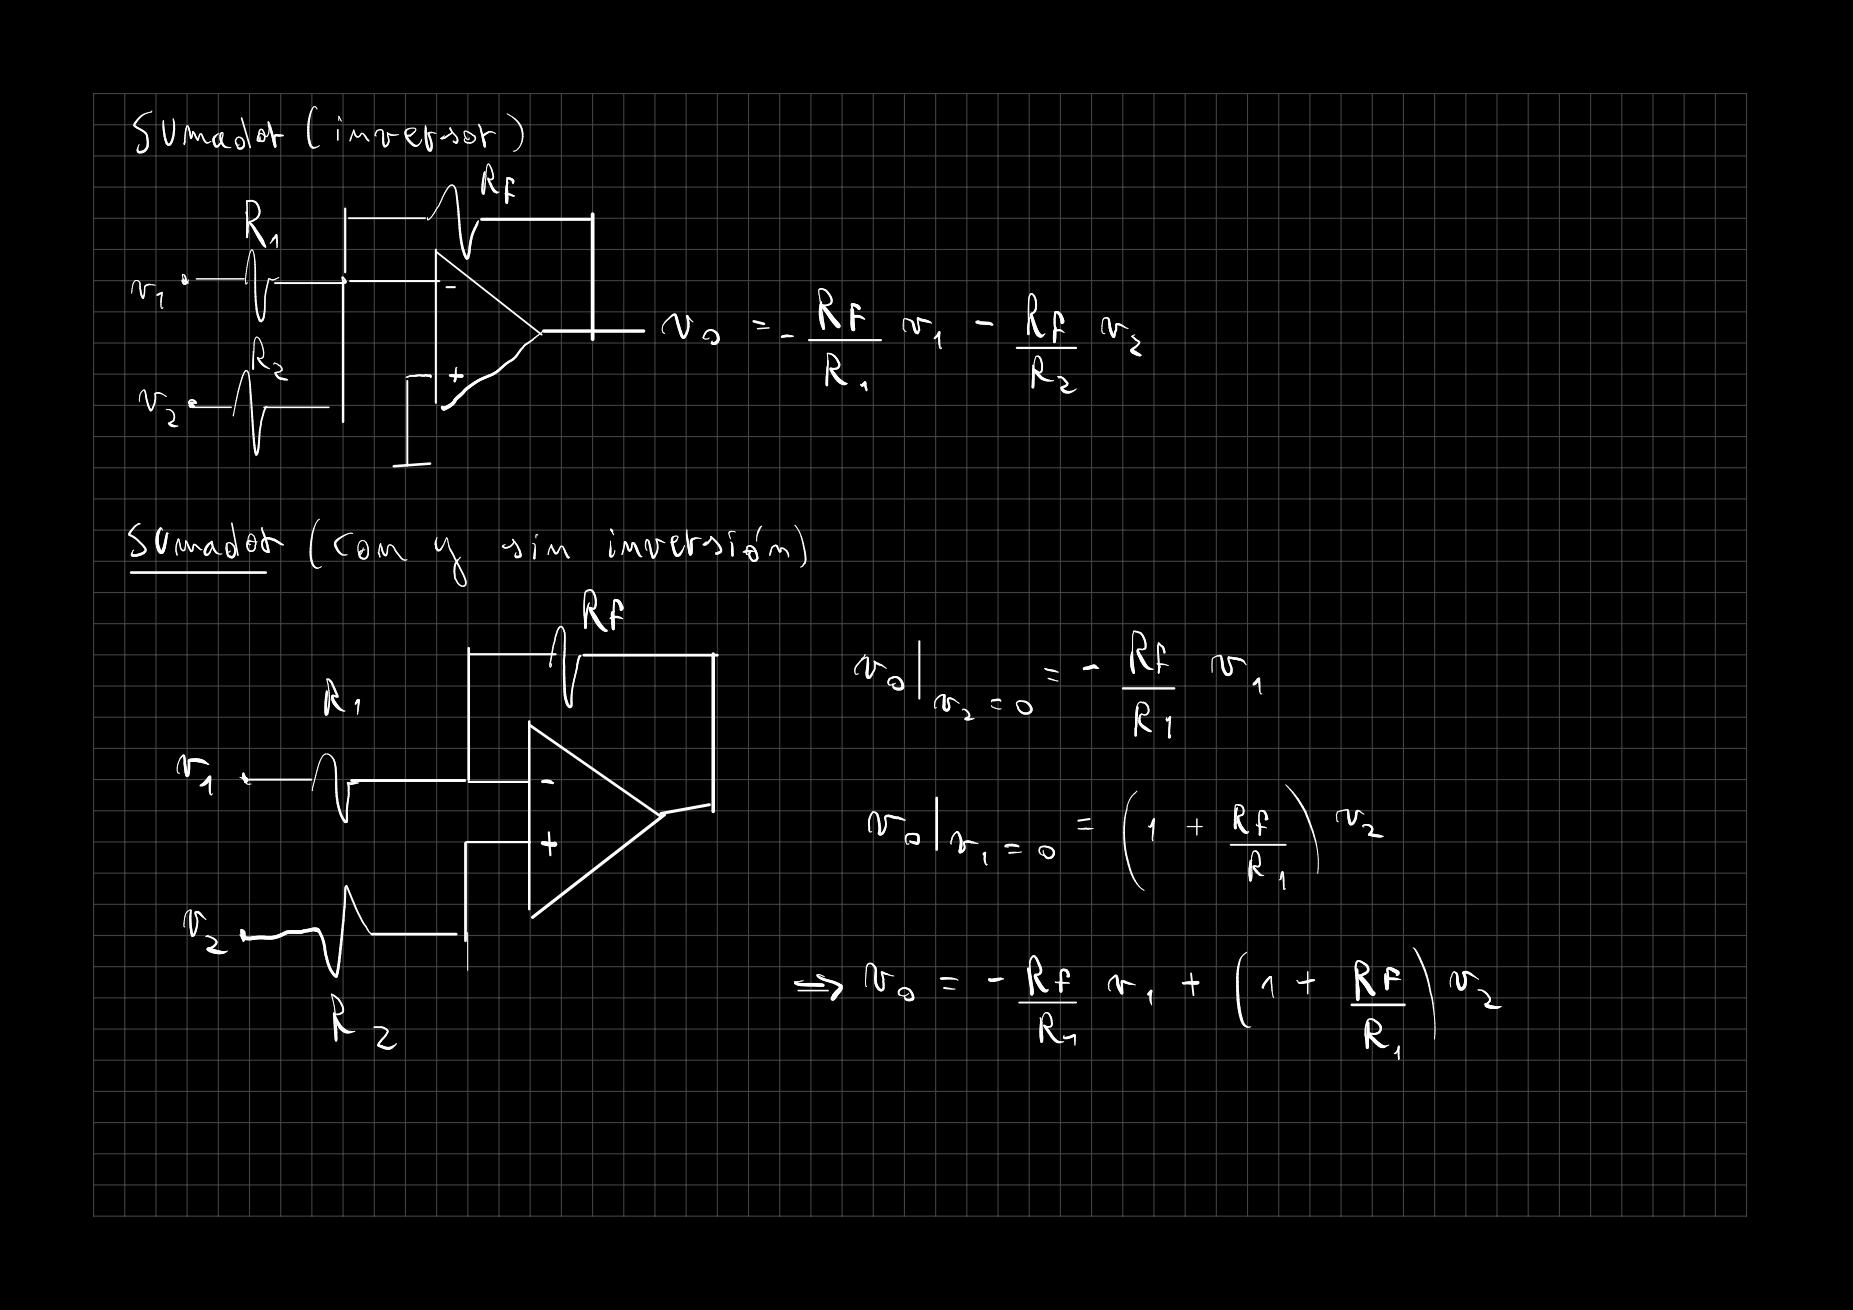
[picture p210: page 22]

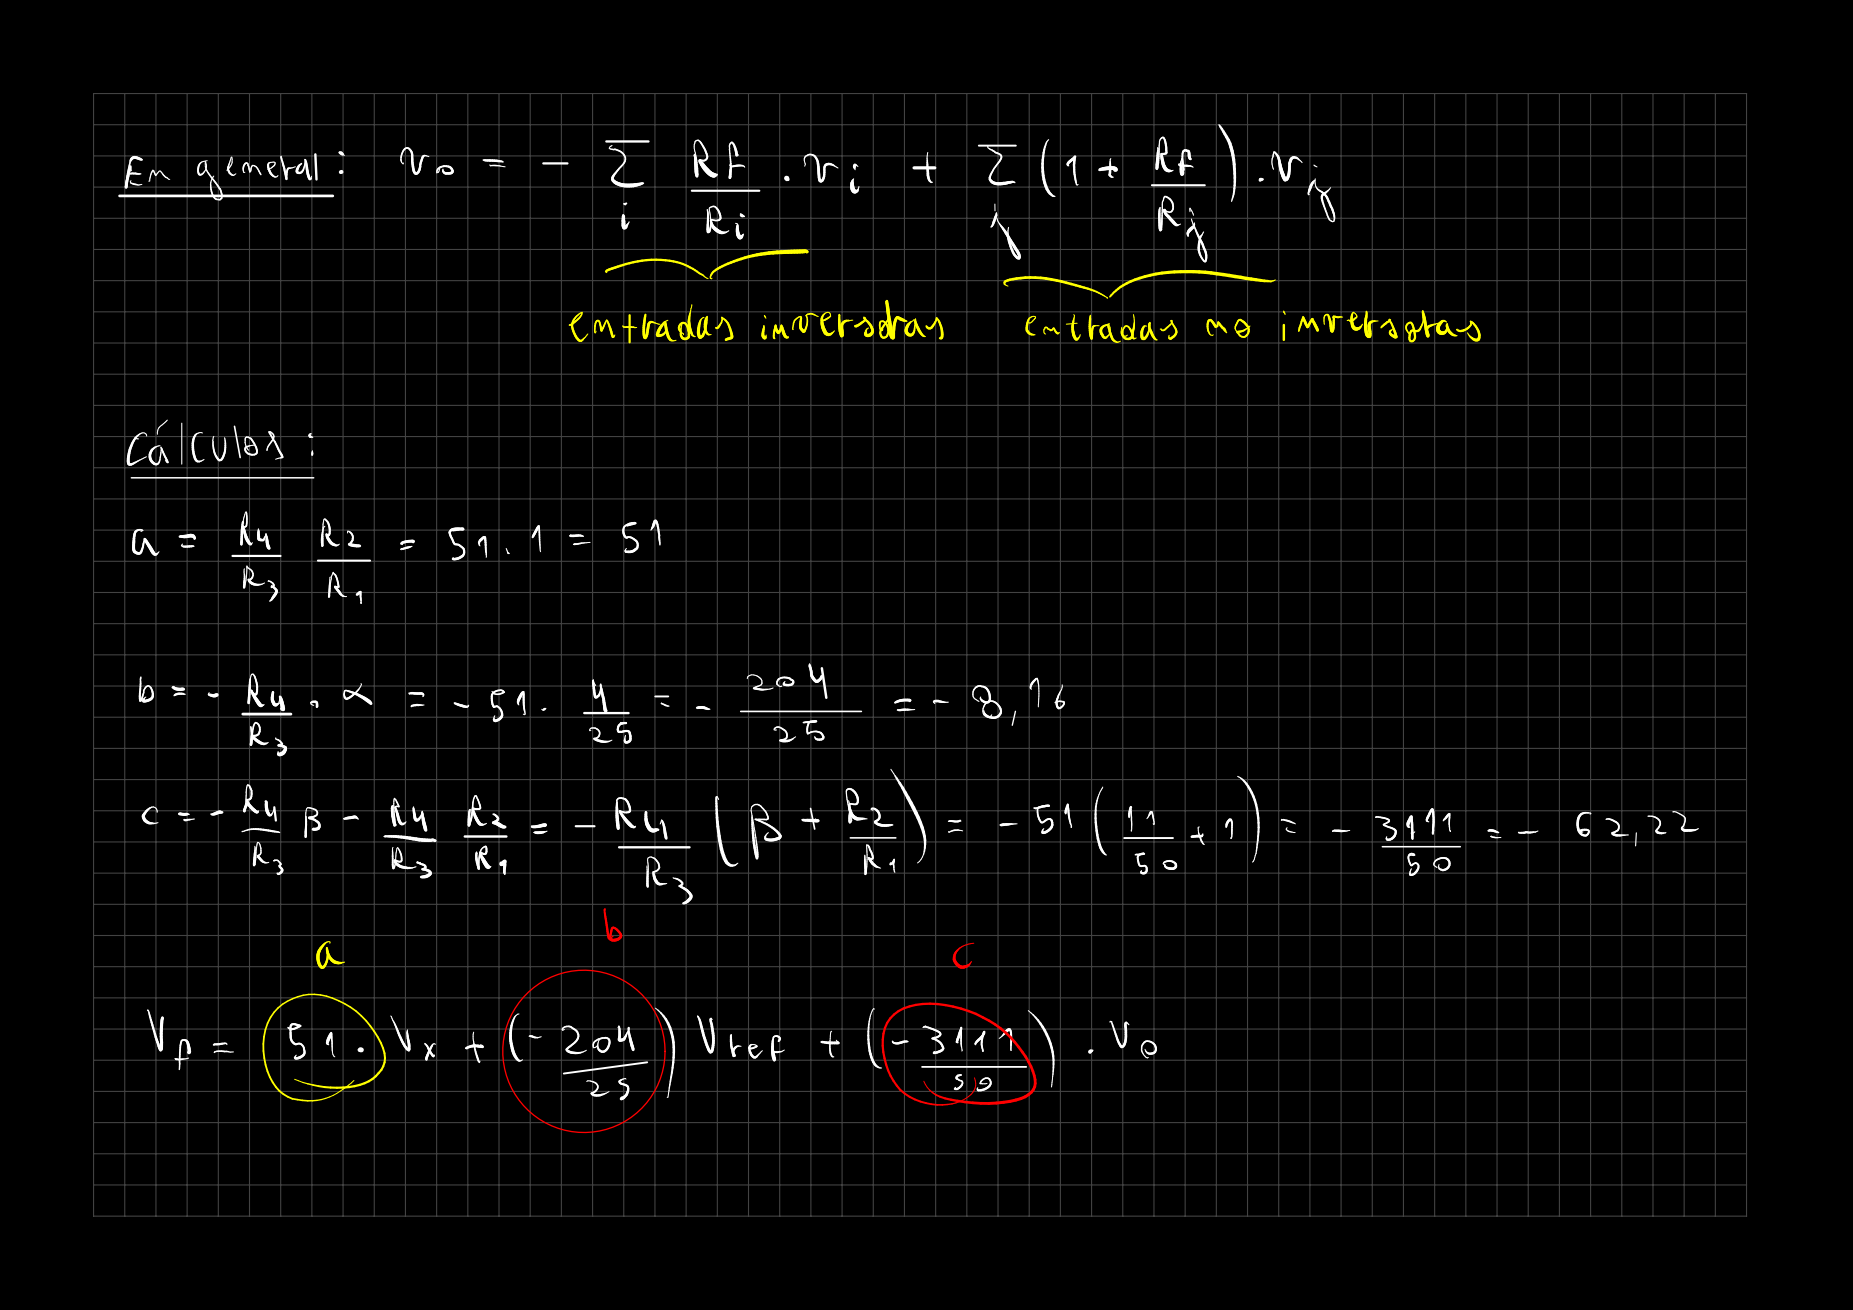
[picture p211: page 23]

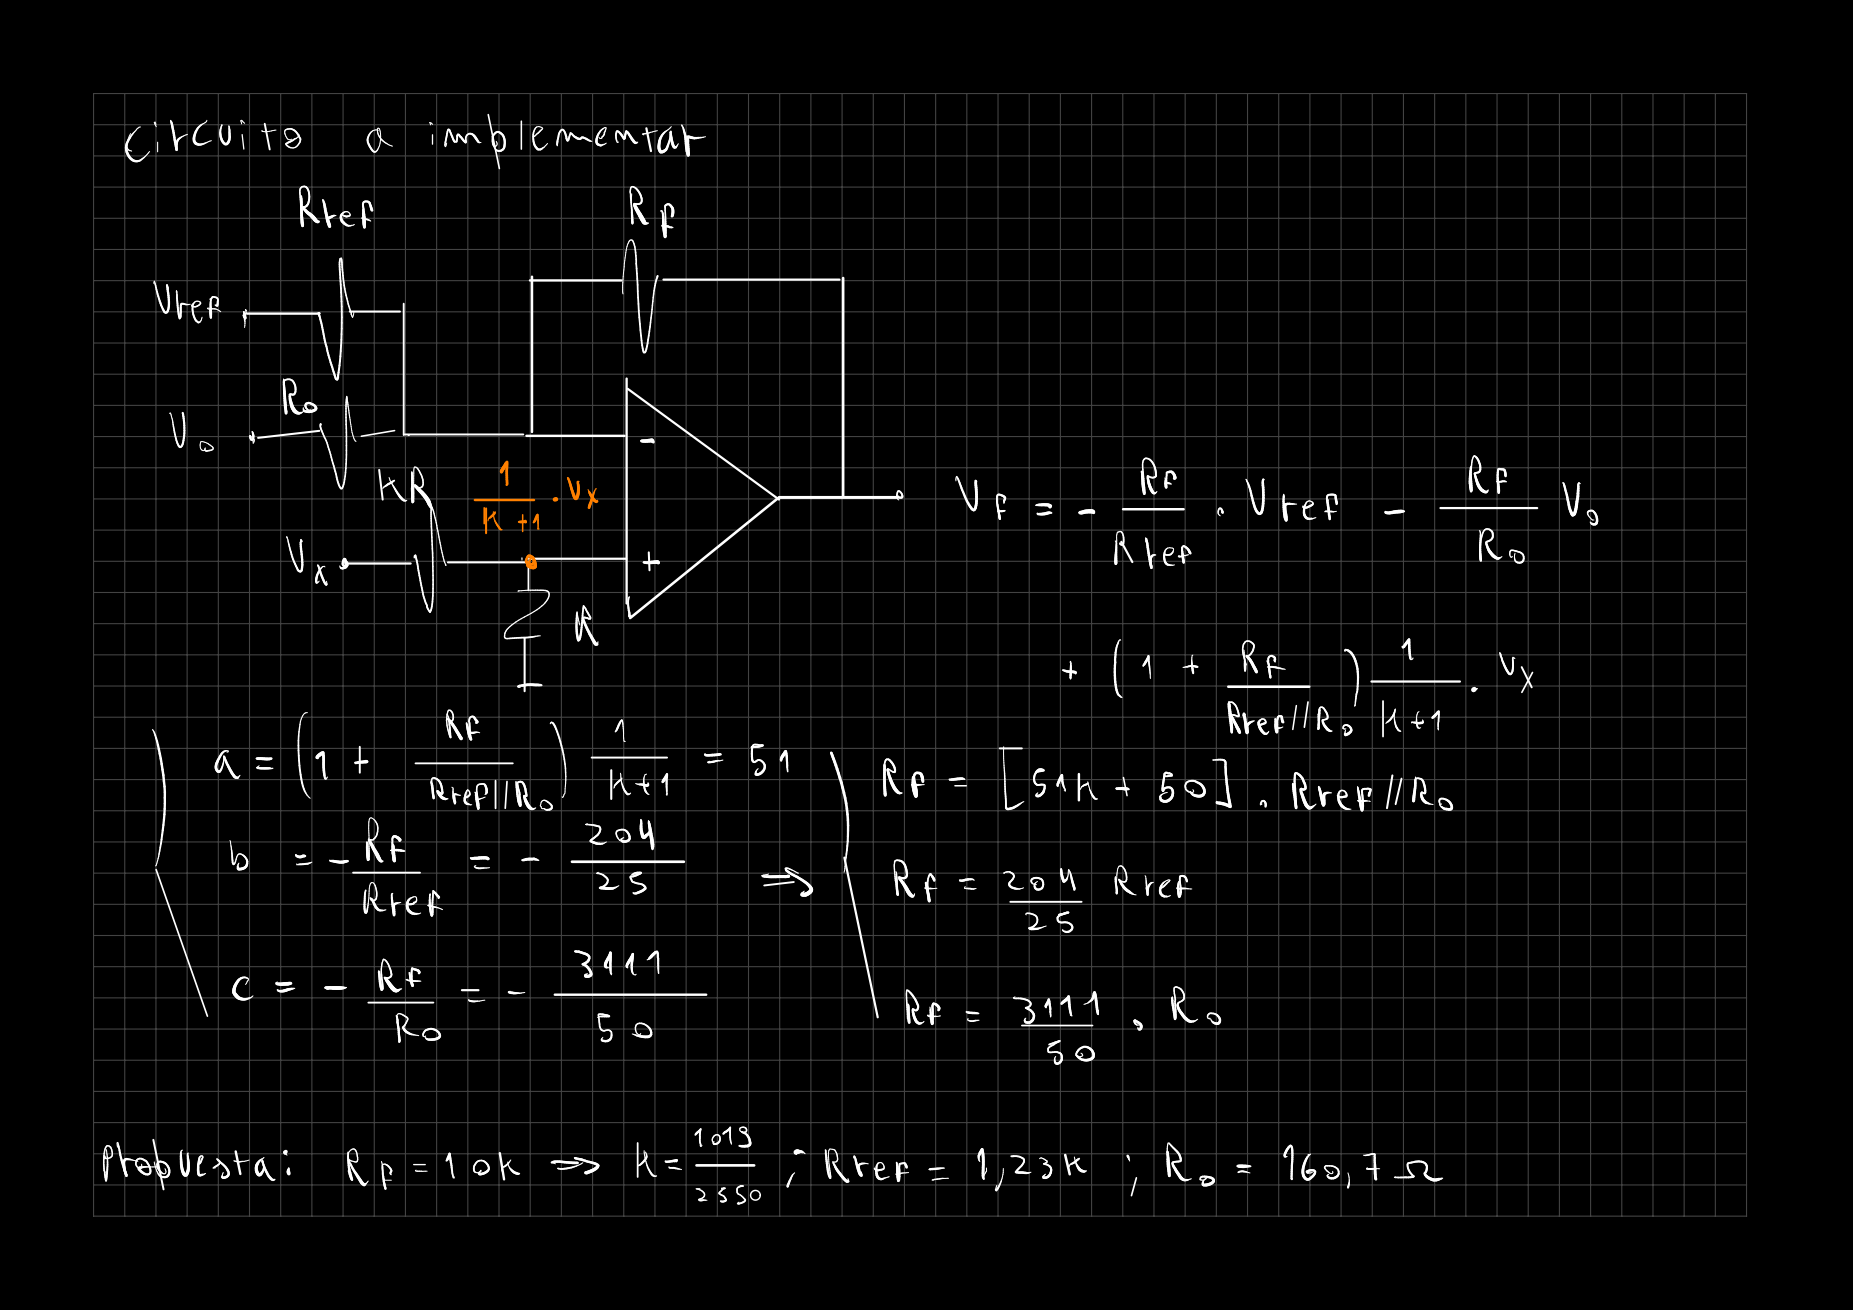
[picture p212: page 24]
