Fjmoya-uba/Taller-de-Circuitos-Grupo-4/Checkpoint 3/Simulaciones/Cuentas(nada útil).pdf

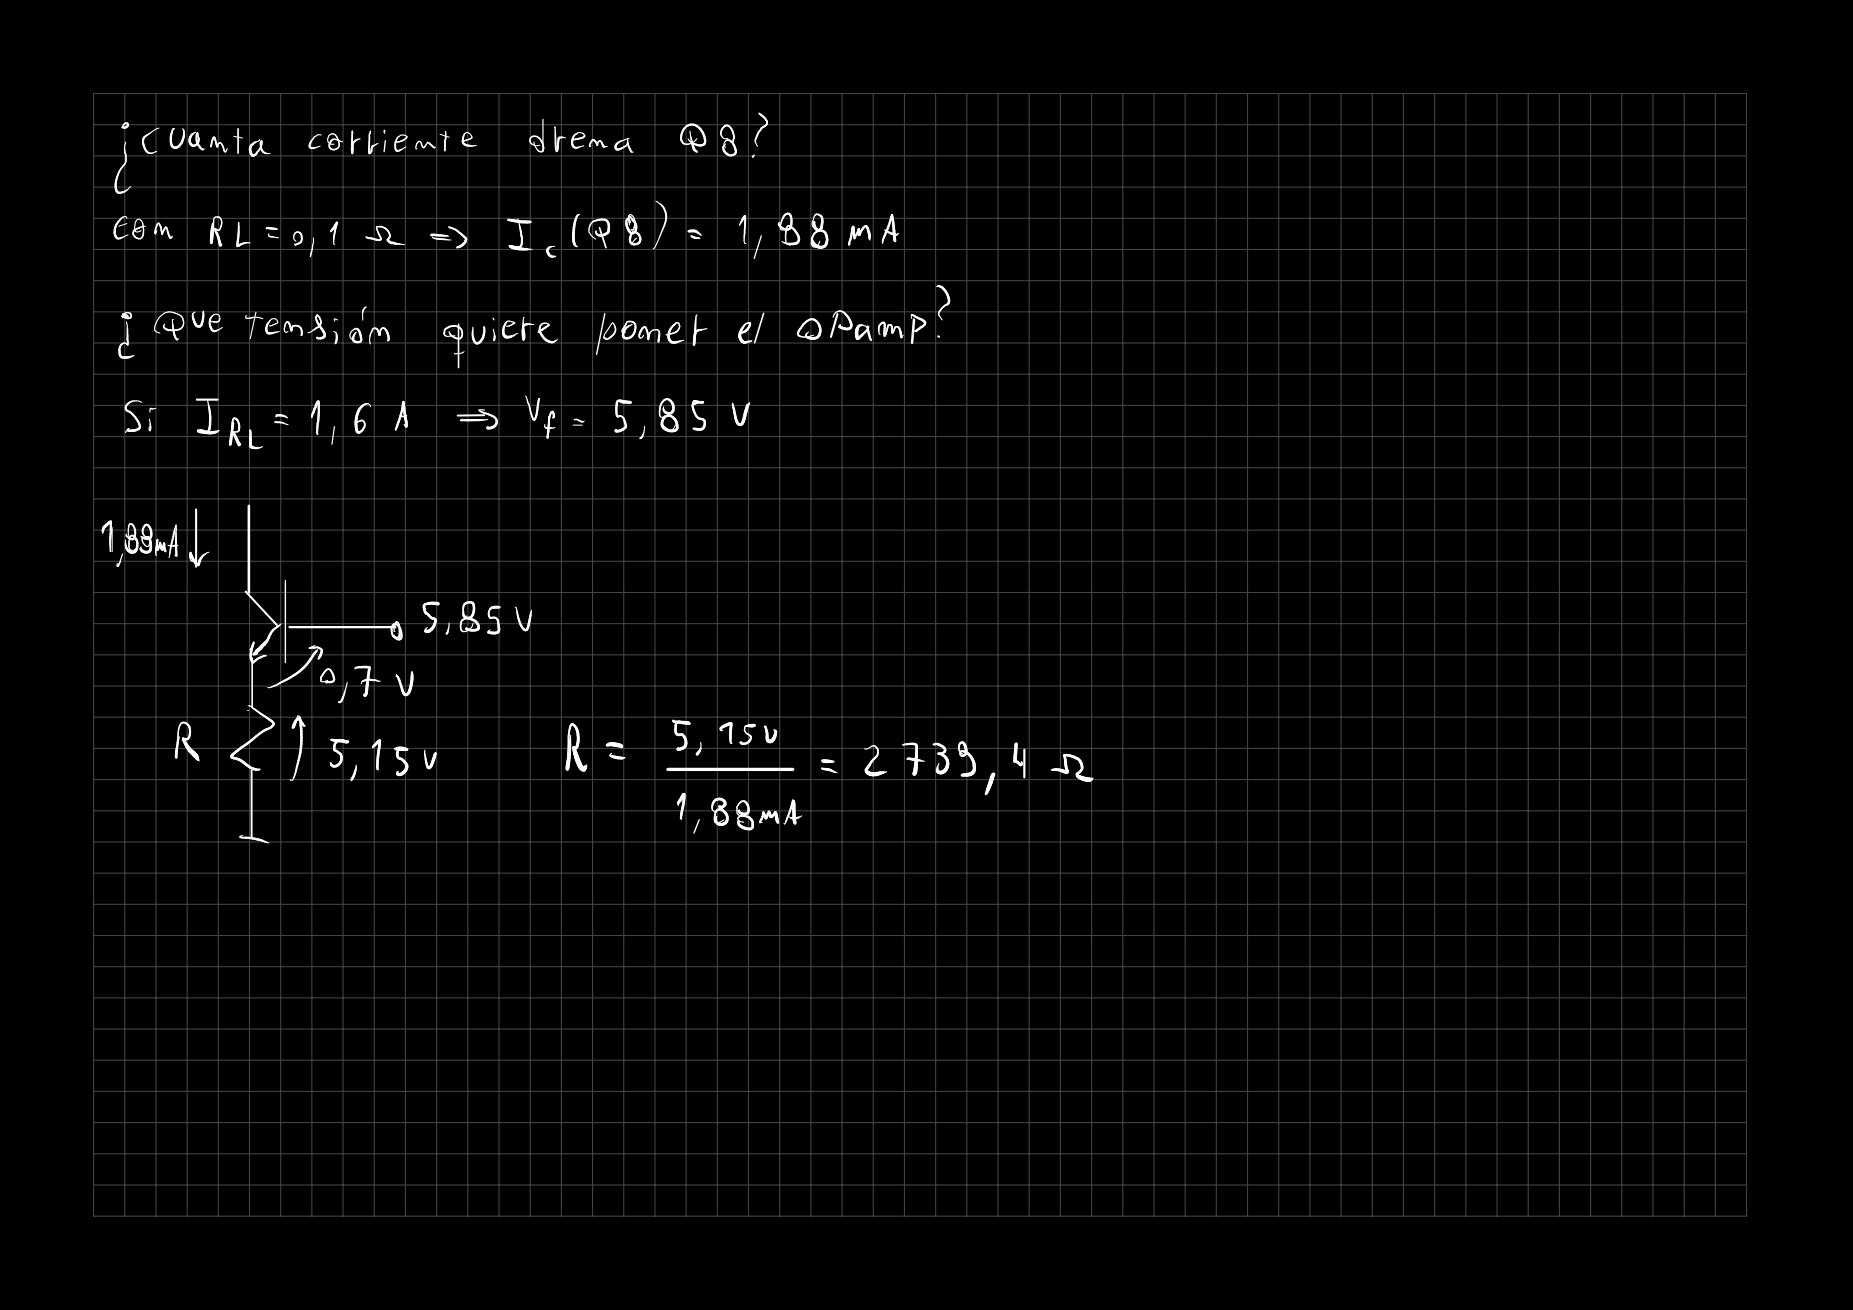
[picture p213: page 1]
