Fjmoya-uba/Taller-de-Circuitos-Grupo-4/Checkpoint 2/KiCAD/esquematico.pdf

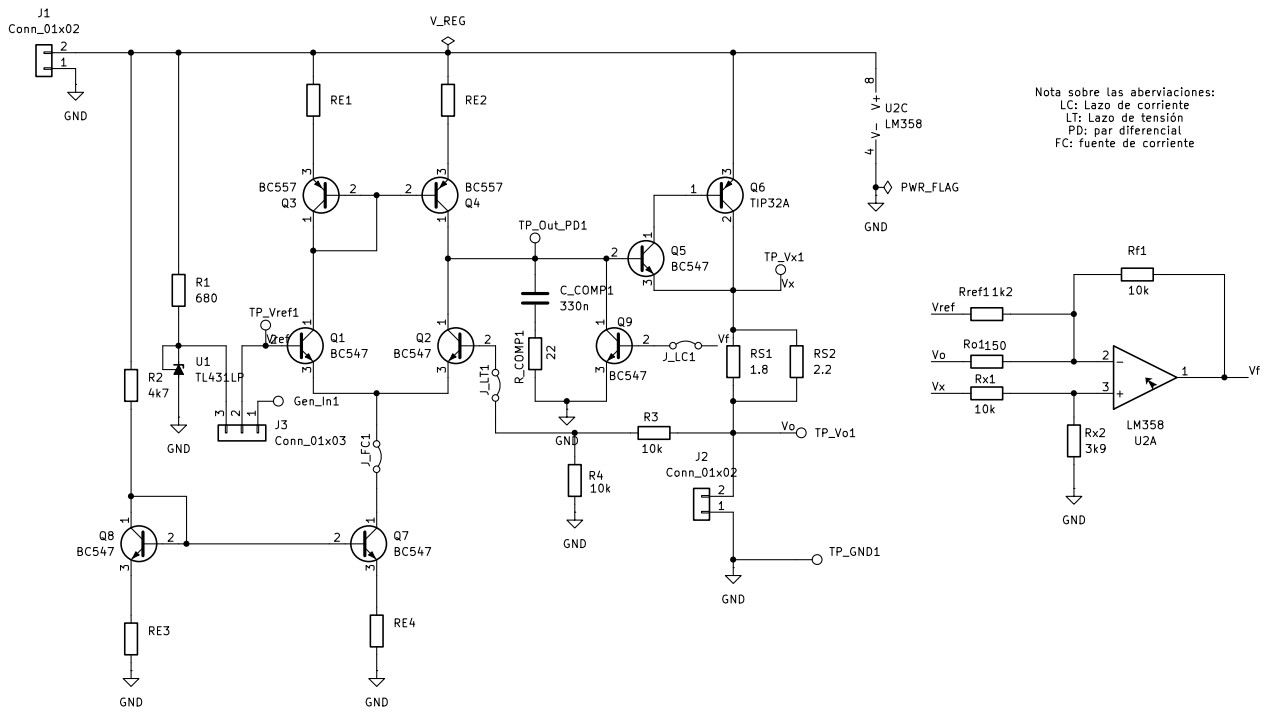
[picture p214: page 1]
