Fjmoya-uba/Taller-de-Circuitos-Grupo-4/Checkpoint 3/Simulaciones/Experimento_foldback.asc

Q1: npn; BC547B
R1: res; 1k
R8: res; 680
Rf: res; 10k
RLC1: res; 3k9
RLC2: res; 1k
Ro: res; 150
Rref: res; 1k2
Rx1: res; 3k9
Rx2: res; 10k
U1: opamp2; LM358
U2: TL431
V1: voltage; 9.5
V2: voltage; 0
V3: voltage; 5
Named nets: 0, Vreg, Vref
.dc V2 0 2
.inc lm358.lib
Nota: es muy complicado armarlo en la proto y probarlo a parte, neceistamos muchos
resistores y como 3 fuentes. Conviene más soldarlo en la placa y probarlo con el lazo 
de corriente desconectado.
 
Nota 2: puede convenir reajustar los valores de los resistores del divisor resistivo del 
lazo de corriente (RLC1 y RLC2).
 
Cuando la tensión V2 es 1.5V (estarían circulando 1.5 A por RS), la salida del opamp 
es 1.4. Queremos bajarla a la mitad para alimentar al TBJ. RLC1 tiene que ser igual a
RLC2 para bajarla a la mitad
 
En al simulación anda joya, pero la vida real es otra cosa como sabemos
