Fjmoya-uba/Taller-de-Circuitos-Grupo-4/carga activa tab vertical/carga_activa rail to rail.asc

M1: nmos; IRFH6200
R1: res; 2k
R2: res; 2
R3: res; 1k
R5: res; 1
R6: res; 1Meg
U1: UniversalOpAmp2
U2: UniversalOpAmp2
V1: voltage; 0
V2: voltage; {V2}
V_load: voltage; 5
VIN: voltage; 12
Named nets: 0, vcc
.lib tip32a.lib
.param alpha=0.5
.step param V2 0.01 10 0.5
.op
