Fjmoya-uba/Taller-de-Circuitos-Grupo-4/carga activa tab vertical/carga_activa.asc

C1: cap; 10Meg
C2: cap; 100n
L1: ind; 10
M1: nmos; IRFH6200
Q1: pnp; BC557C
Q2: pnp; BC557C
Q3: npn; BC547C
Q4: npn; BC547C
Q5: pnp; BC557C
Q6: pnp; BC557C
Q7: npn; BC547C
Q8: npn; BC547C
R1: res; 470
R2: res; 2
R3: res; 5600
R4: res; 6200
R9: res; 100
R10: res; 100
R11: res; 1k
R12: res; 2k
R13: res; 1k
V1: voltage; 2.5
V2: voltage; {V2}
V3: voltage; ""; AC 1
V_load: voltage; 5
VIN: voltage; 12
Named nets: 0
.lib tip32a.lib
.tran 1
.param alpha=0.5
.step param V2 0.01 10 0.1
.op
.ac dec 100 1 50meg
