Fjmoya-uba/Taller-de-Circuitos-Grupo-4/Checkpoint 1/Simulaciones/Foldback_un_opamp.asc

Q1: npn; BC547B
Q2: npn; BC547B
Q3: pnp; BC557B
Q4: pnp; BC557B
Q5: npn; BC547B
Q6: npn; BC547B
Q7: npn; BC547B
Q8: npn; BC547B
Qtip32a: pnp
R1: res; 10k
R2: res; 10k
R3: res; 4k7
R4: res; 1k
R5: res; 1
R6: res; 10k
R7: res; 3.9k
R8: res; 150
R9: res; 1.2k
R10: res; 10k
RL: res; 6
U1: TL431
U2: opamp2; LM358
Vreg1: voltage; 9.5
Named nets: 0, Vref, Vreg, Vo, Vx, Vf
.op
.step dec param RL 10 0.1 50
.include tip32a.lib
.lib opamp.sub
.inc lm358.lib
.include TL431.mod
