Fjmoya-uba/Taller-de-Circuitos-Grupo-4/Checkpoint 4/Simulaciones/Oscilador.asc

C1: cap; 330p
R1: res; 510k
R2: res; 510k
R3: res; 15k
R4: res; 56k
R5: res; 1k2
Rf1: res; 510k
U1: opamp2; TL062
U2: opamp2; TL062
U3: opamp2; LM2903B
V1: voltage; PULSE(0 9 0 1n 0 1)
Named nets: 0, Vcc, Vref, Cuadrada, Triangular
.tran 50u
.include LM393.lib
.include TL062.301
