Fjmoya-uba/Taller-de-Circuitos-Grupo-4/Checkpoint 4/Simulaciones/PWM_de_sergio.asc

C1: cap; 330p
R1: res; 300k
R2: res; 300k
R3: res; 510k
R4: res; 56k
R5: res; 15k
U1: LTC6702
U4: ADA4099-1
U5: ADA4099-1
V1: voltage; 9
Named nets: 0, VCC, Va, Vb
.tran 200u startup
