Fjmoya-uba/Taller-de-Circuitos-Grupo-4/Checkpoint 4/Simulaciones/ST-No inversor.asc

R1: res; 56k
R2: res; 510k
R3: res; 1k2
U1: LT1018; LM2903B
V1: voltage; ""
V2: voltage; 9
V3: voltage; 4.5
Named nets: 0, Vcc, Vref
.include LM393.lib
.dc V1 6 0 0.1
