Fjmoya-uba/Taller-de-Circuitos-Grupo-4/Checkpoint 4/Simulaciones/Buck-converter-12V.asc

C1: cap; 1µ
L1: ind; 356.5µ
M1: nmos; IRFZ44N
M2: nmos; IRFZ44N
R1: res; 36
V1: voltage; 12
VgH: voltage; PULSE(0 10 0 1n 1n 6.06u 7.69u)
VgL: voltage; PULSE(0 10 6.19u 1n 1n 1.40u 7.69u)
Named nets: 0, Vo, Vd
.tran 0 1000u 0
