Fjmoya-uba/Taller-de-Circuitos-Grupo-4/Checkpoint 4/Simulaciones/Buck-converter-30V.asc

C1: cap; 1µ
L1: ind; 356.6µ
M1: nmos; IRFZ44N
M2: nmos; IRFZ44N
R1: res; 36
V1: voltage; 30
VgH: voltage; PULSE(0 10 0 1n 1n 2.37u 7.69u)
VgL: voltage; PULSE(0 10 2.54u 1n 1n 5.05u 7.69u)
Named nets: 0, Vo, Vd
.tran 0 1000u 0
