Fjmoya-uba/Taller-de-Circuitos-Grupo-4/Checkpoint 4/Simulaciones/Buck-converter.asc

C1: cap; 200n
D1: schottky; MBR735
L1: ind; 720µ
M1: pmos; IRF9640
R1: res; 36
V1: voltage; 30
V2: voltage; PULSE(30 20 0 1n 1n 2.44u 7.69u)
Named nets: 0, Vo, Vg, Vd
.tran 0 1000u 0
