Fjmoya-uba/Taller-de-Circuitos-Grupo-4/Checkpoint 3/Simulaciones/Draft1.asc

D1: diode
D2: diode
R1: res; 1k
R2: res; 1k
R3: res; 1k
R4: res; 10k
U1: LT1018
V1: voltage; SINE(0 5 1)
V2: voltage; 5
V3: voltage; -5
Named nets: 0, v+, v-
.tran 5
