Fjmoya-uba/Taller-de-Circuitos-Grupo-4/Checkpoint 3/Simulaciones/Pop.asc

1k2: res; 900
C2: cap; 330n
Q1: npn; BC547B
Q2: npn; BC547B
Q3: pnp; BC557B
Q4: pnp; BC557B
Q6: npn; BC547B
Q7: npn; BC547B
Q8: npn; BC547B
Q9: npn; BC547B
Qtip32a: pnp
R1: res; 10k
R2: res; 10k
R3: res; 4k7
R4: res; 680
R5: res; 100
R6: res; 100
R7: res; 3k9
R8: res; 150
R9: res; 1k
R10: res; 22
R11: res; 100
R12: res; 10k
R13: res; 10k
R14: res; 100
R15: res; 3k9
RL: res; 1
RS1: res; 2.2
RS2: res; 1.8
U1: TL431
U2: opamp2; LM358
Vreg1: voltage; 9.5
Named nets: 0, Vref, Vreg, Vo, Vx, Vf
.include tip32a.lib
.lib opamp.sub
.inc lm358.lib
.include TL431.mod
Q5
.op
