Fjmoya-uba/Taller-de-Circuitos-Grupo-4/Checkpoint 3/Simulaciones/Rta_al_escalon_LC.asc

C2: cap; 330n
CL: cap; 1µ
Q1: npn; BC547B
Q2: pnp; BC557B
Q3: pnp; BC557B
Q4: npn; BC547B
Q5: npn; BC547B
Q6: npn; BC547B
Q7: npn; BC547B
Q8: npn; BC547B
Qtip1: pnp
R1: res; 10k
R2: res; 10k
R3: res; 4k7
R4: res; 10k
R5: res; 1.2k
R6: res; 150
R7: res; 3.9k
R8: res; 10k
R9: res; 22
R10: res; 3k9
R11: res; 100
R12: res; 100
R13: res; 100
R14: res; 100
R15: res; 1k
RL1: res; 1
RS1: res; 2.2
RS2: res; 1.8
U1: opamp2; LM358
V1: voltage; 2.5
V2: voltage; PULSE(0 100m 10u 1p 1p 400u 800u)
Vreg1: voltage; 9.5
Named nets: 0, Vref, Vreg, Vo, Vx, Vf
.include tip32a.lib
.lib opamp.sub
.inc lm358.lib
.include TL431.mod
Q5
.tran 0 1.5m 0 100n
