Fjmoya-uba/Taller-de-Circuitos-Grupo-4/Checkpoint 3/Simulaciones/Carga dinamica.asc

C2: cap; 330n
Q1: npn; BC547B
Q2: pnp; BC557B
Q3: pnp; BC557B
Q4: npn; BC547B
Q5: npn; BC547B
Q6: npn; BC547B
Q7: npn; BC547B
Q8: npn; BC547B
Qtip1: pnp
R1: res; 10k
R2: res; 10k
R3: res; 4k7
R4: res; 10k
R5: res; 1.2k
R6: res; 150
R7: res; 3.9k
R8: res; 10k
R9: res; 22
R10: res; 680
R11: res; 100
R12: res; 100
R13: res; 100
R14: res; 100
R15: res; 100
R16: res; 0.1
RS1: res; 2.2
RS2: res; 1.8
U1: opamp2; LM358
U2: TL431
Vreg1: voltage; 9.5
Named nets: 0, Vref, Vreg, Vo, Vx, Vf
.include tip32a.lib
.lib opamp.sub
.inc lm358.lib
.include TL431.mod
Q5
Cuando la fuente de corriente I1 pasa de sacar 1.5 A a sacar, 1 A, el lazo de corriente no se desactiva.
No está mal. Recordar cómo era la curva del Foldback.
.op
