Fjmoya-uba/Taller-de-Circuitos-Grupo-4/Checkpoint 2/Simulaciones Spice/Capa_variable(RL=3.3).asc

C1: cap; 1000
C2: cap; 330n
CL: cap; {CL}
L1: ind; 1000
Q1: npn; BC547B
Q2: npn; BC547B
Q3: pnp; BC557B
Q4: pnp; BC557B
Q6: npn; BC547B
Q7: npn; BC547B
Q8: npn; BC547B
Q9: npn; BC547B
Qtip32a: pnp
R1: res; 10k
R2: res; 10k
R3: res; 4k7
R4: res; 680
R5: res; 100
R6: res; 100
R7: res; 3.9k
R8: res; 150
R9: res; 1.2k
R10: res; 22
R11: res; 100
R12: res; 10k
R13: res; 10k
R14: res; 100
RL: res; 3.4
RS1: res; 1.8
RS: res; 2.2
U1: TL431
U2: opamp2; LM358
V1: voltage; ""; AC 1
Vreg1: voltage; 9.5
Named nets: 0, Vref, Vreg, Vo, Vx, Vf, A
.include tip32a.lib
.lib opamp.sub
.inc lm358.lib
.include TL431.mod
Q5
.ac dec 100 10 1G
.step param CL list 1u 15u
