Fjmoya-uba/Taller-de-Circuitos-Grupo-4/Checkpoint 2/Simulaciones Spice/Capa_variable(RL=50).asc

C1: cap; 1Meg
C2: cap; 330n
CL: cap; {CL}
L1: ind; 1Meg
Q1: npn; BC547B
Q2: npn; BC547B
Q3: pnp; BC557B
Q4: pnp; BC557B
Q6: npn; BC547B
Q7: npn; BC547B
Q8: npn; BC547B
Q9: npn; BC547B
Qtip32a: pnp
R1: res; 10k
R2: res; 10k
R3: res; 4k7
R4: res; 680
R5: res; 100
R6: res; 100
R7: res; 3.9k
R8: res; 150
R9: res; 1.2k
R10: res; 100
R11: res; 100
R12: res; 10k
R13: res; 10k
R14: res; 22
RL: res; 50
RS1: res; 2.2
RS2: res; 1.8
U1: TL431
U2: opamp2; LM358
V1: voltage; ""; AC 1
Vreg1: voltage; 9.5
Named nets: 0, Vref, Vreg, Vo, Vx, Vf, A
.include tip32a.lib
.lib opamp.sub
.inc lm358.lib
.include TL431.mod
.ac dec 100 1 1G
.step param CL list 1uF 15uF
Para CL = 1uF y RL  = 50, MF = 4° --> Hay que compensar.
Para CL = 15uF y RL  = 50, MF = 30° --> El anterior es peor caso
Concluisón: pero caso CL = 1uF, RL = 50.
AC 1
{CL}
