Fjmoya-uba/Taller-de-Circuitos-Grupo-4/Checkpoint 2/Simulaciones Spice/Lazo_de_corriente.asc

100: res; 10k
C1: cap; 1Meg
C2: cap; 330n
CL: cap; {CL}
I1: current; ""; AC 1
L1: ind; 1Meg
Q1: npn; BC547B
Q2: pnp; BC557B
Q3: pnp; BC557B
Q4: npn; BC547B
Q5: npn; BC547B
Q6: npn; BC547B
Q7: npn; BC547B
Q8: npn; BC547B
Qtip1: pnp
R1: res; 10k
R2: res; 10k
R3: res; 4k7
R5: res; 1.2k
R6: res; 150
R7: res; 3.9k
R8: res; 10k
R9: res; 22
R11: res; 100
R12: res; 100
R13: res; 100
R14: res; 100
R15: res; 680
RL1: res; 1
RS1: res; 1.8
RS2: res; 2.2
U1: opamp2; LM358
U2: TL431
Vreg1: voltage; 9.5
Named nets: 0, Vref, Vreg, Vo, Vx, Vf
.include tip32a.lib
.lib opamp.sub
.inc lm358.lib
.include TL431.mod
.ac dec 100 1 1G
Q1
Q2
Q3
Q4
Q5
.step param CL list 1u 15u
