Fjmoya-uba/Taller-de-Circuitos-Grupo-4/Checkpoint2/Simulaciones Spice/Draft1.asc

C2: cap; 1µ
Q1: npn; BC547B
Q2: pnp; BC557B
Q3: pnp; BC557B
Q4: npn; BC547B
Q5: npn; BC547B
Q6: npn; BC547B
Q7: npn; BC547B
Q8: npn; BC547B
Qtip1: pnp
R1: res; 10k
R2: res; 10k
R3: res; 4k7
R4: res; 10k
R5: res; 1.2k
R6: res; 150
R7: res; 3.9k
R8: res; 10k
R10: res; 0
R11: res; 0
R12: res; 0
RL1: res; 30
RS1: res; 1
U1: opamp2; LM358
V1: voltage; PULSE(0 1 0 1p 1p 1 2)
Vreg1: voltage; 9.5
X1: res; 0
Named nets: 0, Vref, Vreg, Vo, Vx, Vf
.include tip32a.lib
.lib opamp.sub
.inc lm358.lib
.include TL431.mod
Q5
.tran 2
