Fjmoya-uba/Taller-de-Circuitos-Grupo-4/Checkpoint 1/Simulaciones/draft-circuitos-Fran.asc

C1: cap; 1
L1: ind; 1
Q1: npn; BC848B
Q2: npn; BC848B
Q3: pnp; BC858B
Q4: pnp; BC858B
Q5: npn; BC848B
Q6: pnp; 2SAR542P
Q7: npn; BC848B
Q8: npn; BC848B
Q9: npn; BC848B
R1: res; 10k
R2: res; 10k
R3: res; 4k4
R4: res; 10k
R5: res; 10k
R9: res; 50k
R10: res; 50k
R12: res; 4k7
RE3: res; 0
RE4: res; 0
RE7: res; 0
RE8: res; 0
RL: res; {RL}
RS: res; 3
U1: OP07
U2: OP07
V1: voltage; SINE(0 1m 1k); AC 1
V2: voltage; 1
Vref: voltage; 2.5
Vreg: voltage; 9.5
Vripple: voltage; 0
Named nets: 0, Vref, Vreg, Vo
.op
.step param RL 0.01 10 0.1
