Fjmoya-uba/Taller-de-Circuitos-Grupo-4/Checkpoint 1/Simulaciones/Regulador_con_Foldback.asc

Q2: npn; BC848B
Q3: npn; BC848B
Q4: pnp; BC858B
Q5: pnp; BC858B
Q6: npn; BC848B
Q7: npn; BC848B
Q8: npn; BC848B
Q9: npn; BC848B
Qtip32a: pnp
R1: res; 10k
R2: res; 10k
R3: res; 4k4
R4: res; 5.1
R5: res; 8K2
R6: res; 5K1
R7: res; 5.1
RL: res; {RL}
Vref1: voltage; 2.5
Vreg1: voltage; 9.5
Named nets: 0, Vref, Vreg, Vo
.op
.tran 10m
.ac dec 10 1m 1meg
.step param RL 0.01 100 1
.include tip32a.lib
