Fjmoya-uba/Taller-de-Circuitos-Grupo-4/Checkpoint 1/Simulaciones/Mediciones TP/Ganancia de Lazo.asc

C1: cap; 100
L1: ind; 100
Q1: npn; BC547B
Q2: npn; BC547B
Q3: pnp; BC557B
Q4: pnp; BC557B
Q5: npn; BC547B
Q6: npn; BC547B
Q7: npn; BC547B
Q8: npn; BC547B
Qtip32a: pnp
R1: res; 10k
R2: res; 10k
R3: res; 4k7
R4: res; 680
R5: res; {RL}
Rf: res; 10k
Ro: res; 150
Rref1: res; 1.2k
RS: res; 1
Rx1: res; 3.9k
Rx2: res; 10k
U1: TL431
U2: opamp2; LM358
V1: voltage; ""; AC 1
Vreg1: voltage; 9.5
Named nets: 0, Vref, Vreg, Vo, Vx, Vf, A
.include tip32a.lib
.lib opamp.sub
.inc lm358.lib
.include TL431.mod
.ac dec 10 10 10Meg
.param RL=50
