Fjmoya-uba/Taller-de-Circuitos-Grupo-4/(list of files, drawings)

Other design files:
carga activa tab vertical/carga_activa/freerouting.dsn
carga activa tab vertical/carga_activa/temp-freerouting.dsn
Checkpoint 4/Simulaciones/lm393.opj
