Fjmoya-uba/Taller-de-Circuitos-Grupo-4/Checkpoint 4/PCB/Buck_lazo_abierto_v1/Buck_lazo_abierto_v1.kicad_pcb

## KiCad design Checkpoint 4/PCB/Buck_lazo_abierto_v1/Buck_lazo_abierto_v1.kicad_pcb (2026-06-01)

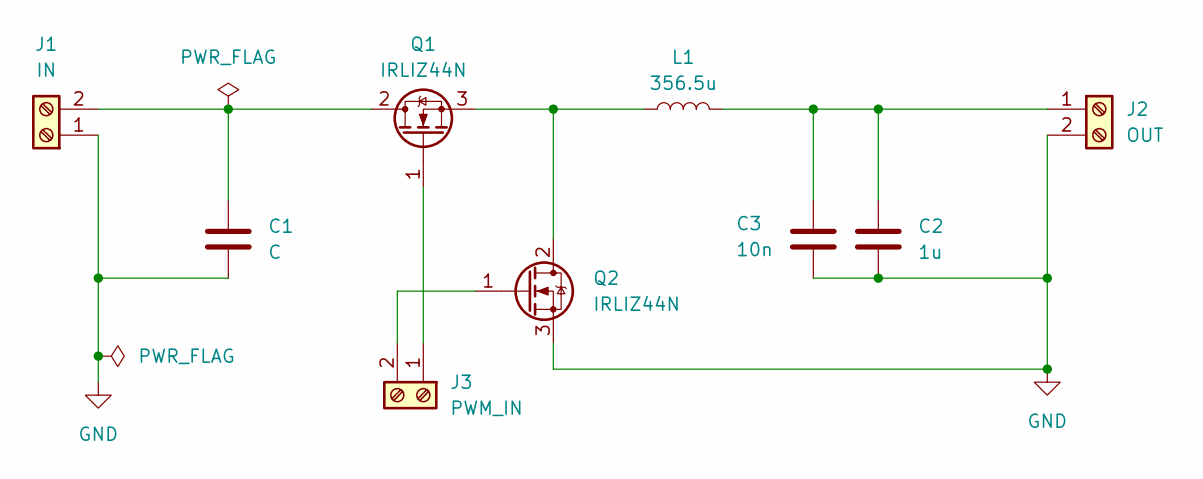
[picture p215: schematic Buck_lazo_abierto_v1.kicad_sch]

Parts:
C1: C; C_Radial_D12.5mm_H20.0mm_P5.00mm
C2: 1u; C_Radial_D12.5mm_H20.0mm_P5.00mm
C3: 10n; C_Disc_D10.0mm_W2.5mm_P5.00mm
J1: IN; TerminalBlock_MaiXu_MX126-5.0-02P_1x02_P5.00mm
J2: OUT; TerminalBlock_MaiXu_MX126-5.0-02P_1x02_P5.00mm
J3: PWM_IN; TerminalBlock_MaiXu_MX126-5.0-02P_1x02_P5.00mm
L1: 356.5u; L_Toroid_Vertical_L46.0mm_W19.1mm_P21.80mm_Bourns_5700
Q1, Q2: IRLIZ44N; TO-220F-3_Vertical

Connections:
GND: C1.2, C2.2, C3.2, J1.1, J2.2, Q2.3 (S)
unnamed: C1.1, J1.2, Q1.2 (D)
unnamed: C2.1, C3.1, J2.1, L1.2
unnamed: J3.1, Q1.1 (G)
unnamed: J3.2, Q2.1 (G)
unnamed: L1.1, Q1.3 (S), Q2.2 (D)

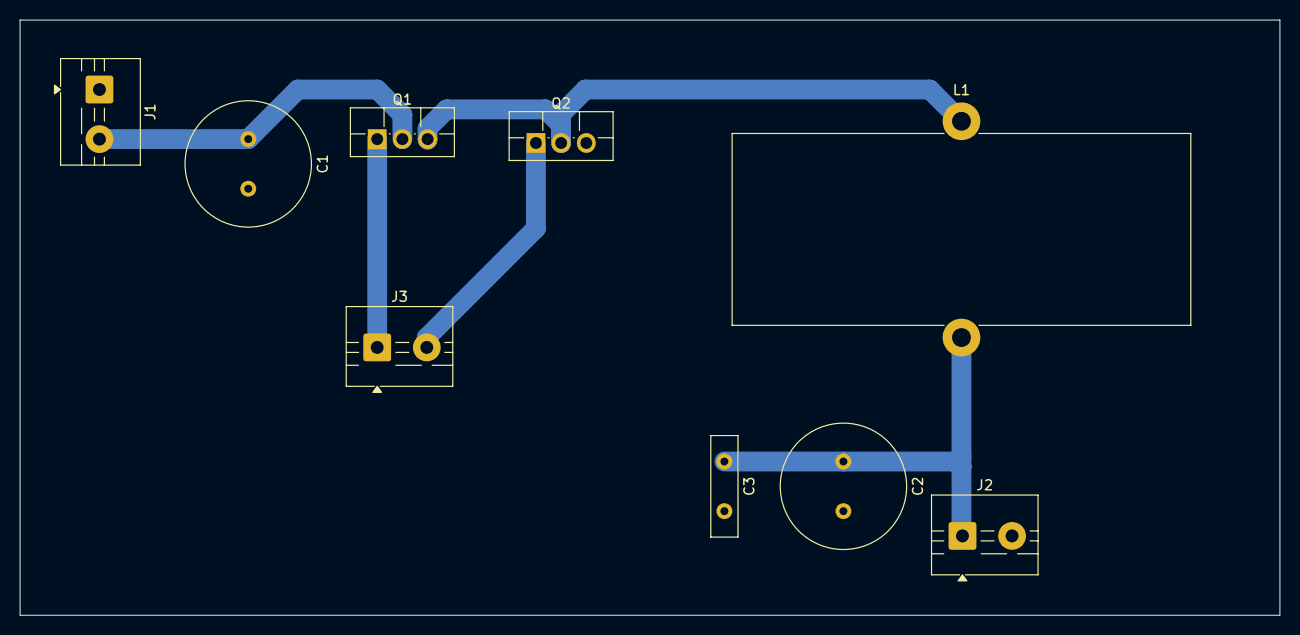
[picture p216: board Buck_lazo_abierto_v1.kicad_pcb from above]

Board: 2 copper layers, 127.0 x 60.0 mm, 9 parts (0 on the bottom side), 6 nets.
