Fjmoya-uba/Taller-de-Circuitos-Grupo-4/Checkpoint 4/PCB/PWM_v1/PWM_v1.kicad_pcb

## KiCad design Checkpoint 4/PCB/PWM_v1/PWM_v1.kicad_pcb (2026-05-29)

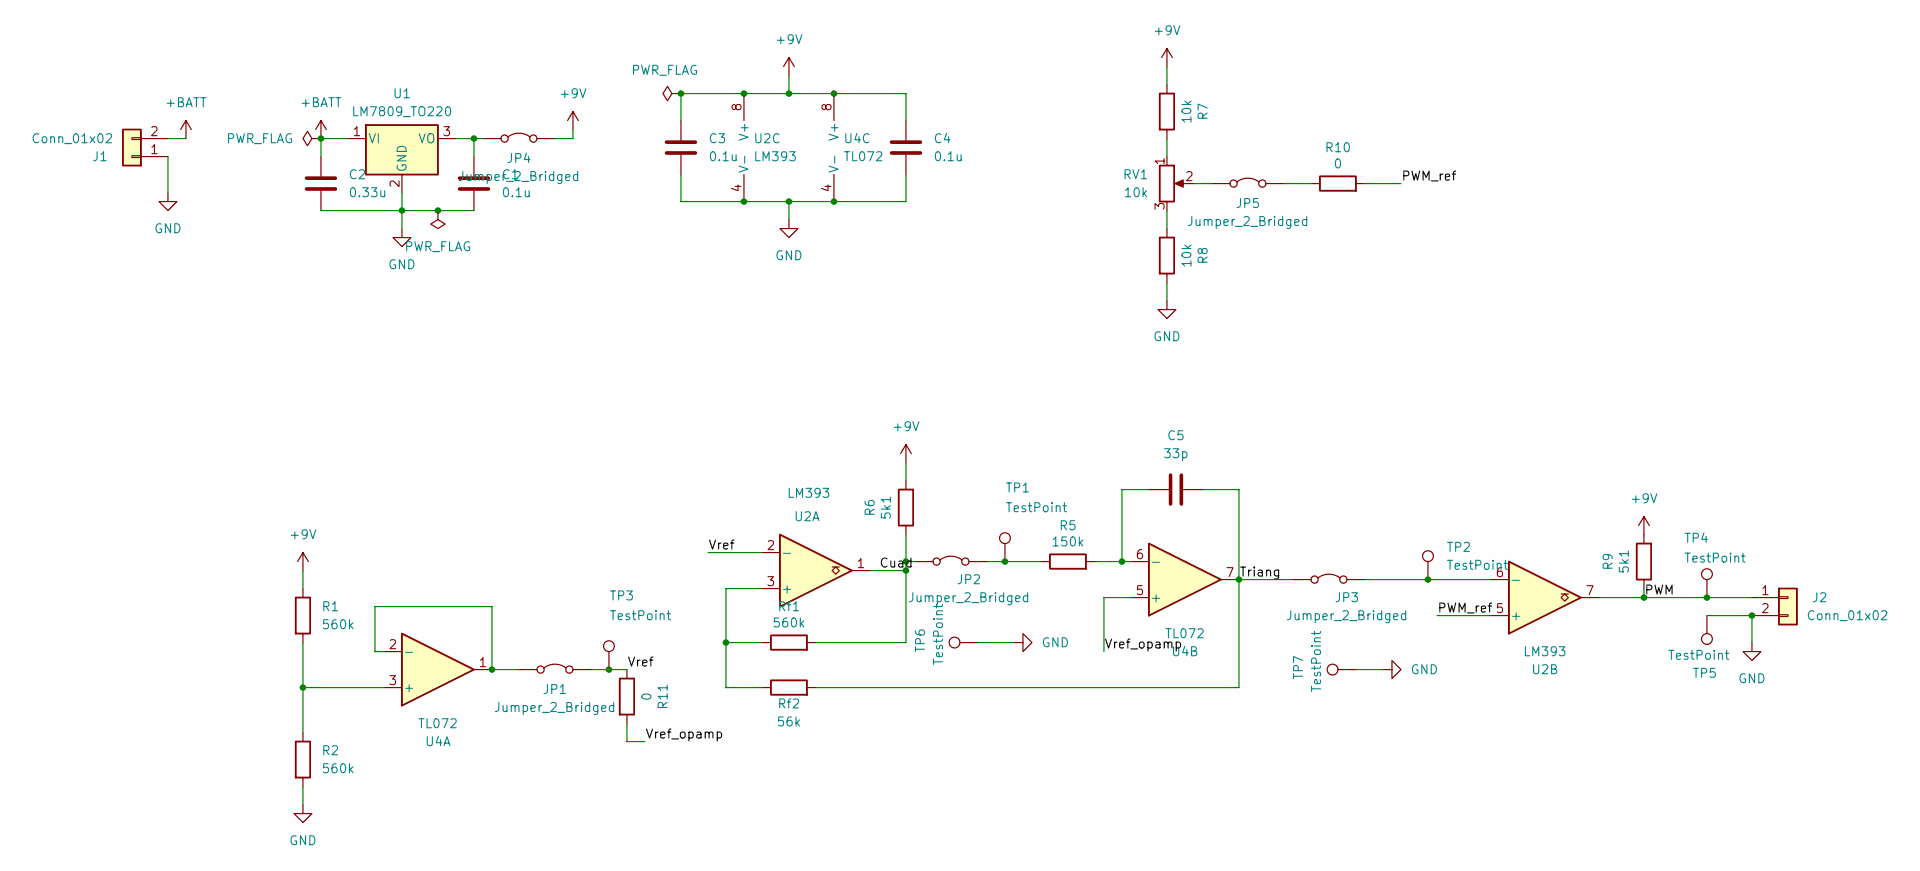
[picture p217: schematic PWM_v1.kicad_sch, PWM]

Parts:
C1, C3, C4: 0.1u; C_Disc_D5.0mm_W2.5mm_P2.50mm
C2: 0.33u; C_Disc_D5.0mm_W2.5mm_P2.50mm
C5: 33p; C_Disc_D5.0mm_W2.5mm_P2.50mm
J1, J2: Conn_01x02; TerminalBlock_MaiXu_MX126-5.0-02P_1x02_P5.00mm
JP1, JP2, JP3, JP4, JP5: Jumper_2_Bridged; PinHeader_1x02_P2.54mm_Vertical
R1, R2: 560k; R_Axial_DIN0207_L6.3mm_D2.5mm_P7.62mm_Horizontal
R5: 150k; R_Axial_DIN0207_L6.3mm_D2.5mm_P7.62mm_Horizontal
R6, R9: 5k1; R_Axial_DIN0207_L6.3mm_D2.5mm_P7.62mm_Horizontal
R7, R8: 10k; R_Axial_DIN0207_L6.3mm_D2.5mm_P7.62mm_Horizontal
R10, R11: 0; R_Axial_DIN0207_L6.3mm_D2.5mm_P7.62mm_Horizontal
RV1: 10k; Potentiometer_Piher_PC-16_Single_Horizontal
Rf1: 560k; R_Axial_DIN0207_L6.3mm_D2.5mm_P7.62mm_Horizontal
Rf2: 56k; R_Axial_DIN0207_L6.3mm_D2.5mm_P7.62mm_Horizontal
TP1, TP2, TP3: TestPoint
TP4, TP5, TP6, TP7: TestPoint; PinHeader_1x01_P2.54mm_Vertical
U1: LM7809_TO220; TO-220-3_Vertical
U2: LM393; DIP-8_W7.62mm_Socket_LongPads
U4: TL072; DIP-8_W7.62mm_Socket_LongPads

Connections:
+9V: C3.1, C4.1, JP4.2 (B), R1.1, R6.2, R7.1, R9.2, U2.8 (V+), U4.8 (V+)
+BATT: C2.1, J1.2, U1.1 (VI)
/Cuad: JP2.1 (A), R6.1, Rf1.2, U2.1
/PWM: J2.1, R9.1, TP4.1 (1_1), U2.7
/PWM_ref: R10.2, U2.5 (+)
/Triang: C5.1, JP3.1 (A), Rf2.2, U4.7
/Vref: JP1.2 (B), R11.1, TP3.1, U2.2 (-)
/Vref_opamp: R11.2, U4.5 (+)
GND: C1.2, C2.2, C3.2, C4.2, J1.1, J2.2, R2.2, R8.2, TP5.1 (1_1), TP6.1 (1_1), TP7.1 (1_1), U1.2 (GND), U2.4 (V-), U4.4 (V-)
unnamed: JP1.1 (A), U4.1, U4.2 (-)
unnamed: JP2.2 (B), R5.1, TP1.1
unnamed: JP3.2 (B), TP2.1, U2.6 (-)
unnamed: C1.1, JP4.1 (A), U1.3 (VO)
unnamed: JP5.1 (A), RV1.2
unnamed: JP5.2 (B), R10.1
unnamed: R7.2, RV1.1
unnamed: R8.1, RV1.3
unnamed: Rf1.1, Rf2.1, U2.3 (+)
unnamed: R1.2, R2.1, U4.3 (+)
unnamed: C5.2, R5.2, U4.6 (-)

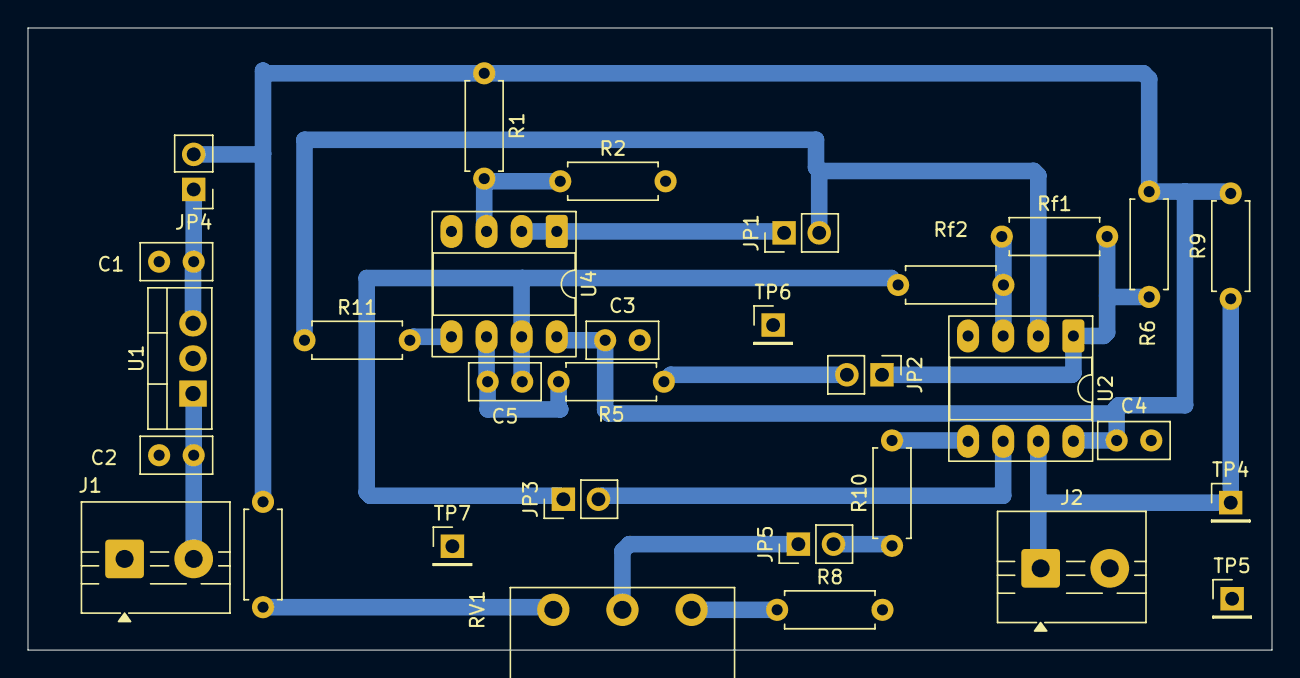
[picture p218: board PWM_v1.kicad_pcb from above]

Board: 2 copper layers, 90.0 x 45.0 mm, 31 parts (0 on the bottom side), 20 nets.
