Fjmoya-uba/Taller-de-Circuitos-Grupo-4/Checkpoint 3/KiCad/Diseño_v4/Diseño_v4.kicad_pcb

## KiCad design Checkpoint 3/KiCad/Diseño_v4/Diseño_v4.kicad_pcb (2026-05-11)

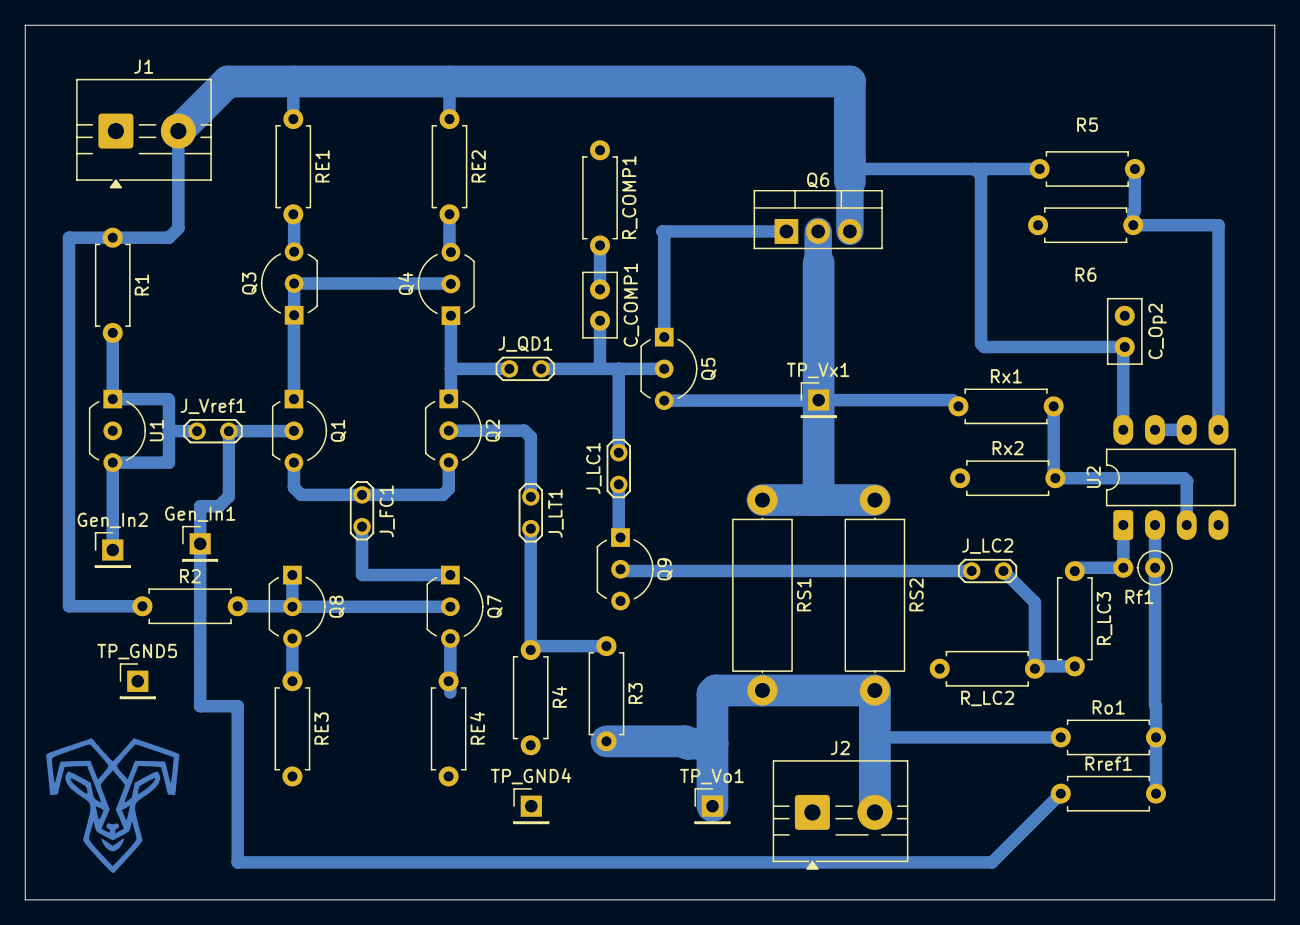
[picture p219: board Diseño_v4.kicad_pcb from above]

Board: 2 copper layers, 100.0 x 70.0 mm, 47 parts (0 on the bottom side), 28 nets.

Parts:
C_COMP1: 330n; C_Disc_D5.0mm_W2.5mm_P2.50mm
C_Op2: 0.1u; C_Disc_D5.0mm_W2.5mm_P2.50mm
Gen_In1, Gen_In2: PinHeader_1x01_P2.54mm_Vertical
J1, J2: Conn_01x02; TerminalBlock_MaiXu_MX126-5.0-02P_1x02_P5.00mm
J_FC1: TestPoint_2Pads_Pitch2.54mm_Drill0.8mm
J_LC1, J_LC2: TestPoint_2Pads_Pitch2.54mm_Drill0.8mm
J_LT1: TestPoint_2Pads_Pitch2.54mm_Drill0.8mm
J_QD1: TestPoint_2Pads_Pitch2.54mm_Drill0.8mm
J_Vref1: TestPoint_2Pads_Pitch2.54mm_Drill0.8mm
Q1: BC547; TO-92L_Inline_Wide
Q2, Q5, Q7, Q8, Q9: BC547; TO-92_Inline_Wide
Q3, Q4: BC557; TO-92_Inline_Wide
Q6: TIP32A; TO-220-3_Vertical
R1: 680; R_Axial_DIN0207_L6.3mm_D2.5mm_P7.62mm_Horizontal
R2: 4k7; R_Axial_DIN0207_L6.3mm_D2.5mm_P7.62mm_Horizontal
R3, R4: 10k; R_Axial_DIN0207_L6.3mm_D2.5mm_P7.62mm_Horizontal
R5, R6: 1Meg; R_Axial_DIN0207_L6.3mm_D2.5mm_P7.62mm_Horizontal
RE1, RE2, RE3, RE4: 100; R_Axial_DIN0207_L6.3mm_D2.5mm_P7.62mm_Horizontal
RS1: 1.8; R_Axial_DIN0414_L11.9mm_D4.5mm_P15.24mm_Horizontal
RS2: 2.2; R_Axial_DIN0414_L11.9mm_D4.5mm_P15.24mm_Horizontal
R_COMP1: 22; R_Axial_DIN0207_L6.3mm_D2.5mm_P7.62mm_Horizontal
R_LC2: 1k; R_Axial_DIN0207_L6.3mm_D2.5mm_P7.62mm_Horizontal
R_LC3: 3k9; R_Axial_DIN0207_L6.3mm_D2.5mm_P7.62mm_Horizontal
Rf1: 10k; R_Axial_DIN0207_L6.3mm_D2.5mm_P2.54mm_Vertical
Ro1: 150; R_Axial_DIN0207_L6.3mm_D2.5mm_P7.62mm_Horizontal
Rref1: 1k2; R_Axial_DIN0207_L6.3mm_D2.5mm_P7.62mm_Horizontal
Rx1: 3k9; R_Axial_DIN0207_L6.3mm_D2.5mm_P7.62mm_Horizontal
Rx2: 10k; R_Axial_DIN0207_L6.3mm_D2.5mm_P7.62mm_Horizontal
TP_GND4, TP_GND5: PinHeader_1x01_P2.54mm_Vertical
TP_Vo1: PinHeader_1x01_P2.54mm_Vertical
TP_Vx1: PinHeader_1x01_P2.54mm_Vertical
U1: TL431LP; TO-92_Inline_Wide
U2: LM358; DIP-8_W7.62mm_LongPads

Connections:
/Vf: J_LC2.1 (A), Q9.2 (B)
/Vo: J2.2, R3.2, RS1.2, RS2.2, Ro1.1, TP_Vo1.1 (1_1)
/Vref: Gen_In1.1 (1_1), J_Vref1.2 (B), Q1.2 (B), Rref1.1
/Vreg: C_Op2.2, J1.2, Q6.3 (E), R1.1, R2.1, R5.2, RE1.1, RE2.1, U2.8 (V+)
/Vx: Q5.3 (E), Q6.2 (C), RS1.1, RS2.1, Rx1.1, TP_Vx1.1 (1_1)
GND: C_Op2.1, J1.1, J2.1, Q9.3 (E), R4.2, R6.1, RE3.2, RE4.2, R_COMP1.1, R_LC2.2, Rx2.1, TP_GND4.1 (1_1), TP_GND5.1 (1_1), U1.2 (A), U2.4 (V-)
unnamed: C_COMP1.1, R_COMP1.2
unnamed: J_FC1.1 (A), Q1.3 (E), Q2.3 (E)
unnamed: J_FC1.2 (B), Q7.1 (C)
unnamed: J_LC1.1 (A), Q9.1 (C)
unnamed: C_COMP1.2, J_LC1.2 (B), J_QD1.2 (B), Q5.2 (B)
unnamed: J_LC2.2 (B), R_LC2.1, R_LC3.2
unnamed: J_LT1.1 (A), Q2.2 (B)
unnamed: J_LT1.2 (B), R3.1, R4.1
unnamed: J_QD1.1 (A), Q2.1 (C), Q4.1 (C)
unnamed: Gen_In2.1 (1_1), J_Vref1.1 (A), R1.2, U1.1 (REF), U1.3 (K)
unnamed: Q1.1 (C), Q3.1 (C), Q3.2 (B), Q4.2 (B)
unnamed: Q3.3 (E), RE1.2
unnamed: Q4.3 (E), RE2.2
unnamed: Q5.1 (C), Q6.1 (B)
unnamed: Q7.2 (B), Q8.1 (C), Q8.2 (B), R2.2
unnamed: Q7.3 (E), RE4.1
unnamed: Q8.3 (E), RE3.1
unnamed: R_LC3.1, Rf1.2, U2.1
unnamed: Rx1.2, Rx2.2, U2.3 (+)
unnamed: Rf1.1, Ro1.2, Rref1.2, U2.2 (-)
unnamed: R5.1, R6.2, U2.5 (+)
unnamed: U2.6 (-), U2.7
