Fjmoya-uba/Taller-de-Circuitos-Grupo-4/carga activa tab vertical/carga_activa/carga_activa.kicad_pcb

## KiCad design carga activa tab vertical/carga_activa/carga_activa.kicad_pcb (2026-05-08)

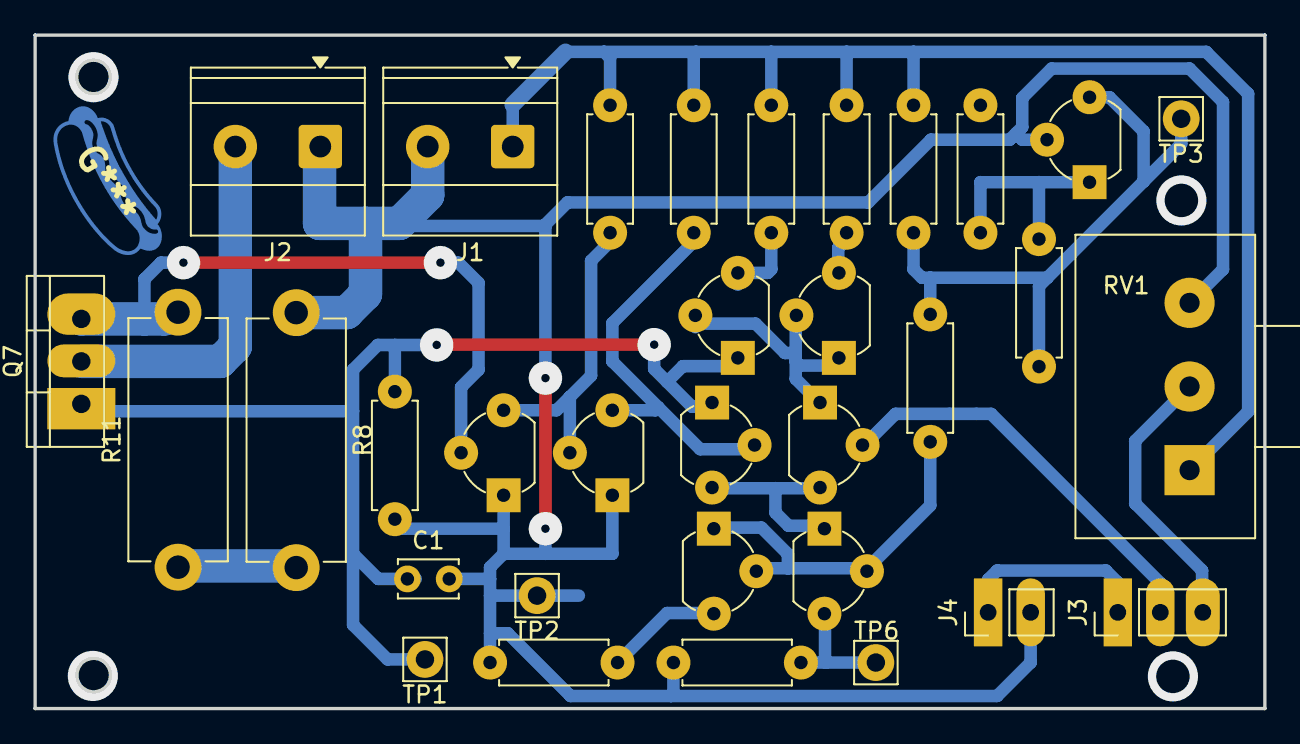
[picture p220: board carga_activa.kicad_pcb from above]

Board: 2 copper layers, 73.5 x 40.2 mm, 33 parts (0 on the bottom side), 20 nets.

Parts:
C1: 100n; C_Disc_D3.4mm_W2.1mm_P2.50mm
J1, J2: Screw_Terminal_01x02; TerminalBlock_Phoenix_MKDS-1,5-2-5.08_1x02_P5.08mm_Horizont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
J3: Conn_01x03_Pin; PinHeader_1x03_P2.54mm_Vertical
J4: Conn_01x02_Pin; PinHeader_1x02_P2.54mm_Vertical
Q1, Q2, Q4, Q6: BC547; Custom_TO-92_Wide
Q3, Q5, Q8, Q9: BC557; Custom_TO-92_Wide
Q7: IRFZ46; TO-220-3_Vertical
R1, R3: 2k; Custom _pads_R_Axial_DIN0207_L6.3mm_D2.5mm_P7.62mm_Horizont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
R2, R4: 1k; Custom _pads_R_Axial_DIN0207_L6.3mm_D2.5mm_P7.62mm_Horizont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
R5, R7: 100; Custom _pads_R_Axial_DIN0207_L6.3mm_D2.5mm_P7.62mm_Horizont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
R6: 470; Custom _pads_R_Axial_DIN0207_L6.3mm_D2.5mm_P7.62mm_Horizont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
R8, R11: 1; R_Axial_DIN0614_L14.3mm_D5.7mm_P15.24mm_Horizontal
R10: 5k6; Custom _pads_R_Axial_DIN0207_L6.3mm_D2.5mm_P7.62mm_Horizont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
R12: 6k2; Custom _pads_R_Axial_DIN0207_L6.3mm_D2.5mm_P7.62mm_Horizont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
R14: DNP; Custom _pads_R_Axial_DIN0207_L6.3mm_D2.5mm_P7.62mm_Horizont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
R15: 1M; Custom _pads_R_Axial_DIN0207_L6.3mm_D2.5mm_P7.62mm_Horizont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
RV1: 2k; Potentiometer_Alps_RK163_Single_Horizontal
TP1, TP2, TP3, TP6: TestPoint; Pin_D1.1mm_L8.5mm_W2.5mm_FlatFork
U1: TL431LP; Custom_TO-92_Wide

Connections:
/Amp_in: Q6.2 (B), Q9.3 (E), R10.1
/Amp_out: C1.1, Q5.1 (C), Q6.1 (C), Q7.1 (G), R15.1, TP1.1
/V_in: J1.1, R2.2, R5.2, R7.2, R10.2, R12.2, RV1.1
/V_ref: R1.2, R2.1, R3.2, TP3.1, U1.3 (K)
/load_in: J2.2, Q7.2 (D)
/pot_out: J3.2, Q2.2 (B)
/sense_out: Q7.3 (S), Q8.2 (B), R11.2
GND: C1.2, J1.2, J2.1, J4.2, Q8.1 (C), Q9.1 (C), R4.1, R6.1, R8.1, R14.1, R15.2, RV1.3, TP2.1, U1.2 (A)
unnamed: J3.1, J4.1
unnamed: J3.3, RV1.2
unnamed: Q1.1 (C), Q1.2 (B), Q4.2 (B), R3.1
unnamed: Q1.3 (E), R4.2
unnamed: Q2.1 (C), Q3.1 (C), Q3.2 (B), Q5.2 (B)
unnamed: Q2.3 (E), Q4.1 (C), Q6.3 (E)
unnamed: Q3.3 (E), R5.1
unnamed: Q4.3 (E), R6.2, TP6.1
unnamed: Q5.3 (E), R7.1
unnamed: Q8.3 (E), Q9.2 (B), R12.1
unnamed: R8.2, R11.1
unnamed: R1.1, R14.2, U1.1 (REF)
