Fjmoya-uba/Taller-de-Circuitos-Grupo-4/CheckPoint1/KiCAD/probando/probando.kicad_sch

## KiCad design CheckPoint1/KiCAD/probando/probando.kicad_sch (2026-04-08)

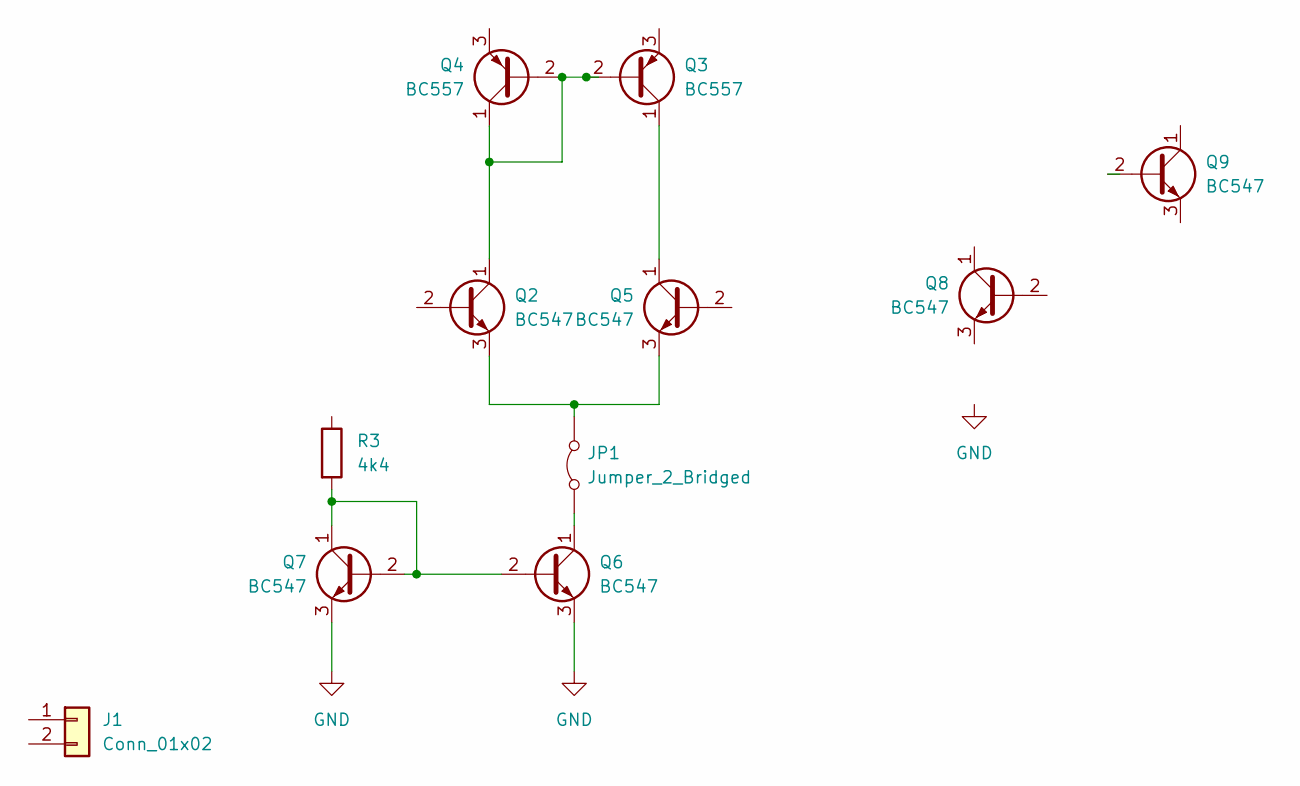
[picture p221: schematic probando.kicad_sch]

Parts:
J1: Conn_01x02; Samtec_HPM-02-01-x-S_Straight_1x02_Pitch5.08mm
JP1: Jumper_2_Bridged
Q2, Q5, Q6, Q7, Q8, Q9: BC547; TO-92_Inline
Q3, Q4: BC557; TO-92_Inline
R3: 4k4

Connections:
GND: Q6.3 (E), Q7.3 (E)
unnamed: JP1.1 (A), Q6.1 (C)
unnamed: JP1.2 (B), Q2.3 (E), Q5.3 (E)
unnamed: Q2.1 (C), Q3.2 (B), Q4.1 (C), Q4.2 (B)
unnamed: Q3.1 (C), Q5.1 (C)
unnamed: Q6.2 (B), Q7.1 (C), Q7.2 (B), R3.2
