Fjmoya-uba/Taller-de-Circuitos-Grupo-4/(commit log)

2026-03-28 re-ordenando el repo
2026-04-04 buscando el foldback
2026-04-08 kicad 1
    [probando.kicad_sch]
2026-04-09 reza malena
    [esquematico.kicad_pcb, esquematico.kicad_sch]
2026-04-10 new changes
    [esquematico.kicad_sch]
2026-04-17 No te voy a mentir, no sé muy bien lo que hice
2026-04-18 con 40n compensa este hijo de puta
    [Diseño.kicad_pcb, Diseño_v2.kicad_pcb, Diseño_v2.kicad_sch]
2026-04-20 PCB LDO (final?)
    [Diseño_v2.kicad_pcb, Diseño_v2.kicad_sch]
2026-04-20 agregué el capacitor de compensación
    [Diseño_v2.kicad_pcb, Diseño_v2.kicad_sch]
2026-04-21 Cambié las huellas de los TBJ xq estaban muy juntas
    [Diseño_v2.kicad_pcb, Diseño_v2.kicad_sch]
2026-04-22 archivos geber
    [Diseño_v2-B_Cu.gbr, Diseño_v2-B_Mask.gbr, Diseño_v2-B_Paste.gbr, Diseño_v2-B_Silkscreen.gbr, Diseño_v2-Edge_Cuts.gbr, Diseño_v2-F_Cu.gbr, Diseño_v2-F_Mask.gbr, Diseño_v2-F_Paste.gbr]
2026-04-22 Intenté arreglar el lazo de corriente. Fracasé
2026-04-22 pequeño cambio
    [Diseño.kicad_pcb, Diseño.kicad_sch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]
2026-04-23 Corregí el lazo de corriente.
2026-04-23 Corregí el esquemático y generé los archivos de fabricación
    [Diseño_v2-B_Cu.gbr, Diseño_v2-B_Mask.gbr, Diseño_v2-B_Paste.gbr, Diseño_v2-B_Silkscreen.gbr, Diseño_v2-Edge_Cuts.gbr, Diseño_v2-F_Cu.gbr, Diseño_v2-F_Mask.gbr, Diseño_v2-F_Paste.gbr]
2026-04-23 gráficos. Ahora es inestable el lazo de corriente
2026-04-24 Actualicé el PCB
    [Diseño_v2.kicad_pcb, Diseño_v2.kicad_sch]
2026-04-24 archivos gerber
    [Diseño_v2-B_Cu.gbr, Diseño_v2-B_Mask.gbr, Diseño_v2-B_Paste.gbr, Diseño_v2-B_Silkscreen.gbr, Diseño_v2-Edge_Cuts.gbr, Diseño_v2-F_Cu.gbr, Diseño_v2-F_Mask.gbr, Diseño_v2-F_Paste.gbr]
2026-04-25 lista de materiales
    [lista-materiales.csv]
2026-04-26 Corrección PCB
    [Diseño_v3-B_Cu.gbr, Diseño_v3-B_Mask.gbr, Diseño_v3-B_Paste.gbr, Diseño_v3-B_Silkscreen.gbr, Diseño_v3-Edge_Cuts.gbr, Diseño_v3-F_Cu.gbr, Diseño_v3-F_Mask.gbr, Diseño_v3-F_Paste.gbr]
2026-04-26 últimos retoques al PCB
    [Diseño_v3.kicad_pcb]
2026-04-27 Archivos .gbr
    [Diseño_v3-B_Cu.gbr, Diseño_v3-B_Mask.gbr, Diseño_v3-B_Paste.gbr, Diseño_v3-B_Silkscreen.gbr, Diseño_v3-Edge_Cuts.gbr, Diseño_v3-F_Cu.gbr, Diseño_v3-F_Mask.gbr, Diseño_v3-F_Paste.gbr]
2026-05-02 checkpoint 3
    [Diseño_v3-B_Cu.gbr, Diseño_v3-B_Mask.gbr, Diseño_v3-B_Paste.gbr, Diseño_v3-B_Silkscreen.gbr, Diseño_v3-Edge_Cuts.gbr, Diseño_v3-F_Cu.gbr, Diseño_v3-F_Mask.gbr, Diseño_v3-F_Paste.gbr]
2026-05-05 una simulación y pcb
    [Diseño_v3.kicad_pcb]
2026-05-05 Simulación de la regulación de carga dinámica
2026-05-06 Probé un par de cosas sin mucho éxito
2026-05-06 Arreglando la placa
    [Diseño_v3.kicad_pcb, Diseño_v3.kicad_sch]
2026-05-08 Carga electrónica
    [carga_activa.csv, carga_activa.kicad_pcb, carga_activa.kicad_sch, freerouting.dsn, temp-freerouting.dsn]
2026-05-08 gráfico regulación de linea
    [RegLin_medida.csv]
2026-05-08 agregué la hoja de datos del nmos (IRFZ46N)
2026-05-08 cambios del pcb
    [Diseño_v4-B_Cu.gbr, Diseño_v4-B_Mask.gbr, Diseño_v4-B_Paste.gbr, Diseño_v4-B_Silkscreen.gbr, Diseño_v4-Edge_Cuts.gbr, Diseño_v4-F_Cu.gbr, Diseño_v4-F_Mask.gbr, Diseño_v4-F_Paste.gbr]
2026-05-08 quince commits en el mismo día
2026-05-09 Salió todo sobre la hora
2026-05-09 Imágenes varias - Modif. script Python
    [RegLin_medida.csv]
2026-05-10 Agrego Informe y Modif. Datasheets
    [RegLin_medida.csv]
2026-05-11 agregué la cabrita al pcb
    [Diseño_v4-B_Cu.gbr, Diseño_v4-B_Mask.gbr, Diseño_v4-B_Paste.gbr, Diseño_v4-B_Silkscreen.gbr, Diseño_v4-Edge_Cuts.gbr, Diseño_v4-F_Cu.gbr, Diseño_v4-F_Mask.gbr, Diseño_v4-F_Paste.gbr]
2026-05-25 Buck-converter funcionando en ltspice
2026-05-25 Hojas de datos
    [lm393.opj]
2026-05-25 Update in this schematics
2026-05-26 PCB PWM
    [PWM_v1.kicad_pcb, PWM_v1.kicad_sch]
2026-05-26 Cambié el TL062 por el TL072
    [PWM_v1-B_Cu.gbr, PWM_v1-B_Mask.gbr, PWM_v1-B_Paste.gbr, PWM_v1-B_Silkscreen.gbr, PWM_v1-Edge_Cuts.gbr, PWM_v1-F_Cu.gbr, PWM_v1-F_Mask.gbr, PWM_v1-F_Paste.gbr]
2026-05-29 cambié un poco la simulación
    [PWM_v1.kicad_pcb, PWM_v1.kicad_sch]
2026-05-31 simulación pwm
2026-06-01 pcb buck
    [Buck_lazo_abierto_v1.kicad_pcb, Buck_lazo_abierto_v1.kicad_sch]
